Hrishikesh-Acharyya/Synchronous_buck_PMIC/tb/telemetry/host_if/coverage/summary.txt

cov_all: full suite + 5 random runs x 30 events - Tue Nov 10 11:58:13 UTC 2026
result: every test passed (cov_all stops at the first failure)
covers hit per checker:
  reg_file_sva: 28 of 28 covers hit, 0 at zero
  spi_slave_sva: 28 of 28 covers hit, 0 at zero
zero-hit covers:
  no zero-hit covers
functional coverage (covergroups):
  host_if.threshold.reason                   4 of 5   bins hit
  host_if.threshold.state                    4 of 4   bins hit
  host_if.threshold.reason_x_state           9 of 18  bins hit
  host_if.frame.ending                       8 of 9   bins hit
  host_if.clamp.register                     7 of 7   bins hit
  host_if.clamp.region                       5 of 5   bins hit
  host_if.clamp.register_x_region           28 of 35  bins hit
empty bins:
  host_if.threshold.reason: not_off
  host_if.threshold.reason_x_state: ('accepted', 2)
  host_if.threshold.reason_x_state: ('accepted', 3)
  host_if.threshold.reason_x_state: ('writeback', 1)
  host_if.threshold.reason_x_state: ('writeback', 2)
  host_if.threshold.reason_x_state: ('no_key', 3)
  host_if.threshold.reason_x_state: ('partial', 3)
  host_if.threshold.reason_x_state: ('not_off', 1)
  host_if.threshold.reason_x_state: ('not_off', 2)
  host_if.threshold.reason_x_state: ('not_off', 3)
  host_if.frame.ending: read_stall
  host_if.clamp.register_x_region: ('max_on_limit', 'below')
  host_if.clamp.register_x_region: ('max_on_limit', 'inside')
  host_if.clamp.register_x_region: ('hiccup_base', 'below')
  host_if.clamp.register_x_region: ('cycles_per_step', 'at_min')
  host_if.clamp.register_x_region: ('cycles_per_step', 'above')
  host_if.clamp.register_x_region: ('clean_run_target', 'below')
  host_if.clamp.register_x_region: ('clean_run_target', 'above')
