Hrishikesh-Acharyya/Synchronous_buck_PMIC/tb/telemetry/host_if/soak/summary.txt

  reg_file_sva: 26 of 28 covers hit, 2 at zero
  spi_slave_sva: 28 of 28 covers hit, 0 at zero
zero-hit covers:
  host_if_wrapper.u_reg_file.u_sva.c_arm_lapse  (reg_file_sva.sv:613)
  host_if_wrapper.u_reg_file.u_sva.c_bus_err_saturated  (reg_file_sva.sv:810)
functional coverage (covergroups):
  host_if.threshold.reason                   5 of 5   bins hit
  host_if.threshold.state                    4 of 4   bins hit
  host_if.threshold.reason_x_state          18 of 18  bins hit
  host_if.frame.ending                       9 of 9   bins hit
  host_if.clamp.register                     7 of 7   bins hit
  host_if.clamp.region                       5 of 5   bins hit
  host_if.clamp.register_x_region           35 of 35  bins hit
empty bins:
  no empty bins
