Hrishikesh-Acharyya/Synchronous_buck_PMIC/docs/silicluster_area.md

# Silicluster v3 area log

Append-only. One row per synthesis run that follows an RTL change. Never edit
an old row; the trend is the useful part.

## Method

- Input: `Build/pmic_full.v`, the sv2v output of `rtl/`, top `pmic_top`.
- Flops and mapped combinational cells: `make syn_area` (yosys `synth -flatten`,
  `dfflibmap` + `abc` against `sky130_fd_sc_hd__tt_025C_1v80.lib`), counted
  from the mapped `stat -liberty` table. "Comb cells" is every mapped sky130
  cell that is not a flop.
- **Cell area** is the yosys `Chip area` figure: the sum of standard-cell
  footprints. It is NOT die area.
- **Die area** = cell area / 0.57, a utilisation assumption of 57% carried over
  from the earlier estimate on `main`. Real P&R utilisation will differ.
- **Slot ratio** = die area / 20,700 um^2. The standard digital slot is
  180 um x 115 um = 20,700 um^2 (Silicluster v3 call, section 7).
- Tool: Yosys 0.70 (YoWASP build) unless stated. Yosys 0.33 (Ubuntu 24.04
  package, the version CI installs) was cross-checked on the baseline and gives
  the same 730 flops, 2,336 comb cells, 32,492 um^2.

## Runs

| Date (UTC) | Commit / changelog entry | Clock  | TELEMETRY_EN | Flops | Comb cells | Cell area (um^2) | Die @57% (um^2) | Ratio vs slot | Note |
|---|---|---|---|---|---|---|---|---|---|
| 2026-10-31 17:10 | a70e4a9 (main) | 50 MHz | (n/a, =1) | 730 | 2,281 | 32,369 | 56,787 | 2.74x | baseline, `main` as received |
| 2026-10-31 17:17 | chg 3: CLK_HZ 10 MHz | 10 MHz | (n/a, =1) | 700 | 2,137 | 30,821 | 54,072 | 2.61x | -30 flops from narrowed counters, as derived |
| 2026-10-31 17:19 | chg 5: ns_to_clks ceil | 10 MHz | (n/a, =1) | 700 | 2,132 | 30,845 | 54,113 | 2.61x | MIN_ON_COUNTS 2 -> 3; width unchanged |
| 2026-10-31 17:20 | chg 6: cycles/step 64 | 10 MHz | (n/a, =1) | 700 | 2,132 | 30,845 | 54,113 | 2.61x | reset value only; no area change |
| 2026-10-31 17:23 | chg 7: TELEMETRY_EN | 10 MHz | 1 | 700 | 2,127 | 30,808 | 54,050 | 2.61x | submission build |
| 2026-10-31 17:23 | chg 7: TELEMETRY_EN | 10 MHz | 0 | 252 | 705 | 10,523 | 18,461 | 0.89x | cost reference only |
| 2026-10-31 18:17 | chg 8: fix spi_slave oe  | 10 MHz | 1 | 700 | 2,116 | 30,837 | 54,100 | 2.61x | spi_slave 312 -> 328 cells, 3,363 -> 3,326 um^2; reg_file unchanged |
| 2026-10-31 18:19 | chg 9: fix spi_slave addr | 10 MHz | 1 | 700 | 2,130 | 30,827 | 54,083 | 2.61x | spi_slave 328 -> 308 cells, 3,326 -> 3,323 um^2; reg_file unchanged |
| 2026-10-31 18:38 | chg 11: fix reg_file clear | 10 MHz | 1 | 693 | 2,086 | 30,522 | 53,547 | 2.59x | addr_d removed (-7 flops); reg_file 1,093 -> 1,071 cells, spi_slave 308 -> 306 cells (+36 um^2) |
| 2026-10-31 18:42 | chg 12: sdio_oe aligned | 10 MHz | 1 | 693 | 2,113 | 30,644 | 53,762 | 2.60x | spi_slave 306 -> 307 cells, 3,360 -> 3,353 um^2; flattened +122 um^2 is ABC variation |
| 2026-10-31 20:01 | chg 17: SDIO -> MOSI/MISO | 10 MHz | 1 | 694 | 2,119 | 30,737 | 53,925 | 2.61x | +1 flop is sdio_oe, which yosys had dropped with the tri-state; spi_slave unchanged |

Commit hashes for each changelog entry are in the table at the end of
`docs/CHANGELOG_silicluster_v3.md`.

## Findings

- **2026-10-31, baseline differs from the reference in the project rules.** The rules
  quote 730 flops, 3,039 mapped combinational cells, ~43,000 um^2 cell area and
  ~75,500 um^2 die for `main`. Flops agree exactly. The mapped run here gives
  2,281 combinational cells and 32,369 um^2 cell area (Yosys 0.70), and 2,336 /
  32,492 um^2 with Yosys 0.33. 3,039 matches the GENERIC gate count in the
  committed `Build/stat.txt` (3,793 cells - 730 flops - 31 `$scopeinfo` =
  3,032), so the earlier figure most likely came from the unmapped netlist and
  overstates the area by roughly a third. All figures below are measured
  sky130 numbers.
- **2026-10-31, cost of telemetry, measured.** At 10 MHz, TELEMETRY_EN=1 vs 0:
  448 flops, 1,422 combinational cells and 20,285 um^2 of cell area (about
  35,600 um^2 of die at 57%). The rules' prior estimate was ~465 flops and
  2,174 cells; flops agree, the cell figure was again a generic count. Without
  telemetry the design fits the standard 20,700 um^2 slot (0.89x); with it,
  the submission needs about 2.6x the slot - an additional-area request of
  roughly 33,400 um^2 of die, almost all of it the host interface.
- **2026-10-31, what the die figure can and cannot say.** The 57% utilisation
  is an assumption carried over from `main`; the Silicluster call gives only
  the slot (180 um x 115 um) and leaves the check to the designer's own
  synthesis, place and route or estimate. Two statements need no assumption:
  the full build's cell area alone, 30,737 um^2, is 1.48x the slot, so it
  cannot fit one slot at any utilisation; the reduced build's cells fill 51%
  of the slot, so it fits only if the layout reaches at least 51% utilisation
  - or more, if the slot's usable core is smaller than its outline. Everything
  between is for place and route to settle; no P&R run has been made here.
- **2026-10-31, the reduced build is the verified fallback.** Since changelog
  entry 23 the integration testbench runs TELEMETRY_EN = 0 too (pins-only, on
  the default timers), so the 0.89x configuration is a tested submission
  option, not only a cost reference. Area unchanged: 252 flops, 705 comb cells,
  10,523 um^2.
- **2026-10-31, placed and routed.** OpenROAD (sky130_fd_sc_hd, typical
  corner) settles what the 57% assumption could not; flow and results in
  `pnr/`. The reduced build routes in the 180 x 115 um slot with no DRC
  violations at 66% utilisation, still with 10 um reserved all round (84%),
  and in a die as small as 180 x 90 um (0.78x the slot, 84%); 180 x 80 um does
  not route. The full build does not route at 2x the slot (90%), routes at 2.5x
  (180 x 288 um, 72%, only after 41 router passes) and comfortably at 3x
  (180 x 345 um, 61%). Excluding the don't-use lpflow cells the earlier syn_area
  runs had mapped (63 full, 21 reduced) changes cell area by under 0.2%.
