Hrishikesh-Acharyya/Synchronous_buck_PMIC/simulations/pictures/Figure1_Power_Stage_Plant.png

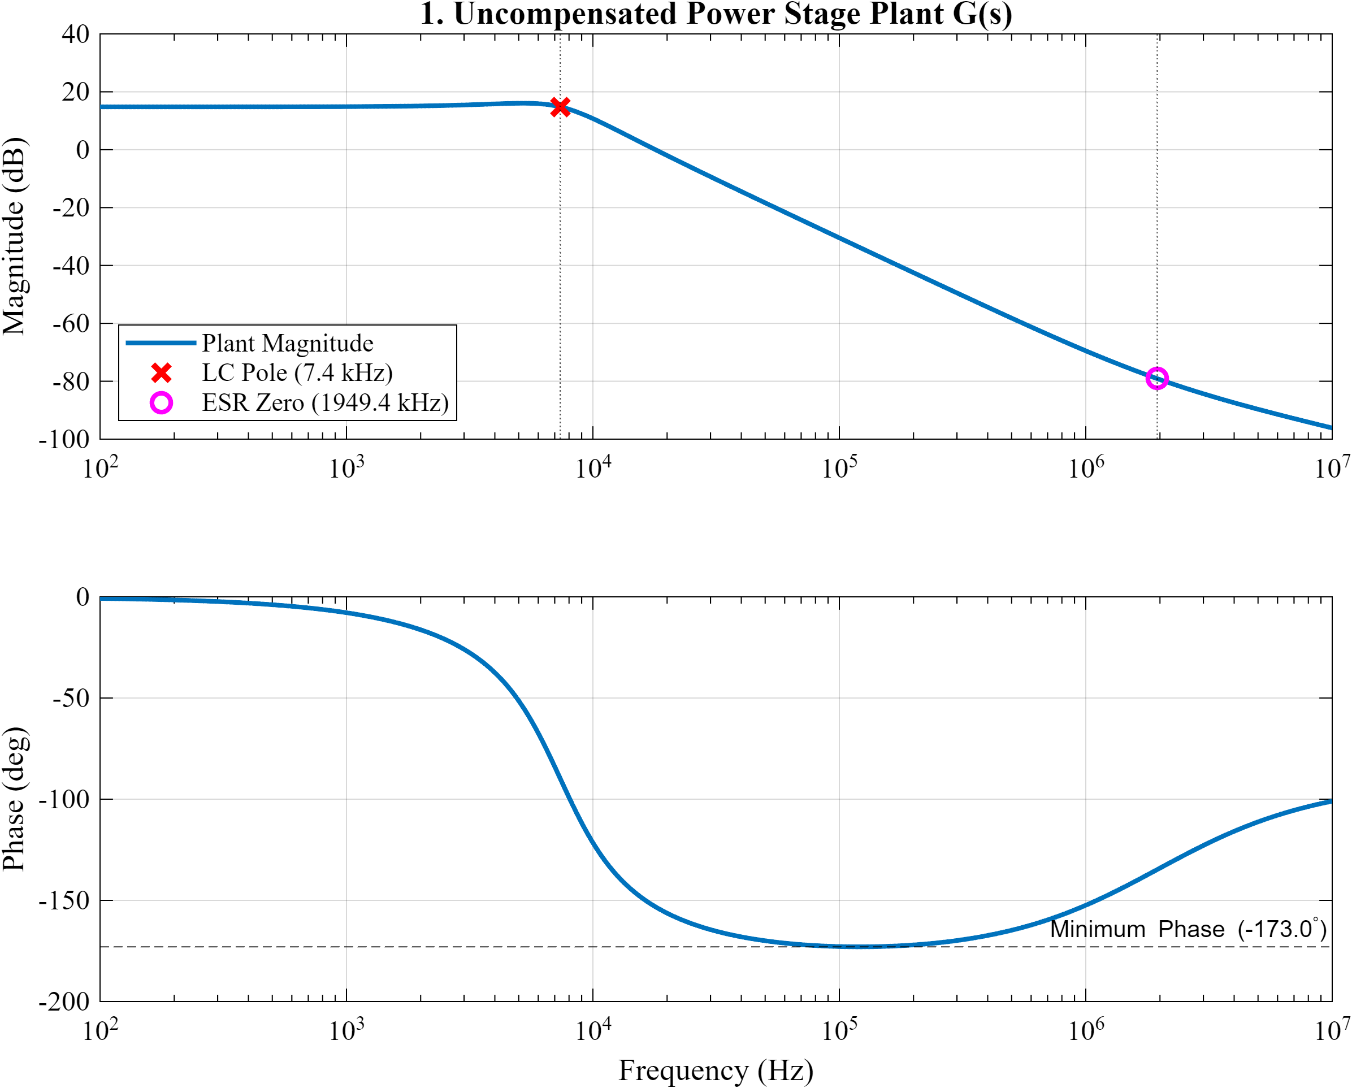
simulations/pictures/Figure1_Power_Stage_Plant.png
