Hrishikesh-Acharyya/Synchronous_buck_PMIC/simulations/pictures/Figure2_Type_III_Compensator.png

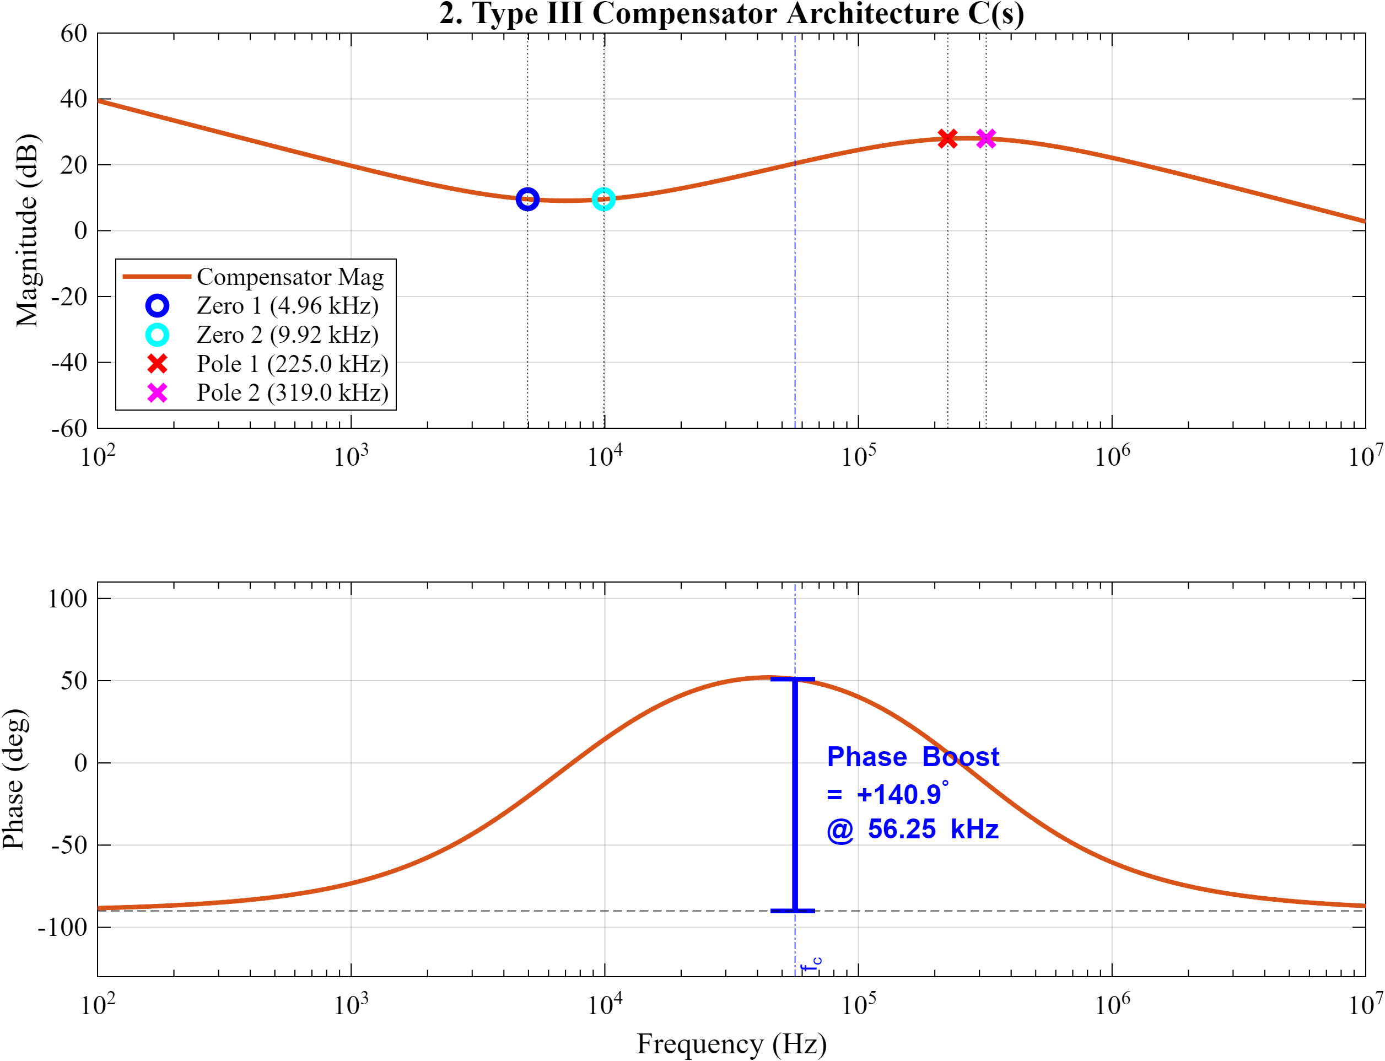
simulations/pictures/Figure2_Type_III_Compensator.png
