Hrishikesh-Acharyya/Synchronous_buck_PMIC/simulations/pictures/Figure3_Loop_Gain_Margins.png

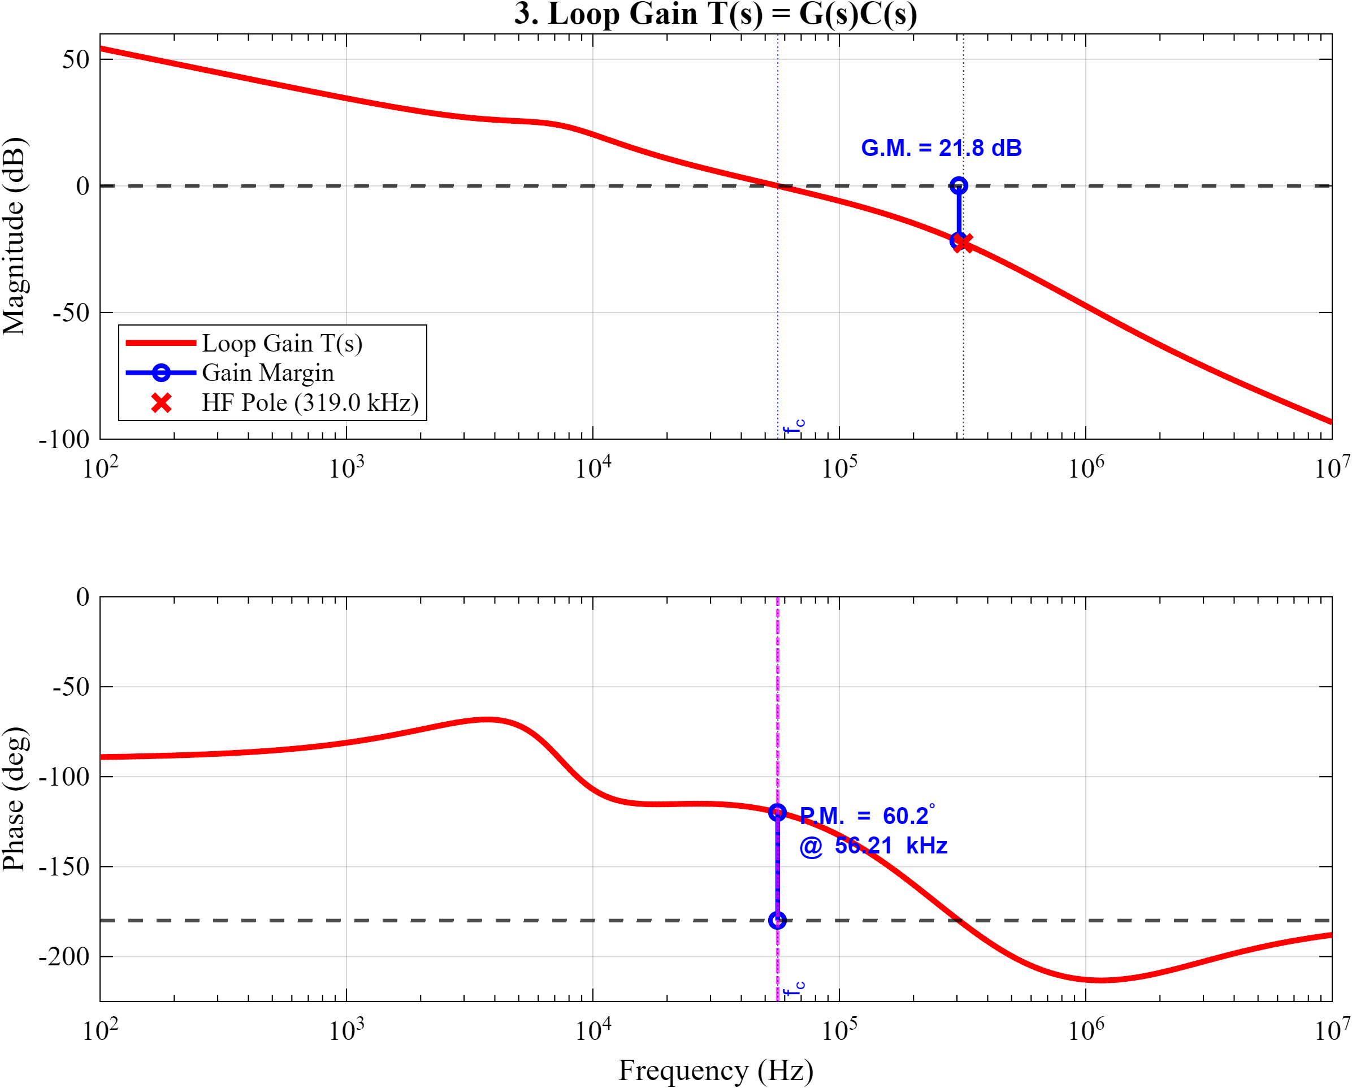
simulations/pictures/Figure3_Loop_Gain_Margins.png
