Hrishikesh-Acharyya/Synchronous_buck_PMIC/simulations/pictures/Figure4_System_Overlay.png

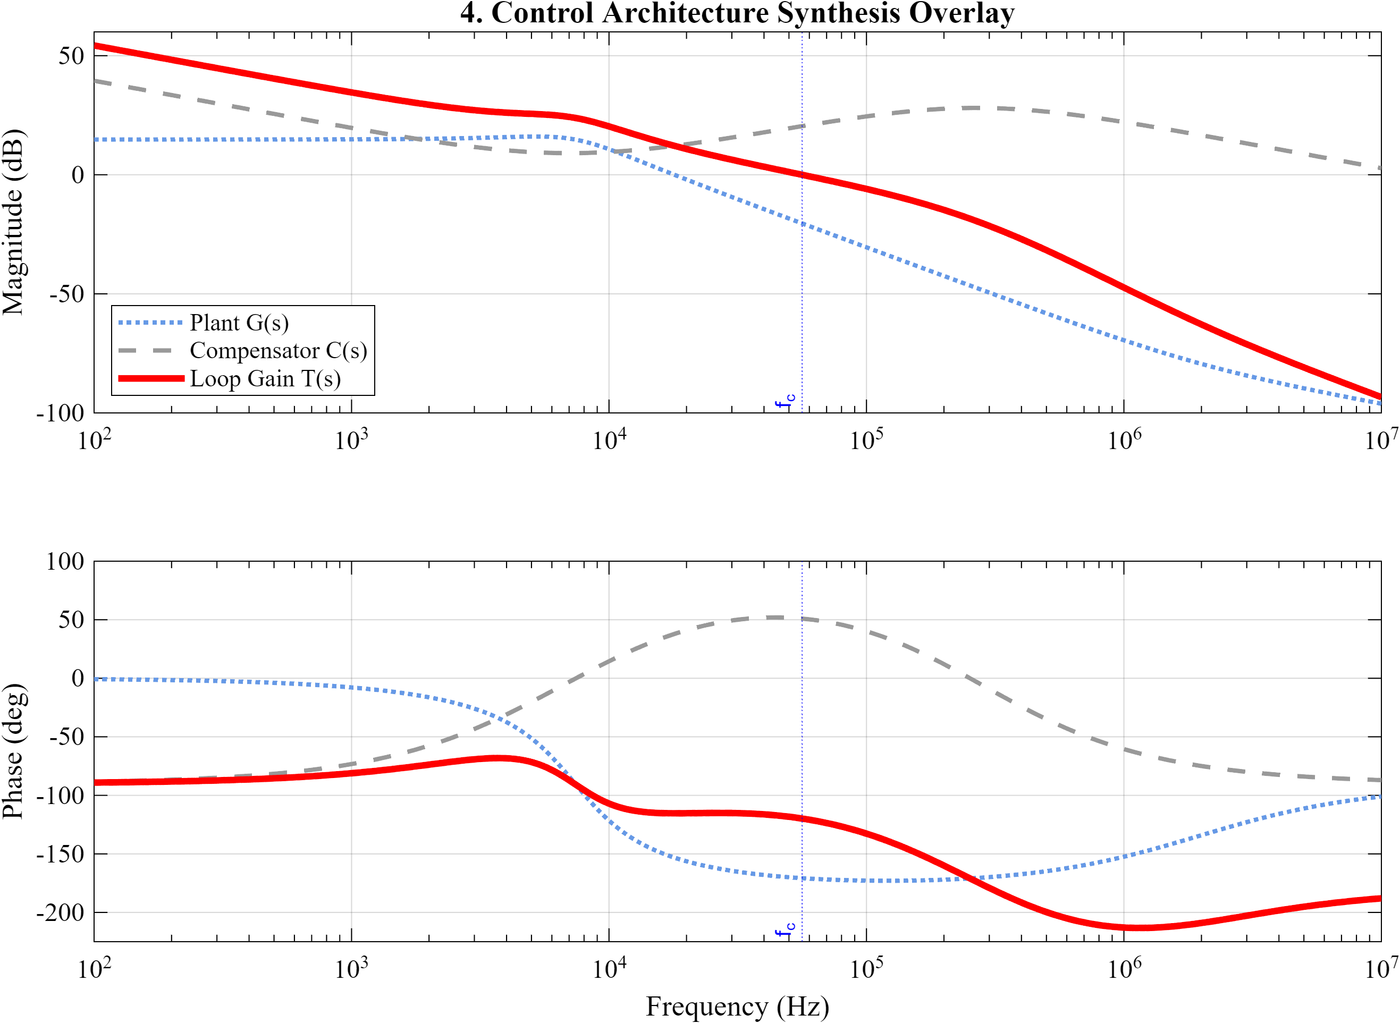
simulations/pictures/Figure4_System_Overlay.png
