Hrishikesh-Acharyya/Synchronous_buck_PMIC/simulations/pictures/Figure5_System_Transients.png

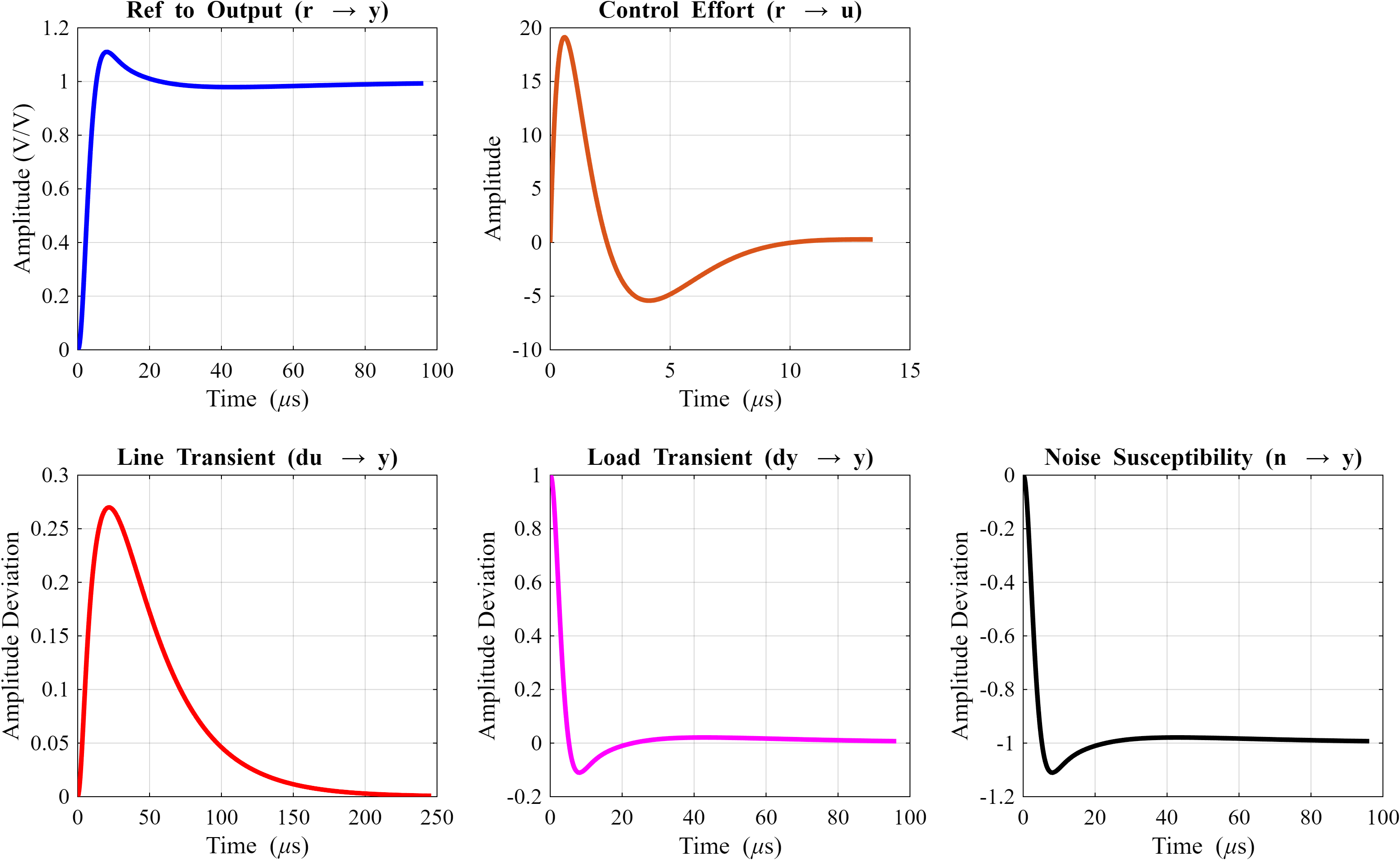
simulations/pictures/Figure5_System_Transients.png
