Hrishikesh-Acharyya/Synchronous_buck_PMIC/Mosfet_extraction_pipeline/excel_sheets/cleaned_mosfets.xlsx

Part_Number | Manufacturer | Package_Case | V_dss_Volts | Id_continuous_Amps | Logic_Level | Max_Vgs_Rating_Volts | Test_Vgs_Volts | Rds_on_max_mOhm | Qg_total_nC | Qgd_gate_drain_nC | Qgs_total_nC | Qgs1_pre_thresh_nC | Qgs2_post_thresh_nC | Qsw_switching_nC | Qg_Qsw_ratio | Vsd_body_diode_Volts | Datasheet_URL | Validation_Status
AM4874N | Analog Power | SO-8 | 30 | 16.8 | No |  | 4.5 | 12 | 15 | 7 | 5.6 |  |  | 9.8 | 1.530612245 | 0.74 | //mm.digikey.com/Volume0/opasdata/d220001/medias/docus/6133/AM4874N.pdf | PASS
AM4434N | Analog Power | SOIC-8 | 30 | 18.6 | Yes | 12 | 4.5 | 6 | 25 | 9 | 6 |  |  | 12 | 2.083333333 | 0.7 | //mm.digikey.com/Volume0/opasdata/d220001/medias/docus/6133/AM4434N.pdf | REJECT: Low Vgs (12.0V < 18V)
AM6612N | Analog Power | SO-8 | 30 | 9.7 | No |  | 4.5 | 30 | 4 | 1.9 | 1.3 |  |  | 2.55 | 1.56862745 | 0.82 | //mm.digikey.com/Volume0/opasdata/d220001/medias/docus/6167/AM6612N.pdf | PASS
AM4362N | Analog Power | SO-8 | 30 | 19 | No |  | 4.5 | 8 | 21 | 8.5 | 4.3 |  |  | 10.65 | 1.971830986 | 0.74 | //mm.digikey.com/Volume0/opasdata/d220001/medias/docus/6167/AM4362N.pdf | PASS
AM4840N | Analog Power | SO-8 | 40 | 9.7 | No |  | 4.5 | 27 | 10 | 3.3 | 3.5 |  |  | 5.05 | 1.98019802 | 0.78 | //mm.digikey.com/Volume0/opasdata/d220001/medias/docus/6167/AM4840N.pdf | PASS
AM4842N | Analog Power | SOIC-8 | 40 | 13.8 | No |  | 4.5 | 14 | 20 | 9.6 | 5.6 |  |  | 12.4 | 1.6129 | 0.74 | //mm.digikey.com/Volume0/opasdata/d220001/medias/docus/6167/AM4842N.pdf | PASS
AOD66406 | Alpha & Omega Semiconductor | TO-252 | 40 | 60 | Yes | 20 | 10 | 6.1 | 20 | 3 | 5.5 |  |  | 5.75 | 3.47826087 | 1 | https://aosmd.com/res/data_sheets/AOD66406.pdf | PASS
AOD454A | Alpha & Omega Semiconductor | TO-252 | 40 | 20 | No |  | 10 | 30 | 8.3 | 1.6 | 2.3 |  |  | 2.75 | 3.018181818 | 1 | https://aosmd.com/res/data_sheets/AOD454A.pdf | PASS
AOD4184A | Alpha & Omega Semiconductor | TO252 DPAK | 40 | 50 | No |  | 10 | 7 | 27 | 6 | 5 |  |  | 8.5 | 3.176 | 1 | https://aosmd.com/res/data_sheets/AOD4184A.pdf | PASS
ZXMN7A11K | Zetex Semiconductors | DPAK | 70 | 6.1 | No |  | 10 | 130 | 7.4 | 1.8 | 1.06 |  |  | 2.33 | 3.175965665 | 0.95 | https://www.diodes.com/assets/Datasheets/ZXMN7A11K.pdf | REJECT: Low Id (6.1A < 7.5A)
STD64N4F6AG | STMicroelectronics | DPAK | 40 | 54 | No |  | 10 | 8.2 | 44 | 12 | 15 |  |  | 19.5 | 2.256410256 | 1.3 | https://www.st.com/content/ccc/resource/technical/document/datasheet/2e/44/68/88/e2/a0/49/83/DM00185474.pdf/files/DM00185474.pdf/jcr:content/translations/en.D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 | PASS
DMTH43M8LK3Q | Diodes Incorporated | TO252 (DPAK) | 40 | 100 | No |  | 10 | 3.6 | 38.5 | 6.9 | 6.9 |  |  | 10.35 | 3.719806763 | 1.2 | https://www.diodes.com/datasheet/download/DMTH43M8LK3Q.pdf | PASS
STD44N4LF6 | STMicroelectronics | DPAK | 40 | 44 | Yes | 20 | 10 | 12.5 | 22 | 4.3 | 5 |  |  | 6.8 | 3.235 | 1.1 | //mm.digikey.com/Volume0/opasdata/d220001/medias/docus/8880/STD44N4LF6.pdf | PASS
SUD50N04-8m8P | Vishay Siliconix | TO-252 | 40 | 50 | No |  | 10 | 8.8 | 37 | 4.5 | 6.5 |  |  | 7.75 | 4.774193548 | 1.2 | https://www.vishay.com/docs/68647/sud50n04.pdf | PASS
STD95N4LF3 | STMicroelectronics | DPAK | 40 | 80 | Yes | 16 | 10 | 6 | 50 | 9.5 | 7 |  |  | 13 | 3.846153846 | 1.5 | https://www.st.com/content/ccc/resource/technical/document/datasheet/ae/64/8a/5d/98/75/42/80/CD00225038.pdf/files/CD00225038.pdf/jcr:content/translations/en.C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 | REJECT: Low Vgs (16.0V < 18V)
STD110N8F6 | STMicroelectronics | DPAK | 80 | 80 | No |  | 10 | 6.5 | 150 | 30 | 40 |  |  | 50 | 3 | 1.2 | https://www.st.com/content/ccc/resource/technical/document/datasheet/1d/ab/cc/48/cb/8b/4c/10/DM00151073.pdf/files/DM00151073.pdf/jcr:content/translations/en.D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 | PASS
STB120N4LF6 | STMicroelectronics | D²PAK | 40 | 80 | Yes | 20 | 10 | 4 | 80 | 15 | 15 |  |  | 22.5 | 3.56 | 1.1 | //mm.digikey.com/Volume0/opasdata/d220001/medias/docus/8880/STD120N4LF6.pdf | PASS
DMN4036LK3 | Diodes Incorporated | TO252-3L | 40 | 12.2 | No |  | 10 | 36 | 9.2 | 2.7 | 1.7 |  |  | 3.55 | 2.591549296 | 1.1 | https://www.diodes.com/assets/Datasheets/DMN4036LK3.pdf | PASS
DMN4026SK3 | Diodes Incorporated | TO252 | 40 | 28 | No |  | 10 | 24 | 21.3 | 3 | 3.7 |  |  | 4.85 | 4.39 | 1 | https://www.diodes.com/assets/Datasheets/DMN4026SK3.pdf | PASS
ZXMN6A08K | Diodes Incorporated | TO-252 | 60 | 7.9 | No |  | 10 | 80 | 5.8 | 1.9 | 1.4 |  |  | 2.6 | 2.230769231 | 0.95 | https://www.diodes.com/assets/Datasheets/ZXMN6A08K.pdf | PASS
DMTH4005SK3Q | Diodes Incorporated | TO252 (DPAK) | 40 | 95 | No |  | 10 | 4.5 | 49.1 | 13 | 10.3 |  |  | 18.15 | 2.71 | 0.9 | https://www.diodes.com/datasheet/download/DMTH4005SK3Q.pdf | PASS
DMT8012LK3 | Diodes Incorporated | TO252 (DPAK) | 80 | 44 | No |  | 10 | 17 | 34 | 4.5 | 6 |  |  | 7.5 | 4.533333333 | 1.2 | https://www.diodes.com/assets/Datasheets/DMT8012LK3.pdf | PASS
DMTH43M8LK3 | Diodes Incorporated | TO252 (DPAK) | 40 | 100 | No |  | 10 | 3.6 | 38.5 | 6.9 | 6.9 |  |  | 10.35 | 3.719806763 | 1.2 | https://www.diodes.com/assets/Datasheets/DMTH43M8LK3.pdf | PASS
ZXMN4A06K | Zetex Semiconductors | DPAK | 40 | 10.9 | No |  | 10 | 50 | 17.1 | 3.4 | 2.41 |  |  | 4.605 | 3.713355049 | 0.95 | https://www.diodes.com/assets/Datasheets/ZXMN4A06K.pdf | PASS
RD3G08CBKHRB | ROHM Semiconductor | TO-252 | 40 | 80 | No |  | 10 | 3.1 | 41 | 7.3 | 6.4 |  |  | 10.5 | 3.904761905 | 1.5 | https://fscdn.rohm.com/en/products/databook/datasheet/discrete/transistor/mosfet/rd3g08cbkhrbtl-e.pdf | PASS
RD3G07BBG | ROHM Semiconductor | TO-252 | 40 | 150 | No |  | 10 | 2.3 | 56 | 10 | 8.8 |  |  | 14.4 | 3.888888889 | 1.2 | https://fscdn.rohm.com/en/products/databook/datasheet/discrete/transistor/mosfet/rd3g07bbgtl1-e.pdf | PASS
DMN4030LK3 | Diodes Incorporated | TO252 (DPAK) | 40 | 9.6 | No |  | 10 | 30 | 12.9 | 3.6 | 2.3 |  |  | 4.75 | 2.715789474 | 1.1 | https://www.diodes.com/assets/Datasheets/DMN4030LK3.pdf | PASS
DMTH4007LK3Q | Diodes Incorporated | TO252 (DPAK) | 40 | 70 | No |  | 10 | 7.3 | 29.1 | 3.5 | 5.9 |  |  | 6.45 | 4.51 | 1.2 | https://www.diodes.com/datasheet/download/DMTH4007LK3Q.pdf | PASS
DMTH4007SK3 | Diodes Incorporated | TO252 (DPAK) | 40 | 76 | No |  | 10 | 6 | 41.9 | 11.5 | 10 |  |  | 16.5 | 2.539393939 | 1.2 | https://www.diodes.com/assets/Datasheets/DMTH4007SK3.pdf | PASS
DMNH4006SK3Q | Diodes Incorporated | TO252 (DPAK) | 40 | 140 | No |  | 10 | 6 | 51 | 20.4 | 9.6 |  |  | 25.2 | 2.0238 | 1.2 | https://www.diodes.com/datasheet/download/DMNH4006SK3Q.pdf | PASS
DI100N04D1 | Diotec Semiconductor | TO-252AA | 40 | 100 | No |  | 10 | 4 | 143 | 28 | 22 |  |  | 39 | 3.666666667 | 1.2 | https://diotec.com/request/datasheet/di100n04d1.pdf | PASS
SQD50N04-5m6 | Vishay Siliconix | TO-252 | 40 | 50 | No |  | 10 | 5.6 | 55 | 16 | 11 |  |  | 21.5 | 2.558139535 | 1.5 | https://www.vishay.com/docs/62666/sqd50n04-5m6.pdf | PASS
MCU90N04YHE3 | Micro Commercial Components | DPAK | 40 | 90 | No |  | 10 | 3.1 | 38 | 12.4 | 10.4 |  |  | 17.6 | 2.15909 | 1.2 | https://www.mccsemi.com/pdf/Products/MCU90N04YHE3(DPAK).pdf | PASS
STB95N4F3 | STMicroelectronics | D²PAK | 40 | 80 | No |  | 10 | 5.8 | 40 | 8 | 11 |  |  | 13.5 | 2.962962963 | 1.5 | https://www.st.com/content/ccc/resource/technical/document/datasheet/group2/d0/4e/c0/2b/36/f5/4e/06/CD00153132/files/CD00153132.pdf/jcr:content/translations/e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 | PASS
STD80N4F6 | STMicroelectronics | DPAK | 40 | 80 | No |  | 10 | 6 | 36 | 9 | 11 |  |  | 14.5 | 2.482758621 | 1.3 | //mm.digikey.com/Volume0/opasdata/d220001/medias/docus/8880/STD80N4F6.pdf | PASS
MCU2D8N04YHQ | Micro Commercial Components | DPAK(TO-252) | 40 | 160 | No |  | 10 | 2.8 | 42 | 9.4 | 15 |  |  | 16.9 | 2.4852 | 1.2 | https://www.mccsemi.com/pdf/Products/MCU2D8N04YHQ(DPAK).pdf | PASS
MCU7D2N04YHQ | Micro Commercial Components | DPAK(TO-252) | 40 | 60 | No |  | 10 | 7.2 | 13 | 2.9 | 4.6 |  |  | 5.2 | 2.5 | 1.2 | https://www.mccsemi.com/pdf/Products/MCU7D2N04YHQ(DPAK).pdf | PASS
MCU6D0N04YHQ | Micro Commercial Components | DPAK(TO-252) | 40 | 72 | No |  | 10 | 6 | 19 | 3.5 | 8.2 |  |  | 7.6 | 2.5 | 1.2 | https://www.mccsemi.com/pdf/Products/MCU6D0N04YHQ(DPAK).pdf | PASS
MCU3D6N04YQ | Micro Commercial Components | DPAK(TO-252) | 40 | 110 | No |  | 10 | 3.6 | 32.7 | 8.4 | 10 |  |  | 13.4 | 2.440298507 | 1.2 | https://www.mccsemi.com/pdf/Products/MCU3D6N04YQ(DPAK).pdf | PASS
DMTH4004LK3 | Diodes Incorporated | TO252 | 40 | 100 | No |  | 10 | 3 | 83 | 11.2 | 10 |  |  | 16.2 | 5.12 | 1.2 | https://www.diodes.com/assets/Datasheets/DMTH4004LK3.pdf | PASS
AG087FGD3HRB | ROHM | DPAK | 40 | 40 | No |  | 10 | 7 | 14.9 | 3 | 2.8 |  |  | 4.4 | 3.386363636 | 1.5 | https://fscdn.rohm.com/en/products/databook/datasheet/discrete/transistor/mosfet/ag087fgd3hrbtl-e.pdf | PASS
RD3G08DBLHRB | ROHM Semiconductor | TO-252 | 40 | 80 | No |  | 10 | 4.2 | 28 | 5.4 | 7.1 |  |  | 8.95 | 3.1285 | 1.5 | https://fscdn.rohm.com/en/products/databook/datasheet/discrete/transistor/mosfet/rd3g08dblhrbtl-e.pdf | PASS
MCU2D5N04YH | Micro Commercial Components | DPAK(TO-252) | 40 | 130 | No |  | 10 | 2.5 | 57 | 5.7 | 27 |  |  | 19.2 | 2.96875 | 1.2 | https://www.mccsemi.com/pdf/Products/MCU2D5N04YH(DPAK).pdf | PASS
AG086FGD3HRB | ROHM | TO-252 | 40 | 80 | No |  | 10 | 4.1 | 28 | 5.4 | 4.6 |  |  | 7.7 | 3.636363636 | 1.5 | https://fscdn.rohm.com/en/products/databook/datasheet/discrete/transistor/mosfet/ag086fgd3hrbtl-e.pdf | PASS
MCU2D5N04YHQ | Micro Commercial Components | DPAK(TO-252) | 40 | 130 | No |  | 10 | 2.5 | 57 | 5.7 | 27 |  |  | 19.2 | 2.96875 | 1.2 | https://www.mccsemi.com/pdf/Products/MCU2D5N04YHQ(DPAK).pdf | PASS
MCU3D8N04YHQ | Micro Commercial Components | DPAK(TO-252) | 40 | 100 | No |  | 10 | 3.8 | 23 | 3 | 7.5 |  |  | 6.75 | 3.407407407 | 1.2 | https://www.mccsemi.com/pdf/Products/MCU3D8N04YHQ(DPAK).pdf | PASS
AG185FGD3HRB | ROHM | TO-252 | 40 | 80 | No |  | 10 | 3.2 | 42 | 8 | 10.7 |  |  | 13.35 | 3.146 | 1.5 | https://fscdn.rohm.com/en/products/databook/datasheet/discrete/transistor/mosfet/ag185fgd3hrbtl-e.pdf | PASS
MCU110N08Y | Micro Commercial Components | DPAK(TO-252) | 80 | 110 | No |  | 10 | 5.6 | 88 | 19 | 21 |  |  | 29.5 | 2.983050847 | 1.2 | https://www.mccsemi.com/pdf/Products/MCU110N08Y(DPAK).pdf | PASS
RD3G08BBLHRB | ROHM Semiconductor | TO-252 | 40 | 80 | No |  | 10 | 2.3 | 82 | 15.7 | 22 |  |  | 26.7 | 3.07 | 1.5 | https://fscdn.rohm.com/en/products/databook/datasheet/discrete/transistor/mosfet/rd3g08bblhrbtl-e.pdf | PASS
GSFD0460 | GOOD-ARK SEMICONDUCTOR | TO-252 (DPAK) | 40 | 60 | No |  | 4.5 | 8.8 | 16.2 | 6.05 | 3.85 |  |  | 7.975 | 2.03 | 1 | https://goodarksemi.com/docs/datasheets/mosfets/GSFD0460.pdf | PASS
G160N04K | GOFORD | TO-252 | 40 | 25 | No |  | 10 | 15 | 20 | 3.1 | 3.8 |  |  | 5 | 4 | 1.2 | https://www.gofordsemi.com/upload/cn/propdf/G160N04K.pdf | PASS
GSFD4003 | GOOD-ARK SEMICONDUCTOR | TO-252 (DPAK) | 40 | 240 | No |  | 10 | 3 | 108 | 30 | 34 |  |  | 47 | 2.29787234 | 1.2 | https://goodarksemi.com/docs/datasheets/mosfets/GSFD4003.pdf | PASS
G60N04K | GOFORD | TO-252 | 40 | 60 | No |  | 10 | 7 | 42 | 9 | 7 |  |  | 12.5 | 3.36 | 1.2 | https://www.gofordsemi.com/upload/cn/propdf/G60N04K.pdf | PASS
UMW IRFR7440TR | UMW | TO-252(DPAK) | 40 | 90 | No |  | 10 | 2.4 | 89 | 26 | 26 |  |  | 39 | 2.28 | 1.3 | https://www.umw-ic.com/static/pdf/088030c3b73bfce81e8e16fc94c9098b.pdf | PASS
GT060N04K | GOFORD | TO-252 | 40 | 62 | No |  | 10 | 8 | 25 | 6 | 9 |  |  | 10.5 | 2.380952381 | 1.2 | https://www.gofordsemi.com/upload/cn/propdf/GT060N04K.pdf | PASS
SQD40052EL | Vishay Siliconix | TO-252 | 40 | 30 | No |  | 10 | 6 | 34.5 | 6.6 | 6.1 |  |  | 9.65 | 3.58 | 1.5 | https://www.vishay.com/docs/77607/sqd40052el.pdf | PASS
VDR04N028LSA | Viitor Semiconductor | TO-252 | 40 | 117 | No |  | 10 | 2.8 | 46 | 6.6 | 9.5 |  |  | 11.35 | 4.05 | 1.3 | https://viitorsemi.com/wp-content/uploads/VDR04N028LSA_datasheet.pdf | PASS
GSFD4010 | Good-Ark Semiconductor | TO-252 (DPAK) | 40 | 60 | No |  | 4.5 | 14 | 16.2 | 6.05 | 3.85 |  |  | 7.975 | 2.0313 | 1 | https://goodarksemi.com/docs/datasheets/mosfets/GSFD4010.pdf | PASS
VDR10N170LSA | Viitor Semiconductor | TO-252 | 100 | 44 | No |  | 10 | 17 | 22 | 6 | 3 |  |  | 7.5 | 2.93 | 1 | https://viitorsemi.com/wp-content/uploads/VDR10N170LSA_datasheet.pdf | PASS
VTR04N070LSA | Viitor Semiconductor | TO-252 | 40 | 72 | No |  | 10 | 7 | 72 | 13 | 11 |  |  | 18.5 | 3.89189 | 1.2 | https://viitorsemi.com/wp-content/uploads/VTR04N070LSA_datasheet.pdf | PASS
DMTH8012LK3Q | Diodes Incorporated | TO252 (DPAK) | 80 | 50 | No |  | 10 | 16 | 46.8 | 12.2 | 6.9 |  |  | 15.65 | 2.990415335 | 1.2 | https://www.diodes.com/datasheet/download/DMTH8012LK3Q.pdf | PASS
DMTH8012LK3 | Diodes Incorporated | TO252 | 80 | 50 | No |  | 10 | 16 | 34 | 4.5 | 6 |  |  | 7.5 | 4.533333333 | 1.2 | https://www.diodes.com/assets/Datasheets/DMTH8012LK3.pdf | PASS
DMTH4007LK3 | Diodes Incorporated | TO252 | 40 | 70 | No |  | 10 | 7.3 | 29.1 | 3.5 | 5.9 |  |  | 6.45 | 4.5116 | 1.2 | https://www.diodes.com/assets/Datasheets/DMTH4007LK3.pdf | PASS
DMTH4004LK3Q | Diodes Incorporated | TO252 (DPAK) | 40 | 100 | No |  | 10 | 3 | 83 | 11.2 | 10 |  |  | 16.2 | 5.12345679 | 1.2 | https://www.diodes.com/datasheet/download/DMTH4004LK3Q.pdf | PASS
STD134N4F7AG | STMicroelectronics | DPAK | 40 | 80 | No |  | 10 | 3.5 | 41 | 11 | 15 |  |  | 18.5 | 2.216216 | 1.2 | https://www.st.com/content/ccc/resource/technical/document/datasheet/group3/50/75/04/92/24/b2/49/b2/DM00347434/files/DM00347434.pdf/jcr:content/translations/e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 | PASS
SQD100N04-3m6 | Vishay Siliconix | TO-252 | 40 | 100 | No |  | 10 | 3.6 | 70 | 13 | 16 |  |  | 21 | 3.333333333 | 1.5 | https://www.vishay.com/docs/63836/sqd100n04-3m6.pdf | PASS
SQR40020ER | Vishay Siliconix | TO-252 Reverse Lead DPAK | 40 | 100 | No |  | 10 | 2.33 | 84 | 19.5 | 29.5 |  |  | 34.25 | 2.45255 | 1.5 | https://www.vishay.com/docs/76927/sqr40020er.pdf | PASS
DMTH47M2SK3 | Diodes Incorporated | TO252 (DPAK) | 40 | 62 | No |  | 10 | 7.5 | 12.1 | 1.9 | 2 |  |  | 2.9 | 4.17 | 1.2 | https://www.diodes.com/assets/Datasheets/DMTH47M2SK3.pdf | PASS
AOD4186 | Alpha & Omega Semiconductor | TO-252 D-PAK | 40 | 35 | No |  | 10 | 15 | 17 | 4.5 | 2.5 |  |  | 5.75 | 2.956521739 | 1 | https://aosmd.com/res/data_sheets/AOD4186.pdf | PASS
MCU40N04HE3 | Micro Commercial Components | DPAK(TO-252) | 40 | 40 | No |  | 10 | 13 | 23 | 6 | 3.5 |  |  | 7.75 | 2.967741935 | 1.2 | https://www.mccsemi.com/pdf/Products/MCU40N04HE3(DPAK).pdf | PASS
MCU90N04Y | Micro Commercial Components | DPAK | 40 | 90 | No |  | 10 | 3.1 | 38 | 12.4 | 10.4 |  |  | 17.6 | 2.159090909 | 1.2 | https://www.mccsemi.com/pdf/Products/MCU90N04Y(DPAK).pdf | PASS
DMN4030LK3Q | Diodes Incorporated | TO252 (DPAK) | 40 | 9.6 | No |  | 10 | 30 | 12.9 | 3.6 | 2.3 |  |  | 4.75 | 2.715789474 | 1.1 | https://www.diodes.com/datasheet/download/DMN4030LK3Q.pdf | PASS
DMTH4005SK3 | Diodes Incorporated | TO252 (DPAK) | 40 | 95 | No |  | 10 | 4.5 | 49.1 | 13 | 10.3 |  |  | 18.15 | 2.70523416 | 0.9 | https://www.diodes.com/assets/Datasheets/DMTH4005SK3.pdf | PASS
AOD2816 | Alpha & Omega Semiconductor | DPAK | 80 | 35 | No |  | 10 | 15 | 14.5 | 3.2 | 4.5 |  |  | 5.45 | 2.660550459 | 1 | https://aosmd.com/res/data_sheets/AOD2816.pdf | PASS
STD55N4F5 | STMicroelectronics | DPAK | 40 | 55 | No |  | 10 | 8.5 | 25 | 6 | 7 |  |  | 9.5 | 2.631578947 | 1.5 | //mm.digikey.com/Volume0/opasdata/d220001/medias/docus/416/STD55N4F5.pdf | PASS
DMNH4011SK3Q | Diodes Incorporated | TO252 | 40 | 50 | No |  | 10 | 10 | 25.5 | 6.9 | 4.6 |  |  | 9.2 | 2.77173913 | 1.2 | https://www.diodes.com/datasheet/download/DMNH4011SK3Q.pdf | PASS
AOD2810 | Alpha & Omega Semiconductor | TO252 DPAK | 80 | 46 | No |  | 10 | 8.5 | 26.5 | 4 | 8.5 |  |  | 8.25 | 3.212121212 | 1 | https://aosmd.com/res/data_sheets/AOD2810.pdf | PASS
DMT8008LK3 | Diodes Incorporated | TO252 (DPAK) | 80 | 95 | No |  | 10 | 7 | 41.2 | 10.6 | 5 |  |  | 13.1 | 3.145038168 | 1.2 | https://www.diodes.com/assets/Datasheets/DMT8008LK3.pdf | PASS
DMT8008SK3 | Diodes Incorporated | TO252 (DPAK) | 80 | 90 | No |  | 10 | 7.8 | 34 | 12 | 6 |  |  | 15 | 2.27 | 1.2 | https://www.diodes.com/assets/Datasheets/DMT8008SK3.pdf | PASS
MCU120N04 | Micro Commercial Components | DPAK(TO-252) | 40 | 120 | No |  | 10 | 3.5 | 92.7 | 21.4 | 11.6 |  |  | 27.2 | 3.408088235 | 1.2 | https://www.mccsemi.com/pdf/Products/MCU120N04(DPAK).pdf | PASS
DI100N04D1 | Diotec Semiconductor | TO-252AA | 40 | 100 | No |  | 10 | 4 | 143 | 28 | 22 |  |  | 39 | 3.666666667 | 1.2 | https://diotec.com/request/datasheet/di100n04d1.pdf | PASS
VN5160S-E | STMicroelectronics | SO-8 | 41 | 5.4 | Yes |  | 13 | 160 | 0 | 0 |  |  |  | 0 | 0 | 0.7 | https://www.st.com/resource/en/datasheet/vn5160s-e.pdf | REJECT: Low Id (5.4A < 7.5A)
SQD50N04-4m5L | Vishay Siliconix | TO-252 | 40 | 50 | No |  | 10 | 3.5 | 85 | 14 | 14 |  |  | 21 | 4.047619048 | 1.5 | https://www.vishay.com/docs/70623/sqd50n04.pdf | PASS
SQD100N04-3m6 | Vishay Siliconix | TO-252 | 40 | 100 | No |  | 10 | 3.6 | 70 | 13 | 16 |  |  | 21 | 3.333333333 | 1.5 | https://www.vishay.com/docs/63836/sqd100n04-3m6.pdf | PASS
DMNH4006SK3 | Diodes Incorporated | TO252 (DPAK) | 40 | 140 | No |  | 10 | 6 | 51 | 20.4 | 9.6 |  |  | 25.2 | 2.023809524 | 1.2 | https://www.diodes.com/assets/Datasheets/DMNH4006SK3.pdf | PASS
AOD2146 | Alpha & Omega Semiconductor | TO-252 | 40 | 54 | No |  | 10 | 3.1 | 50 | 3 | 13.5 |  |  | 9.75 | 5.128 | 1 | https://aosmd.com/res/data_sheets/AOD2146.pdf | PASS
FDD8444L | Fairchild Semiconductor | TO-252AA | 40 | 50 | No |  | 5 | 6 | 46 | 21 | 16.3 | 5.4 | 10.9 | 31.9 | 1.44 | 1.25 | //mm.digikey.com/Volume0/opasdata/d220001/medias/docus/883/FDD8444L.pdf | PASS
AOD2144 | Alpha & Omega Semiconductor | TO-252 | 40 | 120 | No |  | 10 | 2.3 | 68 | 4.5 | 16.5 |  |  | 12.75 | 5.33 | 1 | https://aosmd.com/res/data_sheets/AOD2144.pdf | PASS
DMTH4004SK3 | Diodes Incorporated | TO252 | 40 | 100 | No |  | 10 | 3.2 | 68.6 | 14.2 | 16.8 |  |  | 22.6 | 3.0354 | 1.2 | https://www.diodes.com/assets/Datasheets/DMTH4004SK3.pdf | PASS
STB120N4F6 | STMicroelectronics | D²PAK | 40 | 80 | No |  | 10 | 4 | 65 | 16 | 20 |  |  | 26 | 2.5 | 1.1 | //mm.digikey.com/Volume0/opasdata/d220001/medias/docus/8880/STD120N4F6.pdf | PASS
SQD50N04-5m6 | Vishay Siliconix | TO-252 | 40 | 50 | No |  | 10 | 5.6 | 55 | 16 | 11 |  |  | 21.5 | 2.558139535 | 1.5 | https://www.vishay.com/docs/62666/sqd50n04-5m6.pdf | PASS
STD90N4F3 | STMicroelectronics | DPAK | 40 | 80 | No |  | 10 | 5.8 | 40 | 8 | 11 |  |  | 13.5 | 2.962962963 | 1.5 | https://www.st.com/content/ccc/resource/technical/document/datasheet/bb/f2/7c/b0/dc/57/49/0d/CD00177924.pdf/files/CD00177924.pdf/jcr:content/translations/en.C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 | PASS
DMTH4004SK3Q | Diodes Incorporated | TO252 (DPAK) | 40 | 100 | No |  | 10 | 3.2 | 68.6 | 14.2 | 16.8 |  |  | 22.6 | 3.04 | 1.2 | https://www.diodes.com/datasheet/download/DMTH4004SK3Q.pdf | PASS
STD170N4F7AG | STMicroelectronics | DPAK | 40 | 80 | No |  | 10 | 2.8 | 63 | 18 | 23 |  |  | 29.5 | 2.13559322 | 1.2 | https://www.st.com/content/ccc/resource/technical/document/datasheet/group3/ca/b2/80/fc/c0/77/4f/e2/DM00347907/files/DM00347907.pdf/jcr:content/translations/e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 | PASS
AUIRLS3114Z | Infineon | D2-Pak | 40 | 122 | Yes | 16 | 10 | 4.9 | 35 | 16 | 11 |  |  | 21.5 | 1.627906977 | 1.3 | //mm.digikey.com/Volume0/opasdata/d220001/medias/docus/411/AUIRLS3114Z.pdf | REJECT: Low Vgs (16.0V < 18V)
MCU60N04 | Micro Commercial Components | DPAK | 40 | 60 | No |  | 10 | 13 | 29 | 6.4 | 4.5 |  |  | 8.65 | 3.352601156 | 1.2 | https://www.mccsemi.com/pdf/Products/MCU60N04(DPAK).pdf | PASS
SUD50N04-8m8P | Vishay Siliconix | TO-252 | 40 | 50 | No |  | 10 | 8.8 | 37 | 4.5 | 6.5 |  |  | 7.75 | 4.77 | 1.2 | https://www.vishay.com/docs/68647/sud50n04.pdf | PASS
SQD100N04-3m6L | Vishay Siliconix | TO-252 | 40 | 100 | No |  | 10 | 3.6 | 85 | 14 | 14 |  |  | 21 | 4.047619048 | 1.5 | https://www.vishay.com/docs/63837/sqd100n04-3m6l.pdf | PASS
SQR50N04-3m8 | Vishay Siliconix | TO-252 Reverse Lead DPAK | 40 | 50 | No |  | 10 | 3.8 | 70 | 13 | 16 |  |  | 21 | 3.333333333 | 1.5 | https://www.vishay.com/docs/62783/sqr50n04-3m8.pdf | PASS
SQD40020EL | Vishay Siliconix | TO-252 | 40 | 100 | No |  | 10 | 2.2 | 108 | 20 | 23.3 |  |  | 31.65 | 3.412322275 | 1.5 | https://www.vishay.com/docs/76897/sqd40020el.pdf | PASS
BUK7Y3R5-40E | Nexperia | LFPAK56 | 40 | 100 | No |  | 10 | 3.5 | 49.4 | 16.2 | 13.5 |  |  | 22.95 | 2.1525 | 1.2 | https://assets.nexperia.com/documents/data-sheet/BUK7Y3R5-40E.pdf | PASS
PSMN8R2-80YS | Nexperia | LFPAK | 80 | 82 | No |  | 10 | 8.5 | 55 | 12 | 15 | 10 | 5 | 17 | 3.235294118 | 1.2 | https://assets.nexperia.com/documents/data-sheet/PSMN8R2-80YS.pdf | PASS
PSMN1R4-40YLD | Nexperia | LFPAK56 | 40 | 240 | Yes | 20 | 10 | 1.4 | 96 | 13 | 15 | 9 | 6 | 19 | 5.0526 | 1.2 | https://assets.nexperia.com/documents/data-sheet/PSMN1R4-40YLD.pdf | PASS
PSMN1R8-40YLC | Nexperia | LFPAK; Power-SO8 (SOT669) | 40 | 100 | Yes | 20 | 10 | 1.8 | 96 | 10.9 | 15.5 | 8.4 | 7.1 | 18 | 5.33 | 1.1 | https://assets.nexperia.com/documents/data-sheet/PSMN1R8-40YLC.pdf | PASS
PSMN1R0-40YLD | Nexperia | LFPAK56 | 40 | 280 | Yes | 20 | 10 | 1.1 | 127 | 17 | 19 | 12 | 8 | 25 | 5.08 | 1.2 | https://assets.nexperia.com/documents/data-sheet/PSMN1R0-40YLD.pdf | PASS
BUK9Y29-40E | Nexperia | LFPAK56 | 40 | 25 | Yes | 15 | 5 | 29 | 5 | 1.9 | 1.1 |  |  | 2.45 | 2.04 | 1.2 | https://assets.nexperia.com/documents/data-sheet/BUK9Y29-40E.pdf | REJECT: Low Vgs (15.0V < 18V)
BUK9K25-40E | Nexperia | LFPAK56D | 40 | 18.2 | Yes | 15 | 5 | 29 | 6.3 | 2.4 | 1.4 |  |  | 3.1 | 2.03 | 1.2 | https://assets.nexperia.com/documents/data-sheet/BUK9K25-40E.pdf | REJECT: Low Vgs (15.0V < 18V)
PSMN045-80YS | Nexperia | LFPAK | 80 | 24 | No |  | 10 | 45 | 12.5 | 3.1 | 3.8 | 1.9 | 1.9 | 5 | 2.5 | 1.2 | https://assets.nexperia.com/documents/data-sheet/PSMN045-80YS.pdf | PASS
PSMN014-40YS | Nexperia | LFPAK | 40 | 46 | No |  | 10 | 14 | 12 | 2.4 | 5.4 | 2.2 | 3.2 | 5.6 | 2.142857 | 1.2 | https://assets.nexperia.com/documents/data-sheet/PSMN014-40YS.pdf | PASS
BUK7K18-40E | Nexperia | LFPAK56D | 40 | 24.2 | No |  | 10 | 19 | 11.8 | 4.3 | 3.6 |  |  | 6.1 | 1.93442623 | 1.2 | https://assets.nexperia.com/documents/data-sheet/BUK7K18-40E.pdf | PASS
BUK9Y14-40B | Nexperia | LFPAK | 40 | 56 | Yes | 15 | 5 | 14 | 21 | 9 | 3.7 |  |  | 10.85 | 1.93548387 | 1.2 | https://assets.nexperia.com/documents/data-sheet/BUK9Y14-40B.pdf | REJECT: Low Vgs (15.0V < 18V)
BUK9K8R7-40E | Nexperia | LFPAK56D | 40 | 30 | Yes | 15 | 5 | 9.4 | 15.7 | 5.3 | 3.2 |  |  | 6.9 | 2.275362319 | 1.2 | https://assets.nexperia.com/documents/data-sheet/BUK9K8R7-40E.pdf | REJECT: Low Vgs (15.0V < 18V)
PSMN013-80YS | Nexperia | LFPAK | 80 | 60 | No |  | 10 | 12.9 | 37 | 8 | 11 | 7 | 4 | 12 | 3.0833 | 1.2 | https://assets.nexperia.com/documents/data-sheet/PSMN013-80YS.pdf | PASS
PSMN2R8-40YSD | Nexperia | LFPAK56 | 40 | 160 | No |  | 10 | 2.8 | 44 | 7 | 13 | 8.8 | 4.2 | 11.2 | 3.928571429 | 1 | https://assets.nexperia.com/documents/data-sheet/PSMN2R8-40YSD.pdf | PASS
BUK7K6R2-40E | Nexperia | LFPAK56D | 40 | 40 | No |  | 10 | 5.8 | 32.3 | 10.5 | 7.2 |  |  | 14.1 | 2.29 | 1.2 | https://assets.nexperia.com/documents/data-sheet/BUK7K6R2-40E.pdf | PASS
BUK9Y3R0-40E | Nexperia | LFPAK56 | 40 | 100 | Yes | 15 | 5 | 3 | 35.5 | 10.7 | 11.7 |  |  | 16.55 | 2.145 | 1.2 | https://assets.nexperia.com/documents/data-sheet/BUK9Y3R0-40E.pdf | REJECT: Low Vgs (15.0V < 18V)
BUK7Y1R7-40H | Nexperia | LFPAK56 | 40 | 120 | No |  | 10 | 1.7 | 56 | 10 | 16 |  |  | 18 | 3.111 | 1.2 | https://assets.nexperia.com/documents/data-sheet/BUK7Y1R7-40H.pdf | PASS
BUK7V4R2-40H | Nexperia | LFPAK56D | 40 | 98 | No |  | 10 | 4.2 | 26 | 4.7 | 7.8 |  |  | 8.6 | 3.02 | 1 | https://assets.nexperia.com/documents/data-sheet/BUK7V4R2-40H.pdf | PASS
PSMN4R2-40VSH | Nexperia | LFPAK56D | 40 | 98 | No |  | 10 | 4.2 | 26 | 4.7 | 7.8 | 5.1 | 2.7 | 7.4 | 3.51 | 1 | https://assets.nexperia.com/documents/data-sheet/PSMN4R2-40VSH.pdf | PASS
BUK7Y1R0-40N | Nexperia | LFPAK56 | 40 | 320 | No |  | 10 | 0.97 | 135 | 42 | 26 |  |  | 55 | 2.454545455 | 1 | https://assets.nexperia.com/documents/data-sheet/BUK7Y1R0-40N.pdf | PASS
BUK7Y3R1-80M | Nexperia | LFPAK56 | 80 | 160 | No |  | 10 | 3.1 | 70 | 14 | 20 |  |  | 24 | 2.916666667 | 1 | https://assets.nexperia.com/documents/data-sheet/BUK7Y3R1-80M.pdf | PASS
PSMN3R5-80YSF | Nexperia | LFPAK56E | 80 | 150 | No |  | 10 | 3.5 | 75 | 13.1 | 22.5 | 15 | 7.6 | 20.7 | 3.623188406 | 1 | https://assets.nexperia.com/documents/data-sheet/PSMN3R5-80YSF.pdf | PASS
PSMNR90-40YLH | Nexperia | LFPAK56E | 40 | 300 | Yes | 20 | 10 | 0.94 | 120 | 13 | 20 | 12 | 8 | 21 | 5.714285714 | 1.2 | https://assets.nexperia.com/documents/data-sheet/PSMNR90-40YLH.pdf | PASS
BUK7Y21-40E | Nexperia | LFPAK56 | 40 | 33 | No |  | 10 | 21 | 10 | 3 | 2 |  |  | 4 | 2.5 | 1.2 | https://assets.nexperia.com/documents/data-sheet/BUK7Y21-40E.pdf | PASS
BUK9Y12-40E | Nexperia | LFPAK56 | 40 | 52 | Yes | 10 | 5 | 12 | 9.8 | 3.4 | 3.2 |  |  | 5 | 1.96 | 1.2 | https://assets.nexperia.com/documents/data-sheet/BUK9Y12-40E.pdf | REJECT: Low Vgs (10.0V < 18V)
BUK9Y21-40E | Nexperia | LFPAK56 | 40 | 33 | Yes | 15 | 5 | 21 | 7 | 2.7 | 1.2 |  |  | 3.3 | 2.121212121 | 1.2 | https://assets.nexperia.com/documents/data-sheet/BUK9Y21-40E.pdf | REJECT: Low Vgs (15.0V < 18V)
BUK7K25-40E | Nexperia | LFPAK56D | 40 | 27 | No |  | 10 | 25 | 7.9 | 2.6 | 1.5 |  |  | 3.35 | 2.3582 | 1.2 | https://assets.nexperia.com/documents/data-sheet/BUK7K25-40E.pdf | PASS
BUK9Y27-40B | Nexperia | LFPAK | 40 | 34 | Yes | 15 | 5 | 27 | 11 | 4.2 | 2.5 |  |  | 5.45 | 2.018348624 | 1.2 | https://assets.nexperia.com/documents/data-sheet/BUK9Y27-40B.pdf | REJECT: Low Vgs (15.0V < 18V)
BUK7Y7R6-40E | Nexperia | LFPAK56 | 40 | 79 | No |  | 10 | 7.6 | 26.2 | 8.2 | 5.4 |  |  | 10.9 | 2.403669725 | 1.2 | https://assets.nexperia.com/documents/data-sheet/BUK7Y7R6-40E.pdf | PASS
BUK7Y7R0-40H | Nexperia | LFPAK56 | 40 | 68 | No |  | 10 | 7 | 18 | 3.7 | 5.4 |  |  | 6.4 | 2.8125 | 1 | https://assets.nexperia.com/documents/data-sheet/BUK7Y7R0-40H.pdf | PASS
PSMN026-80YS | Nexperia | LFPAK | 80 | 34 | No |  | 10 | 27.5 | 20 | 5 | 6.4 | 3.7 | 2.7 | 7.7 | 2.597402597 | 1.2 | https://assets.nexperia.com/documents/data-sheet/PSMN026-80YS.pdf | PASS
PSMN8R3-40YS | Nexperia | LFPAK | 40 | 70 | No |  | 10 | 8.6 | 20 | 4.5 | 8 | 4 | 4 | 8.5 | 2.352941176 | 1.2 | https://assets.nexperia.com/documents/data-sheet/PSMN8R3-40YS.pdf | PASS
PSMN3R5-40YSD | Nexperia | LFPAK56 | 40 | 120 | No |  | 10 | 3.5 | 31 | 5 | 10 | 6.4 | 3.6 | 8.6 | 3.604651163 | 1.2 | https://assets.nexperia.com/documents/data-sheet/PSMN3R5-40YSD.pdf | PASS
BUK9K18-40E | Nexperia | LFPAK56D | 40 | 30 | Yes | 10 | 10 | 16 | 14.5 | 3 | 2 |  |  | 4 | 3.625 | 1.2 | https://assets.nexperia.com/documents/data-sheet/BUK9K18-40E.pdf | REJECT: Low Vgs (10.0V < 18V)
PSMN018-80YS | Nexperia | LFPAK | 80 | 45 | No |  | 10 | 18 | 26 | 6 | 8 | 4.7 | 3.3 | 9.3 | 2.795698925 | 1.2 | https://assets.nexperia.com/documents/data-sheet/PSMN018-80YS.pdf | PASS
BUK9V13-40H | Nexperia | LFPAK56D | 40 | 42 | Yes | 20 | 10 | 13.6 | 13.9 | 2.1 | 2.5 |  |  | 3.35 | 4.14925 | 1 | https://assets.nexperia.com/documents/data-sheet/BUK9V13-40H.pdf | PASS
BUK7K8R7-40E | Nexperia | LFPAK56D | 40 | 30 | No |  | 10 | 8.5 | 21.8 | 7.8 | 5.9 |  |  | 10.75 | 2.027906977 | 1.2 | https://assets.nexperia.com/documents/data-sheet/BUK7K8R7-40E.pdf | PASS
PSMN3R2-40YLB | Nexperia | LFPAK56 | 40 | 120 | Yes | 20 | 10 | 3.3 | 42 | 4.2 | 7.7 | 4.5 | 3 | 7.2 | 5.83 | 1 | https://assets.nexperia.com/documents/data-sheet/PSMN3R2-40YLB.pdf | PASS
BUK9Y4R4-40E | Nexperia | LFPAK56 | 40 | 100 | Yes | 15 | 5 | 4.4 | 26.8 | 8.7 | 7.7 |  |  | 12.55 | 2.14 | 1.2 | https://assets.nexperia.com/documents/data-sheet/BUK9Y4R4-40E.pdf | REJECT: Low Vgs (15.0V < 18V)
BUK7Y4R4-40E | Nexperia | LFPAK56 | 40 | 100 | No |  | 10 | 4.4 | 39 | 13 | 10 |  |  | 18 | 2.166666667 | 1.2 | https://assets.nexperia.com/documents/data-sheet/BUK7Y4R4-40E.pdf | PASS
BUK7Y3R5-40H | Nexperia | LFPAK56 | 40 | 120 | No |  | 10 | 3.5 | 31 | 6 | 10 |  |  | 11 | 2.818 | 1.2 | https://assets.nexperia.com/documents/data-sheet/BUK7Y3R5-40H.pdf | PASS
PSMN5R8-40YS | Nexperia | LFPAK | 40 | 90 | No |  | 10 | 5.7 | 28.8 | 7.8 | 9.8 | 5.1 | 4.7 | 12.5 | 2.304 | 1.2 | https://assets.nexperia.com/documents/data-sheet/PSMN5R8-40YS.pdf | PASS
BUK9K25-40RA | Nexperia | LFPAK56D | 40 | 18.2 | Yes | 15 | 5 | 29 | 6.3 | 2.4 | 1.4 |  |  | 3.1 | 2.032258065 | 1.2 | https://assets.nexperia.com/documents/data-sheet/BUK9K25-40RA.pdf | REJECT: Low Vgs (15.0V < 18V)
BUK7K6R8-40E | Nexperia | LFPAK56D | 40 | 40 | No |  | 10 | 6.8 | 28.9 | 9.1 | 7 |  |  | 12.6 | 2.29 | 1.2 | https://assets.nexperia.com/documents/data-sheet/BUK7K6R8-40E.pdf | PASS
PSMN014-40HLD | Nexperia | LFPAK56D | 40 | 42 | Yes | 20 | 10 | 13.6 | 13 | 1.8 | 2.3 |  |  | 2.95 | 4.41 | 1 | https://assets.nexperia.com/documents/data-sheet/PSMN014-40HLD.pdf | PASS
PSMN2R0-40YLB | Nexperia | LFPAK56 | 40 | 180 | Yes | 20 | 10 | 2.1 | 62 | 6 | 11 | 6.7 | 4.6 | 10.6 | 5.849 | 1 | https://assets.nexperia.com/documents/data-sheet/PSMN2R0-40YLB.pdf | PASS
BUK9Y3R5-40E | Nexperia | LFPAK56 | 40 | 100 | Yes | 15 | 5 | 3.8 | 30.2 | 8.6 | 9.7 |  |  | 13.45 | 2.24535 | 1.2 | https://assets.nexperia.com/documents/data-sheet/BUK9Y3R5-40E.pdf | REJECT: Low Vgs (15.0V < 18V)
BUK9K6R2-40E | Nexperia | LFPAK56D | 40 | 40 | Yes | 15 | 10 | 6 | 35.4 | 5.8 | 4.4 |  |  | 8 | 4.425 | 1.2 | https://assets.nexperia.com/documents/data-sheet/BUK9K6R2-40E.pdf | REJECT: Low Vgs (15.0V < 18V)
PSMN1R7-40YLB | Nexperia | LFPAK56 | 40 | 200 | Yes | 20 | 10 | 1.8 | 79 | 7.3 | 14 | 8.4 | 5.4 | 12.7 | 6.22 | 1 | https://assets.nexperia.com/documents/data-sheet/PSMN1R7-40YLB.pdf | PASS
PSMN3R3-80YSF | Nexperia | LFPAK56 | 80 | 160 | No |  | 10 | 3.1 | 70 | 14 | 20 | 13.3 | 6.7 | 20.7 | 3.38 | 1 | https://assets.nexperia.com/documents/data-sheet/PSMN3R3-80YSF.pdf | PASS
PSMNR90-40YSN | Nexperia | LFPAK56E | 40 | 320 | No |  | 10 | 0.97 | 135 | 42 | 26 | 19 | 7.6 | 49.6 | 2.72 | 1 | https://assets.nexperia.com/documents/data-sheet/PSMNR90-40YSN.pdf | PASS
PSMN1R5-40YSD | Nexperia | LFPAK56 | 40 | 240 | No |  | 10 | 1.5 | 71 | 10 | 21 | 15 | 6.7 | 16.7 | 4.25 | 1 | https://assets.nexperia.com/documents/data-sheet/PSMN1R5-40YSD.pdf | PASS
BUK7Y2R0-40H | Nexperia | LFPAK56 | 40 | 120 | No |  | 10 | 2 | 52.6 | 10.8 | 14.8 |  |  | 18.2 | 2.89011 | 1.2 | https://assets.nexperia.com/documents/data-sheet/BUK7Y2R0-40H.pdf | PASS
BUK7J1R4-40H | Nexperia | LFPAK56E | 40 | 190 | No |  | 10 | 1.4 | 73 | 13 | 21 |  |  | 23.5 | 3.11 | 1.2 | https://assets.nexperia.com/documents/data-sheet/BUK7J1R4-40H.pdf | PASS
PSMN1R0-40YSH | Nexperia | LFPAK56E | 40 | 290 | No |  | 10 | 1 | 87 | 13 | 26 | 18 | 8.3 | 21.3 | 4.084507042 | 1.2 | https://assets.nexperia.com/documents/data-sheet/PSMN1R0-40YSH.pdf | PASS
PSMN3R5-40YSB | Nexperia | LFPAK56 | 40 | 120 | No |  | 10 | 3.5 | 30 | 4 | 10 | 6.5 | 3.3 | 7.3 | 4.109589041 | 1 | https://assets.nexperia.com/documents/data-sheet/PSMN3R5-40YSB.pdf | PASS
BUK7Y13-40B | Nexperia | LFPAK | 40 | 58 | No |  | 10 | 13 | 19 | 5 | 6 |  |  | 8 | 2.375 | 1.2 | https://assets.nexperia.com/documents/data-sheet/BUK7Y13-40B.pdf | PASS
PSMN2R5-40YLB | Nexperia | LFPAK56 | 40 | 160 | Yes | 20 | 10 | 2.6 | 56 | 5 | 9.5 | 6 | 3.6 | 8.6 | 6.511627907 | 1 | https://assets.nexperia.com/documents/data-sheet/PSMN2R5-40YLB.pdf | PASS
PSMN2R8-40YSB | Nexperia | LFPAK56 | 40 | 160 | No |  | 10 | 2.8 | 42 | 6 | 13.6 | 8.8 | 5 | 11 | 3.818181818 | 1 | https://assets.nexperia.com/documents/data-sheet/PSMN2R8-40YSB.pdf | PASS
PSMN2R2-40YSB | Nexperia | LFPAK56 | 40 | 180 | No |  | 10 | 2.2 | 49 | 6.7 | 14.5 | 10 | 4.3 | 11 | 4.45 | 1 | https://assets.nexperia.com/documents/data-sheet/PSMN2R2-40YSB.pdf | PASS
PSMN2R5-40YLD | Nexperia | LFPAK56 | 40 | 160 | Yes | 20 | 10 | 2.6 | 56 | 5.9 | 10 | 5.9 | 4.1 | 10 | 5.6 | 1 | https://assets.nexperia.com/documents/data-sheet/PSMN2R5-40YLD.pdf | PASS
PSMN013-40VLD | Nexperia | LFPAK56D | 40 | 42 | Yes | 20 | 10 | 13.6 | 13.9 | 2.1 | 2.5 | 1.4 | 1.1 | 3.2 | 4.34375 | 1 | https://assets.nexperia.com/documents/data-sheet/PSMN013-40VLD.pdf | PASS
BUK7Y2R5-40H | Nexperia | LFPAK56 | 40 | 120 | No |  | 10 | 2.5 | 45.8 | 8.9 | 12.7 |  |  | 15.25 | 3.003278689 | 1.2 | https://assets.nexperia.com/documents/data-sheet/BUK7Y2R5-40H.pdf | PASS
PSMN1R9-40YSB | Nexperia | LFPAK56 | 40 | 200 | No |  | 10 | 1.9 | 56 | 7.6 | 18 | 12 | 6 | 13.6 | 4.117647059 | 1 | https://assets.nexperia.com/documents/data-sheet/PSMN1R9-40YSB.pdf | PASS
PSMN2R2-40YSD | Nexperia | LFPAK56 | 40 | 180 | No |  | 10 | 2.2 | 45 | 6.1 | 14 | 10 | 4.8 | 10.9 | 4.128440367 | 1 | https://assets.nexperia.com/documents/data-sheet/PSMN2R2-40YSD.pdf | PASS
PSMN2R0-40YLD | Nexperia | LFPAK56 | 40 | 180 | Yes | 20 | 10 | 2.1 | 66 | 7.3 | 11 | 6.9 | 4.1 | 11.4 | 5.789 | 1 | https://assets.nexperia.com/documents/data-sheet/PSMN2R0-40YLD.pdf | PASS
PSMN1R9-40YSD | Nexperia | LFPAK56 | 40 | 200 | No |  | 10 | 1.9 | 57 | 8.2 | 18 | 12 | 5.8 | 14 | 4.071428571 | 1 | https://assets.nexperia.com/documents/data-sheet/PSMN1R9-40YSD.pdf | PASS
PSMN1R7-40YLD | Nexperia | LFPAK56 | 40 | 200 | Yes | 20 | 10 | 1.8 | 78 | 7.7 | 13 | 8.1 | 4.9 | 12.6 | 6.19 | 1 | https://assets.nexperia.com/documents/data-sheet/PSMN1R7-40YLD.pdf | PASS
NVMJS1D3N04C | onsemi | LFPAK8 | 40 | 235 | No |  | 10 | 1.3 | 65 | 12 | 20 |  |  | 22 | 2.95 | 1.2 | https://www.onsemi.com/download/data-sheet/pdf/nvmjs1d3n04c-d.pdf | PASS
NTMJS0D9N04C | onsemi | LFPAK8 | 40 | 342 | No |  | 10 | 0.81 | 117 | 28 | 29 |  |  | 42.5 | 2.752941176 | 1.2 | https://www.onsemi.com/download/data-sheet/pdf/ntmjs0d9n04c-d.pdf | PASS
PSMN4R5-80YSF | Nexperia | LFPAK56 | 80 | 100 | No |  | 10 | 4.5 | 60 | 10.7 | 18.7 | 12 | 6.7 | 17.4 | 3.448 | 1 | https://assets.nexperia.com/documents/data-sheet/PSMN4R5-80YSF.pdf | PASS
NTMJS1D7N04C | ON Semiconductor | LFPAK8 | 40 | 185 | No |  | 10 | 1.7 | 47 | 7 | 16 |  |  | 15 | 3.133333333 | 1.2 | https://www.onsemi.com/download/data-sheet/pdf/NTMJS1D7N04C-D.pdf | PASS
NVMJS0D8N04CL | onsemi | LFPAK8 | 40 | 368 | No |  | 10 | 0.72 | 162 | 29 | 25 |  |  | 41.5 | 3.9036 | 1.2 | https://www.onsemi.com/download/data-sheet/pdf/nvmjs0d8n04cl-d.pdf | PASS
BUK7K3R7-40N | Nexperia | LFPAK56D | 40 | 105 | No |  | 10 | 3.7 | 47 | 16 | 10 |  |  | 21 | 2.238095238 | 1 | https://assets.nexperia.com/documents/data-sheet/BUK7K3R7-40N.pdf | PASS
MCACLF320N04Y | Micro Commercial Components | LFPAK56E | 40 | 320 | No |  | 10 | 0.62 | 80 | 18.6 | 27.6 |  |  | 32.4 | 2.4691358 | 1.2 | https://www.mccsemi.com/pdf/Products/MCACLF320N04Y(LFPAK56E).pdf | PASS
NVMJS0D9N04C | onsemi | LFPAK8 | 40 | 342 | No |  | 10 | 0.81 | 117 | 28 | 29 |  |  | 42.5 | 2.75294 | 1.2 | https://www.onsemi.com/download/data-sheet/pdf/nvmjs0d9n04c-d.pdf | PASS
PSMN4R0-40YS | Nexperia | LFPAK | 40 | 100 | No |  | 10 | 4.2 | 38 | 7 | 12 | 7 | 5 | 12 | 3.166666667 | 1.2 | https://assets.nexperia.com/documents/data-sheet/PSMN4R0-40YS.pdf | PASS
PSMN1R4-40YSH | Nexperia | LFPAK56 | 40 | 240 | No |  | 10 | 1.4 | 68 | 9.3 | 22 | 15 | 7.1 | 16.4 | 4.146341463 | 1 | https://assets.nexperia.com/documents/data-sheet/PSMN1R4-40YSH.pdf | PASS
PSMN2R6-40YS | Nexperia | LFPAK | 40 | 100 | No |  | 10 | 2.8 | 63 | 14 | 18 | 12 | 6 | 20 | 3.15 | 1.2 | https://assets.nexperia.com/documents/data-sheet/PSMN2R6-40YS.pdf | PASS
BUK9Y7R6-40E | Nexperia | LFPAK56 | 40 | 79 | Yes | 15 | 5 | 7.6 | 16.4 | 5.5 | 5.1 |  |  | 8.05 | 2.037267 | 1.2 | https://assets.nexperia.com/documents/data-sheet/BUK9Y7R6-40E.pdf | REJECT: Low Vgs (15.0V < 18V)
PSMN8R5-40HS | Nexperia | LFPAK56D | 40 | 30 | No |  | 10 | 8.5 | 21.8 | 7.8 | 5.9 |  |  | 10.75 | 2.027906977 | 1.2 | https://assets.nexperia.com/documents/data-sheet/PSMN8R5-40HS.pdf | PASS
PSMN6R8-40HS | Nexperia | LFPAK56D | 40 | 40 | No |  | 10 | 6.8 | 28.9 | 9.1 | 7 |  |  | 12.6 | 2.293650794 | 1.2 | https://assets.nexperia.com/documents/data-sheet/PSMN6R8-40HS.pdf | PASS
PSMN4R2-80YSE | Nexperia | LFPAK56E | 80 | 170 | No |  | 10 | 4.2 | 73 | 11 | 31 | 16.2 | 14.8 | 25.8 | 2.829457364 | 1 | https://assets.nexperia.com/documents/data-sheet/PSMN4R2-80YSE.pdf | PASS
BUK9Y6R5-40H | Nexperia | LFPAK56 | 40 | 70 | Yes | 20 | 10 | 6.5 | 21 | 2.2 | 4.1 |  |  | 4.25 | 4.941176471 | 1 | https://assets.nexperia.com/documents/data-sheet/BUK9Y6R5-40H.pdf | PASS
BUK7Y12-40E | Nexperia | LFPAK56 | 40 | 52 | No |  | 10 | 12 | 15 | 5.2 | 4.2 |  |  | 7.3 | 2.054794521 | 1.2 | https://assets.nexperia.com/documents/data-sheet/BUK7Y12-40E.pdf | PASS
BUK9K6R8-40E | Nexperia | LFPAK56D | 40 | 40 | Yes | 15 | 5 | 7.2 | 22.2 | 6.8 | 5.2 |  |  | 9.4 | 2.36 | 1.2 | https://assets.nexperia.com/documents/data-sheet/BUK9K6R8-40E.pdf | REJECT: Low Vgs (15.0V < 18V)
PSMN011-80YS | Nexperia | LFPAK | 80 | 67 | No |  | 10 | 11 | 45 | 11 | 13 | 8 | 5 | 16 | 2.8125 | 1.2 | https://assets.nexperia.com/documents/data-sheet/PSMN011-80YS.pdf | PASS
PSMN3R3-40YS | Nexperia | LFPAK | 40 | 100 | No |  | 10 | 3.3 | 49 | 11.2 | 13.8 | 8.3 | 5.5 | 16.7 | 2.934 | 1.2 | https://assets.nexperia.com/documents/data-sheet/PSMN3R3-40YS.pdf | PASS
PSMN2R6-80YSF | Nexperia | LFPAK56E | 80 | 231 | No |  | 10 | 2.4 | 85 | 16.5 | 22 | 16 | 6 | 22.5 | 3.77777778 | 1 | https://assets.nexperia.com/documents/data-sheet/PSMN2R6-80YSF.pdf | PASS
PSMN3R2-40YLD | Nexperia | LFPAK56 | 40 | 120 | Yes | 20 | 10 | 3.3 | 41 | 4.3 | 7.4 | 4.3 | 3.1 | 7.4 | 5.54 | 1 | https://assets.nexperia.com/documents/data-sheet/PSMN3R2-40YLD.pdf | PASS
BUK9K13-40H | Nexperia | LFPAK56D | 40 | 42 | Yes | 20 | 10 | 13.6 | 13 | 1.8 | 2.3 |  |  | 2.95 | 4.40678 | 1 | https://assets.nexperia.com/documents/data-sheet/BUK9K13-40H.pdf | PASS
BUK7Y3R0-40H | Nexperia | LFPAK56 | 40 | 120 | No |  | 10 | 3 | 34 | 6.3 | 9.8 |  |  | 11.2 | 3.0357 | 1.2 | https://assets.nexperia.com/documents/data-sheet/BUK7Y3R0-40H.pdf | PASS
NVTYS029N08HL | onsemi | LFPAK8 | 80 | 21.5 | No |  | 10 | 29.8 | 8 | 1.6 | 1.2 |  |  | 2.2 | 3.636363636 | 1.2 | https://www.onsemi.com/download/data-sheet/pdf/nvtys029n08hl-d.pdf | PASS
PSMN8R0-40HL | Nexperia | LFPAK56D | 40 | 30 | Yes | 15 | 5 | 9.4 | 15.7 | 5.3 | 3.2 |  |  | 6.9 | 2.27536 | 1.2 | https://assets.nexperia.com/documents/data-sheet/PSMN8R0-40HL.pdf | REJECT: Low Vgs (15.0V < 18V)
PSMN6R1-40HL | Nexperia | LFPAK56D | 40 | 40 | Yes | 15 | 5 | 7.2 | 22.2 | 6.8 | 5.2 |  |  | 9.4 | 2.3617 | 1.2 | https://assets.nexperia.com/documents/data-sheet/PSMN6R1-40HL.pdf | REJECT: Low Vgs (15.0V < 18V)
BUK7Y29-40E | Nexperia | LFPAK56 | 40 | 26 | No |  | 10 | 29 | 7.9 | 3 | 2 |  |  | 4 | 1.975 | 1.2 | https://assets.nexperia.com/documents/data-sheet/BUK7Y29-40E.pdf | PASS
PSMNR70-40YSN | Nexperia | LFPAK56E | 40 | 360 | No |  | 10 | 0.81 | 168 | 46 | 37 | 25 | 12 | 58 | 2.89655 | 1 | https://assets.nexperia.com/documents/data-sheet/PSMNR70-40YSN.pdf | PASS
PSMN1R0-40YLD | Nexperia | LFPAK56 | 40 | 280 | Yes | 20 | 10 | 1.1 | 127 | 17 | 19 | 12 | 8 | 25 | 5.08 | 1.2 | https://assets.nexperia.com/documents/data-sheet/PSMN1R0-40YLD.pdf | PASS
PSMN1R0-40ULD | Nexperia | LFPAK56 | 40 | 280 | Yes | 20 | 10 | 1.1 | 127 | 17 | 19 | 12 | 8 | 25 | 5.08 | 1.2 | https://assets.nexperia.com/documents/data-sheet/PSMN1R0-40ULD.pdf | PASS
NVMJD020N08HL | onsemi | LFPAK8 | 80 | 30 | No |  | 10 | 19.5 | 11.4 | 2.4 | 1.7 |  |  | 3.25 | 3.507692308 | 1.2 | https://www.onsemi.com/download/data-sheet/pdf/nvmjd020n08hl-d.pdf | PASS
BUK7Y25-40B | Nexperia | LFPAK | 40 | 35.3 | No |  | 10 | 25 | 12.1 | 5.12 | 3.44 |  |  | 6.84 | 1.769 | 1.2 | https://assets.nexperia.com/documents/data-sheet/BUK7Y25-40B.pdf | PASS
STK184N4F7AG | STMicroelectronics | LFPAK 5x6 | 40 | 100 | No |  | 10 | 2 | 35 | 8.9 | 16 |  |  | 16.9 | 2.071005917 | 1.1 | https://www.st.com/content/ccc/resource/technical/document/datasheet/group3/f2/69/2e/52/01/88/40/ae/DM00514605/files/DM00514605.pdf/jcr:content/translations/e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 | PASS
BUK9Y09-40B | Nexperia | LFPAK | 40 | 75 | Yes | 15 | 5 | 9 | 30 | 11 | 6.5 |  |  | 14.25 | 2.105263158 | 1.2 | https://assets.nexperia.com/documents/data-sheet/BUK9Y09-40B.pdf | REJECT: Low Vgs (15.0V < 18V)
NVTYS020N08HL | onsemi | LFPAK8 | 80 | 30 | No |  | 10 | 20 | 12 | 2 | 2 |  |  | 3 | 4 | 1.2 | https://www.onsemi.com/download/data-sheet/pdf/nvtys020n08hl-d.pdf | PASS
NVTYS014N08HL | onsemi | LFPAK33 | 80 | 40 | No |  | 10 | 13.9 | 15.5 | 3 | 2.4 |  |  | 4.2 | 3.69 | 1.2 | https://www.onsemi.com/download/data-sheet/pdf/nvtys014n08hl-d.pdf | PASS
PSMN1R6-40YLC | Nexperia | LFPAK; Power-SO8 | 40 | 100 | Yes | 20 | 10 | 1.55 | 126 | 15.3 | 17.7 | 12.5 | 5.2 | 20.5 | 6.15 | 1.1 | https://assets.nexperia.com/documents/data-sheet/PSMN1R6-40YLC.pdf | PASS
BUK7Y25-40B | Nexperia | LFPAK | 40 | 35.3 | No |  | 10 | 25 | 12.1 | 5.12 | 3.44 |  |  | 6.84 | 1.769 | 1.2 | https://assets.nexperia.com/documents/data-sheet/BUK7Y25-40B.pdf | PASS
PH4840S | NXP Semiconductors | LFPAK | 40 | 94.5 | No |  | 10 | 4.1 | 67 | 16 | 8.6 |  |  | 20.3 | 3.300492611 | 1.2 | https://assets.nexperia.com/documents/data-sheet/PH4840S.pdf | PASS
PSMN1R4-40YLD | Nexperia | LFPAK56 | 40 | 240 | Yes | 20 | 10 | 1.4 | 96 | 13 | 15 | 9 | 6 | 19 | 5.0526 | 1.2 | https://assets.nexperia.com/documents/data-sheet/PSMN1R4-40YLD.pdf | PASS
PSMN2R5-40YLD | Nexperia | LFPAK56 | 40 | 160 | Yes | 20 | 10 | 2.6 | 56 | 5.9 | 10 | 5.9 | 4.1 | 10 | 5.6 | 1 | https://assets.nexperia.com/documents/data-sheet/PSMN2R5-40YLD.pdf | PASS
PSMN2R6-40YS | Nexperia | LFPAK | 40 | 100 | No |  | 10 | 2.8 | 63 | 14 | 18 | 12 | 6 | 20 | 3.15 | 1.2 | https://assets.nexperia.com/documents/data-sheet/PSMN2R6-40YS.pdf | PASS
PSMN3R3-40YS | Nexperia | LFPAK | 40 | 100 | No |  | 10 | 3.3 | 49 | 11.2 | 13.8 | 8.3 | 5.5 | 16.7 | 2.934 | 1.2 | https://assets.nexperia.com/documents/data-sheet/PSMN3R3-40YS.pdf | PASS
PSMN2R8-40YSD | Nexperia | LFPAK56 | 40 | 160 | No |  | 10 | 2.8 | 44 | 7 | 13 | 8.8 | 4.2 | 11.2 | 3.928571429 | 1 | https://assets.nexperia.com/documents/data-sheet/PSMN2R8-40YSD.pdf | PASS
PSMN1R5-40YSD | Nexperia | LFPAK56 | 40 | 240 | No |  | 10 | 1.5 | 71 | 10 | 21 | 15 | 6.7 | 16.7 | 4.25 | 1 | https://assets.nexperia.com/documents/data-sheet/PSMN1R5-40YSD.pdf | PASS
PSMN3R5-40YSD | Nexperia | LFPAK56 | 40 | 120 | No |  | 10 | 3.5 | 31 | 5 | 10 | 6.4 | 3.6 | 8.6 | 3.604651163 | 1.2 | https://assets.nexperia.com/documents/data-sheet/PSMN3R5-40YSD.pdf | PASS
BUK7Y08-40B | Nexperia | LFPAK | 40 | 75 | No |  | 10 | 8 | 36.3 | 14.7 | 10.4 |  |  | 19.9 | 1.824120603 | 1.2 | https://assets.nexperia.com/documents/data-sheet/BUK7Y08-40B.pdf | PASS
BUK7Y08-40B | Nexperia | LFPAK | 40 | 75 | No |  | 10 | 8 | 36.3 | 14.7 | 10.4 |  |  | 19.9 | 1.824120603 | 1.2 | https://assets.nexperia.com/documents/data-sheet/BUK7Y08-40B.pdf | PASS
PSMN1R6-40YLC | Nexperia | LFPAK; Power-SO8 | 40 | 100 | Yes | 20 | 10 | 1.55 | 126 | 15.3 | 17.7 | 12.5 | 5.2 | 20.5 | 6.146341463 | 1.1 | https://assets.nexperia.com/documents/data-sheet/PSMN1R6-40YLC.pdf | PASS
AOD442G | Alpha & Omega Semiconductor | TO-252 | 60 | 40 | Yes | 20 | 10 | 18 | 47.5 | 14.5 | 6 |  |  | 17.5 | 2.714285714 | 1 | https://aosmd.com/res/data_sheets/AOD442G.pdf | PASS
AOD4130 | Alpha & Omega Semiconductor | TO-252 | 60 | 30 | No |  | 10 | 24 | 28.3 | 7.2 | 4.5 |  |  | 9.45 | 2.99 | 1 | https://aosmd.com/res/data_sheets/AOD4130.pdf | PASS
STD20NF06L | STMicroelectronics | DPAK | 60 | 24 | Yes | 18 | 10 | 40 | 13 | 8 | 3.5 |  |  | 9.75 | 1.333333333 | 1.5 | https://www.st.com/content/ccc/resource/technical/document/datasheet/a6/4e/36/6e/fb/e1/44/e8/CD00003407.pdf/files/CD00003407.pdf/jcr:content/translations/en.C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 | PASS
NTD18N06L | onsemi | DPAK | 60 | 18 | Yes | 15 | 5 | 65 | 11 | 6.5 | 3.2 |  |  | 8.1 | 1.358 | 1.15 | https://www.onsemi.com/pdf/datasheet/ntd18n06l-d.pdf | REJECT: Low Vgs (15.0V < 18V)
FDD86540 | Fairchild Semiconductor | D-PAK(TO-252) | 60 | 136 | No |  | 10 | 4.1 | 65 | 12 | 23 |  |  | 23.5 | 2.765957447 | 1.3 | https://www.onsemi.com/pub/Collateral/FDD86540-D.pdf | PASS
STD35NF06L | STMicroelectronics | DPAK | 60 | 35 | Yes | 16 | 4.5 | 20 | 25 | 10 | 5 |  |  | 12.5 | 2 | 1.5 | https://www.st.com/content/ccc/resource/technical/document/datasheet/48/eb/5d/41/e2/c9/48/f2/CD00002363.pdf/files/CD00002363.pdf/jcr:content/translations/en.C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 | REJECT: Low Vgs (16.0V < 18V)
STD140N6F7 | STMicroelectronics | DPAK | 60 | 80 | No |  | 10 | 3.8 | 55 | 18 | 19 |  |  | 27.5 | 2 | 1.2 | https://www.st.com/content/ccc/resource/technical/document/datasheet/group1/de/02/69/d9/32/b8/44/66/DM00257307/files/DM00257307.pdf/jcr:content/translations/e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 | PASS
SQD40N06-14L | Vishay Siliconix | TO-252 | 60 | 40 | No |  | 10 | 14 | 34 | 8.5 | 6 |  |  | 11.5 | 2.956521739 | 1.2 | https://www.vishay.com/docs/67002/sqd40n06-14l.pdf | PASS
SQD50N06-09L | Vishay Siliconix | TO-252 | 60 | 50 | No |  | 10 | 9 | 48 | 13.5 | 7.1 |  |  | 17.05 | 2.8152 | 1.5 | https://www.vishay.com/docs/68901/sqd50n06-09l.pdf | PASS
DI020N06D1 | Diotec Semiconductor | TO-252AA | 60 | 20 | No |  | 10 | 35 | 25.3 | 6.1 | 4.7 |  |  | 8.45 | 2.99408284 | 1.2 | https://diotec.com/request/datasheet/di020n06d1.pdf | PASS
DMN6040SK3 | Diodes Incorporated | TO252 (DPAK) | 60 | 20 | No |  | 10 | 40 | 22.4 | 3 | 4.9 |  |  | 5.45 | 4.11 | 1.2 | https://www.diodes.com/assets/Datasheets/DMN6040SK3.pdf | PASS
STD12NF06LT4 | STMicroelectronics | DPAK | 60 | 12 | Yes | 16 | 10 | 90 | 7.5 | 3 | 2.5 |  |  | 4.25 | 1.7647 | 1.5 | //mm.digikey.com/Volume0/opasdata/d220001/medias/docus/8924/STD12NF06LT4.pdf | REJECT: Low Vgs (16.0V < 18V)
AOD442/AOI442 | Alpha & Omega Semiconductor | DPAK, IPAK | 60 | 37 | No |  | 10 | 20 | 47.6 | 14.4 | 4.8 |  |  | 16.8 | 2.833333333 | 1 | https://aosmd.com/res/data_sheets/AOD442.pdf | PASS
DMNH6021SK3Q | Diodes Incorporated | TO252 | 60 | 50 | No |  | 10 | 23 | 20.1 | 5.5 | 4.3 |  |  | 7.65 | 2.62745098 | 1.2 | https://www.diodes.com/datasheet/download/DMNH6021SK3Q.pdf | PASS
SUD23N06-31 | Vishay Siliconix | TO-252 | 60 | 21.4 | No |  | 10 | 31 | 11 | 3 | 3 |  |  | 4.5 | 2.44 | 1.5 | https://www.vishay.com/docs/68857/sud23n06.pdf | PASS
STD16NF06 | STMicroelectronics | DPAK | 60 | 16 | No |  | 10 | 70 | 14.1 | 5.4 | 2.8 |  |  | 6.8 | 2.073529412 | 1.5 | https://www.st.com/content/ccc/resource/technical/document/datasheet/group2/6e/70/3f/f6/ef/60/4c/39/CD00083971/files/CD00083971.pdf/jcr:content/translations/e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 | PASS
DMTH6009LK3 | Diodes Incorporated | TO252 (DPAK) | 60 | 59 | Yes | 16 | 10 | 10 | 33.5 | 5.3 | 4.7 |  |  | 7.65 | 4.379084967 | 1.2 | https://www.diodes.com/assets/Datasheets/DMTH6009LK3.pdf | REJECT: Low Vgs (16.0V < 18V)
STD130N6F7 | STMicroelectronics | DPAK | 60 | 80 | No |  | 10 | 5 | 42 | 13 | 13.6 |  |  | 19.8 | 2.121212121 | 1.2 | https://www.st.com/content/ccc/resource/technical/document/datasheet/group1/ba/8d/e1/5c/06/52/4c/f2/DM00256820/files/DM00256820.pdf/jcr:content/translations/e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 | PASS
IRFR014 | Vishay Siliconix | DPAK | 60 | 7.7 | No |  | 10 | 200 | 11 | 5.8 | 3.1 |  |  | 7.35 | 1.496598639 | 1.6 | https://www.vishay.com/docs/91263/sihfr014.pdf | PASS
SQD50034EL | Vishay Siliconix | TO-252 | 60 | 100 | No |  | 10 | 4 | 60 | 4.8 | 16.3 |  |  | 12.95 | 4.633204633 | 1.5 | https://www.vishay.com/docs/75400/sqd50034el.pdf | PASS
STD60NF06T4 | STMicroelectronics | DPAK | 60 | 60 | No |  | 10 | 16 | 49 | 14 | 18 |  |  | 23 | 2.130434783 | 1.3 | https://www.st.com/resource/en/datasheet/std60nf06t4.pdf | PASS
DMNH6042SK3 | Diodes Incorporated | TO252 (DPAK) | 60 | 25 | No |  | 10 | 50 | 8.8 | 1.8 | 1.8 |  |  | 2.7 | 3.259259259 | 1.2 | https://www.diodes.com/assets/Datasheets/DMNH6042SK3.pdf | PASS
DI050N06D1 | Diotec Semiconductor | TO-252AA | 65 | 50 | Yes | 20 | 10 | 11 | 14 | 2.8 | 2.6 |  |  | 4.1 | 3.414634146 | 1.2 | https://diotec.com/request/datasheet/di050n06d1.pdf | PASS
STD30N6LF6AG | STMicroelectronics | DPAK | 60 | 24 | No |  | 10 | 25 | 26 | 3.3 | 6 |  |  | 6.3 | 4.126984127 | 1.3 | https://www.st.com/content/ccc/resource/technical/document/datasheet/9a/b6/39/95/41/c8/4a/21/DM00210369.pdf/files/DM00210369.pdf/jcr:content/translations/en.D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 | PASS
MCU20N06A | Micro Commercial Components | DPAK(TO-252) | 60 | 20 | No |  | 10 | 30 | 24.5 | 6.3 | 2.8 |  |  | 7.7 | 3.1818 | 1.2 | https://www.mccsemi.com/pdf/Products/MCU20N06A(DPAK).pdf | PASS
SUD23N06-31L | Vishay Siliconix | TO-252 | 60 | 23 | Yes | 20 | 10 | 31 | 11 | 3 | 3 |  |  | 4.5 | 2.44 | 1.5 | https://www.vishay.com/docs/72145/sud23n06-31l.pdf | PASS
MCU90N06A | Micro Commercial Components | DPAK (TO-252) | 60 | 90 | No |  | 10 | 7.2 | 102 | 20 | 13.2 |  |  | 26.6 | 3.834586 | 1.2 | https://www.mccsemi.com/pdf/products/MCU90N06A(DPAK).pdf | PASS
DMT6009LK3 | Diodes Incorporated | TO252 | 60 | 57 | Yes | 16 | 10 | 10 | 33.5 | 5.3 | 4.7 |  |  | 7.65 | 4.379084967 | 1.2 | https://www.diodes.com/assets/Datasheets/DMT6009LK3.pdf | REJECT: Low Vgs (16.0V < 18V)
SQD15N06-42L | Vishay Siliconix | TO-252 | 60 | 15 | No |  | 10 | 42 | 9.5 | 2.5 | 1.7 |  |  | 3.35 | 2.8358 | 1.2 | https://www.vishay.com/docs/68880/sqd15n06-42l.pdf | PASS
DMTH6005LK3 | Diodes Incorporated | TO252 (DPAK) | 60 | 90 | No |  | 10 | 5.6 | 47.1 | 12.5 | 10.2 |  |  | 17.6 | 2.676136364 | 1.2 | https://www.diodes.com/assets/Datasheets/DMTH6005LK3.pdf | PASS
DMTH6010SK3Q | Diodes Incorporated | TO252 (DPAK) | 60 | 70 | No |  | 10 | 8 | 38.1 | 9.3 | 8.3 |  |  | 13.45 | 2.8327 | 1.2 | https://www.diodes.com/datasheet/download/DMTH6010SK3Q.pdf | PASS
STD12NF06T4 | STMicroelectronics | DPAK | 60 | 12 | No |  | 10 | 100 | 10 | 3.5 | 3 |  |  | 5 | 2 | 1.3 | https://www.st.com/content/ccc/resource/technical/document/datasheet/5c/31/89/d4/5c/b2/4c/da/CD00002756.pdf/files/CD00002756.pdf/jcr:content/translations/en.C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 | PASS
STD35NF06 | STMicroelectronics | DPAK | 60 | 35 | No |  | 10 | 20 | 44.5 | 17.5 | 10.5 |  |  | 22.75 | 1.956 | 1.5 | https://www.st.com/content/ccc/resource/technical/document/datasheet/0d/26/b9/23/e3/c0/49/5f/CD00002312.pdf/files/CD00002312.pdf/jcr:content/translations/en.C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 | PASS
DMTH6009LK3Q | Diodes Incorporated | TO252 (DPAK) | 60 | 59 | Yes | 16 | 10 | 10 | 33.5 | 5.3 | 4.7 |  |  | 7.65 | 4.379085 | 1.2 | https://www.diodes.com/datasheet/download/DMTH6009LK3Q.pdf | REJECT: Low Vgs (16.0V < 18V)
FDD5680 | onsemi | TO-252 | 60 | 38 | No |  | 10 | 21 | 33 | 7.5 | 6.5 |  |  | 10.75 | 3.069767442 | 1.2 | https://www.onsemi.com/pub/Collateral/FDD5680-D.PDF | PASS
DMTH6004SK3Q | Diodes Incorporated | TO252 (DPAK) | 60 | 100 | No |  | 10 | 3.8 | 95.4 | 20.4 | 21.6 |  |  | 31.2 | 3.057692308 | 1.2 | https://www.diodes.com/datasheet/download/DMTH6004SK3Q.pdf | PASS
DMTH6004SK3 | Diodes Incorporated | TO252 (DPAK) | 60 | 100 | No |  | 10 | 3.8 | 95.4 | 20.4 | 21.6 |  |  | 31.2 | 3.057692308 | 1.2 | https://www.diodes.com/assets/Datasheets/DMTH6004SK3.pdf | PASS
IRFR014 | Vishay Siliconix | DPAK (TO-252) | 60 | 7.7 | No |  | 10 | 200 | 11 | 5.8 | 3.1 |  |  | 7.35 | 1.496598639 | 1.6 | https://www.vishay.com/docs/91263/sihfr014.pdf | PASS
MCU80N06 | Micro Commercial Components | DPAK | 60 | 80 | No |  | 10 | 13 | 36 | 6.6 | 9.6 |  |  | 11.4 | 3.157894737 | 1.4 | https://www.mccsemi.com/pdf/Products/MCU80N06(DPAK).pdf | PASS
MCU75N06YHE3 | Micro Commercial Components | DPAK(TO-252) | 60 | 75 | No |  | 10 | 4.8 | 34.5 | 9.2 | 4.6 |  |  | 11.5 | 3 | 1.3 | https://www.mccsemi.com/pdf/Products/MCU75N06YHE3(DPAK).pdf | PASS
SQD25N06-22L | Vishay Siliconix | TO-252 | 60 | 25 | No |  | 10 | 22 | 33 | 6.8 | 5.3 |  |  | 9.45 | 3.492063492 | 1.5 | https://www.vishay.com/docs/65360/sqd25n06-22l.pdf | PASS
SQD23N06-31L | Vishay Siliconix | TO-252 | 60 | 23 | No |  | 10 | 31 | 16 | 3 | 4 |  |  | 5 | 3.2 | 1.5 | https://www.vishay.com/docs/68869/sqd23n06-31l.pdf | PASS
SQD97N06-6m3L | Vishay Siliconix | TO-252 | 60 | 97 | No |  | 10 | 6.3 | 82 | 13.5 | 14.5 |  |  | 20.75 | 3.9518 | 1.5 | https://www.vishay.com/docs/62897/sqd97n06-6m3l.pdf | PASS
IRFR024 | Vishay Siliconix | DPAK (TO-252) | 60 | 14 | No |  | 10 | 100 | 25 | 11 | 5.8 |  |  | 13.9 | 1.79856 | 1.5 | https://www.vishay.com/docs/91264/sihfr024.pdf | PASS
IRFR020 | Vishay Siliconix | DPAK (TO-252) | 60 | 14 | No |  | 10 | 100 | 25 | 11 | 5.8 |  |  | 13.9 | 1.798561151 | 1.5 | https://www.vishay.com/docs/90335/sihfr020.pdf | PASS
IRFR024 | Vishay Siliconix | DPAK (TO-252) | 60 | 14 | No |  | 10 | 100 | 25 | 11 | 5.8 |  |  | 13.9 | 1.798561151 | 1.5 | https://www.vishay.com/docs/91264/sihfr024.pdf | PASS
IRFR024 | Vishay Siliconix | DPAK (TO-252) | 60 | 14 | No |  | 10 | 100 | 25 | 11 | 5.8 |  |  | 13.9 | 1.798561151 | 1.5 | https://www.vishay.com/docs/91264/sihfr024.pdf | PASS
DMNH6042SK3Q | Diodes Incorporated | TO252 | 60 | 25 | No |  | 10 | 50 | 8.8 | 1.8 | 1.8 |  |  | 2.7 | 3.259259259 | 1.2 | https://www.diodes.com/datasheet/download/DMNH6042SK3Q.pdf | PASS
NTD3055-094 | onsemi | DPAK | 60 | 12 | No |  | 10 | 94 | 10.9 | 4.2 | 3.1 |  |  | 5.75 | 1.895652174 | 1.15 | https://www.onsemi.com/download/data-sheet/pdf/ntd3055-094-d.pdf | PASS
MCU60N06 | Micro Commercial Components | DPAK(TO-252) | 60 | 60 | No |  | 10 | 11 | 54 | 21 | 12 |  |  | 27 | 2 | 1.2 | https://www.mccsemi.com/pdf/Products/MCU60N06(DPAK).pdf | PASS
STD20NF06LAG | STMicroelectronics | DPAK | 60 | 24 | Yes | 18 | 5 | 50 | 13 | 8 | 3.5 |  |  | 9.75 | 1.333333333 | 1.5 | https://www.st.com/resource/en/datasheet/std20nf06lag.pdf | PASS
DMNH6012LK3Q | Diodes Incorporated | TO252 (DPAK) | 60 | 80 | No |  | 10 | 12 | 35.2 | 6.9 | 7.6 |  |  | 10.7 | 3.2897 | 1.2 | https://www.diodes.com/datasheet/download/DMNH6012LK3Q.pdf | PASS
SUD23N06-31 | Vishay Siliconix | TO-252 | 60 | 21.4 | No |  | 10 | 31 | 11 | 3 | 3 |  |  | 4.5 | 2.444444444 | 1.5 | https://www.vishay.com/docs/68857/sud23n06.pdf | PASS
DMTH6010SK3 | Diodes Incorporated | TO252 | 60 | 70 | No |  | 10 | 8 | 38.1 | 9.3 | 8.3 |  |  | 13.45 | 2.832713755 | 1.2 | https://www.diodes.com/assets/Datasheets/DMTH6010SK3.pdf | PASS
IRFR014 | Vishay Siliconix | DPAK (TO-252) | 60 | 7.7 | No |  | 10 | 200 | 11 | 5.8 | 3.1 |  |  | 7.35 | 1.496598639 | 1.6 | https://www.vishay.com/docs/91263/sihfr014.pdf | PASS
IRFR014 | Vishay Siliconix | DPAK | 60 | 7.7 | No |  | 10 | 200 | 11 | 5.8 | 3.1 |  |  | 7.35 | 1.496598639 | 1.6 | https://www.vishay.com/docs/91263/sihfr014.pdf | PASS
IRFR014 | Vishay Siliconix | DPAK | 60 | 7.7 | No |  | 10 | 200 | 11 | 5.8 | 3.1 |  |  | 7.35 | 1.496598639 | 1.6 | https://www.vishay.com/docs/91263/sihfr014.pdf | PASS
SQD97N06-6m3L | Vishay Siliconix | TO-252 | 60 | 97 | No |  | 10 | 6.3 | 82 | 13.5 | 14.5 |  |  | 20.75 | 3.95 | 1.5 | https://www.vishay.com/docs/62897/sqd97n06-6m3l.pdf | PASS
IRFR024 | Vishay Siliconix | DPAK (TO-252) | 60 | 14 | No |  | 10 | 100 | 25 | 11 | 5.8 |  |  | 13.9 | 1.79856 | 1.5 | https://www.vishay.com/docs/91264/sihfr024.pdf | PASS
MCU110N06YB | Micro Commercial Components | DPAK(TO-252) | 60 | 110 | No |  | 10 | 5 | 58 | 11.5 | 16.8 |  |  | 19.9 | 2.91457 | 1.2 | https://www.mccsemi.com/pdf/Products/MCU110N06YB(DPAK).pdf | PASS
MCU018N06L | Micro Commercial Components | DPAK (TO-252) | 60 | 32 | No |  | 10 | 18 | 39 | 9.6 | 5.3 |  |  | 12.25 | 3.183673469 | 1.2 | https://www.mccsemi.com/pdf/Products/MCU018N06L(DPAK).pdf | PASS
MCU031N06Q | Micro Commercial Components | DPAK(TO-252) | 60 | 23 | No |  | 10 | 31 | 18 | 2.4 | 2.8 |  |  | 3.8 | 4.736842105 | 1.2 | https://www.mccsemi.com/pdf/products/MCU031N06Q(DPAK).pdf | PASS
DMN6040SK3Q | Diodes Incorporated | TO252 (DPAK) | 60 | 20 | No |  | 10 | 40 | 22.4 | 3 | 4.9 |  |  | 5.45 | 4.11 | 1.2 | https://www.diodes.com/datasheet/download/DMN6040SK3Q.pdf | PASS
NVMYS9D3N06CL | onsemi | LFPAK4 | 60 | 50 | No |  | 10 | 9.2 | 9.5 | 0.8 | 2 |  |  | 1.8 | 5.28 | 1.2 | https://www.onsemi.com/download/data-sheet/pdf/nvmys9d3n06cl-d.pdf | PASS
DMT64M3SK3 | Diodes Incorporated | TO252 (DPAK) | 60 | 131 | No |  | 10 | 4.2 | 83 | 5.5 | 40 |  |  | 25.5 | 3.2549 | 1.2 | https://www.diodes.com/datasheet/download/DMT64M3SK3.pdf | PASS
AG092FLD3HRB | ROHM Semiconductor | TO-252 | 60 | 40 | No |  | 10 | 13.5 | 13 | 2.4 | 2.1 |  |  | 3.45 | 3.768115942 | 1.5 | https://fscdn.rohm.com/en/products/databook/datasheet/discrete/transistor/mosfet/ag092fld3hrbtl-e.pdf | PASS
RD3L04BBLHRB | ROHM Semiconductor | TO-252 | 60 | 40 | No |  | 10 | 13.6 | 12.1 | 2.4 | 3.1 |  |  | 3.95 | 3.063291139 | 1.5 | https://fscdn.rohm.com/en/products/databook/datasheet/discrete/transistor/mosfet/rd3l04bblhrbtl-e.pdf | PASS
MCU6D5N06YLQ | Micro Commercial Components | DPAK(TO-252) | 60 | 80 | No |  | 10 | 6.5 | 27 | 3.9 | 5.6 |  |  | 6.7 | 4.029850746 | 1.2 | https://www.mccsemi.com/pdf/Products/MCU6D5N06YLQ(DPAK).pdf | PASS
RD3L08DBLHRB | ROHM Semiconductor | DPAK | 60 | 80 | No |  | 10 | 7.6 | 22 | 3.7 | 4.7 |  |  | 6.05 | 3.636363636 | 1.5 | https://fscdn.rohm.com/en/products/databook/datasheet/discrete/transistor/mosfet/rd3l08dblhrbtl-e.pdf | PASS
MCU95N06KY | Micro Commercial Components | DPAK(TO-252) | 60 | 95 | No |  | 10 | 5.5 | 71 | 14 | 12 |  |  | 20 | 3.55 | 1.3 | https://www.mccsemi.com/pdf/Products/MCU95N06KY(DPAK).pdf | PASS
MCU110N06YA | Micro Commercial Components | DPAK(TO-252) | 60 | 110 | No |  | 10 | 4.4 | 80 | 12 | 15 |  |  | 19.5 | 4.102564103 | 1.2 | https://www.mccsemi.com/pdf/Products/MCU110N06YA(DPAK).pdf | PASS
RD3L08CBLHRB | ROHM Semiconductor | TO-252 | 60 | 80 | No |  | 10 | 5.3 | 32 | 5.3 | 6.7 |  |  | 8.65 | 3.69942 | 1.5 | https://fscdn.rohm.com/en/products/databook/datasheet/discrete/transistor/mosfet/rd3l08cblhrbtl-e.pdf | PASS
GSFD0625 | GOOD-ARK SEMICONDUCTOR | TO-252 (DPAK) | 60 | 27 | No |  | 10 | 28 | 16.4 | 3.7 | 3.1 |  |  | 5.25 | 3.123809524 | 1 | https://goodarksemi.com/docs/datasheets/mosfets/GSFD0625.pdf | PASS
GSFD0646 | Good-Ark Semiconductor | TO-252 (DPAK) | 60 | 45 | No |  | 10 | 12 | 39.2 | 8.8 | 5.9 |  |  | 11.75 | 3.336170213 | 1 | https://goodarksemi.com/docs/datasheets/mosfets/GSFD0646.pdf | PASS
GSFD6046 | GOOD-ARK Semiconductor | TO-252 (DPAK) | 60 | 20 | No |  | 10 | 46 | 2.2 | 3.9 | 16.6 |  |  | 12.2 | 0.1803278689 | 1.2 | https://goodarksemi.com/docs/datasheets/mosfets/GSFD6046.pdf | PASS
UMW 25N06 | UMW | TO-252 | 60 | 25 | No |  | 10 | 29 | 21.2 | 5.5 | 3.6 |  |  | 7.3 | 2.904109589 | 1.2 | https://www.umw-ic.com/static/pdf/9bf8ccb949e0e45bbb65c3a799afcd71.pdf | PASS
UMW STD35NF06L | UMW | TO-252(DPAK) | 60 | 35 | No |  | 10 | 20 | 44.5 | 17.5 | 10.5 |  |  | 22.75 | 1.956 | 1.5 | https://www.umw-ic.com/static/pdf/aad32344492410b24b286d330a5bd9fd.pdf | PASS
G15N06K | GOFORD | TO-252 | 60 | 15 | No |  | 10 | 45 | 16 | 4 | 2 |  |  | 5 | 3.2 | 1.2 | https://www.gofordsemi.com/upload/cn/propdf/G15N06K.pdf | PASS
UMW 30N06 | UMW | TO-252 | 60 | 35 | No |  | 10 | 29 | 21.2 | 5.5 | 3.6 |  |  | 7.3 | 2.904109589 | 1.2 | https://www.umw-ic.com/static/pdf/10c29d1b7b8c7d113b550cd35191961f.pdf | PASS
UMW STD20NF06L | UMW | TO-252 | 60 | 30 | No |  | 10 | 35 | 25 | 6.5 | 4.5 |  |  | 8.75 | 2.857 | 1.2 | https://www.umw-ic.com/static/pdf/3b9c950fbe09f279c5756f944ed64f54.pdf | PASS
UMW STD30NF06L | UMW | TO-252 | 60 | 30 | No |  | 10 | 29 | 25 | 6.5 | 4.5 |  |  | 8.75 | 2.857142857 | 1.2 | https://www.umw-ic.com/static/pdf/0133bfb8c352b79ec3add0e1dbebdd5f.pdf | PASS
FDD5810 | UMW | TO-252 | 60 | 37 | No |  | 10 | 22 | 24 | 5 | 4 | 1.3 | 2.7 | 7.7 | 3.116883117 | 1.25 | https://www.umw-ic.com/static/pdf/e1a344fed86a640d6ea8d0423eb25f6b.pdf | PASS
GSFD9R706 | Good-Ark Semiconductor | TO-252 (DPAK) | 60 | 60 | No |  | 10 | 9.7 | 18 | 2.7 | 5.6 |  |  | 5.5 | 3.272727273 | 1.2 | https://goodarksemi.com/docs/datasheets/mosfets/GSFD9R706.pdf | PASS
UMW SUD23N06-31 | UMW | TO-252 | 60 | 35 | No |  | 10 | 31 | 11 | 3 | 3 |  |  | 4.5 | 2.44 | 1.5 | https://www.umw-ic.com/static/pdf/805d406edfa42da735cd3493152ebd70.pdf | PASS
G23N06K | GOFORD | TO-252 | 60 | 23 | No |  | 10 | 35 | 25 | 6 | 5 |  |  | 8.5 | 2.94 | 1.2 | https://www.gofordsemi.com/upload/cn/propdf/G23N06K.pdf | PASS
G25N06K | GOFORD | TO-252 | 60 | 25 | No |  | 10 | 27 | 25 | 6.5 | 4.5 |  |  | 8.75 | 2.857142857 | 1.2 | https://www.gofordsemi.com/upload/cn/propdf/G25N06K.pdf | PASS
60N06 | GOFORD | TO-252 | 60 | 55 | No |  | 10 | 17 | 54 | 10 | 6 |  |  | 13 | 4.153846154 | 1.2 | https://www.gofordsemi.com/upload/cn/propdf/60N06.pdf | PASS
UMW 40N06 | UMW | TO-252 | 60 | 40 | No |  | 10 | 18 | 50 | 15 | 6 |  |  | 18 | 2.78 | 1.2 | https://www.umw-ic.com/static/pdf/421fa9ccd19f7517567e82d51a4d62cd.pdf | PASS
UMW 30N06 | UMW | TO-252 | 60 | 30 | No |  | 10 | 29 | 25 | 6.5 | 4.5 |  |  | 8.75 | 2.857142857 | 1.2 | https://www.umw-ic.com/static/pdf/f03367495a5f5748816e5dcea2b3f79a.pdf | PASS
AM90N06-04D | Analog Power | TO-252 | 60 | 83 | No |  | 4.5 | 5.8 | 64 | 22 | 20 |  |  | 32 | 2 | 0.86 | //mm.digikey.com/Volume0/opasdata/d220001/medias/docus/6167/AM90N06-04D.pdf | PASS
UMW 50N06 | UMW | TO-252 | 60 | 50 | No |  | 10 | 17 | 50 | 15 | 6 |  |  | 18 | 2.78 | 1.2 | https://www.umw-ic.com/static/pdf/1d470444ea152bf302bea3580c0ff6d0.pdf | PASS
UMW FQD20N06 | UMW | TO-252(DPAK) | 60 | 45 | No |  | 10 | 31 | 11 | 3 | 3 |  |  | 4.5 | 2.44 | 1.5 | https://www.umw-ic.com/static/pdf/a83d39f716e95798473a378f909e1bc9.pdf | PASS
GT055N06K | GOFORD | TO-252 | 60 | 90 | No |  | 10 | 5 | 30 | 5 | 4.5 |  |  | 7.25 | 4.137931034 | 1.2 | https://www.gofordsemi.com/upload/cn/propdf/GT055N06K.pdf | PASS
G58N06K | GOFORD | TO-252 | 60 | 58 | No |  | 10 | 13 | 36 | 6.5 | 10 |  |  | 11.5 | 3.13 | 1.2 | https://www.gofordsemi.com/upload/cn/propdf/G58N06K.pdf | PASS
GT090N06K | GOFORD | TO-252 | 60 | 45 | No |  | 10 | 9 | 22 | 4 | 5 |  |  | 6.5 | 3.384615385 | 1.2 | https://www.gofordsemi.com/upload/cn/propdf/GT090N06K.pdf | PASS
IRFR024 | Vishay Siliconix | DPAK (TO-252) | 60 | 14 | No |  | 10 | 100 | 25 | 11 | 5.8 |  |  | 13.9 | 1.79856 | 1.5 | https://www.vishay.com/docs/91264/sihfr024.pdf | PASS
G080N06K | GOFORD | TO-252 | 60 | 80 | No |  | 10 | 8 | 62 | 20 | 16 |  |  | 28 | 2.214285714 | 1.2 | https://www.gofordsemi.com/upload/cn/propdf/G080N06K.pdf | PASS
UMW IRFR1018ETR | UMW | TO-252 | 60 | 56 | No |  | 10 | 8.4 | 46 | 12 | 10 |  |  | 17 | 2.705882353 | 1.3 | https://www.umw-ic.com/static/pdf/67438361e7c0c11105bbc21d09ed1155.pdf | PASS
UMW IRFR3806TR | UMW | TO-252 | 60 | 43 | No |  | 10 | 15.8 | 22 | 6.3 | 5 |  |  | 8.8 | 2.5 | 1.3 | https://www.umw-ic.com/static/pdf/a8d35f27af7a3f88e5029f37d624accf.pdf | PASS
GT100N12K | GOFORD | TO-252 | 120 | 70 | No |  | 10 | 10 | 45 | 11 | 16 |  |  | 19 | 2.368421053 | 1.2 | https://www.gofordsemi.com/upload/cn/propdf/GT100N12K.pdf | PASS
SQD15N06-42L | Vishay Siliconix | TO-252 | 60 | 15 | No |  | 10 | 42 | 9.5 | 2.5 | 1.7 |  |  | 3.35 | 2.8358 | 1.2 | https://www.vishay.com/docs/68880/sqd15n06-42l.pdf | PASS
G86N06K | GOFORD | TO-252 | 60 | 80 | No |  | 10 | 8.4 | 61 | 20 | 16 |  |  | 28 | 2.178571429 | 1.2 | https://www.gofordsemi.com/upload/cn/propdf/G86N06K.pdf | PASS
UMW IRFR7546TR | UMW | TO-252 | 60 | 71 | No |  | 10 | 7.9 | 58 | 18 | 14 |  |  | 25 | 2.32 | 1.2 | https://www.umw-ic.com/static/pdf/7fddc74855c1422269214fc8e61d300d.pdf | PASS
G110N06K | GOFORD | TO-252 | 60 | 110 | No |  | 10 | 6.4 | 144 | 34 | 19 |  |  | 43.5 | 3.310344828 | 1.2 | https://www.gofordsemi.com/upload/cn/propdf/G110N06K.pdf | PASS
GT100N12K | GOFORD | TO-252 | 120 | 70 | No |  | 10 | 10 | 45 | 11 | 16 |  |  | 19 | 2.368421053 | 1.2 | https://www.gofordsemi.com/upload/cn/propdf/GT100N12K.pdf | PASS
SQD50034E | Vishay Siliconix | TO-252 | 60 | 100 | No |  | 10 | 3.9 | 58 | 5 | 24 |  |  | 17 | 3.41 | 1.5 | https://www.vishay.com/docs/79706/sqd50034e.pdf | PASS
FDD10AN06A0 | onsemi | DPAK3 (TO-252 3 LD) | 60 | 50 | No |  | 10 | 10.5 | 28 | 7.8 | 9.8 | 3.5 | 6.4 | 14.2 | 1.97 | 1.25 | https://www.onsemi.com/download/data-sheet/pdf/fdd10an06a0-d.pdf | PASS
DMN6017SK3 | Diodes Incorporated | TO252 (DPAK) | 60 | 43 | No |  | 10 | 18 | 55 | 8.5 | 6.2 |  |  | 11.6 | 4.74137931 | 1 | https://www.diodes.com/assets/Datasheets/DMN6017SK3.pdf | PASS
DI020N06D1 | Diotec Semiconductor | TO-252AA | 60 | 20 | No |  | 10 | 35 | 25.3 | 6.1 | 4.7 |  |  | 8.45 | 2.99408284 | 1.2 | https://diotec.com/request/datasheet/di020n06d1.pdf | PASS
GSFD6016 | GOOD-ARK SEMICONDUCTOR | TO-252 (DPAK) | 60 | 60 | No |  | 10 | 13 | 52 | 12 | 11 |  |  | 17.5 | 2.971428571 | 1.3 | https://goodarksemi.com/docs/datasheets/mosfets/GSFD6016.pdf | PASS
GT025N06AK | GOFORD | TO-252 | 60 | 170 | No |  | 10 | 2.5 | 102 | 23 | 14 |  |  | 30 | 3.4 | 1.2 | https://www.gofordsemi.com/upload/cn/propdf/GT025N06AK.pdf | PASS
VTR06N750LSA | Viitor Semiconductor | TO-252 | 60 | 12 | No |  | 10 | 75 | 8.6 | 1.2 | 1.8 |  |  | 2.1 | 4.095238095 | 1.2 | https://viitorsemi.com/wp-content/uploads/VTR06N750LSA_datasheet.pdf | PASS
VTR06N340LSA | Viitor Semiconductor | TO-252 | 60 | 20 | No |  | 10 | 34 | 19 | 2.6 | 4.3 |  |  | 4.75 | 4 | 1.3 | https://viitorsemi.com/wp-content/uploads/VTR06N340LSA_datasheet.pdf | PASS
VTR06N180LSA | Viitor Semiconductor | TO-252 | 60 | 38 | No |  | 10 | 18 | 37 | 5 | 8 |  |  | 9 | 4.111111111 | 1.2 | https://viitorsemi.com/wp-content/uploads/VTR06N180LSA_datasheet.pdf | PASS
DMN6068LK3 | Diodes Incorporated | TO252 | 60 | 8.5 | No |  | 10 | 68 | 10.3 | 3.5 | 1.6 |  |  | 4.3 | 2.395348837 | 1.15 | https://www.diodes.com/assets/Datasheets/DMN6068LK3.pdf | PASS
DMTH6016LK3 | Diodes Incorporated | TO252 (DPAK) | 60 | 46.9 | No |  | 10 | 17 | 17 | 4.3 | 3.1 |  |  | 5.85 | 2.905982906 | 1.2 | https://www.diodes.com/assets/Datasheets/DMTH6016LK3.pdf | PASS
DMTH6005LK3Q | Diodes Incorporated | TO252 (DPAK) | 60 | 90 | No |  | 10 | 5.6 | 47.1 | 12.5 | 10.2 |  |  | 17.6 | 2.676 | 1.2 | https://www.diodes.com/datasheet/download/DMTH6005LK3Q.pdf | PASS
IRLR014 | Vishay Siliconix | DPAK (TO-252) | 60 | 7.7 | Yes | 10 | 5 | 200 | 8.4 | 6 | 3.5 |  |  | 7.75 | 1.083870968 | 1.6 | https://www.vishay.com/docs/91321/sihlr014.pdf | REJECT: Low Vgs (10.0V < 18V)
IRLR014 | Vishay Siliconix | DPAK (TO-252) | 60 | 7.7 | Yes | 10 | 5 | 200 | 8.4 | 6 | 3.5 |  |  | 7.75 | 1.08 | 1.6 | https://www.vishay.com/docs/91321/sihlr014.pdf | REJECT: Low Vgs (10.0V < 18V)
MCU80N06A | Micro Commercial Components | DPAK | 60 | 80 | No |  | 10 | 7.5 | 32.4 | 5.6 | 5.2 |  |  | 8.2 | 3.951219512 | 1.2 | https://www.mccsemi.com/pdf/Products/MCU80N06A(DPAK).pdf | PASS
DMTH6010LK3 | Diodes Incorporated | TO252 | 60 | 70 | No |  | 10 | 8 | 41.3 | 8.8 | 6 |  |  | 11.8 | 3.5 | 1.2 | https://www.diodes.com/assets/Datasheets/DMTH6010LK3.pdf | PASS
RD3L04BBKHRB | ROHM Semiconductor | TO-252 | 60 | 40 | No |  | 10 | 13.5 | 13 | 2.4 | 2.1 |  |  | 3.45 | 3.768115942 | 1.5 | https://fscdn.rohm.com/en/products/databook/datasheet/discrete/transistor/mosfet/rd3l04bbkhrbtl-e.pdf | PASS
STD30NF06 | STMicroelectronics | IPAK/DPAK | 60 | 28 | No |  | 10 | 28 | 43 | 15 | 9.5 |  |  | 19.75 | 2.17721519 | 1.5 | https://www.st.com/content/ccc/resource/technical/document/datasheet/e1/75/62/2a/23/6b/4a/2b/CD00002891.pdf/files/CD00002891.pdf/jcr:content/translations/en.C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 | PASS
DMN3011LSSQ | Diodes Incorporated | SO-8 | 30 | 11 | No |  | 10 | 10 | 19.7 | 1.4 | 3.8 |  |  | 3.3 | 5.96969697 | 1 | https://www.mouser.com/datasheet/3/175/1/DMN3011LSSQ.pdf | PASS
DMC3028LSDXQ | Diodes Incorporated | SO-8 | 30 | 7.2 | No |  | 10 | 27 | 13.2 | 2.2 | 1.7 |  |  | 3.05 | 4.327868852 | 1.2 | https://www.mouser.com/datasheet/3/175/1/DMC3028LSDXQ.pdf | REJECT: Low Id (7.2A < 7.5A)
DMG4466SSSL | Diodes Incorporated | SO-8 | 30 | 10 | No |  | 10 | 23 | 10.5 | 1.6 | 1.8 |  |  | 2.5 | 4.2 | 1 | https://www.mouser.com/datasheet/3/175/1/ds32244.pdf | PASS
BSO220N03MD G | Infineon | PG-DSO-8 | 30 | 7.7 | No |  | 10 | 22 | 7.8 | 0.9 | 1.8 | 1 |  | 1.7 | 4.588235294 | 1.1 | https://www.mouser.com/datasheet/3/70/1/BSO220N03MD_rev1.1.pdf | PASS
ZXMC3A16DN8 | Zetex | SO8 | 30 | 6.4 | No |  | 10 | 35 | 17.5 | 3.1 | 2.3 |  |  | 4.25 | 4.117647059 | 0.95 | https://www.mouser.com/datasheet/3/175/1/ZXMC3A16DN8.pdf | REJECT: Low Id (6.4A < 7.5A)
DMHC3025LSD | Diodes Incorporated | SO-8 | 30 | 6 | No |  | 10 | 25 | 11.7 | 2.1 | 1.8 |  |  | 3 | 3.9 | 1.2 | https://www.mouser.com/datasheet/3/175/1/DMHC3025LSD.pdf | REJECT: Low Id (6.0A < 7.5A)
ZXMC3A16DN8 | Zetex | SO8 | 30 | 6.4 | No |  | 10 | 35 | 17.5 | 3.1 | 2.3 |  |  | 4.25 | 4.117647059 | 0.95 | https://www.mouser.com/datasheet/3/175/1/ZXMC3A16DN8.pdf | REJECT: Low Id (6.4A < 7.5A)
IRF7319PbF | International Rectifier | SO-8 | 30 | 6.5 | No |  | 10 | 29 | 22 | 6.4 | 2.6 |  |  | 7.7 | 2.857 | 1 | https://www.mouser.com/datasheet/3/70/1/Infineon_IRF7319_DataSheet_v01_01_EN.pdf | REJECT: Low Id (6.5A < 7.5A)
IRF7389PbF | International Rectifier | SO-8 | 30 | 7.3 | No |  | 10 | 29 | 22 | 6.4 | 2.6 |  |  | 7.7 | 2.857142857 | 1 | https://www.mouser.com/datasheet/3/70/1/Infineon_IRF7389_DataSheet_v01_01_EN.pdf | REJECT: Low Id (7.3A < 7.5A)
DMT3020LSD | Diodes Incorporated | SO-8 | 30 | 16 | No |  | 10 | 20 | 7 | 1.5 | 0.9 |  |  | 1.95 | 3.58974359 | 1.2 | https://www.mouser.com/catalog/specsheets/diodes inc_diod-s-a0005424669-1.pdf | PASS
DMGD7N45SSD | Diodes Incorporated | SO-8 | 450 | 0.5 | No |  | 10 | 4000 | 6.9 | 3.4 | 1.4 |  |  | 4.1 | 1.68 | 1.2 | https://www.mouser.com/datasheet/3/175/1/DMGD7N45SSD.pdf | REJECT: Low Id (0.5A < 7.5A)
ZXMHC3A01N8 | Diodes Incorporated | SO-8 | 30 | 2.72 | No |  | 10 | 125 | 3.9 | 0.9 | 0.6 |  |  | 1.2 | 3.25 | 0.95 | https://www.mouser.com/datasheet/3/175/1/ZXMHC3A01N8.pdf | REJECT: Low Id (2.72A < 7.5A)
IRF7309PbF | International Rectifier | SO-8 | 30 | 4 | No |  | 4.5 | 80 | 25 | 7.9 | 2.9 |  |  | 9.35 | 2.673796791 | 1 | https://www.mouser.com/datasheet/3/70/1/Infineon_IRF7309_DataSheet_v01_01_EN.pdf | REJECT: Low Id (4.0A < 7.5A)
ZXMHC3F381N8 | Diodes Incorporated | SO-8 | 30 | 4.98 | No |  | 10 | 33 | 9 | 2 | 1.7 |  |  | 2.85 | 3.16 | 1.2 | https://www.mouser.com/datasheet/3/175/1/ZXMHC3F381N8.pdf | REJECT: Low Id (4.98A < 7.5A)
DMC3021LSD | Diodes Incorporated | SO-8 | 30 | 8.5 | No |  | 10 | 21 | 16.1 | 2.5 | 1.8 |  |  | 3.4 | 4.735 | 1 | https://www.mouser.com/datasheet/3/175/1/ds32152.pdf | PASS
IRF8788PbF | International Rectifier | SO-8 | 30 | 24 | No |  | 4.5 | 3.8 | 44 | 14 |  | 12 | 4.7 | 18.7 | 2.35 | 1 | https://www.mouser.com/datasheet/3/70/1/Infineon_IRF8788_DataSheet_v01_01_EN.pdf | PASS
IRF7862PbF | International Rectifier | SO-8 | 30 | 21 | No |  | 10 | 3.3 | 30 | 9.8 |  | 7.5 | 3.1 | 12.9 | 2.325581395 | 1 | https://www.mouser.com/datasheet/3/70/1/Infineon_IRF7862_DataSheet_v01_01_EN.pdf | PASS
IRF7907PbF | International Rectifier | SO-8 | 30 | 9.1 | No |  | 10 | 16.4 | 6.7 | 2.5 |  | 1.3 | 0.7 | 3.2 | 2.09 | 1 | https://www.mouser.com/datasheet/3/70/1/Infineon_IRF7907_DataSheet_v01_01_EN.pdf | PASS
IRF8734PbF | International Rectifier | SO-8 | 30 | 21 | No |  | 10 | 3.5 | 20 | 6.9 |  | 5.2 | 2.3 | 9.2 | 2.1739 | 1 | https://www.mouser.com/datasheet/3/70/1/Infineon_IRF8734_DataSheet_v01_01_EN.pdf | PASS
IRF8736PbF | International Rectifier | SO-8 | 30 | 18 | No |  | 10 | 4.8 | 17 | 5.8 |  | 4.4 | 1.9 | 7.7 | 2.207792208 | 1 | https://www.mouser.com/datasheet/3/70/1/Infineon-IRF8736-DataSheet-v01_01-EN.pdf | PASS
IRF7451PbF | International Rectifier | SO-8 | 150 | 3.6 | No |  | 10 | 90 | 28 | 13 | 6.8 |  |  | 16.4 | 1.7073 | 1.3 | https://www.mouser.com/datasheet/3/70/1/Infineon-IRF7451-DataSheet-v01_01-EN.pdf | REJECT: Low Id (3.6A < 7.5A)
DMN3024LSS | Diodes Incorporated | SO-8 | 30 | 8.5 | No |  | 10 | 24 | 12.9 | 2.5 | 2.5 |  |  | 3.75 | 3.44 | 1.2 | https://www.mouser.com/datasheet/3/175/1/DMN3024LSS.pdf | PASS
ZXMN3B04N8 | Diodes Incorporated | SO-8 | 30 | 8.9 | Yes | 12 | 4.5 | 25 | 23.1 | 6.2 | 4.9 |  |  | 8.65 | 2.67052 | 0.95 | https://www.mouser.com/datasheet/3/175/1/ZXMN3B04N8.pdf | REJECT: Low Vgs (12.0V < 18V)
DMHC3025LSD | Diodes Incorporated | SO-8 | 30 | 6 | No |  | 10 | 25 | 11.7 | 2.1 | 1.8 |  |  | 3 | 3.9 | 1.2 | https://www.mouser.com/datasheet/3/175/1/DMHC3025LSD.pdf | REJECT: Low Id (6.0A < 7.5A)
IRF9952PbF | International Rectifier | SO-8 | 30 | 3.5 | No |  | 10 | 100 | 6.9 | 1.8 | 1 |  |  | 2.3 | 3 | 1.2 | https://www.mouser.com/datasheet/3/70/1/Infineon_IRF9952_DataSheet_v01_01_EN.pdf | REJECT: Low Id (3.5A < 7.5A)
IRF7832PbF | International Rectifier | SO-8 | 30 | 20 | No |  | 10 | 4 | 34 | 12 |  | 8.6 | 2.9 | 14.9 | 2.28 | 1 | https://www.mouser.com/datasheet/3/70/1/Infineon_IRF7832_DataSheet_v01_01_EN.pdf | PASS
DMN3018SSS | Diodes Incorporated | SO-8 | 30 | 7.3 | No |  | 10 | 21 | 13.2 | 1.8 | 2.2 |  |  | 2.9 | 4.55 | 1.2 | https://www.mouser.com/datasheet/3/175/1/DMN3018SSS.pdf | REJECT: Low Id (7.3A < 7.5A)
DMC3028LSD | Diodes Incorporated | SO-8 | 30 | 7.1 | No |  | 10 | 28 | 10.5 | 2.3 | 1.86 |  |  | 3.23 | 3.25 | 1.2 | https://www.mouser.com/datasheet/3/175/1/DMC3028LSD.pdf | REJECT: Low Id (7.1A < 7.5A)
DMN3024LSD | Diodes Incorporated | SO-8 | 30 | 7.2 | No |  | 10 | 24 | 12.9 | 2.5 | 2.5 |  |  | 3.75 | 3.44 | 1.2 | https://www.mouser.com/datasheet/3/175/1/DMN3024LSD.pdf | REJECT: Low Id (7.2A < 7.5A)
ZXMN3F31DN8 | Zetex Semiconductors | SO8 | 30 | 7.3 | No |  | 10 | 24 | 12.9 | 2.52 | 2.5 |  |  | 3.77 | 3.42 | 1.2 | https://www.mouser.com/datasheet/3/175/1/ZXMN3F31DN8.pdf | REJECT: Low Id (7.3A < 7.5A)
DMN3033LSD | Diodes Incorporated | SO-8 | 30 | 6.9 | No |  | 10 | 20 | 13 | 3.2 | 1.9 |  |  | 4.15 | 3.13 | 1.2 | https://www.mouser.com/datasheet/3/175/1/ds31262.pdf | REJECT: Low Id (6.9A < 7.5A)
DMG4466SSS | Diodes Incorporated | SO-8 | 30 | 10 | No |  | 10 | 23 | 10.5 | 1.6 | 1.8 |  |  | 2.5 | 4.2 | 1 | https://www.mouser.com/datasheet/3/175/1/ds32137.pdf | PASS
DMN4800LSSL | Diodes Incorporated | SO-8 | 30 | 8 | No |  | 10 | 14 | 8.7 | 2.4 | 1.7 |  |  | 3.25 | 2.676923077 | 0.94 | https://www.mouser.com/datasheet/3/175/1/DMN4800LSSL.pdf | PASS
DMG4822SSD | Diodes Incorporated | SO-8 | 30 | 10 | No |  | 10 | 20 | 10.5 | 1.6 | 1.8 |  |  | 2.5 | 4.2 | 1 | https://www.mouser.com/datasheet/3/175/1/DMG4822SSD.pdf | PASS
DMN3010LSS | Diodes Incorporated | SOP-8L | 30 | 16 | No |  | 10 | 9 | 43.7 | 12.6 | 5.5 |  |  | 15.35 | 2.846905537 | 1.2 | https://www.mouser.com/datasheet/3/175/1/ds31259.pdf | PASS
DMN3025LSS | Diodes Incorporated | SO-8 | 30 | 7.2 | No |  | 10 | 20 | 13.2 | 2.2 | 1.7 |  |  | 3.05 | 4.327868852 | 1 | https://www.mouser.com/datasheet/3/175/1/DMN3025LSS.pdf | REJECT: Low Id (7.2A < 7.5A)
DMC3028LSDX | Diodes Incorporated | SO-8 | 30 | 7.2 | No |  | 10 | 27 | 13.2 | 2.2 | 1.7 |  |  | 3.05 | 4.327868852 | 1.2 | https://www.mouser.com/datasheet/3/175/1/DMC3028LSDX.pdf | REJECT: Low Id (7.2A < 7.5A)
DMC3032LSD | Diodes Incorporated | SO-8 | 30 | 8.1 | No |  | 10 | 32 | 9.2 | 1.8 | 1.2 |  |  | 2.4 | 3.833333333 | 1 | https://www.mouser.com/datasheet/3/175/1/ds32153.pdf | PASS
DMC3021LSD | Diodes Incorporated | SO-8 | 30 | 8.5 | No |  | 10 | 21 | 16.1 | 2.5 | 1.8 |  |  | 3.4 | 4.74 | 1 | https://www.mouser.com/datasheet/3/175/1/ds32152.pdf | PASS
ZXMN3G32DN8 | Zetex Semiconductors | SO8 | 30 | 7.1 | No |  | 10 | 28 | 10.5 | 2.3 | 1.86 |  |  | 3.23 | 3.25 | 1.2 | https://www.mouser.com/datasheet/3/175/1/ZXMN3G32DN8.pdf | REJECT: Low Id (7.1A < 7.5A)
ZXMN3A04DN8 | Zetex | SO8 | 30 | 8.5 | No |  | 10 | 20 | 36.8 | 7.1 | 5.8 |  |  | 10 | 3.68 | 0.95 | https://www.mouser.com/datasheet/3/175/1/ZXMN3A04DN8.pdf | PASS
ZXMN3A06DN8 | Zetex | SO8 | 30 | 6.2 | No |  | 10 | 35 | 17.5 | 3.1 | 2.3 |  |  | 4.25 | 4.117647059 | 0.95 | https://www.mouser.com/datasheet/3/175/1/ZXMN3A06DN8.pdf | REJECT: Low Id (6.2A < 7.5A)
DMC3025LSD | Diodes Incorporated | SO-8 | 30 | 8.5 | No |  | 10 | 20 | 9.8 | 2 | 1.6 |  |  | 2.8 | 3.5 | 1.2 | https://www.mouser.com/datasheet/3/175/1/DMC3025LSD.pdf | PASS
ZXMC3F31DN8 | Diodes Incorporated | SO-8 | 30 | 7.3 | No |  | 10 | 24 | 12.9 | 2.52 | 2.5 |  |  | 3.77 | 3.42175 | 1.2 | https://www.mouser.com/datasheet/3/175/1/ZXMC3F31DN8.pdf | REJECT: Low Id (7.3A < 7.5A)
DMC3026LSD | Diodes Incorporated | SO-8 | 30 | 6.5 | No |  | 10 | 25 | 13.2 | 2.2 | 1.7 |  |  | 3.05 | 4.327868852 | 1.2 | https://www.mouser.com/datasheet/3/175/1/DMC3026LSD.pdf | REJECT: Low Id (6.5A < 7.5A)
ZXMC3A17DN8 | Zetex | SO8 | 30 | 5.4 | No |  | 10 | 50 | 12.2 | 2.4 | 1.7 |  |  | 3.25 | 3.75 | 0.95 | https://www.mouser.com/datasheet/3/175/1/ZXMC3A17DN8.pdf | REJECT: Low Id (5.4A < 7.5A)
DMN4468LSS | Diodes Incorporated | SO-8 | 30 | 10 | No |  | 10 | 14 | 18.85 | 6.15 | 2.59 |  |  | 7.445 | 2.531900604 | 0.95 | https://www.mouser.com/datasheet/3/175/1/ds31773.pdf | PASS
DMN4800LSS | Diodes Incorporated | SO-8 | 30 | 8.6 | No |  | 10 | 14 | 8.7 | 2.4 | 1.7 |  |  | 3.25 | 2.676923077 | 0.94 | https://www.mouser.com/datasheet/3/175/1/ds31736.pdf | PASS
DMN4800LSSQ | Diodes Incorporated | SO-8 | 30 | 8.6 | No |  | 10 | 14 | 8.7 | 2.4 | 1.7 |  |  | 3.25 | 2.676923077 | 0.94 | https://www.mouser.com/datasheet/3/175/1/DMN4800LSSQ.pdf | PASS
BSO150N03MD G | Infineon | PG-DSO-8 | 30 | 9.3 | No |  | 10 | 15 | 12.6 | 1.4 | 2.8 | 1.5 |  | 2.6 | 4.846153846 | 1.1 | https://www.mouser.com/datasheet/3/70/1/BSO150N03MD_rev1.1.pdf | PASS
BSO150N03MD G | Infineon | PG-DSO-8 | 30 | 9.3 | No |  | 10 | 15 | 12.6 | 1.4 | 2.8 | 1.5 |  | 2.6 | 4.846153846 | 1.1 | https://www.mouser.com/datasheet/3/70/1/BSO150N03MD_rev1.1.pdf | PASS
DMHC4035LSD | Diodes Incorporated | SO-8 | 40 | 4.5 | No |  | 10 | 45 | 12.5 | 2.2 | 1.7 |  |  | 3.05 | 4.098360656 | 1 | https://www.mouser.com/datasheet/3/175/1/DMHC4035LSD.pdf | REJECT: Low Id (4.5A < 7.5A)
DMT3020LSDQ | Diodes Incorporated | SO-8 | 30 | 16 | No |  | 10 | 20 | 7 | 1.5 | 0.9 |  |  | 1.95 | 3.58974359 | 1.2 | https://www.mouser.com/datasheet/3/175/1/DMT3020LSDQ.pdf | PASS
DMN3018SSD | Diodes Incorporated | SO-8 | 30 | 6.7 | No |  | 10 | 22 | 13.2 | 1.8 | 2.2 |  |  | 2.9 | 4.5517 | 1.2 | https://www.mouser.com/datasheet/3/175/1/DMN3018SSD.pdf | REJECT: Low Id (6.7A < 7.5A)
DMN3016LSS | Diodes Incorporated | SO-8 | 30 | 10.3 | No |  | 10 | 12 | 25.1 | 3.6 | 3.5 |  |  | 5.35 | 4.691588785 | 1 | https://www.mouser.com/datasheet/3/175/1/DMN3016LSS.pdf | PASS
DMN3015LSD | Diodes Incorporated | SO-8 | 30 | 8.4 | No |  | 10 | 15 | 25.1 | 3.6 | 3.5 |  |  | 5.35 | 4.691588785 | 1 | https://www.mouser.com/datasheet/3/175/1/DMN3015LSD.pdf | PASS
DMN3033LSDQ | Diodes Incorporated | SO-8 | 30 | 6.9 | No |  | 10 | 20 | 13 | 3.2 | 1.9 |  |  | 4.15 | 3.13253012 | 1.2 | https://www.mouser.com/datasheet/3/175/1/DMN3033LSDQ.pdf | REJECT: Low Id (6.9A < 7.5A)
DMC3016LSD | Diodes Incorporated | SO-8 | 30 | 8.2 | No |  | 10 | 16 | 25.1 | 3.6 | 3.5 |  |  | 5.35 | 4.69 | 1 | https://www.mouser.com/datasheet/3/175/1/DMC3016LSD.pdf | PASS
DMN3011LSS | Diodes Incorporated | SO-8 | 30 | 11 | No |  | 10 | 10 | 19.7 | 1.4 | 3.8 |  |  | 3.3 | 5.96969697 | 1 | https://www.mouser.com/datasheet/3/175/1/DMN3011LSS.pdf | PASS
CWDM3011N | Central Semiconductor | SOIC-8 | 30 | 11 | No |  | 10 | 20 | 6.3 | 2.3 | 2 |  |  | 3.3 | 1.909090909 | 1.2 | https://www.mouser.com/datasheet/3/312/1/CWDM3011N.pdf | PASS
CWDM305ND | Central Semiconductor | SOIC-8 | 30 | 5.8 | No |  | 10 | 30 | 4.2 | 1.4 | 0.9 |  |  | 1.85 | 2.27 | 1.2 | https://www.mouser.com/datasheet/3/312/1/CWDM305ND.pdf | REJECT: Low Id (5.8A < 7.5A)
DMN39M1LSS | Diodes Incorporated | SO-8 | 30 | 15 | No |  | 10 | 5.5 | 42 | 7 | 7 |  |  | 10.5 | 4 | 1.2 | https://www.mouser.com/datasheet/3/175/1/DMN39M1LSS.pdf | PASS
CWDM305N | Central Semiconductor | SOIC-8 | 30 | 5.8 | No |  | 10 | 30 | 4.2 | 1.4 | 0.9 |  |  | 1.85 | 2.27 | 1.2 | https://www.mouser.com/datasheet/3/312/1/CWDM305N.pdf | REJECT: Low Id (5.8A < 7.5A)
DMN39M1LSSQ | Diodes Incorporated | SO-8 | 30 | 15 | No |  | 10 | 5.5 | 42 | 7 | 7 |  |  | 10.5 | 4 | 1.2 | https://www.mouser.com/datasheet/3/175/1/DMN39M1LSSQ.pdf | PASS
BSO110N03MS G | Infineon | PG-DSO-8 | 30 | 12.1 | No |  | 10 | 11 | 15 | 1.6 | 3.4 | 1.8 |  | 3.1 | 4.838709677 | 1.1 | https://www.mouser.com/datasheet/3/70/1/Infineon-BSO110N03MS-DS-v01_01-en.pdf | PASS
BSO110N03MS G | Infineon | PG-DSO-8 | 30 | 12.1 | No |  | 10 | 11 | 15 | 1.6 | 3.4 | 1.8 |  | 3.1 | 4.838709677 | 1.1 | https://www.mouser.com/datasheet/3/70/1/Infineon-BSO110N03MS-DS-v01_01-en.pdf | PASS
BSO033N03MS G | Infineon | PG-DSO-8 | 30 | 22 | No |  | 10 | 3.3 | 93 | 9.6 | 19 |  |  | 17 | 5.47 | 1 | https://www.mouser.com/datasheet/3/70/1/BSO033N03MS_rev1.1.pdf | PASS
BSO220N03MD G | Infineon | PG-DSO-8 | 30 | 7.7 | No |  | 10 | 22 | 7.8 | 0.9 | 1.8 | 1 |  | 1.7 | 4.59 | 1.1 | https://www.mouser.com/datasheet/3/70/1/BSO220N03MD_rev1.1.pdf | PASS
BSO040N03MS G | Infineon | PG-DSO-8 | 30 | 20 | No |  | 10 | 4 | 55 | 5.8 | 11.4 |  |  | 10.4 | 5.288461538 | 1.1 | https://www.mouser.com/datasheet/3/70/1/BSO040N03MS_rev1.1.pdf | PASS
BSO033N03MS G | Infineon | PG-DSO-8 | 30 | 22 | No |  | 10 | 3.3 | 93 | 9.6 | 19 |  |  | 17 | 5.47 | 1 | https://www.mouser.com/datasheet/3/70/1/BSO033N03MS_rev1.1.pdf | PASS
IRF7465PbF | International Rectifier | SO-8 | 150 | 1.9 | No |  | 10 | 280 | 10 | 5 | 2.7 |  |  | 6.35 | 1.57480315 | 1.3 | https://www.mouser.com/datasheet/3/70/1/Infineon_IRF7465_DataSheet_v01_01_EN.pdf | REJECT: Low Id (1.9A < 7.5A)
DMN4034SSS | Diodes Incorporated | SO-8 | 40 | 7.2 | No |  | 10 | 34 | 10 | 2.4 | 1.8 |  |  | 3.3 | 3.03030303 | 1.1 | https://www.mouser.com/datasheet/3/175/1/DMN4034SSS.pdf | REJECT: Low Id (7.2A < 7.5A)
DMN4034SSD | Diodes Incorporated | SO-8 | 40 | 6.3 | No |  | 10 | 34 | 10 | 2.4 | 1.8 |  |  | 3.3 | 3.03 | 1.1 | https://www.mouser.com/datasheet/3/175/1/DMN4034SSD.pdf | REJECT: Low Id (6.3A < 7.5A)
DMC4050SSDQ | Diodes Incorporated | SO-8 | 40 | 5.8 | No |  | 10 | 45 | 37.56 | 6.6 | 7.8 |  |  | 10.5 | 3.577142857 | 1 | https://www.mouser.com/datasheet/3/175/1/DMC4050SSDQ.pdf | REJECT: Low Id (5.8A < 7.5A)
NVMFS5C450NL | onsemi | DFN5 (SO-8FL) | 40 | 110 | No |  | 10 | 2.8 | 35 | 5 | 7 |  |  | 8.5 | 4.117647059 | 1.2 | https://www.mouser.com/datasheet/3/101/1/NVMFS5C450NL-D.PDF | PASS
DMC4015SSD | Diodes Incorporated | SO-8 | 40 | 12.2 | No |  | 10 | 15 | 40 | 6.3 | 5.5 |  |  | 9.05 | 4.419889503 | 1 | https://www.mouser.com/datasheet/3/175/1/DMC4015SSD.pdf | PASS
DMN4026SSD | Diodes Incorporated | SO-8 | 40 | 9 | No |  | 10 | 24 | 19.1 | 2.5 | 3 |  |  | 4 | 4.775 | 1 | https://www.mouser.com/datasheet/3/175/1/DMN4026SSD.pdf | PASS
DMNH4026SSD | Diodes Incorporated | SO-8 | 40 | 7.5 | No |  | 10 | 24 | 19.1 | 2.5 | 3 |  |  | 4 | 4.775 | 1 | https://www.mouser.com/datasheet/3/175/1/DMNH4026SSD.pdf | PASS
DMC4040SSD | Diodes Incorporated | SO-8 | 40 | 7.5 | No |  | 10 | 25 | 37.6 | 6.6 | 7.8 |  |  | 10.5 | 3.580952381 | 1 | https://www.mouser.com/datasheet/3/175/1/DMC4040SSD.pdf | PASS
DMN4026SSD | Diodes Incorporated | SO-8 | 40 | 9 | No |  | 10 | 24 | 19.1 | 2.5 | 3 |  |  | 4 | 4.775 | 1 | https://www.mouser.com/datasheet/3/175/1/DMN4026SSD.pdf | PASS
DMN4031SSD | Diodes Incorporated | SO-8 | 40 | 7 | No |  | 10 | 31 | 18.6 | 2.2 | 3.3 |  |  | 3.85 | 4.83 | 1 | https://www.mouser.com/datasheet/3/175/1/DMN4031SSD.pdf | REJECT: Low Id (7.0A < 7.5A)
DMC4029SSD | Diodes Incorporated | SO-8 | 40 | 9 | No |  | 10 | 24 | 19.1 | 2.5 | 3 |  |  | 4 | 4.775 | 1 | https://www.mouser.com/datasheet/3/175/1/DMC4029SSD.pdf | PASS
IRF7842PbF | International Rectifier | SO-8 | 40 | 18 | No |  | 4.5 | 5.9 | 33 | 10 |  | 9.6 | 2.8 | 12.8 | 2.578125 | 1 | https://www.mouser.com/datasheet/3/70/1/Infineon-IRF7842-DataSheet-v01_01-EN.pdf | PASS
DMC4029SSD | Diodes Incorporated | SO-8 | 40 | 9 | No |  | 10 | 24 | 19.1 | 2.5 | 3 |  |  | 4 | 4.775 | 1 | https://www.mouser.com/datasheet/3/175/1/DMC4029SSD.pdf | PASS
DMC4047LSD | Diodes Incorporated | SO-8 | 40 | 7 | No |  | 10 | 24 | 19.1 | 2.5 | 3 |  |  | 4 | 4.775 | 1 | https://www.mouser.com/datasheet/3/175/1/DMC4047LSD.pdf | REJECT: Low Id (7.0A < 7.5A)
DMNH4026SSDQ | Diodes Incorporated | SO-8 | 40 | 7.5 | No |  | 10 | 24 | 19.1 | 2.5 | 3 |  |  | 4 | 4.775 | 1 | https://www.mouser.com/datasheet/3/175/1/DMNH4026SSDQ.pdf | PASS
TK1R4S04PB | Toshiba | DPAK+ | 40 | 120 | No |  | 10 | 1.35 | 103 | 24 |  | 30 |  | 39 | 2.64 | 1.2 | https://www.mouser.com/datasheet/3/105/1/4ED7E8508E8DF7939F699D77C94349E33B40F5FCCC0694563DF63EE828BA7124.pdf | PASS
TK65S04N1L | Toshiba | DPAK+ | 40 | 65 | No |  | 10 | 4.3 | 39 | 7 |  | 9 |  | 11.5 | 3.39 | 1.2 | https://www.mouser.com/datasheet/3/105/1/F9DF81C56B072210464F76629D735EB43B140D6467D2133DA89D1DAAE6E2C954.pdf | PASS
IPD029N04NF2S | Infineon | PG-TO252-3 | 40 | 131 | No |  | 10 | 2.9 | 45 | 8.6 | 14 |  |  | 14 | 3.214285714 | 1.1 | https://www.mouser.com/datasheet/3/70/1/Infineon_IPD029N04NF2S_DataSheet_v02_00_EN.pdf | PASS
IPD50N04S3-08 | Infineon | PG-TO252-3-11 | 40 | 50 | No |  | 10 | 7.5 | 27 | 7 | 10 |  |  | 12 | 2.25 | 1.3 | https://www.mouser.com/datasheet/3/70/1/Infineon_IPD50N04S3_08_DS_v01_00_en.pdf | PASS
IPD50N04S4-08 | Infineon | PG-TO252-3-313 | 40 | 50 | No |  | 10 | 7.9 | 17.2 | 2.4 | 8 |  |  | 6.4 | 2.6875 | 1.3 | https://www.mouser.com/datasheet/3/70/1/Infineon_IPD50N04S4_08_DS_v01_00_en.pdf | PASS
IPD90N04S4L-04 | Infineon | PG-TO252-3-313 | 40 | 90 | No |  | 10 | 3.8 | 46 | 5 | 12 |  |  | 11 | 4.18 | 1.3 | https://www.mouser.com/datasheet/3/70/1/Infineon_IPD90N04S4L_04_DS_v01_00_en.pdf | PASS
TK65S04N1L | Toshiba | DPAK+ | 40 | 65 | No |  | 10 | 4.3 | 39 | 7 |  | 9 |  | 11.5 | 3.39 | 1.2 | https://www.mouser.com/datasheet/3/105/1/F9DF81C56B072210464F76629D735EB43B140D6467D2133DA89D1DAAE6E2C954.pdf | PASS
IPD90N03S4L-02 | Infineon | PG-TO252-3-11 | 30 | 90 | Yes | 16 | 10 | 2.2 | 110 | 14 | 22 |  |  | 25 | 4.4 | 1.3 | https://www.mouser.com/datasheet/3/70/1/Infineon_IPD90N03S4L_02_DS_v03_00_en.pdf | REJECT: Low Vgs (16.0V < 18V)
IPD50N04S4-08 | Infineon | PG-TO252-3-313 | 40 | 50 | No |  | 10 | 7.9 | 17.2 | 2.4 | 8 |  |  | 6.4 | 2.6875 | 1.3 | https://www.mouser.com/datasheet/3/70/1/Infineon_IPD50N04S4_08_DS_v01_00_en.pdf | PASS
IPD90N04S4-03 | Infineon | PG-TO252-3-313 | 40 | 90 | No |  | 10 | 3.2 | 51 | 7 | 24 |  |  | 19 | 2.68 | 1.3 | https://www.mouser.com/datasheet/3/70/1/Infineon-IPD90N04S4_03-DS-v01_00-en.pdf | PASS
IPD90N04S4-04 | Infineon | PG-TO252-3-313 | 40 | 90 | No |  | 10 | 4.1 | 33 | 5 | 16 |  |  | 13 | 2.54 | 1.3 | https://www.mouser.com/datasheet/3/70/1/Infineon_IPD90N04S4_04_DS_v01_00_en.pdf | PASS
TK100S04N1L | Toshiba | DPAK+ | 40 | 100 | No |  | 10 | 2.3 | 76 | 11 |  | 18 |  | 20 | 3.8 | 1.2 | https://www.mouser.com/datasheet/3/105/1/AEF06CA61D88E63BBEF217D36C29B50149EF6D7ED6A6E85EB5365CBBC20D88D6.pdf | PASS
IPD100N04S4-02 | Infineon | PG-TO252-3-313 | 40 | 100 | No |  | 10 | 2 | 91 | 12 | 39 |  |  | 31.5 | 2.888888889 | 1.3 | https://www.mouser.com/datasheet/3/70/1/Infineon-IPD100N04S4_02-DS-v01_00-en.pdf | PASS
IPD30N03S4L-14 | Infineon | PG-TO252-3-11 | 30 | 30 | Yes | 16 | 10 | 13.6 | 11 | 1.4 | 2.2 |  |  | 2.5 | 4.4 | 1.3 | https://www.mouser.com/datasheet/3/70/1/Infineon_IPD30N03S4L_14_DS_v02_01_en.pdf | REJECT: Low Vgs (16.0V < 18V)
IPD50N03S4L-06 | Infineon | PG-TO252-3-11 | 30 | 50 | Yes | 16 | 10 | 5.5 | 24 | 3 | 6 |  |  | 6 | 4 | 1.3 | https://www.mouser.com/datasheet/3/70/1/Infineon_IPD50N03S4L_06_DS_v01_01_en.pdf | REJECT: Low Vgs (16.0V < 18V)
IPD90N04S4-02 | Infineon | PG-TO252-3-313 | 40 | 90 | No |  | 10 | 2.4 | 91 | 12 | 39 |  |  | 31.5 | 2.888888889 | 1.3 | https://www.mouser.com/datasheet/3/70/1/Infineon_IPD90N04S4_02_DS_v01_00_en.pdf | PASS
IPD90N04S4-05 | Infineon | PG-TO252-3-313 | 40 | 86 | No |  | 10 | 5.2 | 29 | 4 | 14 |  |  | 11 | 2.636363636 | 1.3 | https://www.mouser.com/datasheet/3/70/1/Infineon-IPD90N04S4_05-DS-v01_00-en.pdf | PASS
IPD90N03S4L-02 | Infineon | PG-TO252-3-11 | 30 | 90 | Yes | 16 | 10 | 2.2 | 110 | 14 | 22 |  |  | 25 | 4.4 | 1.3 | https://www.mouser.com/datasheet/3/70/1/Infineon_IPD90N03S4L_02_DS_v03_00_en.pdf | REJECT: Low Vgs (16.0V < 18V)
TK15S04N1L | Toshiba | DPAK+ | 40 | 15 | No |  | 10 | 17.8 | 10 | 2 |  | 2 |  | 3 | 3.33 | 1.2 | https://www.mouser.com/datasheet/3/105/1/0285F1B20A2A6E5C043DFF1DD56BE878A5BD6AB206BA4715BDB658ED14904609.pdf | PASS
TK15S04N1L | Toshiba | DPAK+ | 40 | 15 | No |  | 10 | 17.8 | 10 | 2 |  | 2 |  | 3 | 3.33 | 1.2 | https://www.mouser.com/datasheet/3/105/1/0285F1B20A2A6E5C043DFF1DD56BE878A5BD6AB206BA4715BDB658ED14904609.pdf | PASS
IRFR7446PbF | International Rectifier | D-PAK | 40 | 120 | No |  | 10 | 3.9 | 65 | 22 | 18 |  |  | 31 | 2.09677 | 1.3 | https://www.mouser.com/datasheet/3/70/1/Infineon-IRFR7446-DataSheet-v01_01-EN.pdf | PASS
IPD023N04NF2S | Infineon | PG-TO252-3 | 40 | 143 | No |  | 10 | 2.3 | 68 | 13 | 21 |  |  | 20 | 3.4 | 1.1 | https://www.mouser.com/datasheet/3/70/1/Infineon_IPD023N04NF2S_DataSheet_v02_01_EN.pdf | PASS
NP90N04VLK | Renesas | TO-252 (MP-3ZP) | 40 | 90 | Yes | 20 | 10 | 2.8 | 68 | 11 | 17 |  |  | 19.5 | 3.487179487 | 1.5 | https://www.mouser.com/datasheet/3/1166/1/REN_r07ds1236ej0200_pomosfet_DST_20180524_1_1.pdf | PASS
IPD90N04S3-04 | Infineon | PG-TO252-3-11 | 40 | 90 | No |  | 10 | 3.6 | 60 | 15 | 23 |  |  | 26.5 | 2.264150943 | 1.3 | https://www.mouser.com/datasheet/3/70/1/Infineon_IPD90N04S3_04_DS_v01_00_en.pdf | PASS
IRFS7440PbF | International Rectifier | D2-Pak | 40 | 208 | No |  | 10 | 2.5 | 90 | 32 | 23 |  |  | 43.5 | 2.07 | 1.3 | https://www.mouser.com/datasheet/3/70/1/Infineon_IRFS7440_DataSheet_v01_01_EN.pdf | PASS
IPD100N04S4L-02 | Infineon | PG-TO252-3-313 | 40 | 100 | Yes | 20 | 10 | 1.9 | 126 | 13 | 28 |  |  | 27 | 4.666666667 | 1.3 | https://www.mouser.com/datasheet/3/70/1/Infineon-IPD100N04S4L-02-DS-v01_00-EN.pdf | PASS
NP90N04VDK | Renesas | TO-252 (MP-3ZP) | 40 | 90 | Yes | 20 | 10 | 2.8 | 68 | 11 | 17 |  |  | 19.5 | 3.487179487 | 1.5 | https://www.mouser.com/datasheet/3/1166/1/REN_r07ds1017ej0200-pomosfet_DST_20180524.pdf | PASS
IPD90N04S4-03 | Infineon | PG-TO252-3-313 | 40 | 90 | No |  | 10 | 3.2 | 51 | 7 | 24 |  |  | 19 | 2.68 | 1.3 | https://www.mouser.com/datasheet/3/70/1/Infineon-IPD90N04S4_03-DS-v01_00-en.pdf | PASS
TK100S04N1L | Toshiba | DPAK+ | 40 | 100 | No |  | 10 | 2.3 | 76 | 11 |  | 18 |  | 20 | 3.8 | 1.2 | https://www.mouser.com/datasheet/3/105/1/AEF06CA61D88E63BBEF217D36C29B50149EF6D7ED6A6E85EB5365CBBC20D88D6.pdf | PASS
TK3R1P04PL | Toshiba | DPAK | 40 | 58 | No |  | 10 | 3.1 | 60 | 11 |  | 14 |  | 19 | 3.16 | 1.5 | https://www.mouser.com/datasheet/3/105/1/2A5989E50A27FE6F1B9140002B8F7CE92F9B18872DCADAD4CE6D8001C5C9E913.pdf | PASS
IPD70N03S4L-04 | Infineon | PG-TO252-3-11 | 30 | 70 | Yes | 16 | 10 | 4.3 | 37 | 5 | 8 |  |  | 9 | 4.11 | 1.3 | https://www.mouser.com/datasheet/3/70/1/Infineon_IPD70N03S4L_04_DS_v02_01_EN.pdf | REJECT: Low Vgs (16.0V < 18V)
RJF0408JPD | Renesas | DPAK(S) | 40 | 30 | Yes | 16 | 10 | 30 | 0 | 0 |  |  |  | 0 | 0 | 0.9 | https://www.mouser.com/datasheet/3/1166/1/REN_r07ds1133ej0200_rjf0408jpd_DST_20150728_1.pdf | REJECT: Low Vgs (16.0V < 18V)
IRLS3034PbF | International Rectifier | D2Pak | 40 | 343 | Yes | 20 | 4.5 | 2 | 108 | 54 | 29 |  |  | 68.5 | 1.5766 | 1.3 | https://www.mouser.com/datasheet/3/70/1/Infineon-IRLS3034-DataSheet-v01_01-EN.pdf | PASS
IRLR3114ZPbF | International Rectifier | D-Pak | 40 | 130 | Yes | 16 | 4.5 | 6.5 | 40 | 18 | 12 |  |  | 24 | 1.67 | 1.3 | https://www.mouser.com/datasheet/3/70/1/Infineon_IRLR3114Z_DataSheet_v01_01_EN.pdf | REJECT: Low Vgs (16.0V < 18V)
IPD50N04S4-10 | Infineon | PG-TO252-3-313 | 40 | 50 | No |  | 10 | 9.3 | 14 | 2 | 6.8 |  |  | 5.4 | 2.5926 | 1.3 | https://www.mouser.com/datasheet/3/70/1/Infineon-IPD50N04S4_10-DS-v01_00-en.pdf | PASS
IPD30N03S4L-09 | Infineon | PG-TO252-3-11 | 30 | 30 | Yes | 16 | 10 | 9 | 15 | 2 | 4 |  |  | 4 | 3.75 | 1.3 | https://www.mouser.com/datasheet/3/70/1/Infineon_IPD30N03S4L_09_DS_v01_01_en.pdf | REJECT: Low Vgs (16.0V < 18V)
IPD90N04S4-05 | Infineon | PG-TO252-3-313 | 40 | 86 | No |  | 10 | 5.2 | 29 | 4 | 14 |  |  | 11 | 2.636363636 | 1.3 | https://www.mouser.com/datasheet/3/70/1/Infineon-IPD90N04S4_05-DS-v01_00-en.pdf | PASS
IPD50N04S4L-08 | Infineon | PG-TO252-3-313 | 40 | 50 | No |  | 10 | 7.3 | 23 | 2.6 | 5.8 |  |  | 5.5 | 4.181818182 | 1.3 | https://www.mouser.com/datasheet/3/70/1/Infineon_IPD50N04S4L_08_DataSheet_v01_10_EN.pdf | PASS
IPD50N04S4L-08 | Infineon | PG-TO252-3-313 | 40 | 50 | No |  | 10 | 7.3 | 23 | 2.6 | 5.8 |  |  | 5.5 | 4.181818182 | 1.3 | https://www.mouser.com/datasheet/3/70/1/Infineon_IPD50N04S4L_08_DataSheet_v01_10_EN.pdf | PASS
IPD75N04S4-06 | Infineon | PG-TO252-3-313 | 40 | 75 | No |  | 10 | 5.9 | 24.5 | 3.5 | 11.7 |  |  | 9.35 | 2.620320856 | 1.3 | https://www.mouser.com/datasheet/3/70/1/Infineon_IPD75N04S4_06_DS_v01_01_en.pdf | PASS
IPD036N04L G | Infineon | PG-TO252-3 | 40 | 90 | Yes | 20 | 10 | 3.6 | 59 | 6.1 | 14 | 7.4 |  | 13 | 4.54 | 1.2 | https://www.mouser.com/datasheet/3/70/1/Infineon_IPD036N04L_DS_v01_00_en.pdf | PASS
N0601N | Renesas | TO-263 | 60 | 100 | No |  | 10 | 4.2 | 133 | 38 | 38 |  |  | 57 | 2.333333333 | 1.5 | https://www.mouser.com/datasheet/3/1166/1/REN_r07ds0557ej0200_n0601n_DST_20200610_1.pdf | PASS
IPD70N03S4L-04 | Infineon | PG-TO252-3-11 | 30 | 70 | Yes | 16 | 10 | 4.3 | 37 | 5 | 8 |  |  | 9 | 4.11 | 1.3 | https://www.mouser.com/datasheet/3/70/1/Infineon_IPD70N03S4L_04_DS_v02_01_EN.pdf | REJECT: Low Vgs (16.0V < 18V)
IPD90N04S4L-04 | Infineon | PG-TO252-3-313 | 40 | 90 | No |  | 10 | 3.8 | 46 | 5 | 12 |  |  | 11 | 4.18 | 1.3 | https://www.mouser.com/datasheet/3/70/1/Infineon_IPD90N04S4L_04_DS_v01_00_en.pdf | PASS
IPD90N03S4L-03 | Infineon | PG-TO252-3-11 | 30 | 90 | Yes | 16 | 10 | 3.3 | 60 | 8 | 12 |  |  | 14 | 4.2857 | 1.3 | https://www.mouser.com/datasheet/3/70/1/Infineon-IPD90N03S4L_03-DS-v02_01-en.pdf | REJECT: Low Vgs (16.0V < 18V)
IRFR4104PbF | International Rectifier | D-Pak | 40 | 42 | No |  | 10 | 5.5 | 59 | 24 | 19 |  |  | 33.5 | 1.76 | 1.3 | https://www.mouser.com/datasheet/3/70/1/Infineon_IRFR4104_DataSheet_v01_01_EN.pdf | PASS
IRF40R207 | International Rectifier | D-Pak | 40 | 90 | No |  | 10 | 5.1 | 45 | 15 | 12 |  |  | 21 | 2.142857143 | 1.3 | https://www.mouser.com/datasheet/3/70/1/Infineon_IRF40R207_DataSheet_v01_01_EN.pdf | PASS
IPD80N04S3-06 | Infineon | PG-TO252-3-11 | 40 | 90 | No |  | 10 | 5.2 | 36 | 9 | 15 |  |  | 16.5 | 2.181818182 | 1.3 | https://www.mouser.com/datasheet/3/70/1/Infineon_IPD80N04S3_06_DS_v01_00_en.pdf | PASS
TK35S04K3L | Toshiba | DPAK+ | 40 | 35 | No |  | 10 | 10.3 | 28 | 10 | 18 |  |  | 19 | 1.473684211 | 1.2 | https://www.mouser.com/datasheet/3/105/1/39745A9E4DBB0ECA28888EF50B3BD7BA197CFE4921D8A68F0CE587FA184EEFA6.pdf | PASS
NP60N04VLK | Renesas | TO-252 (MP-3ZP) | 40 | 60 | Yes | 20 | 10 | 3.9 | 42 | 6 | 11 |  |  | 11.5 | 3.65 | 1.5 | https://www.mouser.com/datasheet/3/1166/1/REN_r07ds1246ej0200_pomosfet_DST_20180524_1.pdf | PASS
NP75N04VDK | Renesas | TO-252 (MP-3ZP) | 40 | 75 | Yes | 20 | 10 | 5.7 | 27 | 4 | 8 |  |  | 8 | 3.375 | 1.5 | https://www.mouser.com/datasheet/3/1166/1/REN_r07ds1015ej0200_pomosfet_DST_20180524_1.pdf | PASS
RJF0411JPD | Renesas | DPAK(S) | 40 | 34 | Yes | 16 | 10 | 37 | 15 | 4 | 3 |  |  | 5.5 | 2.73 | 0.96 | https://www.mouser.com/datasheet/3/1166/1/REN_r07ds1258ej0100_rjf0411jpd_DST_20150623.pdf | REJECT: Low Vgs (16.0V < 18V)
N0436N | Renesas | TO-252 | 40 | 56 | No |  | 10 | 4.7 | 62 | 20 | 16 |  |  | 28 | 2.21 | 1.5 | https://www.mouser.com/datasheet/3/1166/1/REN_r07ds1414ej0100_n0436n_DST_20190930_1.pdf | PASS
NP90N04VUK | Renesas | TO-252 (MP-3ZP) | 40 | 90 | No |  | 10 | 2.8 | 68 | 18 | 18 |  |  | 27 | 2.5185 | 1.5 | https://www.mouser.com/datasheet/3/1166/1/REN_r07ds0577ej0200_pomosfet_DST_20180524_1.pdf | PASS
NP60N04VUK | Renesas | TO-252 (MP-3ZP) | 40 | 60 | No |  | 10 | 3.85 | 42 | 11 | 11 |  |  | 16.5 | 2.54545 | 1.5 | https://www.mouser.com/datasheet/3/1166/1/REN_r07ds0576ej0200-pomosfet_DST_20180524.pdf | PASS
NP60N04VDK | Renesas | TO-252 | 40 | 60 | Yes | 20 | 10 | 3.85 | 42 | 6 | 11 |  |  | 11.5 | 3.652 | 1.5 | https://www.mouser.com/datasheet/3/1166/1/REN_r07ds1014ej0200_pomosfet_DST_20180524_1.pdf | PASS
IPD90N04S3-H4 | Infineon | PG-TO252-3-11 | 40 | 90 | No |  | 10 | 4.3 | 46 | 12 | 18 |  |  | 21 | 2.19 | 1.3 | https://www.mouser.com/datasheet/3/70/1/Infineon_IPD90N04S3_H4_DS_v01_00_en.pdf | PASS
IPD50N04S3-09 | Infineon | PG-TO252-3-11 | 40 | 50 | No |  | 10 | 9 | 20 | 5 | 8 |  |  | 9 | 2.22 | 1.3 | https://www.mouser.com/datasheet/3/70/1/Infineon_IPD50N04S3_09_DS_v01_01_en.pdf | PASS
IPD80N04S3-06 | Infineon | PG-TO252-3-11 | 40 | 90 | No |  | 10 | 5.2 | 36 | 9 | 15 |  |  | 16.5 | 2.181818182 | 1.3 | https://www.mouser.com/datasheet/3/70/1/Infineon_IPD80N04S3_06_DS_v01_00_en.pdf | PASS
P180FP4SNK | Shindengen | SC-83 similar FP | 40 | 180 | No |  | 10 | 1.15 | 160 | 35 | 50 |  |  | 60 | 2.67 | 1.2 | https://www.mouser.com/datasheet/3/335/1/shindengen_F072_14a.pdf.pdf | PASS
AUIRF4104 | Infineon | TO-220 | 40 | 120 | No |  | 10 | 5.5 | 68 | 27 | 21 |  |  | 37.5 | 1.813333333 | 1.3 | https://www.mouser.com/datasheet/3/70/1/auirf4104.pdf | REJECT: Bad Package (Through-Hole)
AUIRFR4104 | Infineon | D-Pak | 40 | 119 | No |  | 10 | 5.5 | 59 | 24 | 19 |  |  | 33.5 | 1.76 | 1.3 | https://www.mouser.com/catalog/specsheets/infn-s-a0008053431-1.pdf | PASS
AUIRF1404S | Infineon | D2-Pak | 40 | 162 | No |  | 10 | 4 | 160 | 42 | 35 |  |  | 59.5 | 2.69 | 1.3 | https://www.mouser.com/datasheet/3/70/1/auirf1404s.pdf | PASS
IRFR4104PbF | International Rectifier | D-Pak | 40 | 42 | No |  | 10 | 5.5 | 59 | 24 | 19 |  |  | 33.5 | 1.76 | 1.3 | https://www.mouser.com/datasheet/3/70/1/Infineon_IRFR4104_DataSheet_v01_01_EN.pdf | PASS
IPD50N03S2-07 | Infineon | PG-TO252-3-11 | 30 | 50 | No |  | 10 | 7.3 | 52 | 27 | 11 |  |  | 32.5 | 1.6 | 1.3 | https://www.mouser.com/datasheet/3/70/1/Infineon_IPD50N03S2_07_DS_v01_00_en.pdf | PASS
AUIRFR8401 | Infineon | D-Pak | 40 | 100 | No |  | 10 | 4.25 | 42 | 14 | 12 |  |  | 20 | 2.1 | 1.3 | https://www.mouser.com/datasheet/3/70/1/Infineon_AUIRFR8401_DS_v01_01_EN.pdf | PASS
IPD50N03S2L-06 | Infineon | PG-TO252-3-11 | 30 | 50 | Yes | 20 | 10 | 6.4 | 50 | 16 | 6 |  |  | 19 | 2.63 | 1.3 | https://www.mouser.com/datasheet/3/70/1/Infineon_IPD50N03S2L_06_DS_v01_00_en.pdf | PASS
AUIRFR8403 | Infineon | D-Pak | 40 | 127 | No |  | 10 | 3.1 | 66 | 22 | 18 |  |  | 31 | 2.13 | 1.3 | https://www.mouser.com/datasheet/3/70/1/Infineon-AUIRFR8403-DS-v01_01-EN.pdf | PASS
IRF4104SPbF | International Rectifier | D2Pak | 40 | 75 | No |  | 10 | 5.5 | 68 | 27 | 21 |  |  | 37.5 | 1.813333333 | 1.3 | https://www.mouser.com/datasheet/3/70/1/Infineon-IRF4104-DataSheet-v01_01-EN.pdf | PASS
AUIRFS8403 | International Rectifier | D2Pak | 40 | 123 | No |  | 10 | 3.3 | 62 | 20 | 16 |  |  | 28 | 2.21 | 1.3 | https://www.mouser.com/datasheet/3/70/1/auirfs8403.pdf | PASS
IRFR3504ZPbF | International Rectifier | D-Pak | 40 | 42 | No |  | 10 | 9 | 30 | 12 | 9.6 |  |  | 16.8 | 1.7857 | 1.3 | https://www.mouser.com/datasheet/3/70/1/Infineon_IRFR3504Z_DataSheet_v01_01_EN.pdf | PASS
IRL1404SPbF | International Rectifier | D2Pak | 40 | 160 | Yes | 20 | 10 | 4 | 140 | 60 | 48 |  |  | 84 | 1.666666667 | 1.3 | https://www.mouser.com/datasheet/3/70/1/Infineon-IRL1404S-DataSheet-v01_01-EN.pdf | PASS
IRLR7821PbF | International Rectifier | D-Pak | 30 | 65 | Yes | 20 | 4.5 | 12.5 | 10 | 2.5 |  | 2 | 1.2 | 3.7 | 2.7 | 1 | https://www.mouser.com/datasheet/3/70/1/Infineon_IRLR7821_DataSheet_v01_01_EN.pdf | PASS
PJQ5540V-AU | PANJIT | DFN5060X-8L | 40 | 174 | No |  | 10 | 2.1 | 63 | 11 | 19 |  |  | 20.5 | 3.073170732 | 1.3 | https://www.mouser.com/datasheet/3/3736/1/34C9EC0CE6CAB485AF871EC5193847F90A7F02E1F5D76B195AABD188C34C89CE.pdf | PASS
ISCH57N04NM7VSC | Infineon | PG-WSON-8 | 40 | 443 | No |  | 10 | 0.57 | 112 | 20 | 36 |  |  | 35 | 3.2 | 1 | https://www.mouser.com/datasheet/3/70/1/infineon_isch57n04nm7vsc_datasheet_en.pdf | PASS
IAUCN04S7N037G | Infineon | PG-THSOG-4-1 | 40 | 91 | No |  | 10 | 3.65 | 16 | 3.5 | 4.9 |  |  | 5.95 | 2.68907563 | 1 | https://www.mouser.com/datasheet/3/70/1/infineon_iaucn04s7n037g_datasheet_en.pdf | PASS
IAUCN04S7N019G | Infineon | PG-THSOG-4-1 | 40 | 147 | No |  | 10 | 1.95 | 30 | 6.2 | 8.9 |  |  | 10.65 | 2.816901408 | 1 | https://www.mouser.com/datasheet/3/70/1/infineon_iaucn04s7n019g_datasheet_en.pdf | PASS
IAUCN04S7N047G | Infineon | PG-THSOG-4-1 | 40 | 79 | No |  | 10 | 4.7 | 13 | 2.8 | 3.8 |  |  | 4.7 | 2.765957447 | 1 | https://www.mouser.com/datasheet/3/70/1/infineon_iaucn04s7n047g_datasheet_en.pdf | PASS
IAUCN04S7N027G | Infineon | PG-THSOG-4-1 | 40 | 117 | No |  | 10 | 2.67 | 23 | 4.8 | 6.8 |  |  | 8.2 | 2.804878049 | 1 | https://www.mouser.com/datasheet/3/70/1/infineon_iaucn04s7n027g_datasheet_en.pdf | PASS
IAUCN04S7L042G | Infineon | PG-THSOG-4-1 | 40 | 77 | Yes | 16 | 10 | 4.4 | 15 | 2.7 | 2.8 |  |  | 4.1 | 3.658536585 | 1 | https://www.mouser.com/catalog/specsheets/Infineon_3-23-2026_IAUCN04S7L042G.pdf | REJECT: Low Vgs (16.0V < 18V)
IAUCN04S7N015G | Infineon | PG-THSOG-4-1 | 40 | 184 | No |  | 10 | 1.53 | 41 | 8.1 | 11.6 |  |  | 13.9 | 2.949640288 | 1 | https://www.mouser.com/datasheet/3/70/1/infineon_iaucn04s7n015g_datasheet_en.pdf | PASS
NP50N04YUK | Renesas | 8-pin HSON | 40 | 50 | No |  | 10 | 4.8 | 38 | 10 | 10 |  |  | 15 | 2.533333333 | 1.5 | https://www.mouser.com/datasheet/3/1166/1/REN_r07ds1003ej0200-pomosfet_DST_20180524.pdf | PASS
MRF177 | MACOM | CASE 744A-01 | 65 | 16 | No |  | 10 | 466.67 | 1 | 0.1 | 0.9 |  |  | 0.55 | 1.82 | 1 | https://www.mouser.com/datasheet/3/829/1/MRF177.pdf | PASS
PJQ4546VP-AU | PANJIT | DFN3333-8L | 40 | 61 | No |  | 10 | 6.3 | 23 | 6 | 5 |  |  | 8.5 | 2.705882353 | 1.3 | https://www.mouser.com/datasheet/3/3736/1/PJQ4546VP_AU.pdf | PASS
ISCH92N04NM7VSC | Infineon | PG-WSON-8 | 40 | 289 | No |  | 10 | 0.92 | 65 | 12 | 22 | 13 |  | 22 | 2.954545455 | 1 | https://www.mouser.com/datasheet/3/70/1/infineon_isch92n04nm7vsc_datasheet_en.pdf | PASS
MRF150 | MACOM | CASE 211-11, STYLE 2 | 125 | 16 | No |  | 10 | 500 | 6 | 2 | 3.6 |  |  | 3.8 | 1.58 | 1 | https://www.mouser.com/datasheet/3/829/1/MRF150.pdf | PASS
PJQ4548VP-AU | PANJIT | DFN3333-8L | 40 | 40 | No |  | 10 | 10.4 | 9.5 | 2.6 | 4.2 |  |  | 4.7 | 2.021276596 | 1.3 | https://www.mouser.com/datasheet/3/3736/1/PJQ4548VP_AU.pdf | PASS
MRF148A | MACOM | CASE 211-07, STYLE 2 | 120 | 6 | No |  | 10 | 2000 | 0.62 | 0.15 | 0.59 |  |  | 0.445 | 1.39 | 1 | https://www.mouser.com/datasheet/3/829/1/MRF148A.pdf | REJECT: Low Id (6.0A < 7.5A)
PJQ5948V-AU | PANJIT Semiconductor | DFN5060B-8L | 40 | 35 | No |  | 10 | 13.4 | 9.5 | 2.6 | 4.2 |  |  | 4.7 | 2.021276596 | 1.3 | https://www.mouser.com/datasheet/3/3736/1/PJQ5948V_AU.pdf | PASS
IAUCN04S7N006T | Infineon | PG-LHDSO-10-3 | 40 | 425 | No |  | 10 | 0.64 | 112 | 24 | 31 |  |  | 39.5 | 2.835443038 | 0.95 | https://www.mouser.com/catalog/specsheets/Infineon_04-30-2025_IAUCN04S7N006T-Data-Sheet-10-Infineon.pdf | PASS
PJQ5544V-AU | PANJIT | DFN5060-8L | 40 | 120 | No |  | 10 | 3.6 | 34 | 4 | 11 |  |  | 9.5 | 3.578947368 | 1.3 | https://www.mouser.com/datasheet/3/3736/1/PJQ5544V_AU.pdf | PASS
MRF157 | MACOM | CASE 368-03, STYLE 2 | 125 | 60 | No |  | 10 | 125 | 0 | 0 |  |  |  | 0 | 0 | 0 | https://www.mouser.com/datasheet/3/829/1/MRF157.pdf | PASS
ISCH75N04NM7VSC | Infineon | PG-WSON-8 | 40 | 339 | No |  | 10 | 0.75 | 81 | 15 | 27 | 16 |  | 26 | 3.11538 | 1 | https://www.mouser.com/datasheet/3/70/1/infineon_isch75n04nm7vsc_datasheet_en.pdf | PASS
IAUCN04S7L023H | Infineon | PG-TDSON-8-56 | 40 | 132 | Yes | 16 | 10 | 2.34 | 29 | 5.1 | 5.5 |  |  | 7.85 | 3.694267516 | 1 | https://www.mouser.com/datasheet/3/70/1/infineon_iaucn04s7l023h_datasheet_en.pdf | REJECT: Low Vgs (16.0V < 18V)
DMTH41M2SPSQ | Diodes Incorporated | PowerDI5060-8 | 40 | 225 | No |  | 10 | 1.2 | 138 | 10 | 53 |  |  | 36.5 | 3.780821918 | 1.3 | https://www.mouser.com/datasheet/3/175/1/DMTH41M2SPSQ.pdf | PASS
NP110N04PUK | Renesas | TO-263 | 40 | 110 | No |  | 10 | 1.4 | 198 | 48 | 50 |  |  | 73 | 2.71 | 1.5 | https://www.mouser.com/datasheet/3/1166/1/REN_r07ds0570ej0200_pomosfet_DST_20180524_1.pdf | PASS
ISC036N04NM5 | Infineon | TDSON-8 FL | 40 | 98 | No |  | 10 | 3.6 | 21 | 4 | 7 |  |  | 7 | 3 | 1 | https://www.mouser.com/datasheet/3/70/1/Infineon_ISC036N04NM5_DataSheet_v02_01_EN.pdf | PASS
ISC017N04NM5 | Infineon | TDSON-8 FL | 40 | 193 | No |  | 10 | 1.7 | 51 | 9 | 16 |  |  | 15 | 3.4 | 1 | https://www.mouser.com/datasheet/3/70/1/Infineon_ISC017N04NM5_DataSheet_v02_01_EN.pdf | PASS
TPH2R104PL | Toshiba | SOP Advance | 40 | 100 | No |  | 10 | 2.1 | 78 | 10 |  | 19 |  | 21 | 3.71 | 1.2 | https://www.mouser.com/datasheet/3/105/1/75B9736481C45D9424A15E17C3D88D861334FED2ABC122D8621FF4D1B775DEAD.pdf | PASS
IPC100N04S5-1R2 | Infineon | PG-TDSON-8-34 | 40 | 100 | No |  | 10 | 1.2 | 99 | 21 | 25 |  |  | 33.5 | 2.955223881 | 1.1 | https://www.mouser.com/datasheet/3/70/1/Infineon_IPC100N04S5_1R2_DS_v01_03_EN.pdf | PASS
IAUC100N04S6N028 | Infineon | PG-TDSON-8 | 40 | 100 | No |  | 10 | 2.86 | 22 | 4.8 | 6.3 |  |  | 7.95 | 2.7672956 | 1.1 | https://www.mouser.com/datasheet/3/70/1/Infineon_IAUC100N04S6N028_DataSheet_v01_00_EN.pdf | PASS
XPN12006NC | Toshiba | TSON Advance(WF) | 60 | 20 | No |  | 10 | 12 | 23 | 4 |  | 6 |  | 7 | 3.29 | 1.2 | https://www.mouser.com/datasheet/3/105/1/2CAB20117017785EFF0453A206900A9824CD0972D65A782B153CA1558A69085C.pdf | PASS
TPH3R704PL | Toshiba | SOP Advance | 40 | 92 | No |  | 10 | 3.7 | 27 | 4.2 |  | 7.7 |  | 8.1 | 3.33 | 1.2 | https://www.mouser.com/datasheet/3/105/1/6377AED62D528F3CEEBE4C9BE909FE4390067EF71E2A91347880F3CDDB2741B8.pdf | PASS
IPB180N04S4-H0 | Infineon | PG-TO263-7-3 | 40 | 180 | No |  | 10 | 1.1 | 173 | 23 | 71 |  |  | 58.5 | 2.957264957 | 1.3 | https://www.mouser.com/datasheet/3/70/1/Infineon_IPB180N04S4_H0_DS_v01_00_en.pdf | PASS
ISC015N04NM5 | Infineon | TDSON-8 FL | 40 | 206 | No |  | 10 | 1.5 | 51 | 9 | 16 |  |  | 15 | 3.4 | 1 | https://www.mouser.com/datasheet/3/70/1/Infineon_ISC015N04NM5_DataSheet_v02_01_EN.pdf | PASS
ISC046N04NM5 | Infineon | TDSON-8 FL | 40 | 77 | No |  | 10 | 4.6 | 16 | 3 | 5 |  |  | 5 | 3.2 | 1 | https://www.mouser.com/datasheet/3/70/1/Infineon_ISC046N04NM5_DataSheet_v02_01_EN.pdf | PASS
BSC072N04LD | Infineon | SSO8 dual (TDSON-8-4) | 40 | 20 | Yes | 16 | 10 | 7.2 | 39 | 4.1 | 9 |  |  | 8.6 | 4.534883721 | 1.1 | https://www.mouser.com/datasheet/3/70/1/Infineon_BSC072N04LD_DS_v02_00_EN.pdf | REJECT: Low Vgs (16.0V < 18V)
IAUC120N04S6L012 | Infineon | PG-TDSON-8 | 40 | 120 | Yes | 16 | 10 | 1.21 | 60 | 12 | 11 |  |  | 17.5 | 3.428571429 | 1.1 | https://www.mouser.com/datasheet/3/70/1/Infineon_IAUC120N04S6L012_DataSheet_v01_00_EN.pdf | REJECT: Low Vgs (16.0V < 18V)
PJD50N04-AU | PANJIT | TO-252AA | 40 | 50 | No |  | 10 | 9.5 | 22 | 4 | 4.2 |  |  | 6.1 | 3.606557377 | 1 | https://www.mouser.com/datasheet/3/3736/1/4635464336344145303043413638344336314637303831393736363233423141.pdf | PASS
IAUA120N04S5N014 | Infineon | PG-HSOF-5-2 | 40 | 120 | No |  | 10 | 1.4 | 62 | 13 | 16 |  |  | 21 | 2.952380952 | 1.1 | https://www.mouser.com/datasheet/3/70/1/Infineon-IAUA120N04S5N014-DataSheet-v01_20-EN.pdf | PASS
IRFS7434-7PPbF | International Rectifier | D2Pak-7Pin | 40 | 362 | No |  | 10 | 1 | 210 | 66 | 55 |  |  | 93.5 | 2.245989305 | 1.3 | https://www.mouser.com/datasheet/3/70/1/Infineon-IRFS7434-7P-DataSheet-v01_01-EN.pdf | PASS
ISC015N06NM5 | Infineon | PG-TDSON-8 | 60 | 259 | No |  | 10 | 1.5 | 70 | 12.7 | 22 |  |  | 21 | 3.333333333 | 1 | https://www.mouser.com/datasheet/3/70/1/infineon_isc015n06nm5_datasheet_en.pdf | PASS
IAUA200N04S5N010 | Infineon | PG-HSOF-5-1 | 40 | 200 | No |  | 10 | 0.94 | 99 | 21 | 28 |  |  | 35 | 2.828571429 | 1.1 | https://www.mouser.com/datasheet/3/70/1/Infineon_IAUA200N04S5N010_DataSheet_v01_40_EN.pdf | PASS
IAUC100N04S6N015 | Infineon | PG-TDSON-8 | 40 | 100 | No |  | 10 | 1.55 | 42 | 8.5 | 11 |  |  | 14 | 3 | 1.1 | https://www.mouser.com/datasheet/3/70/1/Infineon-IAUC100N04S6N015-DataSheet-v01_00-EN.pdf | PASS
RBE029N10R1SZN6 | Renesas | SO8-FL(5x6) | 100 | 160 | No |  | 10 | 2.9 | 91 | 20 | 37 |  |  | 38.5 | 2.363636364 | 1.5 | https://www.mouser.com/datasheet/3/1166/1/r07ds1630ej0101_rbe029n10r1szn6.pdf | PASS
TPH6R004PL | Toshiba | SOP Advance | 40 | 49 | No |  | 10 | 6 | 30 | 5 |  | 7 |  | 9 | 3.33 | 1.2 | https://www.mouser.com/datasheet/3/105/1/6E59F04D5217CC58E15A33E488DF4280E7393E615BF36F96674F0E3E33269BC5.pdf | PASS
DMTH4005SPSQ | Diodes Incorporated | PowerDI5060-8 | 40 | 100 | No |  | 10 | 3.7 | 49.1 | 13 | 10.3 |  |  | 18.15 | 2.705 | 0.88 | https://www.mouser.com/datasheet/3/175/1/DMTH4005SPSQ.pdf | PASS
IPC50N04S5L-5R5 | Infineon | PG-TDSON-8-33 | 40 | 50 | Yes | 16 | 10 | 5.5 | 17 | 3.6 | 2.7 |  |  | 4.95 | 3.434343434 | 1.1 | https://www.mouser.com/datasheet/3/70/1/Infineon_IPC50N04S5L_5R5_DS_v01_02_EN.pdf | REJECT: Low Vgs (16.0V < 18V)
DMTH46M7SFVWQ | Diodes Incorporated | PowerDI3333-8 | 40 | 67.2 | No |  | 10 | 7.4 | 14.8 | 5.2 | 1.9 |  |  | 6.15 | 2.406504065 | 1.2 | https://www.mouser.com/datasheet/3/175/1/DMTH46M7SFVWQ.pdf | PASS
IPZ40N04S5L-2R8 | Infineon | PG-TSDSON-8-33 | 40 | 40 | Yes | 16 | 10 | 2.8 | 39 | 7.8 | 5.4 |  |  | 10.5 | 3.714285714 | 1.1 | https://www.mouser.com/datasheet/3/70/1/Infineon-IPZ40N04S5L-2R8-DS-v01_01-EN.pdf | REJECT: Low Vgs (16.0V < 18V)
IPB100N04S4-H2 | Infineon | PG-TO263-3-2 | 40 | 100 | No |  | 10 | 2.4 | 70 | 10 | 32 |  |  | 26 | 2.692307692 | 1.3 | https://www.mouser.com/datasheet/3/70/1/Infineon_IPP_B_I100N04S4_H2_DS_v01_00_en.pdf | PASS
IPB180N04S4-01 | Infineon | PG-TO263-7-3 | 40 | 180 | No |  | 10 | 1.3 | 135 | 19 | 59 |  |  | 48.5 | 2.7835 | 1.3 | https://www.mouser.com/datasheet/3/70/1/Infineon-IPB180N04S4_01-DS-v01_00-en.pdf | PASS
IPG20N04S4-18A | Infineon | PG-TDSON-8 | 40 | 20 | No |  | 10 | 18.4 | 8.7 | 1.3 | 3.6 |  |  | 3.1 | 2.806451613 | 1.3 | https://www.mouser.com/datasheet/3/70/1/Infineon_IPG20N04S4_18A_DataSheet_v01_00_EN.pdf | PASS
TPW1R104PB | Toshiba | DSOP Advance(WF)M | 40 | 120 | No |  | 10 | 1.14 | 55 | 13 |  | 20 |  | 23 | 2.39 | 1.2 | https://www.mouser.com/datasheet/3/105/1/FADFC6A70C3003AEF1225D2BFF40B4139A914E0E4EE94B6CCD37BC8223A475D3.pdf | PASS
IPB011N04L G | Infineon | PG-TO263-7 | 40 | 180 | Yes | 20 | 10 | 1.1 | 260 | 27 | 61 | 33 |  | 55 | 4.727272727 | 1.1 | https://www.mouser.com/datasheet/3/70/1/Infineon_IPB011N04L_DS_v01_03_en.pdf | PASS
IAUC120N04S6N010 | Infineon | PG-TDSON-8 | 40 | 120 | No |  | 10 | 1.03 | 81 | 16 | 22 |  |  | 27 | 3 | 1.1 | https://www.mouser.com/datasheet/3/70/1/Infineon_IAUC120N04S6N010_DataSheet_v01_00_EN.pdf | PASS
IAUA180N04S5N012 | Infineon | PG-HSOF-5-2 | 40 | 180 | No |  | 10 | 1.16 | 75 | 16 | 21 |  |  | 26.5 | 2.830188679 | 1.1 | https://www.mouser.com/datasheet/3/70/1/Infineon-IAUA180N04S5N012-DataSheet-v01_30-EN.pdf | PASS
IPB011N04L G | Infineon | PG-TO263-7 | 40 | 180 | Yes | 20 | 10 | 1.1 | 260 | 27 | 61 | 33 |  | 55 | 4.727272727 | 1.1 | https://www.mouser.com/datasheet/3/70/1/Infineon_IPB011N04L_DS_v01_03_en.pdf | PASS
BSZ028N04LS | Infineon | PG-TSDSON-8 FL | 40 | 114 | No |  | 10 | 2.8 | 32 | 5.1 | 5.5 |  |  | 6.9 | 4.637681159 | 1 | https://www.mouser.com/datasheet/3/70/1/Infineon-BSZ028N04LS-DataSheet-v02_03-EN.pdf | PASS
BSZ021N04LS6 | Infineon | PG-TSDSON-8 FL | 40 | 147 | No |  | 10 | 2.1 | 31 | 3.8 | 5.6 |  |  | 6 | 5.166666667 | 1 | https://www.mouser.com/datasheet/3/70/1/Infineon_BSZ021N04LS6_DataSheet_v02_03_EN.pdf | PASS
TKR74F04PB | Toshiba | TO-220SM(W) | 40 | 250 | No |  | 10 | 0.74 | 227 | 54 |  | 58 |  | 54 | 4.2 | 1.2 | https://www.mouser.com/datasheet/3/105/1/CE0C0A6D9C2C9EA9C73794B8525AE10319DDFFAAF49B859B4A2D9C554F0CBB40.pdf | REJECT: Bad Package (Through-Hole)
XPN7R104NC | Toshiba | TSON Advance(WF) | 40 | 20 | No |  | 10 | 7.1 | 21 | 4 |  | 4 |  | 4 | 5.25 | 1.2 | https://www.mouser.com/datasheet/3/105/1/2F671D51BA569BA85D68967087C7D1B6422CB7C18C7A03B4F77ECF145FDFC371.pdf | PASS
IAUA250N04S6N008 | Infineon | PG-HSOF-5-1 | 40 | 250 | No |  | 10 | 0.8 | 81 | 16 | 23 |  |  | 27.5 | 2.945454545 | 1.1 | https://www.mouser.com/datasheet/3/70/1/Infineon_IAUA250N04S6N008_DataSheet_v01_00_EN.pdf | PASS
BSC014N04LSI | Infineon | TDSON-8 FL | 40 | 195 | Yes | 20 | 10 | 1.45 | 55 | 8.9 | 9.9 | 6.3 |  | 12 | 4.58 | 0.7 | https://www.mouser.com/datasheet/3/70/1/Infineon_BSC014N04LSI_DataSheet_v02_04_EN.pdf | PASS
TPH1R104PB | Toshiba | SOP Advance(WF) | 40 | 120 | No |  | 10 | 1.14 | 55 | 13 |  | 20 |  | 23 | 2.39 | 1.2 | https://www.mouser.com/datasheet/3/105/1/09EC14C5DFE37B49162FEAFEFED5E147287A8ABA670749D121CB09084B285CD3.pdf | PASS
IAUC45N04S6L063H | Infineon | PG-TDSON-8-57 | 40 | 45 | Yes | 16 | 10 | 6.3 | 10 | 2.1 | 2 |  |  | 3.1 | 3.225806452 | 1.1 | https://www.mouser.com/datasheet/3/70/1/Infineon_IAUC45N04S6L063H_DataSheet_v01_00_EN.pdf | REJECT: Low Vgs (16.0V < 18V)
BSC054N04NS G | Infineon | PG-TDSON-8 | 40 | 81 | No |  | 10 | 5.4 | 26 | 3.3 | 11 |  |  | 8.2 | 3.170731707 | 1.2 | https://www.mouser.com/datasheet/3/70/1/Infineon_BSC054N04NSG_DS_v02_01_en.pdf | PASS
IPLU250N04S4-1R7 | Infineon | H-PSOF-8-1 | 40 | 250 | No |  | 10 | 1.7 | 76 | 11 | 34 |  |  | 28 | 2.714285714 | 1.3 | https://www.mouser.com/datasheet/3/70/1/Infineon_IPLU250N04S4_1R7_DS_v01_00_EN.pdf | PASS
BSZ105N04NS G | Infineon | PG-TSDSON-8 | 40 | 40 | No |  | 10 | 10.5 | 13 | 1.7 | 5.7 | 3.1 |  | 4.3 | 3.02 | 1.2 | https://www.mouser.com/datasheet/3/70/1/Infineon_BSZ105N04NSG_DS_v02_00_en.pdf | PASS
IPB180N04S4-00 | Infineon | PG-TO263-7-3 | 40 | 180 | No |  | 10 | 0.98 | 220 | 29 | 87 |  |  | 72.5 | 3.034482759 | 1.3 | https://www.mouser.com/datasheet/3/70/1/Infineon_IPB180N04S4_00_DS_v01_01_EN.pdf | PASS
XPN3R804NC | Toshiba | TSON Advance(WF) | 40 | 40 | No |  | 10 | 3.8 | 35 | 7.2 |  | 8 |  | 11.2 | 3.125 | 1.2 | https://www.mouser.com/datasheet/3/105/1/4238383443363536443032414442374534303244453745334142433144434439.pdf | PASS
IPG20N04S4-12A | Infineon | PG-TDSON-8 | 40 | 20 | No |  | 10 | 12.2 | 14 | 2 | 6 |  |  | 5 | 2.8 | 1.3 | https://www.mouser.com/datasheet/3/70/1/Infineon_IPG20N04S4_12A_DataSheet_v01_01_EN.pdf | PASS
IPB180N04S4L-H0 | Infineon | PG-TO263-7-3 | 40 | 180 | Yes | 20 | 10 | 1 | 239 | 26 | 52 |  |  | 52 | 4.596153846 | 1.3 | https://www.mouser.com/datasheet/3/70/1/Infineon_IPB180N04S4LH010_DS_v01_00_en.pdf | PASS
ISC058N04NM5 | Infineon | TDSON-8 FL | 40 | 63 | No |  | 10 | 5.8 | 12 | 2 | 4 | 2 |  | 4 | 3 | 1 | https://www.mouser.com/datasheet/3/70/1/Infineon_ISC058N04NM5_DataSheet_v02_01_EN.pdf | PASS
IAUCN04S7N010G | Infineon | PG-THSOG-4-1 | 40 | 175 | No |  | 10 | 1.04 | 59 | 11 | 16 |  |  | 19 | 3.105263158 | 1 | https://www.mouser.com/catalog/specsheets/Infineon_12-17-2025_IAUCN04S7N010GATMA1.pdf | PASS
DMNH4005SPSQ | Diodes Incorporated | PowerDI5060-8 | 40 | 80 | No |  | 10 | 4 | 48 | 11.5 | 9.5 |  |  | 16.25 | 2.953846154 | 1.2 | https://www.mouser.com/datasheet/3/175/1/DMNH4005SPSQ.pdf | PASS
IPC100N04S5L-2R6 | Infineon | PG-TDSON-8-33 | 40 | 100 | Yes | 16 | 10 | 2.6 | 41 | 8.7 | 6.5 |  |  | 11.95 | 3.430962343 | 1.1 | https://www.mouser.com/datasheet/3/70/1/Infineon-IPC100N04S5L-2R6-DS-v01_00-EN.pdf | REJECT: Low Vgs (16.0V < 18V)
BSC010N04LS | Infineon | PG-TDSON-8 | 40 | 292 | Yes | 20 | 10 | 1 | 95 | 15 | 16 | 11 |  | 21 | 4.523809524 | 1 | https://www.mouser.com/datasheet/3/70/1/Infineon_BSC010N04LS_DataSheet_v02_04_EN.pdf | PASS
IPB120N04S4-02 | Infineon | PG-TO263-3-2 | 40 | 120 | No |  | 10 | 1.8 | 103 | 14 | 44 |  |  | 36 | 2.861111111 | 1.3 | https://www.mouser.com/datasheet/3/70/1/Infineon_IPP_B_I120N04S4_02_DS_v01_00_en.pdf | PASS
IPLU300N04S4-R8 | Infineon | H-PSOF-8-1 | 40 | 300 | No |  | 10 | 0.77 | 221 | 27 | 90 |  |  | 72 | 3.0694 | 1.3 | https://www.mouser.com/datasheet/3/70/1/Infineon_IPLU300N04S4_R8_DS_v01_01_EN.pdf | PASS
BSC014N04LST | Infineon | TDSON-8 FL | 40 | 205 | Yes | 20 | 10 | 1.4 | 61 | 9.8 | 11 |  |  | 14 | 4.357142857 | 1 | https://www.mouser.com/datasheet/3/70/1/Infineon_BSC014N04LST_DataSheet_v02_03_EN.pdf | PASS
IPB70N04S4-06 | Infineon | PG-TO263-3-2 | 40 | 70 | No |  | 10 | 6.2 | 24.5 | 3.5 | 11.7 |  |  | 9.35 | 2.620320856 | 1.3 | https://www.mouser.com/datasheet/3/70/1/Infineon-IPP_B_I70N04S4_06-DS-v01_00-en.pdf | PASS
IPG20N04S4-08 | Infineon | PG-TDSON-8 | 40 | 20 | No |  | 10 | 7.6 | 28 | 4 | 12 |  |  | 10 | 2.8 | 1.3 | https://www.mouser.com/datasheet/3/70/1/Infineon-IPG20N04S4-08-DataSheet-v01_10-EN.pdf | PASS
IPG20N04S4-12 | Infineon | PG-TDSON-8 | 40 | 20 | No |  | 10 | 12.2 | 14 | 2 | 6 |  |  | 5 | 2.8 | 1.3 | https://www.mouser.com/datasheet/3/70/1/Infineon_IPG20N04S4_12_DS_v01_00_en.pdf | PASS
NVMFS5C404N | onsemi | DFN5 | 40 | 378 | No |  | 10 | 0.7 | 128 | 26 | 35 |  |  | 43.5 | 2.94 | 1.2 | https://www.mouser.com/datasheet/3/101/1/NVMFS5C404N-D.PDF | PASS
IAUC60N04S6L030H | Infineon | PG-TDSON-8-56 | 40 | 60 | Yes | 16 | 10 | 3 | 27 | 5.2 | 5 |  |  | 7.7 | 3.506493506 | 1.1 | https://www.mouser.com/datasheet/3/70/1/Infineon_IAUC60N04S6L030H_DataSheet_v01_00_EN.pdf | REJECT: Low Vgs (16.0V < 18V)
IPB80N04S4-04 | Infineon | PG-TO263-3-2 | 40 | 80 | No |  | 10 | 4.2 | 33 | 5 | 16 |  |  | 13 | 2.538461538 | 1.3 | https://www.mouser.com/datasheet/3/70/1/Infineon_IPP_B_I80N04S4_04_DS_v01_00_en.pdf | PASS
TPWR7904PB | Toshiba | DSOP Advance(WF)L | 40 | 150 | No |  | 10 | 0.79 | 85 | 14 |  | 28 |  | 28 | 3.04 | 1.2 | https://www.mouser.com/datasheet/3/105/1/878D500C80FD608E1BA2CA5D695C8134ACE989BA3BF1799073F47997038957BD.pdf | PASS
IRF7739L1TRPbF | International Rectifier | DirectFET Large Can | 40 | 270 | No |  | 10 | 1 | 220 | 81 |  | 46 | 19 | 100 | 2.2 | 1.3 | https://www.mouser.com/datasheet/3/70/1/Infineon_IRF7739L1_DataSheet_v01_01_EN.pdf | PASS
DMNH4011SPSQ | Diodes Incorporated | PowerDI5060-8 | 40 | 80 | No |  | 10 | 10 | 25.5 | 6.9 | 4.6 |  |  | 9.2 | 2.77173913 | 1.2 | https://www.mouser.com/datasheet/3/175/1/DMNH4011SPSQ.pdf | PASS
SSM6K514NU | Toshiba | UDFN6B | 40 | 12 | No |  | 4.5 | 17.3 | 7.5 | 2.8 |  | 2.9 |  | 4.6 | 1.63 | 1.2 | https://www.mouser.com/datasheet/3/105/1/5BFD53F56D50CD2A369FC1F176F131F421DD05866D43E74A480648427C94EB40.pdf | PASS
IRFS7437-7PPbF | International Rectifier | D2Pak-7PIN | 40 | 295 | No |  | 10 | 1.4 | 150 | 51 | 41 |  |  | 71.5 | 2.097902098 | 1.3 | https://www.mouser.com/datasheet/3/70/1/Infineon_IRFS7437_7P_DataSheet_v01_01_EN.pdf | PASS
IPC70N04S5L-4R2 | Infineon | PG-TDSON-8-33 | 40 | 70 | Yes | 16 | 10 | 4.2 | 22 | 4.7 | 3.5 |  |  | 6.45 | 3.41 | 1.1 | https://www.mouser.com/datasheet/3/70/1/Infineon_IPC70N04S5L_4R2_DS_v01_00_EN.pdf | REJECT: Low Vgs (16.0V < 18V)
NVTFS5C453NL | onsemi | WDFN8 | 40 | 107 | No |  | 10 | 3.1 | 35 | 5 | 7 |  |  | 8.5 | 4.117647059 | 1.2 | https://www.mouser.com/datasheet/3/101/1/NVTFS5C453NL-D.PDF | PASS
IPB90N04S4-02 | Infineon | PG-TO263-3-2 | 40 | 90 | No |  | 10 | 2.1 | 91 | 12 | 39 |  |  | 31.5 | 2.888888889 | 1.3 | https://www.mouser.com/datasheet/3/70/1/Infineon_IPP_B_I90N04S4_02_DS_v01_01_en.pdf | PASS
IPB120N04S4-01 | Infineon | PG-TO263-3-2 | 40 | 120 | No |  | 10 | 1.5 | 135 | 18 | 57 |  |  | 46.5 | 2.903225806 | 1.3 | https://www.mouser.com/datasheet/3/70/1/Infineon_IPP_B_I120N04S4_01_DS_v01_00_en.pdf | PASS
IQE020N04LM6CG | Infineon | PG-TTFN-9 | 40 | 166 | Yes | 20 | 10 | 2.05 | 25 | 3.1 | 4.6 |  |  | 4.9 | 5.102040816 | 1 | https://www.mouser.com/datasheet/3/70/1/infineon_iqe020n04lm6cg_datasheet_en.pdf | PASS
IQE020N04LM6CGSC | Infineon | PG-WHTFN-9 | 40 | 166 | Yes | 20 | 10 | 2.05 | 25 | 3.1 | 4.6 |  |  | 4.9 | 5.102040816 | 1 | https://www.mouser.com/datasheet/3/70/1/infineon_iqe020n04lm6cgsc_datasheet_en.pdf | PASS
IAUCN04S7L050H | Infineon | PG-TDSON-8-57 | 40 | 65 | Yes | 16 | 10 | 5.04 | 11 | 1.9 | 2.1 |  |  | 2.95 | 3.728813559 | 1.02 | https://www.mouser.com/datasheet/3/70/1/infineon_iaucn04s7l050h_datasheet_en.pdf | REJECT: Low Vgs (16.0V < 18V)
BSC019N04LS | Infineon | PG-TDSON-8 | 40 | 161 | Yes | 20 | 10 | 1.9 | 41 | 6.7 | 7.6 |  |  | 8.1 | 5.0617 | 1 | https://www.mouser.com/datasheet/3/70/1/Infineon_BSC019N04LS_DataSheet_v02_03_EN.pdf | PASS
TPCP8011 | Toshiba | PS-8 | 40 | 5 | No |  | 10 | 31.8 | 11.8 | 3.9 |  | 2.1 |  | 4.7 | 2.51 | 1.2 | https://www.mouser.com/datasheet/3/105/1/050DEFB01FF660340A8E3550E1704D4016C281B501AEBFFF75834FDC1B84A5DE.pdf | REJECT: Low Id (5.0A < 7.5A)
IAUCN04S7N054H | Infineon | PG-TDSON-8-57 | 40 | 62 | No |  | 10 | 5.41 | 9 | 2 | 3 |  |  | 3.5 | 2.571428571 | 1.02 | https://www.mouser.com/datasheet/3/70/1/infineon_iaucn04s7n054h_datasheet_en.pdf | PASS
ISC011N04NM7V | Infineon | PG-TDSON-8 | 40 | 256 | No |  | 10 | 1.1 | 58 | 13 | 19 |  |  | 21 | 2.761904762 | 1 | https://www.mouser.com/catalog/specsheets/Infenion_6-24-2025_DS_ISC011N04NM7V_1_0.pdf | PASS
ISCH99N04NM7V | Infineon | PG-TDSON-8 | 40 | 284 | No |  | 10 | 0.99 | 68 | 14.5 | 21 |  |  | 24 | 2.833333333 | 1 | https://www.mouser.com/catalog/specsheets/Infineon_6-24-2025_DS_ISCH99N04NM7V_1_0.pdf | PASS
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
