Hrishikesh-Acharyya/Synchronous_buck_PMIC/Mosfet_extraction_pipeline/excel_sheets/mosfet_urls.xlsx

Part_Number | Manufacturer | Package_Case | V_dss_Volts | Id_continuous_Amps | Logic_Level | Max_Vgs_Rating_Volts | Test_Vgs_Volts | Rds_on_max_mOhm | Qg_total_nC | Qgd_gate_drain_nC | Qgs_total_nC | Qgs1_pre_thresh_nC | Qgs2_post_thresh_nC | Qsw_switching_nC | Qg_Qsw_ratio | Vsd_body_diode_Volts | Datasheet_URL
AM4874N-CT |  |  |  |  |  |  |  |  |  |  |  |  |  |  |  |  | //mm.digikey.com/Volume0/opasdata/d220001/medias/docus/6133/AM4874N.pdf
AM4874N | Analog Power | SO-8 | 30 | 16.8 | No |  | 4.5 | 12 | 15 | 7 | 5.6 |  |  | 9.8 | 1.530612245 | 0.74 | //mm.digikey.com/Volume0/opasdata/d220001/medias/docus/6133/AM4874N.pdf
AM4434N | Analog Power | SOIC-8 | 30 | 18.6 | Yes | 12 | 4.5 | 6 | 25 | 9 | 6 |  |  | 12 | 2.083333333 | 0.7 | //mm.digikey.com/Volume0/opasdata/d220001/medias/docus/6133/AM4434N.pdf
AM6612N | Analog Power | SO-8 | 30 | 9.7 | No |  | 4.5 | 30 | 4 | 1.9 | 1.3 |  |  | 2.55 | 1.56862745 | 0.82 | //mm.digikey.com/Volume0/opasdata/d220001/medias/docus/6167/AM6612N.pdf
AM4362N | Analog Power | SO-8 | 30 | 19 | No |  | 4.5 | 8 | 21 | 8.5 | 4.3 |  |  | 10.65 | 1.971830986 | 0.74 | //mm.digikey.com/Volume0/opasdata/d220001/medias/docus/6167/AM4362N.pdf
AM4434N-CT |  |  |  |  |  |  |  |  |  |  |  |  |  |  |  |  | //mm.digikey.com/Volume0/opasdata/d220001/medias/docus/6133/AM4434N.pdf
AM4840N | Analog Power | SO-8 | 40 | 9.7 | No |  | 4.5 | 27 | 10 | 3.3 | 3.5 |  |  | 5.05 | 1.98019802 | 0.78 | //mm.digikey.com/Volume0/opasdata/d220001/medias/docus/6167/AM4840N.pdf
AM4842N | Analog Power | SOIC-8 | 40 | 13.8 | No |  | 4.5 | 14 | 20 | 9.6 | 5.6 |  |  | 12.4 | 1.6129 | 0.74 | //mm.digikey.com/Volume0/opasdata/d220001/medias/docus/6167/AM4842N.pdf
AOD66406 | Alpha & Omega Semiconductor | TO-252 | 40 | 60 | Yes | 20 | 10 | 6.1 | 20 | 3 | 5.5 |  |  | 5.75 | 3.47826087 | 1 | https://aosmd.com/res/data_sheets/AOD66406.pdf
AOD454A | Alpha & Omega Semiconductor | TO-252 | 40 | 20 | No |  | 10 | 30 | 8.3 | 1.6 | 2.3 |  |  | 2.75 | 3.018181818 | 1 | https://aosmd.com/res/data_sheets/AOD454A.pdf
AOD4184A | Alpha & Omega Semiconductor | TO252 DPAK | 40 | 50 | No |  | 10 | 7 | 27 | 6 | 5 |  |  | 8.5 | 3.176 | 1 | https://aosmd.com/res/data_sheets/AOD4184A.pdf
FDD8444 |  |  |  |  |  |  |  |  |  |  |  |  |  |  |  |  | https://www.onsemi.com/pub/Collateral/FDD8444-D.pdf
FDD86367-F085 |  |  |  |  |  |  |  |  |  |  |  |  |  |  |  |  | https://www.onsemi.com/pub/Collateral/FDD86367_F085-D.PDF
ZXMN7A11K | Zetex Semiconductors | DPAK | 70 | 6.1 | No |  | 10 | 130 | 7.4 | 1.8 | 1.06 |  |  | 2.33 | 3.175965665 | 0.95 | https://www.diodes.com/assets/Datasheets/ZXMN7A11K.pdf
STD64N4F6AG | STMicroelectronics | DPAK | 40 | 54 | No |  | 10 | 8.2 | 44 | 12 | 15 |  |  | 19.5 | 2.256410256 | 1.3 | https://www.st.com/content/ccc/resource/technical/document/datasheet/2e/44/68/88/e2/a0/49/83/DM00185474.pdf/files/DM00185474.pdf/jcr:content/translations/en.D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
DMTH43M8LK3Q | Diodes Incorporated | TO252 (DPAK) | 40 | 100 | No |  | 10 | 3.6 | 38.5 | 6.9 | 6.9 |  |  | 10.35 | 3.719806763 | 1.2 | https://www.diodes.com/datasheet/download/DMTH43M8LK3Q.pdf
FDD86381-F085 |  |  |  |  |  |  |  |  |  |  |  |  |  |  |  |  | https://www.onsemi.com/pub/Collateral/FDD86381_F085-D.PDF
STD44N4LF6 | STMicroelectronics | DPAK | 40 | 44 | Yes | 20 | 10 | 12.5 | 22 | 4.3 | 5 |  |  | 6.8 | 3.235 | 1.1 | //mm.digikey.com/Volume0/opasdata/d220001/medias/docus/8880/STD44N4LF6.pdf
NVD5C486NLT4G |  |  |  |  |  |  |  |  |  |  |  |  |  |  |  |  | https://www.onsemi.com/pdf/datasheet/nvd5c486nl-d.pdf
SUD50N04-8m8P | Vishay Siliconix | TO-252 | 40 | 50 | No |  | 10 | 8.8 | 37 | 4.5 | 6.5 |  |  | 7.75 | 4.774193548 | 1.2 | https://www.vishay.com/docs/68647/sud50n04.pdf
STD95N4LF3 | STMicroelectronics | DPAK | 40 | 80 | Yes | 16 | 10 | 6 | 50 | 9.5 | 7 |  |  | 13 | 3.846153846 | 1.5 | https://www.st.com/content/ccc/resource/technical/document/datasheet/ae/64/8a/5d/98/75/42/80/CD00225038.pdf/files/CD00225038.pdf/jcr:content/translations/en.C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
FDD86369 |  |  |  |  |  |  |  |  |  |  |  |  |  |  |  |  | https://www.onsemi.com/pub/Collateral/FDD86369-D.pdf
STD110N8F6 | STMicroelectronics | DPAK | 80 | 80 | No |  | 10 | 6.5 | 150 | 30 | 40 |  |  | 50 | 3 | 1.2 | https://www.st.com/content/ccc/resource/technical/document/datasheet/1d/ab/cc/48/cb/8b/4c/10/DM00151073.pdf/files/DM00151073.pdf/jcr:content/translations/en.D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
NVD5C460NLT4G |  |  |  |  |  |  |  |  |  |  |  |  |  |  |  |  | https://www.onsemi.com/pdf/datasheet/nvd5c460nl-d.pdf
STB120N4LF6 | STMicroelectronics | D²PAK | 40 | 80 | Yes | 20 | 10 | 4 | 80 | 15 | 15 |  |  | 22.5 | 3.56 | 1.1 | //mm.digikey.com/Volume0/opasdata/d220001/medias/docus/8880/STD120N4LF6.pdf
FDD86367 |  |  |  |  |  |  |  |  |  |  |  |  |  |  |  |  | https://www.onsemi.com/pub/Collateral/FDD86367-D.PDF
DMN4040SK3-13 |  |  |  |  |  |  |  |  |  |  |  |  |  |  |  |  | //mm.digikey.com/Volume0/opasdata/d220001/medias/docus/6130/DMN4040SK3.pdf
PJD40N04_L2_00001 |  |  |  |  |  |  |  |  |  |  |  |  |  |  |  |  | https://www.panjit.com.tw/upload/datasheet/PJD40N04.pdf
DMN4036LK3 | Diodes Incorporated | TO252-3L | 40 | 12.2 | No |  | 10 | 36 | 9.2 | 2.7 | 1.7 |  |  | 3.55 | 2.591549296 | 1.1 | https://www.diodes.com/assets/Datasheets/DMN4036LK3.pdf
DMN4026SK3 | Diodes Incorporated | TO252 | 40 | 28 | No |  | 10 | 24 | 21.3 | 3 | 3.7 |  |  | 4.85 | 4.39 | 1 | https://www.diodes.com/assets/Datasheets/DMN4026SK3.pdf
ZXMN6A08K | Diodes Incorporated | TO-252 | 60 | 7.9 | No |  | 10 | 80 | 5.8 | 1.9 | 1.4 |  |  | 2.6 | 2.230769231 | 0.95 | https://www.diodes.com/assets/Datasheets/ZXMN6A08K.pdf
DMTH4005SK3Q | Diodes Incorporated | TO252 (DPAK) | 40 | 95 | No |  | 10 | 4.5 | 49.1 | 13 | 10.3 |  |  | 18.15 | 2.71 | 0.9 | https://www.diodes.com/datasheet/download/DMTH4005SK3Q.pdf
DMT8012LK3 | Diodes Incorporated | TO252 (DPAK) | 80 | 44 | No |  | 10 | 17 | 34 | 4.5 | 6 |  |  | 7.5 | 4.533333333 | 1.2 | https://www.diodes.com/assets/Datasheets/DMT8012LK3.pdf
DMTH43M8LK3 | Diodes Incorporated | TO252 (DPAK) | 40 | 100 | No |  | 10 | 3.6 | 38.5 | 6.9 | 6.9 |  |  | 10.35 | 3.719806763 | 1.2 | https://www.diodes.com/assets/Datasheets/DMTH43M8LK3.pdf
ZXMN4A06K | Zetex Semiconductors | DPAK | 40 | 10.9 | No |  | 10 | 50 | 17.1 | 3.4 | 2.41 |  |  | 4.605 | 3.713355049 | 0.95 | https://www.diodes.com/assets/Datasheets/ZXMN4A06K.pdf
FDD86369-F085 |  |  |  |  |  |  |  |  |  |  |  |  |  |  |  |  | https://www.onsemi.com/pub/Collateral/FDD86369_F085-D.PDF
NVD5C478NLT4G |  |  |  |  |  |  |  |  |  |  |  |  |  |  |  |  | https://www.onsemi.com/pdf/datasheet/nvd5c478nl-d.pdf
RD3G08CBKHRB | ROHM Semiconductor | TO-252 | 40 | 80 | No |  | 10 | 3.1 | 41 | 7.3 | 6.4 |  |  | 10.5 | 3.904761905 | 1.5 | https://fscdn.rohm.com/en/products/databook/datasheet/discrete/transistor/mosfet/rd3g08cbkhrbtl-e.pdf
RD3G07BBG | ROHM Semiconductor | TO-252 | 40 | 150 | No |  | 10 | 2.3 | 56 | 10 | 8.8 |  |  | 14.4 | 3.888888889 | 1.2 | https://fscdn.rohm.com/en/products/databook/datasheet/discrete/transistor/mosfet/rd3g07bbgtl1-e.pdf
NVD5C434NT4G |  |  |  |  |  |  |  |  |  |  |  |  |  |  |  |  | https://www.onsemi.com/pdf/datasheet/nvd5c434n-d.pdf
DMN4030LK3 | Diodes Incorporated | TO252 (DPAK) | 40 | 9.6 | No |  | 10 | 30 | 12.9 | 3.6 | 2.3 |  |  | 4.75 | 2.715789474 | 1.1 | https://www.diodes.com/assets/Datasheets/DMN4030LK3.pdf
PJD40N04-AU_L2_000A1 |  |  |  |  |  |  |  |  |  |  |  |  |  |  |  |  | https://www.panjit.com.tw/upload/datasheet/PJD40N04-AU.pdf
DMTH4007LK3Q | Diodes Incorporated | TO252 (DPAK) | 40 | 70 | No |  | 10 | 7.3 | 29.1 | 3.5 | 5.9 |  |  | 6.45 | 4.51 | 1.2 | https://www.diodes.com/datasheet/download/DMTH4007LK3Q.pdf
DMTH4007SK3 | Diodes Incorporated | TO252 (DPAK) | 40 | 76 | No |  | 10 | 6 | 41.9 | 11.5 | 10 |  |  | 16.5 | 2.539393939 | 1.2 | https://www.diodes.com/assets/Datasheets/DMTH4007SK3.pdf
DMNH4006SK3Q | Diodes Incorporated | TO252 (DPAK) | 40 | 140 | No |  | 10 | 6 | 51 | 20.4 | 9.6 |  |  | 25.2 | 2.0238 | 1.2 | https://www.diodes.com/datasheet/download/DMNH4006SK3Q.pdf
DI100N04D1 | Diotec Semiconductor | TO-252AA | 40 | 100 | No |  | 10 | 4 | 143 | 28 | 22 |  |  | 39 | 3.666666667 | 1.2 | https://diotec.com/request/datasheet/di100n04d1.pdf
NVD5C486NT4G |  |  |  |  |  |  |  |  |  |  |  |  |  |  |  |  | https://www.onsemi.com/pdf/datasheet/nvd5c486n-d.pdf
SQD50N04-5m6 | Vishay Siliconix | TO-252 | 40 | 50 | No |  | 10 | 5.6 | 55 | 16 | 11 |  |  | 21.5 | 2.558139535 | 1.5 | https://www.vishay.com/docs/62666/sqd50n04-5m6.pdf
MCU90N04YHE3 | Micro Commercial Components | DPAK | 40 | 90 | No |  | 10 | 3.1 | 38 | 12.4 | 10.4 |  |  | 17.6 | 2.15909 | 1.2 | https://www.mccsemi.com/pdf/Products/MCU90N04YHE3(DPAK).pdf
STB95N4F3 | STMicroelectronics | D²PAK | 40 | 80 | No |  | 10 | 5.8 | 40 | 8 | 11 |  |  | 13.5 | 2.962962963 | 1.5 | https://www.st.com/content/ccc/resource/technical/document/datasheet/group2/d0/4e/c0/2b/36/f5/4e/06/CD00153132/files/CD00153132.pdf/jcr:content/translations/e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
STD80N4F6 | STMicroelectronics | DPAK | 40 | 80 | No |  | 10 | 6 | 36 | 9 | 11 |  |  | 14.5 | 2.482758621 | 1.3 | //mm.digikey.com/Volume0/opasdata/d220001/medias/docus/8880/STD80N4F6.pdf
NVD5C460NT4G |  |  |  |  |  |  |  |  |  |  |  |  |  |  |  |  | https://www.onsemi.com/pdf/datasheet/nvd5c460n-d.pdf
NVD5C454NT4G |  |  |  |  |  |  |  |  |  |  |  |  |  |  |  |  | https://www.onsemi.com/pdf/datasheet/nvd5c454n-d.pdf
MCU2D8N04YHQ | Micro Commercial Components | DPAK(TO-252) | 40 | 160 | No |  | 10 | 2.8 | 42 | 9.4 | 15 |  |  | 16.9 | 2.4852 | 1.2 | https://www.mccsemi.com/pdf/Products/MCU2D8N04YHQ(DPAK).pdf
XP4N4R2H |  |  |  |  |  |  |  |  |  |  |  |  |  |  |  |  | http://download.xsemi-corporation.com/datasheet/XP4N4R2H.pdf
PJD55N04S-AU_L2_002A1 |  |  |  |  |  |  |  |  |  |  |  |  |  |  |  |  | https://www.panjit.com.tw/upload/datasheet/PJD55N04S-AU.pdf
PJD50N04V-AU_L2_002A1 |  |  |  |  |  |  |  |  |  |  |  |  |  |  |  |  | https://www.panjit.com.tw/upload/datasheet/PJD50N04V-AU.pdf
PJD80N04_L2_00001 |  |  |  |  |  |  |  |  |  |  |  |  |  |  |  |  | https://www.panjit.com.tw/upload/datasheet/PJD80N04.pdf
MCU7D2N04YHQ | Micro Commercial Components | DPAK(TO-252) | 40 | 60 | No |  | 10 | 7.2 | 13 | 2.9 | 4.6 |  |  | 5.2 | 2.5 | 1.2 | https://www.mccsemi.com/pdf/Products/MCU7D2N04YHQ(DPAK).pdf
MCU6D0N04YHQ | Micro Commercial Components | DPAK(TO-252) | 40 | 72 | No |  | 10 | 6 | 19 | 3.5 | 8.2 |  |  | 7.6 | 2.5 | 1.2 | https://www.mccsemi.com/pdf/Products/MCU6D0N04YHQ(DPAK).pdf
PJD55N04V-AU_L2_002A1 |  |  |  |  |  |  |  |  |  |  |  |  |  |  |  |  | https://www.panjit.com.tw/upload/datasheet/PJD55N04V-AU.pdf
PJD60N04S-AU_L2_002A1 |  |  |  |  |  |  |  |  |  |  |  |  |  |  |  |  | https://www.panjit.com.tw/upload/datasheet/PJD60N04S-AU.pdf
MCU3D6N04YQ | Micro Commercial Components | DPAK(TO-252) | 40 | 110 | No |  | 10 | 3.6 | 32.7 | 8.4 | 10 |  |  | 13.4 | 2.440298507 | 1.2 | https://www.mccsemi.com/pdf/Products/MCU3D6N04YQ(DPAK).pdf
PJD60N04V-AU_L2_002A1 |  |  |  |  |  |  |  |  |  |  |  |  |  |  |  |  | https://www.panjit.com.tw/upload/datasheet/PJD60N04V-AU.pdf
PJD65N04S-AU_L2_002A1 |  |  |  |  |  |  |  |  |  |  |  |  |  |  |  |  | https://www.panjit.com.tw/upload/datasheet/PJD65N04S-AU.pdf
DMTH4004LK3 | Diodes Incorporated | TO252 | 40 | 100 | No |  | 10 | 3 | 83 | 11.2 | 10 |  |  | 16.2 | 5.12 | 1.2 | https://www.diodes.com/assets/Datasheets/DMTH4004LK3.pdf
AG087FGD3HRB | ROHM | DPAK | 40 | 40 | No |  | 10 | 7 | 14.9 | 3 | 2.8 |  |  | 4.4 | 3.386363636 | 1.5 | https://fscdn.rohm.com/en/products/databook/datasheet/discrete/transistor/mosfet/ag087fgd3hrbtl-e.pdf
PJD75N04V-AU_L2_002A1 |  |  |  |  |  |  |  |  |  |  |  |  |  |  |  |  | https://www.panjit.com.tw/upload/datasheet/PJD75N04V-AU.pdf
PJD80N04S-AU_L2_002A1 |  |  |  |  |  |  |  |  |  |  |  |  |  |  |  |  | https://www.panjit.com.tw/upload/datasheet/PJD80N04S-AU.pdf
RD3G08DBLHRB | ROHM Semiconductor | TO-252 | 40 | 80 | No |  | 10 | 4.2 | 28 | 5.4 | 7.1 |  |  | 8.95 | 3.1285 | 1.5 | https://fscdn.rohm.com/en/products/databook/datasheet/discrete/transistor/mosfet/rd3g08dblhrbtl-e.pdf
MCU2D5N04YH | Micro Commercial Components | DPAK(TO-252) | 40 | 130 | No |  | 10 | 2.5 | 57 | 5.7 | 27 |  |  | 19.2 | 2.96875 | 1.2 | https://www.mccsemi.com/pdf/Products/MCU2D5N04YH(DPAK).pdf
AG086FGD3HRB | ROHM | TO-252 | 40 | 80 | No |  | 10 | 4.1 | 28 | 5.4 | 4.6 |  |  | 7.7 | 3.636363636 | 1.5 | https://fscdn.rohm.com/en/products/databook/datasheet/discrete/transistor/mosfet/ag086fgd3hrbtl-e.pdf
MCU2D5N04YHQ | Micro Commercial Components | DPAK(TO-252) | 40 | 130 | No |  | 10 | 2.5 | 57 | 5.7 | 27 |  |  | 19.2 | 2.96875 | 1.2 | https://www.mccsemi.com/pdf/Products/MCU2D5N04YHQ(DPAK).pdf
NVD5C464NT4G |  |  |  |  |  |  |  |  |  |  |  |  |  |  |  |  | https://www.onsemi.com/pdf/datasheet/nvd5c464n-d.pdf
MCU3D8N04YHQ | Micro Commercial Components | DPAK(TO-252) | 40 | 100 | No |  | 10 | 3.8 | 23 | 3 | 7.5 |  |  | 6.75 | 3.407407407 | 1.2 | https://www.mccsemi.com/pdf/Products/MCU3D8N04YHQ(DPAK).pdf
NVD5C454NLT4G |  |  |  |  |  |  |  |  |  |  |  |  |  |  |  |  | https://www.onsemi.com/pdf/datasheet/nvd5c454nl-d.pdf
AG185FGD3HRB | ROHM | TO-252 | 40 | 80 | No |  | 10 | 3.2 | 42 | 8 | 10.7 |  |  | 13.35 | 3.146 | 1.5 | https://fscdn.rohm.com/en/products/databook/datasheet/discrete/transistor/mosfet/ag185fgd3hrbtl-e.pdf
NVD5C446NT4G |  |  |  |  |  |  |  |  |  |  |  |  |  |  |  |  | https://www.onsemi.com/pdf/datasheet/nvd5c446n-d.pdf
MCU110N08Y | Micro Commercial Components | DPAK(TO-252) | 80 | 110 | No |  | 10 | 5.6 | 88 | 19 | 21 |  |  | 29.5 | 2.983050847 | 1.2 | https://www.mccsemi.com/pdf/Products/MCU110N08Y(DPAK).pdf
RD3G08BBLHRB | ROHM Semiconductor | TO-252 | 40 | 80 | No |  | 10 | 2.3 | 82 | 15.7 | 22 |  |  | 26.7 | 3.07 | 1.5 | https://fscdn.rohm.com/en/products/databook/datasheet/discrete/transistor/mosfet/rd3g08bblhrbtl-e.pdf
STD5407NT4G |  |  |  |  |  |  |  |  |  |  |  |  |  |  |  |  | //mm.digikey.com/Volume0/opasdata/d220001/medias/docus/1080/NTD%2CNVD%2CSTD5407N.pdf
NVD5805NT4G |  |  |  |  |  |  |  |  |  |  |  |  |  |  |  |  | //mm.digikey.com/Volume0/opasdata/d220001/medias/docus/588/NTD5805N%2CNVD5805N.pdf
FDD9411-F085 |  |  |  |  |  |  |  |  |  |  |  |  |  |  |  |  | https://www.onsemi.com/pdf/datasheet/fdd9411_f085-d.pdf
SFT1450-TL-H |  |  |  |  |  |  |  |  |  |  |  |  |  |  |  |  | //mm.digikey.com/Volume0/opasdata/d220001/medias/docus/501/SFT1450.pdf
NTDV5805NT4G |  |  |  |  |  |  |  |  |  |  |  |  |  |  |  |  | //mm.digikey.com/Volume0/opasdata/d220001/medias/docus/588/NTD5805N%2CNVD5805N.pdf
NVD5890NT4G |  |  |  |  |  |  |  |  |  |  |  |  |  |  |  |  | //mm.digikey.com/Volume0/opasdata/d220001/medias/docus/590/NVD5890N.pdf
NTD5804NT4G |  |  |  |  |  |  |  |  |  |  |  |  |  |  |  |  | https://www.onsemi.com/pdf/datasheet/ntd5804n-d.pdf
GSFD0460 | GOOD-ARK SEMICONDUCTOR | TO-252 (DPAK) | 40 | 60 | No |  | 4.5 | 8.8 | 16.2 | 6.05 | 3.85 |  |  | 7.975 | 2.03 | 1 | https://goodarksemi.com/docs/datasheets/mosfets/GSFD0460.pdf
NVD5802NT4G |  |  |  |  |  |  |  |  |  |  |  |  |  |  |  |  | //mm.digikey.com/Volume0/opasdata/d220001/medias/docus/1028/NTD%2CNVD5802N.pdf
G160N04K | GOFORD | TO-252 | 40 | 25 | No |  | 10 | 15 | 20 | 3.1 | 3.8 |  |  | 5 | 4 | 1.2 | https://www.gofordsemi.com/upload/cn/propdf/G160N04K.pdf
NTD5C446NT4G |  |  |  |  |  |  |  |  |  |  |  |  |  |  |  |  | //mm.digikey.com/Volume0/opasdata/d220001/medias/docus/2117/NTD5C446N_Web.pdf
PJD50N04_L2_00001 |  |  |  |  |  |  |  |  |  |  |  |  |  |  |  |  | https://www.panjit.com.tw/upload/datasheet/PJD50N04.pdf
GSFD4003 | GOOD-ARK SEMICONDUCTOR | TO-252 (DPAK) | 40 | 240 | No |  | 10 | 3 | 108 | 30 | 34 |  |  | 47 | 2.29787234 | 1.2 | https://goodarksemi.com/docs/datasheets/mosfets/GSFD4003.pdf
FDD8445-F085 |  |  |  |  |  |  |  |  |  |  |  |  |  |  |  |  | https://www.onsemi.com/pub/Collateral/FDD8445_F085-D.PDF
STD5406NT4G |  |  |  |  |  |  |  |  |  |  |  |  |  |  |  |  | https://www.onsemi.com/pdf/datasheet/ntd5406n-d.pdf
FDD9411L-F085 |  |  |  |  |  |  |  |  |  |  |  |  |  |  |  |  | https://www.onsemi.com/pub/Collateral/FDD9411L_F085-D.PDF
FDD9410-F085 |  |  |  |  |  |  |  |  |  |  |  |  |  |  |  |  | https://www.onsemi.com/pub/Collateral/FDD9410_F085-D.PDF
G60N04K | GOFORD | TO-252 | 40 | 60 | No |  | 10 | 7 | 42 | 9 | 7 |  |  | 12.5 | 3.36 | 1.2 | https://www.gofordsemi.com/upload/cn/propdf/G60N04K.pdf
UMW IRFR7440TR | UMW | TO-252(DPAK) | 40 | 90 | No |  | 10 | 2.4 | 89 | 26 | 26 |  |  | 39 | 2.28 | 1.3 | https://www.umw-ic.com/static/pdf/088030c3b73bfce81e8e16fc94c9098b.pdf
NVDD5894NLT4G |  |  |  |  |  |  |  |  |  |  |  |  |  |  |  |  | //mm.digikey.com/Volume0/opasdata/d220001/medias/docus/27/NVDD5894NL.pdf
GT060N04K | GOFORD | TO-252 | 40 | 62 | No |  | 10 | 8 | 25 | 6 | 9 |  |  | 10.5 | 2.380952381 | 1.2 | https://www.gofordsemi.com/upload/cn/propdf/GT060N04K.pdf
FDD8445 |  |  |  |  |  |  |  |  |  |  |  |  |  |  |  |  | https://www.onsemi.com/pub/Collateral/FDD8445-D.pdf
NTD5C434NT4G |  |  |  |  |  |  |  |  |  |  |  |  |  |  |  |  | https://www.onsemi.com/pdf/datasheet/ntd5c434n-d.pdf
SQD40052EL | Vishay Siliconix | TO-252 | 40 | 30 | No |  | 10 | 6 | 34.5 | 6.6 | 6.1 |  |  | 9.65 | 3.58 | 1.5 | https://www.vishay.com/docs/77607/sqd40052el.pdf
FDD8647L |  |  |  |  |  |  |  |  |  |  |  |  |  |  |  |  | https://www.onsemi.com/pub/Collateral/FDD8647L-D.PDF
NTAT6H406NT4G |  |  |  |  |  |  |  |  |  |  |  |  |  |  |  |  | https://www.onsemi.com/pdf/datasheet/ntat6h406n-d.pdf
FDD8453LZ-F085 |  |  |  |  |  |  |  |  |  |  |  |  |  |  |  |  | https://www.onsemi.com/pub/Collateral/FDD8453LZ_F085-D.PDF
AUIRL1404S |  |  |  |  |  |  |  |  |  |  |  |  |  |  |  |  | //mm.digikey.com/Volume0/opasdata/d220001/medias/docus/411/AUIRL1404S%2CL.pdf
NTD5802NT4G |  |  |  |  |  |  |  |  |  |  |  |  |  |  |  |  | https://www.onsemi.cn/pdf/datasheet/ntd5802n-d.pdf
TSM038N04LCP ROG |  |  |  |  |  |  |  |  |  |  |  |  |  |  |  |  | https://services.taiwansemi.com/storage/resources/datasheet/TSM038N04LCP_A1701.pdf
NVD5C478NT4G |  |  |  |  |  |  |  |  |  |  |  |  |  |  |  |  | https://www.onsemi.com/pdf/datasheet/nvd5c478n-d.pdf
FDD9409-F085 |  |  |  |  |  |  |  |  |  |  |  |  |  |  |  |  | https://www.onsemi.com/pub/Collateral/FDD9409_F085-D.PDF
MDD60N04D |  |  |  |  |  |  |  |  |  |  |  |  |  |  |  |  | //mm.digikey.com/Volume0/opasdata/d220001/medias/docus/7752/MDD60N04D000SD.pdf
BUK6212-40C,118 |  |  |  |  |  |  |  |  |  |  |  |  |  |  |  |  | https://assets.nexperia.com/documents/data-sheet/BUK6212-40C.pdf
VDR04N028LSA | Viitor Semiconductor | TO-252 | 40 | 117 | No |  | 10 | 2.8 | 46 | 6.6 | 9.5 |  |  | 11.35 | 4.05 | 1.3 | https://viitorsemi.com/wp-content/uploads/VDR04N028LSA_datasheet.pdf
GSFD4010 | Good-Ark Semiconductor | TO-252 (DPAK) | 40 | 60 | No |  | 4.5 | 14 | 16.2 | 6.05 | 3.85 |  |  | 7.975 | 2.0313 | 1 | https://goodarksemi.com/docs/datasheets/mosfets/GSFD4010.pdf
GT100N04K |  |  |  |  |  |  |  |  |  |  |  |  |  |  |  |  | http://www.gofordsemi.com/u_file/product/741/GOFORD-GT100N04K.pdf
VDR10N170LSA | Viitor Semiconductor | TO-252 | 100 | 44 | No |  | 10 | 17 | 22 | 6 | 3 |  |  | 7.5 | 2.93 | 1 | https://viitorsemi.com/wp-content/uploads/VDR10N170LSA_datasheet.pdf
VTR04N070LSA | Viitor Semiconductor | TO-252 | 40 | 72 | No |  | 10 | 7 | 72 | 13 | 11 |  |  | 18.5 | 3.89189 | 1.2 | https://viitorsemi.com/wp-content/uploads/VTR04N070LSA_datasheet.pdf
FDD8447L |  |  |  |  |  |  |  |  |  |  |  |  |  |  |  |  | https://www.onsemi.com/pub/Collateral/FDD8447L-D.pdf
DMTH8012LK3Q | Diodes Incorporated | TO252 (DPAK) | 80 | 50 | No |  | 10 | 16 | 46.8 | 12.2 | 6.9 |  |  | 15.65 | 2.990415335 | 1.2 | https://www.diodes.com/datasheet/download/DMTH8012LK3Q.pdf
DMTH8012LK3 | Diodes Incorporated | TO252 | 80 | 50 | No |  | 10 | 16 | 34 | 4.5 | 6 |  |  | 7.5 | 4.533333333 | 1.2 | https://www.diodes.com/assets/Datasheets/DMTH8012LK3.pdf
FDD86380-F085 |  |  |  |  |  |  |  |  |  |  |  |  |  |  |  |  | https://www.onsemi.com/pub/Collateral/FDD86380_F085-D.PDF
DMTH4007LK3 | Diodes Incorporated | TO252 | 40 | 70 | No |  | 10 | 7.3 | 29.1 | 3.5 | 5.9 |  |  | 6.45 | 4.5116 | 1.2 | https://www.diodes.com/assets/Datasheets/DMTH4007LK3.pdf
DMTH4004LK3Q | Diodes Incorporated | TO252 (DPAK) | 40 | 100 | No |  | 10 | 3 | 83 | 11.2 | 10 |  |  | 16.2 | 5.12345679 | 1.2 | https://www.diodes.com/datasheet/download/DMTH4004LK3Q.pdf
STD134N4F7AG | STMicroelectronics | DPAK | 40 | 80 | No |  | 10 | 3.5 | 41 | 11 | 15 |  |  | 18.5 | 2.216216 | 1.2 | https://www.st.com/content/ccc/resource/technical/document/datasheet/group3/50/75/04/92/24/b2/49/b2/DM00347434/files/DM00347434.pdf/jcr:content/translations/e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
SQD100N04-3m6 | Vishay Siliconix | TO-252 | 40 | 100 | No |  | 10 | 3.6 | 70 | 13 | 16 |  |  | 21 | 3.333333333 | 1.5 | https://www.vishay.com/docs/63836/sqd100n04-3m6.pdf
SQR40020ER | Vishay Siliconix | TO-252 Reverse Lead DPAK | 40 | 100 | No |  | 10 | 2.33 | 84 | 19.5 | 29.5 |  |  | 34.25 | 2.45255 | 1.5 | https://www.vishay.com/docs/76927/sqr40020er.pdf
PJD25N04_L2_00001 |  |  |  |  |  |  |  |  |  |  |  |  |  |  |  |  | https://www.panjit.com.tw/upload/datasheet/PJD25N04.pdf
PJD25N04-AU_L2_000A1 |  |  |  |  |  |  |  |  |  |  |  |  |  |  |  |  | https://www.panjit.com.tw/upload/datasheet/PJD25N04-AU.pdf
DMTH47M2SK3 | Diodes Incorporated | TO252 (DPAK) | 40 | 62 | No |  | 10 | 7.5 | 12.1 | 1.9 | 2 |  |  | 2.9 | 4.17 | 1.2 | https://www.diodes.com/assets/Datasheets/DMTH47M2SK3.pdf
AOD4186 | Alpha & Omega Semiconductor | TO-252 D-PAK | 40 | 35 | No |  | 10 | 15 | 17 | 4.5 | 2.5 |  |  | 5.75 | 2.956521739 | 1 | https://aosmd.com/res/data_sheets/AOD4186.pdf
MCU40N04HE3 | Micro Commercial Components | DPAK(TO-252) | 40 | 40 | No |  | 10 | 13 | 23 | 6 | 3.5 |  |  | 7.75 | 2.967741935 | 1.2 | https://www.mccsemi.com/pdf/Products/MCU40N04HE3(DPAK).pdf
DMN4036LK3Q-13 |  |  |  |  |  |  |  |  |  |  |  |  |  |  |  |  | //mm.digikey.com/Volume0/opasdata/d220001/medias/docus/8418/dmn4036lk3.pdf
PJD60N04-AU_L2_000A1 |  |  |  |  |  |  |  |  |  |  |  |  |  |  |  |  | https://www.panjit.com.tw/upload/datasheet/PJD60N04-AU.pdf
MCU90N04Y | Micro Commercial Components | DPAK | 40 | 90 | No |  | 10 | 3.1 | 38 | 12.4 | 10.4 |  |  | 17.6 | 2.159090909 | 1.2 | https://www.mccsemi.com/pdf/Products/MCU90N04Y(DPAK).pdf
DMN4030LK3Q | Diodes Incorporated | TO252 (DPAK) | 40 | 9.6 | No |  | 10 | 30 | 12.9 | 3.6 | 2.3 |  |  | 4.75 | 2.715789474 | 1.1 | https://www.diodes.com/datasheet/download/DMN4030LK3Q.pdf
DMTH4005SK3 | Diodes Incorporated | TO252 (DPAK) | 40 | 95 | No |  | 10 | 4.5 | 49.1 | 13 | 10.3 |  |  | 18.15 | 2.70523416 | 0.9 | https://www.diodes.com/assets/Datasheets/DMTH4005SK3.pdf
AOD2816 | Alpha & Omega Semiconductor | DPAK | 80 | 35 | No |  | 10 | 15 | 14.5 | 3.2 | 4.5 |  |  | 5.45 | 2.660550459 | 1 | https://aosmd.com/res/data_sheets/AOD2816.pdf
FDD3580 |  |  |  |  |  |  |  |  |  |  |  |  |  |  |  |  | //mm.digikey.com/Volume0/opasdata/d220001/medias/docus/2375/FDD3580%2C%20FDU3580.pdf
STD55N4F5 | STMicroelectronics | DPAK | 40 | 55 | No |  | 10 | 8.5 | 25 | 6 | 7 |  |  | 9.5 | 2.631578947 | 1.5 | //mm.digikey.com/Volume0/opasdata/d220001/medias/docus/416/STD55N4F5.pdf
STD5406NT4G-VF01 |  |  |  |  |  |  |  |  |  |  |  |  |  |  |  |  | https://www.onsemi.com/pdf/datasheet/ntd5406n-d.pdf
SUD06N10-225L-E3 |  |  |  |  |  |  |  |  |  |  |  |  |  |  |  |  | //mm.digikey.com/Volume0/opasdata/d220001/medias/docus/580/SUD06N10-225L.pdf
DMNH4011SK3Q | Diodes Incorporated | TO252 | 40 | 50 | No |  | 10 | 10 | 25.5 | 6.9 | 4.6 |  |  | 9.2 | 2.77173913 | 1.2 | https://www.diodes.com/datasheet/download/DMNH4011SK3Q.pdf
IRFR3504TRLPBF |  |  |  |  |  |  |  |  |  |  |  |  |  |  |  |  | //mm.digikey.com/Volume0/opasdata/d220001/medias/docus/890/IRF%28R%2CU%293504PbF.pdf
IRFR3504TRRPBF |  |  |  |  |  |  |  |  |  |  |  |  |  |  |  |  | //mm.digikey.com/Volume0/opasdata/d220001/medias/docus/890/IRF%28R%2CU%293504PbF.pdf
AOD2810 | Alpha & Omega Semiconductor | TO252 DPAK | 80 | 46 | No |  | 10 | 8.5 | 26.5 | 4 | 8.5 |  |  | 8.25 | 3.212121212 | 1 | https://aosmd.com/res/data_sheets/AOD2810.pdf
DMT8008LK3 | Diodes Incorporated | TO252 (DPAK) | 80 | 95 | No |  | 10 | 7 | 41.2 | 10.6 | 5 |  |  | 13.1 | 3.145038168 | 1.2 | https://www.diodes.com/assets/Datasheets/DMT8008LK3.pdf
DMT8008SK3 | Diodes Incorporated | TO252 (DPAK) | 80 | 90 | No |  | 10 | 7.8 | 34 | 12 | 6 |  |  | 15 | 2.27 | 1.2 | https://www.diodes.com/assets/Datasheets/DMT8008SK3.pdf
MCU120N04 | Micro Commercial Components | DPAK(TO-252) | 40 | 120 | No |  | 10 | 3.5 | 92.7 | 21.4 | 11.6 |  |  | 27.2 | 3.408088235 | 1.2 | https://www.mccsemi.com/pdf/Products/MCU120N04(DPAK).pdf
TSM038N04LCP |  |  |  |  |  |  |  |  |  |  |  |  |  |  |  |  | https://services.taiwansemi.com/storage/resources/datasheet/TSM038N04LCP_A1701.pdf
PJD100N04_L2_00001 |  |  |  |  |  |  |  |  |  |  |  |  |  |  |  |  | https://www.panjit.com.tw/upload/datasheet/PJD100N04.pdf
DI100N04D1 | Diotec Semiconductor | TO-252AA | 40 | 100 | No |  | 10 | 4 | 143 | 28 | 22 |  |  | 39 | 3.666666667 | 1.2 | https://diotec.com/request/datasheet/di100n04d1.pdf
IPD12CNE8N G |  |  |  |  |  |  |  |  |  |  |  |  |  |  |  |  | //mm.digikey.com/Volume0/opasdata/d220001/medias/docus/603/IPx12CNE8N_Rev1.06.pdf
BUK7213-40A,118 |  |  |  |  |  |  |  |  |  |  |  |  |  |  |  |  | //mm.digikey.com/Volume0/opasdata/d220001/medias/docus/370/BUK7213-40A.pdf
VN5160S-E | STMicroelectronics | SO-8 | 41 | 5.4 | Yes |  | 13 | 160 | 0 | 0 |  |  |  | 0 | 0 | 0.7 | https://www.st.com/resource/en/datasheet/vn5160s-e.pdf
SQD50N04-4m5L | Vishay Siliconix | TO-252 | 40 | 50 | No |  | 10 | 3.5 | 85 | 14 | 14 |  |  | 21 | 4.047619048 | 1.5 | https://www.vishay.com/docs/70623/sqd50n04.pdf
SQD100N04-3m6 | Vishay Siliconix | TO-252 | 40 | 100 | No |  | 10 | 3.6 | 70 | 13 | 16 |  |  | 21 | 3.333333333 | 1.5 | https://www.vishay.com/docs/63836/sqd100n04-3m6.pdf
DMNH4006SK3 | Diodes Incorporated | TO252 (DPAK) | 40 | 140 | No |  | 10 | 6 | 51 | 20.4 | 9.6 |  |  | 25.2 | 2.023809524 | 1.2 | https://www.diodes.com/assets/Datasheets/DMNH4006SK3.pdf
PJD100N04-AU_L2_000A1 |  |  |  |  |  |  |  |  |  |  |  |  |  |  |  |  | https://www.panjit.com.tw/upload/datasheet/PJD100N04-AU.pdf
AOD2146 | Alpha & Omega Semiconductor | TO-252 | 40 | 54 | No |  | 10 | 3.1 | 50 | 3 | 13.5 |  |  | 9.75 | 5.128 | 1 | https://aosmd.com/res/data_sheets/AOD2146.pdf
FDD8444L | Fairchild Semiconductor | TO-252AA | 40 | 50 | No |  | 5 | 6 | 46 | 21 | 16.3 | 5.4 | 10.9 | 31.9 | 1.44 | 1.25 | //mm.digikey.com/Volume0/opasdata/d220001/medias/docus/883/FDD8444L.pdf
AOD2144 | Alpha & Omega Semiconductor | TO-252 | 40 | 120 | No |  | 10 | 2.3 | 68 | 4.5 | 16.5 |  |  | 12.75 | 5.33 | 1 | https://aosmd.com/res/data_sheets/AOD2144.pdf
DMTH4004SK3 | Diodes Incorporated | TO252 | 40 | 100 | No |  | 10 | 3.2 | 68.6 | 14.2 | 16.8 |  |  | 22.6 | 3.0354 | 1.2 | https://www.diodes.com/assets/Datasheets/DMTH4004SK3.pdf
STB120N4F6 | STMicroelectronics | D²PAK | 40 | 80 | No |  | 10 | 4 | 65 | 16 | 20 |  |  | 26 | 2.5 | 1.1 | //mm.digikey.com/Volume0/opasdata/d220001/medias/docus/8880/STD120N4F6.pdf
SQD50N04-5m6 | Vishay Siliconix | TO-252 | 40 | 50 | No |  | 10 | 5.6 | 55 | 16 | 11 |  |  | 21.5 | 2.558139535 | 1.5 | https://www.vishay.com/docs/62666/sqd50n04-5m6.pdf
STD90N4F3 | STMicroelectronics | DPAK | 40 | 80 | No |  | 10 | 5.8 | 40 | 8 | 11 |  |  | 13.5 | 2.962962963 | 1.5 | https://www.st.com/content/ccc/resource/technical/document/datasheet/bb/f2/7c/b0/dc/57/49/0d/CD00177924.pdf/files/CD00177924.pdf/jcr:content/translations/en.C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
AUIRFR3504TRL |  |  |  |  |  |  |  |  |  |  |  |  |  |  |  |  | //mm.digikey.com/Volume0/opasdata/d220001/medias/docus/422/AUIRFR3504.pdf
DMTH4004SK3Q | Diodes Incorporated | TO252 (DPAK) | 40 | 100 | No |  | 10 | 3.2 | 68.6 | 14.2 | 16.8 |  |  | 22.6 | 3.04 | 1.2 | https://www.diodes.com/datasheet/download/DMTH4004SK3Q.pdf
STD170N4F7AG | STMicroelectronics | DPAK | 40 | 80 | No |  | 10 | 2.8 | 63 | 18 | 23 |  |  | 29.5 | 2.13559322 | 1.2 | https://www.st.com/content/ccc/resource/technical/document/datasheet/group3/ca/b2/80/fc/c0/77/4f/e2/DM00347907/files/DM00347907.pdf/jcr:content/translations/e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
FDD8451 |  |  |  |  |  |  |  |  |  |  |  |  |  |  |  |  | https://www.onsemi.com/pub/Collateral/FDD8451-D.PDF
AUIRLS3114Z | Infineon | D2-Pak | 40 | 122 | Yes | 16 | 10 | 4.9 | 35 | 16 | 11 |  |  | 21.5 | 1.627906977 | 1.3 | //mm.digikey.com/Volume0/opasdata/d220001/medias/docus/411/AUIRLS3114Z.pdf
STD95N04 |  |  |  |  |  |  |  |  |  |  |  |  |  |  |  |  | //mm.digikey.com/Volume0/opasdata/d220001/medias/docus/2598/STD95N04%2C%20STP95N04.pdf
IRFR3504ZTR |  |  |  |  |  |  |  |  |  |  |  |  |  |  |  |  | //mm.digikey.com/Volume0/opasdata/d220001/medias/docus/2580/IRFR3504Z%2C%20IRFU3504Z.pdf
IRFR3504ZTRL |  |  |  |  |  |  |  |  |  |  |  |  |  |  |  |  | //mm.digikey.com/Volume0/opasdata/d220001/medias/docus/2580/IRFR3504Z%2C%20IRFU3504Z.pdf
MCU60N04 | Micro Commercial Components | DPAK | 40 | 60 | No |  | 10 | 13 | 29 | 6.4 | 4.5 |  |  | 8.65 | 3.352601156 | 1.2 | https://www.mccsemi.com/pdf/Products/MCU60N04(DPAK).pdf
IRFR4104TRR |  |  |  |  |  |  |  |  |  |  |  |  |  |  |  |  | //mm.digikey.com/Volume0/opasdata/d220001/medias/docus/574/IR_PartNumberingSystem.pdf
PJD60N04_L2_00001 |  |  |  |  |  |  |  |  |  |  |  |  |  |  |  |  | //mm.digikey.com/Volume0/opasdata/d220001/medias/docus/7466/PJD60N04171013REV.00.pdf
IRFR4104TR |  |  |  |  |  |  |  |  |  |  |  |  |  |  |  |  | //mm.digikey.com/Volume0/opasdata/d220001/medias/docus/574/IR_PartNumberingSystem.pdf
IRFR4104TRL |  |  |  |  |  |  |  |  |  |  |  |  |  |  |  |  | //mm.digikey.com/Volume0/opasdata/d220001/medias/docus/574/IR_PartNumberingSystem.pdf
FDD8453LZ |  |  |  |  |  |  |  |  |  |  |  |  |  |  |  |  | https://www.onsemi.com/pub/Collateral/FDD8453LZ-D.pdf
SUD50N04-8m8P | Vishay Siliconix | TO-252 | 40 | 50 | No |  | 10 | 8.8 | 37 | 4.5 | 6.5 |  |  | 7.75 | 4.77 | 1.2 | https://www.vishay.com/docs/68647/sud50n04.pdf
SQD100N04-3m6L | Vishay Siliconix | TO-252 | 40 | 100 | No |  | 10 | 3.6 | 85 | 14 | 14 |  |  | 21 | 4.047619048 | 1.5 | https://www.vishay.com/docs/63837/sqd100n04-3m6l.pdf
SQR50N04-3m8 | Vishay Siliconix | TO-252 Reverse Lead DPAK | 40 | 50 | No |  | 10 | 3.8 | 70 | 13 | 16 |  |  | 21 | 3.333333333 | 1.5 | https://www.vishay.com/docs/62783/sqr50n04-3m8.pdf
FDD9407-F085 |  |  |  |  |  |  |  |  |  |  |  |  |  |  |  |  | https://www.onsemi.com/pub/Collateral/FDD9407_F085-D.PDF
SQD40020EL | Vishay Siliconix | TO-252 | 40 | 100 | No |  | 10 | 2.2 | 108 | 20 | 23.3 |  |  | 31.65 | 3.412322275 | 1.5 | https://www.vishay.com/docs/76897/sqd40020el.pdf
BUK7Y3R5-40E | Nexperia | LFPAK56 | 40 | 100 | No |  | 10 | 3.5 | 49.4 | 16.2 | 13.5 |  |  | 22.95 | 2.1525 | 1.2 | https://assets.nexperia.com/documents/data-sheet/BUK7Y3R5-40E.pdf
PSMN8R2-80YS | Nexperia | LFPAK | 80 | 82 | No |  | 10 | 8.5 | 55 | 12 | 15 | 10 | 5 | 17 | 3.235294118 | 1.2 | https://assets.nexperia.com/documents/data-sheet/PSMN8R2-80YS.pdf
PSMN1R4-40YLD | Nexperia | LFPAK56 | 40 | 240 | Yes | 20 | 10 | 1.4 | 96 | 13 | 15 | 9 | 6 | 19 | 5.0526 | 1.2 | https://assets.nexperia.com/documents/data-sheet/PSMN1R4-40YLD.pdf
PSMN1R8-40YLC | Nexperia | LFPAK; Power-SO8 (SOT669) | 40 | 100 | Yes | 20 | 10 | 1.8 | 96 | 10.9 | 15.5 | 8.4 | 7.1 | 18 | 5.33 | 1.1 | https://assets.nexperia.com/documents/data-sheet/PSMN1R8-40YLC.pdf
PSMN1R0-40YLD | Nexperia | LFPAK56 | 40 | 280 | Yes | 20 | 10 | 1.1 | 127 | 17 | 19 | 12 | 8 | 25 | 5.08 | 1.2 | https://assets.nexperia.com/documents/data-sheet/PSMN1R0-40YLD.pdf
BUK9Y29-40E | Nexperia | LFPAK56 | 40 | 25 | Yes | 15 | 5 | 29 | 5 | 1.9 | 1.1 |  |  | 2.45 | 2.04 | 1.2 | https://assets.nexperia.com/documents/data-sheet/BUK9Y29-40E.pdf
BUK9K25-40E | Nexperia | LFPAK56D | 40 | 18.2 | Yes | 15 | 5 | 29 | 6.3 | 2.4 | 1.4 |  |  | 3.1 | 2.03 | 1.2 | https://assets.nexperia.com/documents/data-sheet/BUK9K25-40E.pdf
PSMN045-80YS | Nexperia | LFPAK | 80 | 24 | No |  | 10 | 45 | 12.5 | 3.1 | 3.8 | 1.9 | 1.9 | 5 | 2.5 | 1.2 | https://assets.nexperia.com/documents/data-sheet/PSMN045-80YS.pdf
PSMN014-40YS | Nexperia | LFPAK | 40 | 46 | No |  | 10 | 14 | 12 | 2.4 | 5.4 | 2.2 | 3.2 | 5.6 | 2.142857 | 1.2 | https://assets.nexperia.com/documents/data-sheet/PSMN014-40YS.pdf
BUK7K18-40E | Nexperia | LFPAK56D | 40 | 24.2 | No |  | 10 | 19 | 11.8 | 4.3 | 3.6 |  |  | 6.1 | 1.93442623 | 1.2 | https://assets.nexperia.com/documents/data-sheet/BUK7K18-40E.pdf
BUK9Y14-40B | Nexperia | LFPAK | 40 | 56 | Yes | 15 | 5 | 14 | 21 | 9 | 3.7 |  |  | 10.85 | 1.93548387 | 1.2 | https://assets.nexperia.com/documents/data-sheet/BUK9Y14-40B.pdf
BUK9K8R7-40E | Nexperia | LFPAK56D | 40 | 30 | Yes | 15 | 5 | 9.4 | 15.7 | 5.3 | 3.2 |  |  | 6.9 | 2.275362319 | 1.2 | https://assets.nexperia.com/documents/data-sheet/BUK9K8R7-40E.pdf
PSMN013-80YS | Nexperia | LFPAK | 80 | 60 | No |  | 10 | 12.9 | 37 | 8 | 11 | 7 | 4 | 12 | 3.0833 | 1.2 | https://assets.nexperia.com/documents/data-sheet/PSMN013-80YS.pdf
BUK9Y09-40B,115 |  |  |  |  |  |  |  |  |  |  |  |  |  |  |  |  | https://assets.nexperia.com/documents/data-sheet/BUK9Y09-40B.pdf
PSMN2R8-40YSD | Nexperia | LFPAK56 | 40 | 160 | No |  | 10 | 2.8 | 44 | 7 | 13 | 8.8 | 4.2 | 11.2 | 3.928571429 | 1 | https://assets.nexperia.com/documents/data-sheet/PSMN2R8-40YSD.pdf
BUK7K6R2-40E | Nexperia | LFPAK56D | 40 | 40 | No |  | 10 | 5.8 | 32.3 | 10.5 | 7.2 |  |  | 14.1 | 2.29 | 1.2 | https://assets.nexperia.com/documents/data-sheet/BUK7K6R2-40E.pdf
BUK9Y3R0-40E | Nexperia | LFPAK56 | 40 | 100 | Yes | 15 | 5 | 3 | 35.5 | 10.7 | 11.7 |  |  | 16.55 | 2.145 | 1.2 | https://assets.nexperia.com/documents/data-sheet/BUK9Y3R0-40E.pdf
BUK7Y1R7-40H | Nexperia | LFPAK56 | 40 | 120 | No |  | 10 | 1.7 | 56 | 10 | 16 |  |  | 18 | 3.111 | 1.2 | https://assets.nexperia.com/documents/data-sheet/BUK7Y1R7-40H.pdf
BUK7V4R2-40H | Nexperia | LFPAK56D | 40 | 98 | No |  | 10 | 4.2 | 26 | 4.7 | 7.8 |  |  | 8.6 | 3.02 | 1 | https://assets.nexperia.com/documents/data-sheet/BUK7V4R2-40H.pdf
PSMN4R2-40VSH | Nexperia | LFPAK56D | 40 | 98 | No |  | 10 | 4.2 | 26 | 4.7 | 7.8 | 5.1 | 2.7 | 7.4 | 3.51 | 1 | https://assets.nexperia.com/documents/data-sheet/PSMN4R2-40VSH.pdf
BUK7Y1R0-40N | Nexperia | LFPAK56 | 40 | 320 | No |  | 10 | 0.97 | 135 | 42 | 26 |  |  | 55 | 2.454545455 | 1 | https://assets.nexperia.com/documents/data-sheet/BUK7Y1R0-40N.pdf
BUK7Y3R1-80M | Nexperia | LFPAK56 | 80 | 160 | No |  | 10 | 3.1 | 70 | 14 | 20 |  |  | 24 | 2.916666667 | 1 | https://assets.nexperia.com/documents/data-sheet/BUK7Y3R1-80M.pdf
PSMN3R5-80YSF | Nexperia | LFPAK56E | 80 | 150 | No |  | 10 | 3.5 | 75 | 13.1 | 22.5 | 15 | 7.6 | 20.7 | 3.623188406 | 1 | https://assets.nexperia.com/documents/data-sheet/PSMN3R5-80YSF.pdf
PSMNR90-40YLH | Nexperia | LFPAK56E | 40 | 300 | Yes | 20 | 10 | 0.94 | 120 | 13 | 20 | 12 | 8 | 21 | 5.714285714 | 1.2 | https://assets.nexperia.com/documents/data-sheet/PSMNR90-40YLH.pdf
BUK7Y21-40E | Nexperia | LFPAK56 | 40 | 33 | No |  | 10 | 21 | 10 | 3 | 2 |  |  | 4 | 2.5 | 1.2 | https://assets.nexperia.com/documents/data-sheet/BUK7Y21-40E.pdf
BUK9Y12-40E | Nexperia | LFPAK56 | 40 | 52 | Yes | 10 | 5 | 12 | 9.8 | 3.4 | 3.2 |  |  | 5 | 1.96 | 1.2 | https://assets.nexperia.com/documents/data-sheet/BUK9Y12-40E.pdf
BUK9Y21-40E | Nexperia | LFPAK56 | 40 | 33 | Yes | 15 | 5 | 21 | 7 | 2.7 | 1.2 |  |  | 3.3 | 2.121212121 | 1.2 | https://assets.nexperia.com/documents/data-sheet/BUK9Y21-40E.pdf
BUK7K25-40E | Nexperia | LFPAK56D | 40 | 27 | No |  | 10 | 25 | 7.9 | 2.6 | 1.5 |  |  | 3.35 | 2.3582 | 1.2 | https://assets.nexperia.com/documents/data-sheet/BUK7K25-40E.pdf
BUK9Y27-40B | Nexperia | LFPAK | 40 | 34 | Yes | 15 | 5 | 27 | 11 | 4.2 | 2.5 |  |  | 5.45 | 2.018348624 | 1.2 | https://assets.nexperia.com/documents/data-sheet/BUK9Y27-40B.pdf
BUK7Y7R6-40E | Nexperia | LFPAK56 | 40 | 79 | No |  | 10 | 7.6 | 26.2 | 8.2 | 5.4 |  |  | 10.9 | 2.403669725 | 1.2 | https://assets.nexperia.com/documents/data-sheet/BUK7Y7R6-40E.pdf
BUK7Y7R0-40H | Nexperia | LFPAK56 | 40 | 68 | No |  | 10 | 7 | 18 | 3.7 | 5.4 |  |  | 6.4 | 2.8125 | 1 | https://assets.nexperia.com/documents/data-sheet/BUK7Y7R0-40H.pdf
PSMN026-80YS | Nexperia | LFPAK | 80 | 34 | No |  | 10 | 27.5 | 20 | 5 | 6.4 | 3.7 | 2.7 | 7.7 | 2.597402597 | 1.2 | https://assets.nexperia.com/documents/data-sheet/PSMN026-80YS.pdf
PSMN8R3-40YS | Nexperia | LFPAK | 40 | 70 | No |  | 10 | 8.6 | 20 | 4.5 | 8 | 4 | 4 | 8.5 | 2.352941176 | 1.2 | https://assets.nexperia.com/documents/data-sheet/PSMN8R3-40YS.pdf
PSMN3R5-40YSD | Nexperia | LFPAK56 | 40 | 120 | No |  | 10 | 3.5 | 31 | 5 | 10 | 6.4 | 3.6 | 8.6 | 3.604651163 | 1.2 | https://assets.nexperia.com/documents/data-sheet/PSMN3R5-40YSD.pdf
BUK9K18-40E | Nexperia | LFPAK56D | 40 | 30 | Yes | 10 | 10 | 16 | 14.5 | 3 | 2 |  |  | 4 | 3.625 | 1.2 | https://assets.nexperia.com/documents/data-sheet/BUK9K18-40E.pdf
PSMN018-80YS | Nexperia | LFPAK | 80 | 45 | No |  | 10 | 18 | 26 | 6 | 8 | 4.7 | 3.3 | 9.3 | 2.795698925 | 1.2 | https://assets.nexperia.com/documents/data-sheet/PSMN018-80YS.pdf
BUK9V13-40H | Nexperia | LFPAK56D | 40 | 42 | Yes | 20 | 10 | 13.6 | 13.9 | 2.1 | 2.5 |  |  | 3.35 | 4.14925 | 1 | https://assets.nexperia.com/documents/data-sheet/BUK9V13-40H.pdf
BUK7K8R7-40E | Nexperia | LFPAK56D | 40 | 30 | No |  | 10 | 8.5 | 21.8 | 7.8 | 5.9 |  |  | 10.75 | 2.027906977 | 1.2 | https://assets.nexperia.com/documents/data-sheet/BUK7K8R7-40E.pdf
PSMN3R2-40YLB | Nexperia | LFPAK56 | 40 | 120 | Yes | 20 | 10 | 3.3 | 42 | 4.2 | 7.7 | 4.5 | 3 | 7.2 | 5.83 | 1 | https://assets.nexperia.com/documents/data-sheet/PSMN3R2-40YLB.pdf
NVTYS004N04CLTWG |  |  |  |  |  |  |  |  |  |  |  |  |  |  |  |  | https://www.onsemi.com/pdf/datasheet/nvtys004n04cl-d.pdf
BUK9Y4R4-40E | Nexperia | LFPAK56 | 40 | 100 | Yes | 15 | 5 | 4.4 | 26.8 | 8.7 | 7.7 |  |  | 12.55 | 2.14 | 1.2 | https://assets.nexperia.com/documents/data-sheet/BUK9Y4R4-40E.pdf
BUK7Y4R4-40E | Nexperia | LFPAK56 | 40 | 100 | No |  | 10 | 4.4 | 39 | 13 | 10 |  |  | 18 | 2.166666667 | 1.2 | https://assets.nexperia.com/documents/data-sheet/BUK7Y4R4-40E.pdf
BUK7Y3R5-40H | Nexperia | LFPAK56 | 40 | 120 | No |  | 10 | 3.5 | 31 | 6 | 10 |  |  | 11 | 2.818 | 1.2 | https://assets.nexperia.com/documents/data-sheet/BUK7Y3R5-40H.pdf
PSMN5R8-40YS | Nexperia | LFPAK | 40 | 90 | No |  | 10 | 5.7 | 28.8 | 7.8 | 9.8 | 5.1 | 4.7 | 12.5 | 2.304 | 1.2 | https://assets.nexperia.com/documents/data-sheet/PSMN5R8-40YS.pdf
BUK9K25-40RA | Nexperia | LFPAK56D | 40 | 18.2 | Yes | 15 | 5 | 29 | 6.3 | 2.4 | 1.4 |  |  | 3.1 | 2.032258065 | 1.2 | https://assets.nexperia.com/documents/data-sheet/BUK9K25-40RA.pdf
BUK7K6R8-40E | Nexperia | LFPAK56D | 40 | 40 | No |  | 10 | 6.8 | 28.9 | 9.1 | 7 |  |  | 12.6 | 2.29 | 1.2 | https://assets.nexperia.com/documents/data-sheet/BUK7K6R8-40E.pdf
PSMN014-40HLD | Nexperia | LFPAK56D | 40 | 42 | Yes | 20 | 10 | 13.6 | 13 | 1.8 | 2.3 |  |  | 2.95 | 4.41 | 1 | https://assets.nexperia.com/documents/data-sheet/PSMN014-40HLD.pdf
PSMN2R0-40YLB | Nexperia | LFPAK56 | 40 | 180 | Yes | 20 | 10 | 2.1 | 62 | 6 | 11 | 6.7 | 4.6 | 10.6 | 5.849 | 1 | https://assets.nexperia.com/documents/data-sheet/PSMN2R0-40YLB.pdf
BUK9Y3R5-40E | Nexperia | LFPAK56 | 40 | 100 | Yes | 15 | 5 | 3.8 | 30.2 | 8.6 | 9.7 |  |  | 13.45 | 2.24535 | 1.2 | https://assets.nexperia.com/documents/data-sheet/BUK9Y3R5-40E.pdf
BUK9K6R2-40E | Nexperia | LFPAK56D | 40 | 40 | Yes | 15 | 10 | 6 | 35.4 | 5.8 | 4.4 |  |  | 8 | 4.425 | 1.2 | https://assets.nexperia.com/documents/data-sheet/BUK9K6R2-40E.pdf
PSMN1R7-40YLB | Nexperia | LFPAK56 | 40 | 200 | Yes | 20 | 10 | 1.8 | 79 | 7.3 | 14 | 8.4 | 5.4 | 12.7 | 6.22 | 1 | https://assets.nexperia.com/documents/data-sheet/PSMN1R7-40YLB.pdf
PSMN3R3-80YSF | Nexperia | LFPAK56 | 80 | 160 | No |  | 10 | 3.1 | 70 | 14 | 20 | 13.3 | 6.7 | 20.7 | 3.38 | 1 | https://assets.nexperia.com/documents/data-sheet/PSMN3R3-80YSF.pdf
PSMNR90-40YSN | Nexperia | LFPAK56E | 40 | 320 | No |  | 10 | 0.97 | 135 | 42 | 26 | 19 | 7.6 | 49.6 | 2.72 | 1 | https://assets.nexperia.com/documents/data-sheet/PSMNR90-40YSN.pdf
PSMN1R5-40YSD | Nexperia | LFPAK56 | 40 | 240 | No |  | 10 | 1.5 | 71 | 10 | 21 | 15 | 6.7 | 16.7 | 4.25 | 1 | https://assets.nexperia.com/documents/data-sheet/PSMN1R5-40YSD.pdf
BUK7Y2R0-40H | Nexperia | LFPAK56 | 40 | 120 | No |  | 10 | 2 | 52.6 | 10.8 | 14.8 |  |  | 18.2 | 2.89011 | 1.2 | https://assets.nexperia.com/documents/data-sheet/BUK7Y2R0-40H.pdf
BUK7J1R4-40H | Nexperia | LFPAK56E | 40 | 190 | No |  | 10 | 1.4 | 73 | 13 | 21 |  |  | 23.5 | 3.11 | 1.2 | https://assets.nexperia.com/documents/data-sheet/BUK7J1R4-40H.pdf
PSMN1R0-40YSH | Nexperia | LFPAK56E | 40 | 290 | No |  | 10 | 1 | 87 | 13 | 26 | 18 | 8.3 | 21.3 | 4.084507042 | 1.2 | https://assets.nexperia.com/documents/data-sheet/PSMN1R0-40YSH.pdf
PSMN3R5-40YSB | Nexperia | LFPAK56 | 40 | 120 | No |  | 10 | 3.5 | 30 | 4 | 10 | 6.5 | 3.3 | 7.3 | 4.109589041 | 1 | https://assets.nexperia.com/documents/data-sheet/PSMN3R5-40YSB.pdf
NVTYS010N04CTWG |  |  |  |  |  |  |  |  |  |  |  |  |  |  |  |  | https://www.onsemi.com/pdf/datasheet/nvtys010n04c-d.pdf
NVTYS010N04CLTWG |  |  |  |  |  |  |  |  |  |  |  |  |  |  |  |  | https://www.onsemi.com/pdf/datasheet/nvtys010n04cl-d.pdf
NVTYS029N08HTWG |  |  |  |  |  |  |  |  |  |  |  |  |  |  |  |  | https://www.onsemi.com/pdf/datasheet/nvtys029n08h-d.pdf
NVTYS007N04CLTWG |  |  |  |  |  |  |  |  |  |  |  |  |  |  |  |  | https://www.onsemi.com/pdf/datasheet/nvtys007n04cl-d.pdf
NVTYS007N04CTWG |  |  |  |  |  |  |  |  |  |  |  |  |  |  |  |  | https://www.onsemi.com/pdf/datasheet/nvtys007n04c-d.pdf
BUK7Y13-40B | Nexperia | LFPAK | 40 | 58 | No |  | 10 | 13 | 19 | 5 | 6 |  |  | 8 | 2.375 | 1.2 | https://assets.nexperia.com/documents/data-sheet/BUK7Y13-40B.pdf
PSMN2R5-40YLB | Nexperia | LFPAK56 | 40 | 160 | Yes | 20 | 10 | 2.6 | 56 | 5 | 9.5 | 6 | 3.6 | 8.6 | 6.511627907 | 1 | https://assets.nexperia.com/documents/data-sheet/PSMN2R5-40YLB.pdf
PSMN2R8-40YSB | Nexperia | LFPAK56 | 40 | 160 | No |  | 10 | 2.8 | 42 | 6 | 13.6 | 8.8 | 5 | 11 | 3.818181818 | 1 | https://assets.nexperia.com/documents/data-sheet/PSMN2R8-40YSB.pdf
NVTYS005N04CLTWG |  |  |  |  |  |  |  |  |  |  |  |  |  |  |  |  | https://www.onsemi.com/pdf/datasheet/nvtys005n04cl-d.pdf
PSMN2R2-40YSB | Nexperia | LFPAK56 | 40 | 180 | No |  | 10 | 2.2 | 49 | 6.7 | 14.5 | 10 | 4.3 | 11 | 4.45 | 1 | https://assets.nexperia.com/documents/data-sheet/PSMN2R2-40YSB.pdf
NVTYS003N04CTWG |  |  |  |  |  |  |  |  |  |  |  |  |  |  |  |  | https://www.onsemi.com/pdf/datasheet/nvtys003n04c-d.pdf
NVTYS003N04CLTWG |  |  |  |  |  |  |  |  |  |  |  |  |  |  |  |  | https://www.onsemi.com/pdf/datasheet/nvtys003n04cl-d.pdf
PSMN2R5-40YLD | Nexperia | LFPAK56 | 40 | 160 | Yes | 20 | 10 | 2.6 | 56 | 5.9 | 10 | 5.9 | 4.1 | 10 | 5.6 | 1 | https://assets.nexperia.com/documents/data-sheet/PSMN2R5-40YLD.pdf
PSMN013-40VLD | Nexperia | LFPAK56D | 40 | 42 | Yes | 20 | 10 | 13.6 | 13.9 | 2.1 | 2.5 | 1.4 | 1.1 | 3.2 | 4.34375 | 1 | https://assets.nexperia.com/documents/data-sheet/PSMN013-40VLD.pdf
BUK7Y2R5-40H | Nexperia | LFPAK56 | 40 | 120 | No |  | 10 | 2.5 | 45.8 | 8.9 | 12.7 |  |  | 15.25 | 3.003278689 | 1.2 | https://assets.nexperia.com/documents/data-sheet/BUK7Y2R5-40H.pdf
NTTYS009N08HLTWG |  |  |  |  |  |  |  |  |  |  |  |  |  |  |  |  | https://www.onsemi.com/pdf/datasheet/nttys009n08hl-d.pdf
PSMN1R9-40YSB | Nexperia | LFPAK56 | 40 | 200 | No |  | 10 | 1.9 | 56 | 7.6 | 18 | 12 | 6 | 13.6 | 4.117647059 | 1 | https://assets.nexperia.com/documents/data-sheet/PSMN1R9-40YSB.pdf
PSMN2R2-40YSD | Nexperia | LFPAK56 | 40 | 180 | No |  | 10 | 2.2 | 45 | 6.1 | 14 | 10 | 4.8 | 10.9 | 4.128440367 | 1 | https://assets.nexperia.com/documents/data-sheet/PSMN2R2-40YSD.pdf
NVMJS1D5N04CLTWG |  |  |  |  |  |  |  |  |  |  |  |  |  |  |  |  | https://www.onsemi.com/pdf/datasheet/nvmjs1d5n04cl-d.pdf
NVMJS1D7N04CTWG |  |  |  |  |  |  |  |  |  |  |  |  |  |  |  |  | https://www.onsemi.com/pdf/datasheet/nvmjs1d7n04c-d.pdf
NTMJS1D5N04CLTWG |  |  |  |  |  |  |  |  |  |  |  |  |  |  |  |  | https://www.onsemi.com/pdf/datasheet/ntmjs1d5n04cl-d.pdf
PSMN2R0-40YLD | Nexperia | LFPAK56 | 40 | 180 | Yes | 20 | 10 | 2.1 | 66 | 7.3 | 11 | 6.9 | 4.1 | 11.4 | 5.789 | 1 | https://assets.nexperia.com/documents/data-sheet/PSMN2R0-40YLD.pdf
PSMN1R9-40YSD | Nexperia | LFPAK56 | 40 | 200 | No |  | 10 | 1.9 | 57 | 8.2 | 18 | 12 | 5.8 | 14 | 4.071428571 | 1 | https://assets.nexperia.com/documents/data-sheet/PSMN1R9-40YSD.pdf
PSMN1R7-40YLD | Nexperia | LFPAK56 | 40 | 200 | Yes | 20 | 10 | 1.8 | 78 | 7.7 | 13 | 8.1 | 4.9 | 12.6 | 6.19 | 1 | https://assets.nexperia.com/documents/data-sheet/PSMN1R7-40YLD.pdf
NTMJS1D2N04CLTWG |  |  |  |  |  |  |  |  |  |  |  |  |  |  |  |  | https://www.onsemi.com/pdf/datasheet/ntmjs1d2n04cl-d.pdf
NVMJS1D3N04C | onsemi | LFPAK8 | 40 | 235 | No |  | 10 | 1.3 | 65 | 12 | 20 |  |  | 22 | 2.95 | 1.2 | https://www.onsemi.com/download/data-sheet/pdf/nvmjs1d3n04c-d.pdf
NVMJS1D2N04CLTWG |  |  |  |  |  |  |  |  |  |  |  |  |  |  |  |  | https://www.onsemi.com/pdf/datasheet/nvmjs1d2n04cl-d.pdf
NTMJS0D9N04CLTWG |  |  |  |  |  |  |  |  |  |  |  |  |  |  |  |  | https://www.onsemi.com/pdf/datasheet/ntmjs0d9n04cl-d.pdf
NTMJS0D9N04C | onsemi | LFPAK8 | 40 | 342 | No |  | 10 | 0.81 | 117 | 28 | 29 |  |  | 42.5 | 2.752941176 | 1.2 | https://www.onsemi.com/download/data-sheet/pdf/ntmjs0d9n04c-d.pdf
PSMN4R5-80YSF | Nexperia | LFPAK56 | 80 | 100 | No |  | 10 | 4.5 | 60 | 10.7 | 18.7 | 12 | 6.7 | 17.4 | 3.448 | 1 | https://assets.nexperia.com/documents/data-sheet/PSMN4R5-80YSF.pdf
NTMJS1D7N04C | ON Semiconductor | LFPAK8 | 40 | 185 | No |  | 10 | 1.7 | 47 | 7 | 16 |  |  | 15 | 3.133333333 | 1.2 | https://www.onsemi.com/download/data-sheet/pdf/NTMJS1D7N04C-D.pdf
NVMJS1D0N04CTWG |  |  |  |  |  |  |  |  |  |  |  |  |  |  |  |  | https://www.onsemi.com/pdf/datasheet/nvmjs1d0n04c-d.pdf
NTMJS1D3N04CTWG |  |  |  |  |  |  |  |  |  |  |  |  |  |  |  |  | https://www.onsemi.com/pdf/datasheet/ntmjs1d3n04c-d.pdf
NVMJS0D8N04CL | onsemi | LFPAK8 | 40 | 368 | No |  | 10 | 0.72 | 162 | 29 | 25 |  |  | 41.5 | 3.9036 | 1.2 | https://www.onsemi.com/download/data-sheet/pdf/nvmjs0d8n04cl-d.pdf
BUK7K3R7-40N | Nexperia | LFPAK56D | 40 | 105 | No |  | 10 | 3.7 | 47 | 16 | 10 |  |  | 21 | 2.238095238 | 1 | https://assets.nexperia.com/documents/data-sheet/BUK7K3R7-40N.pdf
MCACLF320N04Y | Micro Commercial Components | LFPAK56E | 40 | 320 | No |  | 10 | 0.62 | 80 | 18.6 | 27.6 |  |  | 32.4 | 2.4691358 | 1.2 | https://www.mccsemi.com/pdf/Products/MCACLF320N04Y(LFPAK56E).pdf
NVMJS0D9N04C | onsemi | LFPAK8 | 40 | 342 | No |  | 10 | 0.81 | 117 | 28 | 29 |  |  | 42.5 | 2.75294 | 1.2 | https://www.onsemi.com/download/data-sheet/pdf/nvmjs0d9n04c-d.pdf
PSMN4R0-40YS | Nexperia | LFPAK | 40 | 100 | No |  | 10 | 4.2 | 38 | 7 | 12 | 7 | 5 | 12 | 3.166666667 | 1.2 | https://assets.nexperia.com/documents/data-sheet/PSMN4R0-40YS.pdf
PSMN1R4-40YSH | Nexperia | LFPAK56 | 40 | 240 | No |  | 10 | 1.4 | 68 | 9.3 | 22 | 15 | 7.1 | 16.4 | 4.146341463 | 1 | https://assets.nexperia.com/documents/data-sheet/PSMN1R4-40YSH.pdf
PSMN2R6-40YS | Nexperia | LFPAK | 40 | 100 | No |  | 10 | 2.8 | 63 | 14 | 18 | 12 | 6 | 20 | 3.15 | 1.2 | https://assets.nexperia.com/documents/data-sheet/PSMN2R6-40YS.pdf
NTMJS0D8N04CLTWG |  |  |  |  |  |  |  |  |  |  |  |  |  |  |  |  | https://www.onsemi.com/pdf/datasheet/ntmjs0d8n04cl-d.pdf
BUK9Y7R6-40E | Nexperia | LFPAK56 | 40 | 79 | Yes | 15 | 5 | 7.6 | 16.4 | 5.5 | 5.1 |  |  | 8.05 | 2.037267 | 1.2 | https://assets.nexperia.com/documents/data-sheet/BUK9Y7R6-40E.pdf
PSMN8R5-40HS | Nexperia | LFPAK56D | 40 | 30 | No |  | 10 | 8.5 | 21.8 | 7.8 | 5.9 |  |  | 10.75 | 2.027906977 | 1.2 | https://assets.nexperia.com/documents/data-sheet/PSMN8R5-40HS.pdf
PSMN6R8-40HS | Nexperia | LFPAK56D | 40 | 40 | No |  | 10 | 6.8 | 28.9 | 9.1 | 7 |  |  | 12.6 | 2.293650794 | 1.2 | https://assets.nexperia.com/documents/data-sheet/PSMN6R8-40HS.pdf
PSMN4R2-80YSE | Nexperia | LFPAK56E | 80 | 170 | No |  | 10 | 4.2 | 73 | 11 | 31 | 16.2 | 14.8 | 25.8 | 2.829457364 | 1 | https://assets.nexperia.com/documents/data-sheet/PSMN4R2-80YSE.pdf
BUK9Y6R5-40H | Nexperia | LFPAK56 | 40 | 70 | Yes | 20 | 10 | 6.5 | 21 | 2.2 | 4.1 |  |  | 4.25 | 4.941176471 | 1 | https://assets.nexperia.com/documents/data-sheet/BUK9Y6R5-40H.pdf
BUK7Y12-40E | Nexperia | LFPAK56 | 40 | 52 | No |  | 10 | 12 | 15 | 5.2 | 4.2 |  |  | 7.3 | 2.054794521 | 1.2 | https://assets.nexperia.com/documents/data-sheet/BUK7Y12-40E.pdf
BUK9K6R8-40E | Nexperia | LFPAK56D | 40 | 40 | Yes | 15 | 5 | 7.2 | 22.2 | 6.8 | 5.2 |  |  | 9.4 | 2.36 | 1.2 | https://assets.nexperia.com/documents/data-sheet/BUK9K6R8-40E.pdf
PSMN011-80YS | Nexperia | LFPAK | 80 | 67 | No |  | 10 | 11 | 45 | 11 | 13 | 8 | 5 | 16 | 2.8125 | 1.2 | https://assets.nexperia.com/documents/data-sheet/PSMN011-80YS.pdf
PSMN3R3-40YS | Nexperia | LFPAK | 40 | 100 | No |  | 10 | 3.3 | 49 | 11.2 | 13.8 | 8.3 | 5.5 | 16.7 | 2.934 | 1.2 | https://assets.nexperia.com/documents/data-sheet/PSMN3R3-40YS.pdf
PSMN2R6-80YSF | Nexperia | LFPAK56E | 80 | 231 | No |  | 10 | 2.4 | 85 | 16.5 | 22 | 16 | 6 | 22.5 | 3.77777778 | 1 | https://assets.nexperia.com/documents/data-sheet/PSMN2R6-80YSF.pdf
PSMN3R2-40YLD | Nexperia | LFPAK56 | 40 | 120 | Yes | 20 | 10 | 3.3 | 41 | 4.3 | 7.4 | 4.3 | 3.1 | 7.4 | 5.54 | 1 | https://assets.nexperia.com/documents/data-sheet/PSMN3R2-40YLD.pdf
BUK9K13-40H | Nexperia | LFPAK56D | 40 | 42 | Yes | 20 | 10 | 13.6 | 13 | 1.8 | 2.3 |  |  | 2.95 | 4.40678 | 1 | https://assets.nexperia.com/documents/data-sheet/BUK9K13-40H.pdf
BUK7Y3R0-40H | Nexperia | LFPAK56 | 40 | 120 | No |  | 10 | 3 | 34 | 6.3 | 9.8 |  |  | 11.2 | 3.0357 | 1.2 | https://assets.nexperia.com/documents/data-sheet/BUK7Y3R0-40H.pdf
NVTYS029N08HL | onsemi | LFPAK8 | 80 | 21.5 | No |  | 10 | 29.8 | 8 | 1.6 | 1.2 |  |  | 2.2 | 3.636363636 | 1.2 | https://www.onsemi.com/download/data-sheet/pdf/nvtys029n08hl-d.pdf
NVTYS005N04CTWG |  |  |  |  |  |  |  |  |  |  |  |  |  |  |  |  | https://www.onsemi.com/pdf/datasheet/nvtys005n04c-d.pdf
NVTYS004N04CTWG |  |  |  |  |  |  |  |  |  |  |  |  |  |  |  |  | https://www.onsemi.com/pdf/datasheet/nvtys004n04c-d.pdf
PSMN8R0-40HL | Nexperia | LFPAK56D | 40 | 30 | Yes | 15 | 5 | 9.4 | 15.7 | 5.3 | 3.2 |  |  | 6.9 | 2.27536 | 1.2 | https://assets.nexperia.com/documents/data-sheet/PSMN8R0-40HL.pdf
PSMN6R1-40HL | Nexperia | LFPAK56D | 40 | 40 | Yes | 15 | 5 | 7.2 | 22.2 | 6.8 | 5.2 |  |  | 9.4 | 2.3617 | 1.2 | https://assets.nexperia.com/documents/data-sheet/PSMN6R1-40HL.pdf
NVMJS0D9N04CLTWG |  |  |  |  |  |  |  |  |  |  |  |  |  |  |  |  | https://www.onsemi.com/pdf/datasheet/nvmjs0d9n04cl-d.pdf
NTMJS1D0N04CTWG |  |  |  |  |  |  |  |  |  |  |  |  |  |  |  |  | https://www.onsemi.com/pdf/datasheet/ntmjs1d0n04c-d.pdf
BUK7Y29-40E | Nexperia | LFPAK56 | 40 | 26 | No |  | 10 | 29 | 7.9 | 3 | 2 |  |  | 4 | 1.975 | 1.2 | https://assets.nexperia.com/documents/data-sheet/BUK7Y29-40E.pdf
PSMNR70-40YSN | Nexperia | LFPAK56E | 40 | 360 | No |  | 10 | 0.81 | 168 | 46 | 37 | 25 | 12 | 58 | 2.89655 | 1 | https://assets.nexperia.com/documents/data-sheet/PSMNR70-40YSN.pdf
PSMN1R0-40YLD | Nexperia | LFPAK56 | 40 | 280 | Yes | 20 | 10 | 1.1 | 127 | 17 | 19 | 12 | 8 | 25 | 5.08 | 1.2 | https://assets.nexperia.com/documents/data-sheet/PSMN1R0-40YLD.pdf
PSMN1R0-40ULD | Nexperia | LFPAK56 | 40 | 280 | Yes | 20 | 10 | 1.1 | 127 | 17 | 19 | 12 | 8 | 25 | 5.08 | 1.2 | https://assets.nexperia.com/documents/data-sheet/PSMN1R0-40ULD.pdf
NVMJD020N08HL | onsemi | LFPAK8 | 80 | 30 | No |  | 10 | 19.5 | 11.4 | 2.4 | 1.7 |  |  | 3.25 | 3.507692308 | 1.2 | https://www.onsemi.com/download/data-sheet/pdf/nvmjd020n08hl-d.pdf
BUK7Y25-40B | Nexperia | LFPAK | 40 | 35.3 | No |  | 10 | 25 | 12.1 | 5.12 | 3.44 |  |  | 6.84 | 1.769 | 1.2 | https://assets.nexperia.com/documents/data-sheet/BUK7Y25-40B.pdf
STK184N4F7AG | STMicroelectronics | LFPAK 5x6 | 40 | 100 | No |  | 10 | 2 | 35 | 8.9 | 16 |  |  | 16.9 | 2.071005917 | 1.1 | https://www.st.com/content/ccc/resource/technical/document/datasheet/group3/f2/69/2e/52/01/88/40/ae/DM00514605/files/DM00514605.pdf/jcr:content/translations/e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
BUK9Y09-40B | Nexperia | LFPAK | 40 | 75 | Yes | 15 | 5 | 9 | 30 | 11 | 6.5 |  |  | 14.25 | 2.105263158 | 1.2 | https://assets.nexperia.com/documents/data-sheet/BUK9Y09-40B.pdf
NVTYS020N08HL | onsemi | LFPAK8 | 80 | 30 | No |  | 10 | 20 | 12 | 2 | 2 |  |  | 3 | 4 | 1.2 | https://www.onsemi.com/download/data-sheet/pdf/nvtys020n08hl-d.pdf
NVTYS014N08HL | onsemi | LFPAK33 | 80 | 40 | No |  | 10 | 13.9 | 15.5 | 3 | 2.4 |  |  | 4.2 | 3.69 | 1.2 | https://www.onsemi.com/download/data-sheet/pdf/nvtys014n08hl-d.pdf
PSMN1R6-40YLC | Nexperia | LFPAK; Power-SO8 | 40 | 100 | Yes | 20 | 10 | 1.55 | 126 | 15.3 | 17.7 | 12.5 | 5.2 | 20.5 | 6.15 | 1.1 | https://assets.nexperia.com/documents/data-sheet/PSMN1R6-40YLC.pdf
BUK7Y25-40B | Nexperia | LFPAK | 40 | 35.3 | No |  | 10 | 25 | 12.1 | 5.12 | 3.44 |  |  | 6.84 | 1.769 | 1.2 | https://assets.nexperia.com/documents/data-sheet/BUK7Y25-40B.pdf
PH4840S | NXP Semiconductors | LFPAK | 40 | 94.5 | No |  | 10 | 4.1 | 67 | 16 | 8.6 |  |  | 20.3 | 3.300492611 | 1.2 | https://assets.nexperia.com/documents/data-sheet/PH4840S.pdf
PSMN1R4-40YLD | Nexperia | LFPAK56 | 40 | 240 | Yes | 20 | 10 | 1.4 | 96 | 13 | 15 | 9 | 6 | 19 | 5.0526 | 1.2 | https://assets.nexperia.com/documents/data-sheet/PSMN1R4-40YLD.pdf
PSMN2R5-40YLD | Nexperia | LFPAK56 | 40 | 160 | Yes | 20 | 10 | 2.6 | 56 | 5.9 | 10 | 5.9 | 4.1 | 10 | 5.6 | 1 | https://assets.nexperia.com/documents/data-sheet/PSMN2R5-40YLD.pdf
PSMN2R6-40YS | Nexperia | LFPAK | 40 | 100 | No |  | 10 | 2.8 | 63 | 14 | 18 | 12 | 6 | 20 | 3.15 | 1.2 | https://assets.nexperia.com/documents/data-sheet/PSMN2R6-40YS.pdf
PSMN3R3-40YS | Nexperia | LFPAK | 40 | 100 | No |  | 10 | 3.3 | 49 | 11.2 | 13.8 | 8.3 | 5.5 | 16.7 | 2.934 | 1.2 | https://assets.nexperia.com/documents/data-sheet/PSMN3R3-40YS.pdf
PSMN2R8-40YSD | Nexperia | LFPAK56 | 40 | 160 | No |  | 10 | 2.8 | 44 | 7 | 13 | 8.8 | 4.2 | 11.2 | 3.928571429 | 1 | https://assets.nexperia.com/documents/data-sheet/PSMN2R8-40YSD.pdf
PSMN1R5-40YSD | Nexperia | LFPAK56 | 40 | 240 | No |  | 10 | 1.5 | 71 | 10 | 21 | 15 | 6.7 | 16.7 | 4.25 | 1 | https://assets.nexperia.com/documents/data-sheet/PSMN1R5-40YSD.pdf
PSMN3R5-40YSD | Nexperia | LFPAK56 | 40 | 120 | No |  | 10 | 3.5 | 31 | 5 | 10 | 6.4 | 3.6 | 8.6 | 3.604651163 | 1.2 | https://assets.nexperia.com/documents/data-sheet/PSMN3R5-40YSD.pdf
BUK7Y08-40B | Nexperia | LFPAK | 40 | 75 | No |  | 10 | 8 | 36.3 | 14.7 | 10.4 |  |  | 19.9 | 1.824120603 | 1.2 | https://assets.nexperia.com/documents/data-sheet/BUK7Y08-40B.pdf
NVTYS009N08HLTWG |  |  |  |  |  |  |  |  |  |  |  |  |  |  |  |  | https://www.onsemi.com/pub/Collateral/NVTYS009N08HL-D.PDF
BUK7Y08-40B | Nexperia | LFPAK | 40 | 75 | No |  | 10 | 8 | 36.3 | 14.7 | 10.4 |  |  | 19.9 | 1.824120603 | 1.2 | https://assets.nexperia.com/documents/data-sheet/BUK7Y08-40B.pdf
PSMN1R6-40YLC | Nexperia | LFPAK; Power-SO8 | 40 | 100 | Yes | 20 | 10 | 1.55 | 126 | 15.3 | 17.7 | 12.5 | 5.2 | 20.5 | 6.146341463 | 1.1 | https://assets.nexperia.com/documents/data-sheet/PSMN1R6-40YLC.pdf
RFD3055LESM9A |  |  |  |  |  |  |  |  |  |  |  |  |  |  |  |  | https://www.onsemi.com/pdf/datasheet/rfd3055lesm-d.pdf
AOD442G | Alpha & Omega Semiconductor | TO-252 | 60 | 40 | Yes | 20 | 10 | 18 | 47.5 | 14.5 | 6 |  |  | 17.5 | 2.714285714 | 1 | https://aosmd.com/res/data_sheets/AOD442G.pdf
NTD3055-094T4G |  |  |  |  |  |  |  |  |  |  |  |  |  |  |  |  | https://www.onsemi.com/pdf/datasheet/ntd3055-094-d.pdf
AOD4130 | Alpha & Omega Semiconductor | TO-252 | 60 | 30 | No |  | 10 | 24 | 28.3 | 7.2 | 4.5 |  |  | 9.45 | 2.99 | 1 | https://aosmd.com/res/data_sheets/AOD4130.pdf
TSM120N06LCP ROG |  |  |  |  |  |  |  |  |  |  |  |  |  |  |  |  | https://services.taiwansemi.com/storage/resources/datasheet/TSM120N06LCP_A1602.pdf
NTD3055L104T4G |  |  |  |  |  |  |  |  |  |  |  |  |  |  |  |  | https://www.onsemi.com/pdf/datasheet/ntd3055l104-d.pdf
STD20NF06L | STMicroelectronics | DPAK | 60 | 24 | Yes | 18 | 10 | 40 | 13 | 8 | 3.5 |  |  | 9.75 | 1.333333333 | 1.5 | https://www.st.com/content/ccc/resource/technical/document/datasheet/a6/4e/36/6e/fb/e1/44/e8/CD00003407.pdf/files/CD00003407.pdf/jcr:content/translations/en.C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
NTD18N06L | onsemi | DPAK | 60 | 18 | Yes | 15 | 5 | 65 | 11 | 6.5 | 3.2 |  |  | 8.1 | 1.358 | 1.15 | https://www.onsemi.com/pdf/datasheet/ntd18n06l-d.pdf
FDD86540 | Fairchild Semiconductor | D-PAK(TO-252) | 60 | 136 | No |  | 10 | 4.1 | 65 | 12 | 23 |  |  | 23.5 | 2.765957447 | 1.3 | https://www.onsemi.com/pub/Collateral/FDD86540-D.pdf
STD30NF06LT4 |  |  |  |  |  |  |  |  |  |  |  |  |  |  |  |  | //mm.digikey.com/Volume0/opasdata/d220001/medias/docus/1/STD30NF06L.pdf
STD35NF06L | STMicroelectronics | DPAK | 60 | 35 | Yes | 16 | 4.5 | 20 | 25 | 10 | 5 |  |  | 12.5 | 2 | 1.5 | https://www.st.com/content/ccc/resource/technical/document/datasheet/48/eb/5d/41/e2/c9/48/f2/CD00002363.pdf/files/CD00002363.pdf/jcr:content/translations/en.C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
STD140N6F7 | STMicroelectronics | DPAK | 60 | 80 | No |  | 10 | 3.8 | 55 | 18 | 19 |  |  | 27.5 | 2 | 1.2 | https://www.st.com/content/ccc/resource/technical/document/datasheet/group1/de/02/69/d9/32/b8/44/66/DM00257307/files/DM00257307.pdf/jcr:content/translations/e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
NTD24N06LT4G |  |  |  |  |  |  |  |  |  |  |  |  |  |  |  |  | https://www.onsemi.com/pdf/datasheet/ntd24n06l-d.pdf
SQD40N06-14L | Vishay Siliconix | TO-252 | 60 | 40 | No |  | 10 | 14 | 34 | 8.5 | 6 |  |  | 11.5 | 2.956521739 | 1.2 | https://www.vishay.com/docs/67002/sqd40n06-14l.pdf
RFD16N06LESM9A |  |  |  |  |  |  |  |  |  |  |  |  |  |  |  |  | https://www.onsemi.com/pdf/datasheet/rfd16n06lesm-d.pdf
FDD10AN06A0 |  |  |  |  |  |  |  |  |  |  |  |  |  |  |  |  | https://www.onsemi.com/pub/Collateral/FDD10AN06A0-D.PDF
SQD50N06-09L | Vishay Siliconix | TO-252 | 60 | 50 | No |  | 10 | 9 | 48 | 13.5 | 7.1 |  |  | 17.05 | 2.8152 | 1.5 | https://www.vishay.com/docs/68901/sqd50n06-09l.pdf
DI020N06D1 | Diotec Semiconductor | TO-252AA | 60 | 20 | No |  | 10 | 35 | 25.3 | 6.1 | 4.7 |  |  | 8.45 | 2.99408284 | 1.2 | https://diotec.com/request/datasheet/di020n06d1.pdf
DMN6040SK3 | Diodes Incorporated | TO252 (DPAK) | 60 | 20 | No |  | 10 | 40 | 22.4 | 3 | 4.9 |  |  | 5.45 | 4.11 | 1.2 | https://www.diodes.com/assets/Datasheets/DMN6040SK3.pdf
FQD13N06LTM |  |  |  |  |  |  |  |  |  |  |  |  |  |  |  |  | https://www.onsemi.com/pub/Collateral/FQU13N06L-D.PDF
TSM340N06CP ROG |  |  |  |  |  |  |  |  |  |  |  |  |  |  |  |  | https://services.taiwansemi.com/storage/resources/datasheet/TSM340N06_D14.pdf
STD12NF06LT4 | STMicroelectronics | DPAK | 60 | 12 | Yes | 16 | 10 | 90 | 7.5 | 3 | 2.5 |  |  | 4.25 | 1.7647 | 1.5 | //mm.digikey.com/Volume0/opasdata/d220001/medias/docus/8924/STD12NF06LT4.pdf
AOD442/AOI442 | Alpha & Omega Semiconductor | DPAK, IPAK | 60 | 37 | No |  | 10 | 20 | 47.6 | 14.4 | 4.8 |  |  | 16.8 | 2.833333333 | 1 | https://aosmd.com/res/data_sheets/AOD442.pdf
TSM170N06CP ROG |  |  |  |  |  |  |  |  |  |  |  |  |  |  |  |  | https://services.taiwansemi.com/storage/resources/datasheet/TSM170N06_B15.pdf
NTD3055-150T4G |  |  |  |  |  |  |  |  |  |  |  |  |  |  |  |  | https://www.onsemi.com/pdf/datasheet/ntd3055-150-d.pdf
DMNH6021SK3Q | Diodes Incorporated | TO252 | 60 | 50 | No |  | 10 | 23 | 20.1 | 5.5 | 4.3 |  |  | 7.65 | 2.62745098 | 1.2 | https://www.diodes.com/datasheet/download/DMNH6021SK3Q.pdf
STD20NF06T4 |  |  |  |  |  |  |  |  |  |  |  |  |  |  |  |  | //mm.digikey.com/Volume0/opasdata/d220001/medias/docus/937/STD20NF06.pdf
SUD23N06-31 | Vishay Siliconix | TO-252 | 60 | 21.4 | No |  | 10 | 31 | 11 | 3 | 3 |  |  | 4.5 | 2.44 | 1.5 | https://www.vishay.com/docs/68857/sud23n06.pdf
STD16NF06 | STMicroelectronics | DPAK | 60 | 16 | No |  | 10 | 70 | 14.1 | 5.4 | 2.8 |  |  | 6.8 | 2.073529412 | 1.5 | https://www.st.com/content/ccc/resource/technical/document/datasheet/group2/6e/70/3f/f6/ef/60/4c/39/CD00083971/files/CD00083971.pdf/jcr:content/translations/e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
STD16NF06LT4 |  |  |  |  |  |  |  |  |  |  |  |  |  |  |  |  | //mm.digikey.com/Volume0/opasdata/d220001/medias/docus/1/STD16NF06L_-1_Rev_5.pdf
FQD30N06TM |  |  |  |  |  |  |  |  |  |  |  |  |  |  |  |  | https://www.onsemi.com/pdf/datasheet/fqd30n06-d.pdf
DMTH6009LK3 | Diodes Incorporated | TO252 (DPAK) | 60 | 59 | Yes | 16 | 10 | 10 | 33.5 | 5.3 | 4.7 |  |  | 7.65 | 4.379084967 | 1.2 | https://www.diodes.com/assets/Datasheets/DMTH6009LK3.pdf
STD130N6F7 | STMicroelectronics | DPAK | 60 | 80 | No |  | 10 | 5 | 42 | 13 | 13.6 |  |  | 19.8 | 2.121212121 | 1.2 | https://www.st.com/content/ccc/resource/technical/document/datasheet/group1/ba/8d/e1/5c/06/52/4c/f2/DM00256820/files/DM00256820.pdf/jcr:content/translations/e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
IRFR014 | Vishay Siliconix | DPAK | 60 | 7.7 | No |  | 10 | 200 | 11 | 5.8 | 3.1 |  |  | 7.35 | 1.496598639 | 1.6 | https://www.vishay.com/docs/91263/sihfr014.pdf
FDD5353 |  |  |  |  |  |  |  |  |  |  |  |  |  |  |  |  | https://www.onsemi.com/pub/Collateral/FDD5353-D.PDF
NVD5C688NLT4G |  |  |  |  |  |  |  |  |  |  |  |  |  |  |  |  | https://www.onsemi.com/pdf/datasheet/nvd5c688nl-d.pdf
SQD50034EL | Vishay Siliconix | TO-252 | 60 | 100 | No |  | 10 | 4 | 60 | 4.8 | 16.3 |  |  | 12.95 | 4.633204633 | 1.5 | https://www.vishay.com/docs/75400/sqd50034el.pdf
NVD5C684NLT4G |  |  |  |  |  |  |  |  |  |  |  |  |  |  |  |  | https://www.onsemi.com/pdf/datasheet/nvd5c684nl-d.pdf
NVD5C668NLT4G |  |  |  |  |  |  |  |  |  |  |  |  |  |  |  |  | https://www.onsemi.com/pdf/datasheet/nvd5c668nl-d.pdf
STD60NF06T4 | STMicroelectronics | DPAK | 60 | 60 | No |  | 10 | 16 | 49 | 14 | 18 |  |  | 23 | 2.130434783 | 1.3 | https://www.st.com/resource/en/datasheet/std60nf06t4.pdf
FDD86567-F085 |  |  |  |  |  |  |  |  |  |  |  |  |  |  |  |  | https://www.onsemi.com/pub/Collateral/FDD86567_F085-D.PDF
NVD5C648NLT4G |  |  |  |  |  |  |  |  |  |  |  |  |  |  |  |  | https://www.onsemi.com/pdf/datasheet/nvd5c648nl-d.pdf
PJD35N06A_L2_00001 |  |  |  |  |  |  |  |  |  |  |  |  |  |  |  |  | https://www.panjit.com.tw/upload/datasheet/PJx35N06A.pdf
TSM900N06CP ROG |  |  |  |  |  |  |  |  |  |  |  |  |  |  |  |  | https://services.taiwansemi.com/storage/resources/datasheet/TSM900N06CP_A2205.pdf
PJD45N06A_L2_00001 |  |  |  |  |  |  |  |  |  |  |  |  |  |  |  |  | https://www.panjit.com.tw/upload/datasheet/PJx45N06A.pdf
DMNH6042SK3 | Diodes Incorporated | TO252 (DPAK) | 60 | 25 | No |  | 10 | 50 | 8.8 | 1.8 | 1.8 |  |  | 2.7 | 3.259259259 | 1.2 | https://www.diodes.com/assets/Datasheets/DMNH6042SK3.pdf
TSM230N06CP ROG |  |  |  |  |  |  |  |  |  |  |  |  |  |  |  |  | https://services.taiwansemi.com/storage/resources/datasheet/TSM230N06_D1802.pdf
DI050N06D1 | Diotec Semiconductor | TO-252AA | 65 | 50 | Yes | 20 | 10 | 11 | 14 | 2.8 | 2.6 |  |  | 4.1 | 3.414634146 | 1.2 | https://diotec.com/request/datasheet/di050n06d1.pdf
STD30N6LF6AG | STMicroelectronics | DPAK | 60 | 24 | No |  | 10 | 25 | 26 | 3.3 | 6 |  |  | 6.3 | 4.126984127 | 1.3 | https://www.st.com/content/ccc/resource/technical/document/datasheet/9a/b6/39/95/41/c8/4a/21/DM00210369.pdf/files/DM00210369.pdf/jcr:content/translations/en.D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
MCU20N06A | Micro Commercial Components | DPAK(TO-252) | 60 | 20 | No |  | 10 | 30 | 24.5 | 6.3 | 2.8 |  |  | 7.7 | 3.1818 | 1.2 | https://www.mccsemi.com/pdf/Products/MCU20N06A(DPAK).pdf
SUD23N06-31L | Vishay Siliconix | TO-252 | 60 | 23 | Yes | 20 | 10 | 31 | 11 | 3 | 3 |  |  | 4.5 | 2.44 | 1.5 | https://www.vishay.com/docs/72145/sud23n06-31l.pdf
MCU90N06A | Micro Commercial Components | DPAK (TO-252) | 60 | 90 | No |  | 10 | 7.2 | 102 | 20 | 13.2 |  |  | 26.6 | 3.834586 | 1.2 | https://www.mccsemi.com/pdf/products/MCU90N06A(DPAK).pdf
DMT6009LK3 | Diodes Incorporated | TO252 | 60 | 57 | Yes | 16 | 10 | 10 | 33.5 | 5.3 | 4.7 |  |  | 7.65 | 4.379084967 | 1.2 | https://www.diodes.com/assets/Datasheets/DMT6009LK3.pdf
SQD15N06-42L | Vishay Siliconix | TO-252 | 60 | 15 | No |  | 10 | 42 | 9.5 | 2.5 | 1.7 |  |  | 3.35 | 2.8358 | 1.2 | https://www.vishay.com/docs/68880/sqd15n06-42l.pdf
RFD12N06RLESM9A |  |  |  |  |  |  |  |  |  |  |  |  |  |  |  |  | https://www.onsemi.com/pdf/datasheet/rfd12n06rlesm-d.pdf
HUF76407D3ST |  |  |  |  |  |  |  |  |  |  |  |  |  |  |  |  | https://www.onsemi.com/pdf/datasheet/huf76407d3s-d.pdf
DMTH6005LK3 | Diodes Incorporated | TO252 (DPAK) | 60 | 90 | No |  | 10 | 5.6 | 47.1 | 12.5 | 10.2 |  |  | 17.6 | 2.676136364 | 1.2 | https://www.diodes.com/assets/Datasheets/DMTH6005LK3.pdf
DMTH6010SK3Q | Diodes Incorporated | TO252 (DPAK) | 60 | 70 | No |  | 10 | 8 | 38.1 | 9.3 | 8.3 |  |  | 13.45 | 2.8327 | 1.2 | https://www.diodes.com/datasheet/download/DMTH6010SK3Q.pdf
STD12NF06T4 | STMicroelectronics | DPAK | 60 | 12 | No |  | 10 | 100 | 10 | 3.5 | 3 |  |  | 5 | 2 | 1.3 | https://www.st.com/content/ccc/resource/technical/document/datasheet/5c/31/89/d4/5c/b2/4c/da/CD00002756.pdf/files/CD00002756.pdf/jcr:content/translations/en.C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
STD35NF06 | STMicroelectronics | DPAK | 60 | 35 | No |  | 10 | 20 | 44.5 | 17.5 | 10.5 |  |  | 22.75 | 1.956 | 1.5 | https://www.st.com/content/ccc/resource/technical/document/datasheet/0d/26/b9/23/e3/c0/49/5f/CD00002312.pdf/files/CD00002312.pdf/jcr:content/translations/en.C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
DMTH6009LK3Q | Diodes Incorporated | TO252 (DPAK) | 60 | 59 | Yes | 16 | 10 | 10 | 33.5 | 5.3 | 4.7 |  |  | 7.65 | 4.379085 | 1.2 | https://www.diodes.com/datasheet/download/DMTH6009LK3Q.pdf
FDD5680 | onsemi | TO-252 | 60 | 38 | No |  | 10 | 21 | 33 | 7.5 | 6.5 |  |  | 10.75 | 3.069767442 | 1.2 | https://www.onsemi.com/pub/Collateral/FDD5680-D.PDF
DMTH6004SK3Q | Diodes Incorporated | TO252 (DPAK) | 60 | 100 | No |  | 10 | 3.8 | 95.4 | 20.4 | 21.6 |  |  | 31.2 | 3.057692308 | 1.2 | https://www.diodes.com/datasheet/download/DMTH6004SK3Q.pdf
DMTH6004SK3 | Diodes Incorporated | TO252 (DPAK) | 60 | 100 | No |  | 10 | 3.8 | 95.4 | 20.4 | 21.6 |  |  | 31.2 | 3.057692308 | 1.2 | https://www.diodes.com/assets/Datasheets/DMTH6004SK3.pdf
IRFR014 | Vishay Siliconix | DPAK (TO-252) | 60 | 7.7 | No |  | 10 | 200 | 11 | 5.8 | 3.1 |  |  | 7.35 | 1.496598639 | 1.6 | https://www.vishay.com/docs/91263/sihfr014.pdf
FDD13AN06A0-F085 |  |  |  |  |  |  |  |  |  |  |  |  |  |  |  |  | https://www.onsemi.com/pub/Collateral/FDD13AN06_F085-D.PDF
MCU80N06 | Micro Commercial Components | DPAK | 60 | 80 | No |  | 10 | 13 | 36 | 6.6 | 9.6 |  |  | 11.4 | 3.157894737 | 1.4 | https://www.mccsemi.com/pdf/Products/MCU80N06(DPAK).pdf
MCU75N06YHE3 | Micro Commercial Components | DPAK(TO-252) | 60 | 75 | No |  | 10 | 4.8 | 34.5 | 9.2 | 4.6 |  |  | 11.5 | 3 | 1.3 | https://www.mccsemi.com/pdf/Products/MCU75N06YHE3(DPAK).pdf
SQD25N06-22L | Vishay Siliconix | TO-252 | 60 | 25 | No |  | 10 | 22 | 33 | 6.8 | 5.3 |  |  | 9.45 | 3.492063492 | 1.5 | https://www.vishay.com/docs/65360/sqd25n06-22l.pdf
SQD23N06-31L | Vishay Siliconix | TO-252 | 60 | 23 | No |  | 10 | 31 | 16 | 3 | 4 |  |  | 5 | 3.2 | 1.5 | https://www.vishay.com/docs/68869/sqd23n06-31l.pdf
SQD97N06-6m3L | Vishay Siliconix | TO-252 | 60 | 97 | No |  | 10 | 6.3 | 82 | 13.5 | 14.5 |  |  | 20.75 | 3.9518 | 1.5 | https://www.vishay.com/docs/62897/sqd97n06-6m3l.pdf
IRFR024 | Vishay Siliconix | DPAK (TO-252) | 60 | 14 | No |  | 10 | 100 | 25 | 11 | 5.8 |  |  | 13.9 | 1.79856 | 1.5 | https://www.vishay.com/docs/91264/sihfr024.pdf
IRFR020 | Vishay Siliconix | DPAK (TO-252) | 60 | 14 | No |  | 10 | 100 | 25 | 11 | 5.8 |  |  | 13.9 | 1.798561151 | 1.5 | https://www.vishay.com/docs/90335/sihfr020.pdf
IRFR024 | Vishay Siliconix | DPAK (TO-252) | 60 | 14 | No |  | 10 | 100 | 25 | 11 | 5.8 |  |  | 13.9 | 1.798561151 | 1.5 | https://www.vishay.com/docs/91264/sihfr024.pdf
IRFR024 | Vishay Siliconix | DPAK (TO-252) | 60 | 14 | No |  | 10 | 100 | 25 | 11 | 5.8 |  |  | 13.9 | 1.798561151 | 1.5 | https://www.vishay.com/docs/91264/sihfr024.pdf
NVD5C632NLT4G |  |  |  |  |  |  |  |  |  |  |  |  |  |  |  |  | https://www.onsemi.com/pdf/datasheet/nvd5c632nl-d.pdf
DMNH6042SK3Q | Diodes Incorporated | TO252 | 60 | 25 | No |  | 10 | 50 | 8.8 | 1.8 | 1.8 |  |  | 2.7 | 3.259259259 | 1.2 | https://www.diodes.com/datasheet/download/DMNH6042SK3Q.pdf
NTD3055-094 | onsemi | DPAK | 60 | 12 | No |  | 10 | 94 | 10.9 | 4.2 | 3.1 |  |  | 5.75 | 1.895652174 | 1.15 | https://www.onsemi.com/download/data-sheet/pdf/ntd3055-094-d.pdf
MCU60N06 | Micro Commercial Components | DPAK(TO-252) | 60 | 60 | No |  | 10 | 11 | 54 | 21 | 12 |  |  | 27 | 2 | 1.2 | https://www.mccsemi.com/pdf/Products/MCU60N06(DPAK).pdf
STD20NF06LAG | STMicroelectronics | DPAK | 60 | 24 | Yes | 18 | 5 | 50 | 13 | 8 | 3.5 |  |  | 9.75 | 1.333333333 | 1.5 | https://www.st.com/resource/en/datasheet/std20nf06lag.pdf
PJD45N06SA-AU_L2_006A1 |  |  |  |  |  |  |  |  |  |  |  |  |  |  |  |  | https://www.panjit.com.tw/upload/datasheet/PJD45N06SA-AU.pdf
ZXMN6A25KTC |  |  |  |  |  |  |  |  |  |  |  |  |  |  |  |  | //mm.digikey.com/Volume0/opasdata/d220001/medias/docus/10/ZXMN6A25K.pdf
NVD3055-150T4G-VF01 |  |  |  |  |  |  |  |  |  |  |  |  |  |  |  |  | https://www.onsemi.com/pdf/datasheet/ntd3055-150-d.pdf
DMNH6012LK3Q | Diodes Incorporated | TO252 (DPAK) | 60 | 80 | No |  | 10 | 12 | 35.2 | 6.9 | 7.6 |  |  | 10.7 | 3.2897 | 1.2 | https://www.diodes.com/datasheet/download/DMNH6012LK3Q.pdf
PJD60N06SA-AU_L2_006A1 |  |  |  |  |  |  |  |  |  |  |  |  |  |  |  |  | https://www.panjit.com.tw/upload/datasheet/PJD60N06SA-AU.pdf
SUD23N06-31 | Vishay Siliconix | TO-252 | 60 | 21.4 | No |  | 10 | 31 | 11 | 3 | 3 |  |  | 4.5 | 2.444444444 | 1.5 | https://www.vishay.com/docs/68857/sud23n06.pdf
DMTH6010SK3 | Diodes Incorporated | TO252 | 60 | 70 | No |  | 10 | 8 | 38.1 | 9.3 | 8.3 |  |  | 13.45 | 2.832713755 | 1.2 | https://www.diodes.com/assets/Datasheets/DMTH6010SK3.pdf
IRFR014 | Vishay Siliconix | DPAK (TO-252) | 60 | 7.7 | No |  | 10 | 200 | 11 | 5.8 | 3.1 |  |  | 7.35 | 1.496598639 | 1.6 | https://www.vishay.com/docs/91263/sihfr014.pdf
IRFR014 | Vishay Siliconix | DPAK | 60 | 7.7 | No |  | 10 | 200 | 11 | 5.8 | 3.1 |  |  | 7.35 | 1.496598639 | 1.6 | https://www.vishay.com/docs/91263/sihfr014.pdf
IRFR014 | Vishay Siliconix | DPAK | 60 | 7.7 | No |  | 10 | 200 | 11 | 5.8 | 3.1 |  |  | 7.35 | 1.496598639 | 1.6 | https://www.vishay.com/docs/91263/sihfr014.pdf
PJD80N06SA-AU_L2_006A1 |  |  |  |  |  |  |  |  |  |  |  |  |  |  |  |  | https://www.panjit.com.tw/upload/datasheet/PJD80N06SA-AU.pdf
SQD97N06-6m3L | Vishay Siliconix | TO-252 | 60 | 97 | No |  | 10 | 6.3 | 82 | 13.5 | 14.5 |  |  | 20.75 | 3.95 | 1.5 | https://www.vishay.com/docs/62897/sqd97n06-6m3l.pdf
IRFR024 | Vishay Siliconix | DPAK (TO-252) | 60 | 14 | No |  | 10 | 100 | 25 | 11 | 5.8 |  |  | 13.9 | 1.79856 | 1.5 | https://www.vishay.com/docs/91264/sihfr024.pdf
MCU110N06YB | Micro Commercial Components | DPAK(TO-252) | 60 | 110 | No |  | 10 | 5 | 58 | 11.5 | 16.8 |  |  | 19.9 | 2.91457 | 1.2 | https://www.mccsemi.com/pdf/Products/MCU110N06YB(DPAK).pdf
PJD100N06SA-AU_L2_006A1 |  |  |  |  |  |  |  |  |  |  |  |  |  |  |  |  | https://www.panjit.com.tw/upload/datasheet/PJD100N06SA-AU.pdf
MCU018N06L | Micro Commercial Components | DPAK (TO-252) | 60 | 32 | No |  | 10 | 18 | 39 | 9.6 | 5.3 |  |  | 12.25 | 3.183673469 | 1.2 | https://www.mccsemi.com/pdf/Products/MCU018N06L(DPAK).pdf
PJD25N06A-AU_L2_000A1 |  |  |  |  |  |  |  |  |  |  |  |  |  |  |  |  | https://www.panjit.com.tw/upload/datasheet/PJD25N06A-AU.pdf
MCU031N06Q | Micro Commercial Components | DPAK(TO-252) | 60 | 23 | No |  | 10 | 31 | 18 | 2.4 | 2.8 |  |  | 3.8 | 4.736842105 | 1.2 | https://www.mccsemi.com/pdf/products/MCU031N06Q(DPAK).pdf
XP6NA6R5H |  |  |  |  |  |  |  |  |  |  |  |  |  |  |  |  | http://download.xsemi-corporation.com/datasheet/XP6NA6R5H.pdf
SVD5867NLT4G |  |  |  |  |  |  |  |  |  |  |  |  |  |  |  |  | //mm.digikey.com/Volume0/opasdata/d220001/medias/docus/667/NVD5867NL.pdf
DMN6040SK3Q | Diodes Incorporated | TO252 (DPAK) | 60 | 20 | No |  | 10 | 40 | 22.4 | 3 | 4.9 |  |  | 5.45 | 4.11 | 1.2 | https://www.diodes.com/datasheet/download/DMN6040SK3Q.pdf
NVMYS9D3N06CL | onsemi | LFPAK4 | 60 | 50 | No |  | 10 | 9.2 | 9.5 | 0.8 | 2 |  |  | 1.8 | 5.28 | 1.2 | https://www.onsemi.com/download/data-sheet/pdf/nvmys9d3n06cl-d.pdf
XP6NA3R0H |  |  |  |  |  |  |  |  |  |  |  |  |  |  |  |  | http://download.xsemi-corporation.com/datasheet/XP6NA3R0H.pdf
DMT64M3SK3 | Diodes Incorporated | TO252 (DPAK) | 60 | 131 | No |  | 10 | 4.2 | 83 | 5.5 | 40 |  |  | 25.5 | 3.2549 | 1.2 | https://www.diodes.com/datasheet/download/DMT64M3SK3.pdf
AG092FLD3HRB | ROHM Semiconductor | TO-252 | 60 | 40 | No |  | 10 | 13.5 | 13 | 2.4 | 2.1 |  |  | 3.45 | 3.768115942 | 1.5 | https://fscdn.rohm.com/en/products/databook/datasheet/discrete/transistor/mosfet/ag092fld3hrbtl-e.pdf
RD3L04BBLHRB | ROHM Semiconductor | TO-252 | 60 | 40 | No |  | 10 | 13.6 | 12.1 | 2.4 | 3.1 |  |  | 3.95 | 3.063291139 | 1.5 | https://fscdn.rohm.com/en/products/databook/datasheet/discrete/transistor/mosfet/rd3l04bblhrbtl-e.pdf
MCU6D5N06YLQ | Micro Commercial Components | DPAK(TO-252) | 60 | 80 | No |  | 10 | 6.5 | 27 | 3.9 | 5.6 |  |  | 6.7 | 4.029850746 | 1.2 | https://www.mccsemi.com/pdf/Products/MCU6D5N06YLQ(DPAK).pdf
RD3L08DBLHRB | ROHM Semiconductor | DPAK | 60 | 80 | No |  | 10 | 7.6 | 22 | 3.7 | 4.7 |  |  | 6.05 | 3.636363636 | 1.5 | https://fscdn.rohm.com/en/products/databook/datasheet/discrete/transistor/mosfet/rd3l08dblhrbtl-e.pdf
MCU95N06KY | Micro Commercial Components | DPAK(TO-252) | 60 | 95 | No |  | 10 | 5.5 | 71 | 14 | 12 |  |  | 20 | 3.55 | 1.3 | https://www.mccsemi.com/pdf/Products/MCU95N06KY(DPAK).pdf
MCU110N06YA | Micro Commercial Components | DPAK(TO-252) | 60 | 110 | No |  | 10 | 4.4 | 80 | 12 | 15 |  |  | 19.5 | 4.102564103 | 1.2 | https://www.mccsemi.com/pdf/Products/MCU110N06YA(DPAK).pdf
RD3L08CBLHRB | ROHM Semiconductor | TO-252 | 60 | 80 | No |  | 10 | 5.3 | 32 | 5.3 | 6.7 |  |  | 8.65 | 3.69942 | 1.5 | https://fscdn.rohm.com/en/products/databook/datasheet/discrete/transistor/mosfet/rd3l08cblhrbtl-e.pdf
SFT1446-TL-H |  |  |  |  |  |  |  |  |  |  |  |  |  |  |  |  | //mm.digikey.com/Volume0/opasdata/d220001/medias/docus/2101/SFT1446.pdf
NVD5490NLT4G |  |  |  |  |  |  |  |  |  |  |  |  |  |  |  |  | //mm.digikey.com/Volume0/opasdata/d220001/medias/docus/211/NVD5490NL.pdf
NVD5414NT4G-VF01 |  |  |  |  |  |  |  |  |  |  |  |  |  |  |  |  | //mm.digikey.com/Volume0/opasdata/d220001/medias/docus/423/NTD%2CNVD5414N.pdf
NVD5490NLT4G-VF01 |  |  |  |  |  |  |  |  |  |  |  |  |  |  |  |  | https://www.onsemi.com/pdf/datasheet/nvd5490nl-d.pdf
NTDV20N06LT4G |  |  |  |  |  |  |  |  |  |  |  |  |  |  |  |  | https://www.onsemi.com/pub/Collateral/NTD20N06L-D.PDF
FDD5690 |  |  |  |  |  |  |  |  |  |  |  |  |  |  |  |  | https://www.onsemi.com/pub/Collateral/FDD5690-D.PDF
GSFD0625 | GOOD-ARK SEMICONDUCTOR | TO-252 (DPAK) | 60 | 27 | No |  | 10 | 28 | 16.4 | 3.7 | 3.1 |  |  | 5.25 | 3.123809524 | 1 | https://goodarksemi.com/docs/datasheets/mosfets/GSFD0625.pdf
SL50N06D |  |  |  |  |  |  |  |  |  |  |  |  |  |  |  |  | //mm.digikey.com/Volume0/opasdata/d220001/medias/docus/7181/SL50N06D%20TO-252%20.PDF
NTDV20N06LT4G-VF01 |  |  |  |  |  |  |  |  |  |  |  |  |  |  |  |  | https://www.onsemi.com/pub/Collateral/NTD20N06L-D.PDF
NVD5862NT4G |  |  |  |  |  |  |  |  |  |  |  |  |  |  |  |  | //mm.digikey.com/Volume0/opasdata/d220001/medias/docus/667/NVD5862N.pdf
GSFD0646 | Good-Ark Semiconductor | TO-252 (DPAK) | 60 | 45 | No |  | 10 | 12 | 39.2 | 8.8 | 5.9 |  |  | 11.75 | 3.336170213 | 1 | https://goodarksemi.com/docs/datasheets/mosfets/GSFD0646.pdf
GSFD6046 | GOOD-ARK Semiconductor | TO-252 (DPAK) | 60 | 20 | No |  | 10 | 46 | 2.2 | 3.9 | 16.6 |  |  | 12.2 | 0.1803278689 | 1.2 | https://goodarksemi.com/docs/datasheets/mosfets/GSFD6046.pdf
UMW 25N06 | UMW | TO-252 | 60 | 25 | No |  | 10 | 29 | 21.2 | 5.5 | 3.6 |  |  | 7.3 | 2.904109589 | 1.2 | https://www.umw-ic.com/static/pdf/9bf8ccb949e0e45bbb65c3a799afcd71.pdf
PJD11N06A-AU_L2_000A1 |  |  |  |  |  |  |  |  |  |  |  |  |  |  |  |  | https://www.panjit.com.tw/upload/datasheet/PJD11N06A-AU.pdf
UMW STD35NF06L | UMW | TO-252(DPAK) | 60 | 35 | No |  | 10 | 20 | 44.5 | 17.5 | 10.5 |  |  | 22.75 | 1.956 | 1.5 | https://www.umw-ic.com/static/pdf/aad32344492410b24b286d330a5bd9fd.pdf
G15N06K | GOFORD | TO-252 | 60 | 15 | No |  | 10 | 45 | 16 | 4 | 2 |  |  | 5 | 3.2 | 1.2 | https://www.gofordsemi.com/upload/cn/propdf/G15N06K.pdf
NVD5484NLT4G |  |  |  |  |  |  |  |  |  |  |  |  |  |  |  |  | //mm.digikey.com/Volume0/opasdata/d220001/medias/docus/211/NVD5484NL.pdf
UMW 30N06 | UMW | TO-252 | 60 | 35 | No |  | 10 | 29 | 21.2 | 5.5 | 3.6 |  |  | 7.3 | 2.904109589 | 1.2 | https://www.umw-ic.com/static/pdf/10c29d1b7b8c7d113b550cd35191961f.pdf
UMW STD20NF06L | UMW | TO-252 | 60 | 30 | No |  | 10 | 35 | 25 | 6.5 | 4.5 |  |  | 8.75 | 2.857 | 1.2 | https://www.umw-ic.com/static/pdf/3b9c950fbe09f279c5756f944ed64f54.pdf
UMW STD30NF06L | UMW | TO-252 | 60 | 30 | No |  | 10 | 29 | 25 | 6.5 | 4.5 |  |  | 8.75 | 2.857142857 | 1.2 | https://www.umw-ic.com/static/pdf/0133bfb8c352b79ec3add0e1dbebdd5f.pdf
FDD5810 | UMW | TO-252 | 60 | 37 | No |  | 10 | 22 | 24 | 5 | 4 | 1.3 | 2.7 | 7.7 | 3.116883117 | 1.25 | https://www.umw-ic.com/static/pdf/e1a344fed86a640d6ea8d0423eb25f6b.pdf
GSFD9R706 | Good-Ark Semiconductor | TO-252 (DPAK) | 60 | 60 | No |  | 10 | 9.7 | 18 | 2.7 | 5.6 |  |  | 5.5 | 3.272727273 | 1.2 | https://goodarksemi.com/docs/datasheets/mosfets/GSFD9R706.pdf
UMW SUD23N06-31 | UMW | TO-252 | 60 | 35 | No |  | 10 | 31 | 11 | 3 | 3 |  |  | 4.5 | 2.44 | 1.5 | https://www.umw-ic.com/static/pdf/805d406edfa42da735cd3493152ebd70.pdf
G23N06K | GOFORD | TO-252 | 60 | 23 | No |  | 10 | 35 | 25 | 6 | 5 |  |  | 8.5 | 2.94 | 1.2 | https://www.gofordsemi.com/upload/cn/propdf/G23N06K.pdf
G25N06K | GOFORD | TO-252 | 60 | 25 | No |  | 10 | 27 | 25 | 6.5 | 4.5 |  |  | 8.75 | 2.857142857 | 1.2 | https://www.gofordsemi.com/upload/cn/propdf/G25N06K.pdf
IRFR024 |  |  |  |  |  |  |  |  |  |  |  |  |  |  |  |  | //mm.digikey.com/Volume0/opasdata/d220001/medias/docus/7158/5272_IRFR024.pdf
60N06 | GOFORD | TO-252 | 60 | 55 | No |  | 10 | 17 | 54 | 10 | 6 |  |  | 13 | 4.153846154 | 1.2 | https://www.gofordsemi.com/upload/cn/propdf/60N06.pdf
NTD24N06T4G |  |  |  |  |  |  |  |  |  |  |  |  |  |  |  |  | https://www.onsemi.com/pdf/datasheet/ntd24n06-d.pdf
UMW 40N06 | UMW | TO-252 | 60 | 40 | No |  | 10 | 18 | 50 | 15 | 6 |  |  | 18 | 2.78 | 1.2 | https://www.umw-ic.com/static/pdf/421fa9ccd19f7517567e82d51a4d62cd.pdf
UMW 30N06 | UMW | TO-252 | 60 | 30 | No |  | 10 | 29 | 25 | 6.5 | 4.5 |  |  | 8.75 | 2.857142857 | 1.2 | https://www.umw-ic.com/static/pdf/f03367495a5f5748816e5dcea2b3f79a.pdf
AM90N06-04D | Analog Power | TO-252 | 60 | 83 | No |  | 4.5 | 5.8 | 64 | 22 | 20 |  |  | 32 | 2 | 0.86 | //mm.digikey.com/Volume0/opasdata/d220001/medias/docus/6167/AM90N06-04D.pdf
UMW 50N06 | UMW | TO-252 | 60 | 50 | No |  | 10 | 17 | 50 | 15 | 6 |  |  | 18 | 2.78 | 1.2 | https://www.umw-ic.com/static/pdf/1d470444ea152bf302bea3580c0ff6d0.pdf
UMW FQD20N06 | UMW | TO-252(DPAK) | 60 | 45 | No |  | 10 | 31 | 11 | 3 | 3 |  |  | 4.5 | 2.44 | 1.5 | https://www.umw-ic.com/static/pdf/a83d39f716e95798473a378f909e1bc9.pdf
GT055N06K | GOFORD | TO-252 | 60 | 90 | No |  | 10 | 5 | 30 | 5 | 4.5 |  |  | 7.25 | 4.137931034 | 1.2 | https://www.gofordsemi.com/upload/cn/propdf/GT055N06K.pdf
G58N06K | GOFORD | TO-252 | 60 | 58 | No |  | 10 | 13 | 36 | 6.5 | 10 |  |  | 11.5 | 3.13 | 1.2 | https://www.gofordsemi.com/upload/cn/propdf/G58N06K.pdf
GT090N06K | GOFORD | TO-252 | 60 | 45 | No |  | 10 | 9 | 22 | 4 | 5 |  |  | 6.5 | 3.384615385 | 1.2 | https://www.gofordsemi.com/upload/cn/propdf/GT090N06K.pdf
IRFR024 | Vishay Siliconix | DPAK (TO-252) | 60 | 14 | No |  | 10 | 100 | 25 | 11 | 5.8 |  |  | 13.9 | 1.79856 | 1.5 | https://www.vishay.com/docs/91264/sihfr024.pdf
G080N06K | GOFORD | TO-252 | 60 | 80 | No |  | 10 | 8 | 62 | 20 | 16 |  |  | 28 | 2.214285714 | 1.2 | https://www.gofordsemi.com/upload/cn/propdf/G080N06K.pdf
UMW IRFR1018ETR | UMW | TO-252 | 60 | 56 | No |  | 10 | 8.4 | 46 | 12 | 10 |  |  | 17 | 2.705882353 | 1.3 | https://www.umw-ic.com/static/pdf/67438361e7c0c11105bbc21d09ed1155.pdf
UMW IRFR3806TR | UMW | TO-252 | 60 | 43 | No |  | 10 | 15.8 | 22 | 6.3 | 5 |  |  | 8.8 | 2.5 | 1.3 | https://www.umw-ic.com/static/pdf/a8d35f27af7a3f88e5029f37d624accf.pdf
GT100N12K | GOFORD | TO-252 | 120 | 70 | No |  | 10 | 10 | 45 | 11 | 16 |  |  | 19 | 2.368421053 | 1.2 | https://www.gofordsemi.com/upload/cn/propdf/GT100N12K.pdf
SQD15N06-42L | Vishay Siliconix | TO-252 | 60 | 15 | No |  | 10 | 42 | 9.5 | 2.5 | 1.7 |  |  | 3.35 | 2.8358 | 1.2 | https://www.vishay.com/docs/68880/sqd15n06-42l.pdf
G86N06K | GOFORD | TO-252 | 60 | 80 | No |  | 10 | 8.4 | 61 | 20 | 16 |  |  | 28 | 2.178571429 | 1.2 | https://www.gofordsemi.com/upload/cn/propdf/G86N06K.pdf
2SK3402-AZ |  |  |  |  |  |  |  |  |  |  |  |  |  |  |  |  | //mm.digikey.com/Volume0/opasdata/d220001/medias/docus/7138/2156_D14473EJ4V0DS00.pdf
UMW IRFR7546TR | UMW | TO-252 | 60 | 71 | No |  | 10 | 7.9 | 58 | 18 | 14 |  |  | 25 | 2.32 | 1.2 | https://www.umw-ic.com/static/pdf/7fddc74855c1422269214fc8e61d300d.pdf
G110N06K | GOFORD | TO-252 | 60 | 110 | No |  | 10 | 6.4 | 144 | 34 | 19 |  |  | 43.5 | 3.310344828 | 1.2 | https://www.gofordsemi.com/upload/cn/propdf/G110N06K.pdf
FDD86581-F085 |  |  |  |  |  |  |  |  |  |  |  |  |  |  |  |  | https://www.onsemi.com/pub/Collateral/FDD86581_F085-D.PDF
FDD86569-F085 |  |  |  |  |  |  |  |  |  |  |  |  |  |  |  |  | https://www.onsemi.com/pub/Collateral/FDD86569_F085-D.PDF
GT100N12K | GOFORD | TO-252 | 120 | 70 | No |  | 10 | 10 | 45 | 11 | 16 |  |  | 19 | 2.368421053 | 1.2 | https://www.gofordsemi.com/upload/cn/propdf/GT100N12K.pdf
NTD20N06T4G |  |  |  |  |  |  |  |  |  |  |  |  |  |  |  |  | https://www.onsemi.com/pdf/datasheet/ntd20n06-d.pdf
SQD50034E | Vishay Siliconix | TO-252 | 60 | 100 | No |  | 10 | 3.9 | 58 | 5 | 24 |  |  | 17 | 3.41 | 1.5 | https://www.vishay.com/docs/79706/sqd50034e.pdf
NTD5862NT4G |  |  |  |  |  |  |  |  |  |  |  |  |  |  |  |  | https://www.onsemi.com/pdf/datasheet/ntd5862n-d.pdf
FDD10AN06A0 | onsemi | DPAK3 (TO-252 3 LD) | 60 | 50 | No |  | 10 | 10.5 | 28 | 7.8 | 9.8 | 3.5 | 6.4 | 14.2 | 1.97 | 1.25 | https://www.onsemi.com/download/data-sheet/pdf/fdd10an06a0-d.pdf
NTD5C668NLT4G |  |  |  |  |  |  |  |  |  |  |  |  |  |  |  |  | https://www.onsemi.com/pdf/datasheet/ntd5c668nl-d.pdf
NTD5C648NLT4G |  |  |  |  |  |  |  |  |  |  |  |  |  |  |  |  | https://www.onsemi.com/pdf/datasheet/ntd5c648nl-d.pdf
MDD20N06D |  |  |  |  |  |  |  |  |  |  |  |  |  |  |  |  | //mm.digikey.com/Volume0/opasdata/d220001/medias/docus/7752/MDD20N06D000SD.pdf
MDD50N06D |  |  |  |  |  |  |  |  |  |  |  |  |  |  |  |  | //mm.digikey.com/Volume0/opasdata/d220001/medias/docus/7753/MDD50N06D000SD.pdf
2SK3402-ZK-E1-AY |  |  |  |  |  |  |  |  |  |  |  |  |  |  |  |  | //mm.digikey.com/Volume0/opasdata/d220001/medias/docus/7138/2156_D14473EJ4V0DS00.pdf
PJD25N06A_L2_00001 |  |  |  |  |  |  |  |  |  |  |  |  |  |  |  |  | https://www.panjit.com.tw/upload/datasheet/PJD25N06A.pdf
DMN6017SK3 | Diodes Incorporated | TO252 (DPAK) | 60 | 43 | No |  | 10 | 18 | 55 | 8.5 | 6.2 |  |  | 11.6 | 4.74137931 | 1 | https://www.diodes.com/assets/Datasheets/DMN6017SK3.pdf
DI020N06D1 | Diotec Semiconductor | TO-252AA | 60 | 20 | No |  | 10 | 35 | 25.3 | 6.1 | 4.7 |  |  | 8.45 | 2.99408284 | 1.2 | https://diotec.com/request/datasheet/di020n06d1.pdf
CMS16N06D-HF |  |  |  |  |  |  |  |  |  |  |  |  |  |  |  |  | https://www.comchiptech.com/admin/files/product/SP-JTR40%20CMS16N06D-HF%20RevB.pdf
NTD3055L170T4G |  |  |  |  |  |  |  |  |  |  |  |  |  |  |  |  | https://www.onsemi.com/pdf/datasheet/ntd3055l170-d.pdf
GSFD6016 | GOOD-ARK SEMICONDUCTOR | TO-252 (DPAK) | 60 | 60 | No |  | 10 | 13 | 52 | 12 | 11 |  |  | 17.5 | 2.971428571 | 1.3 | https://goodarksemi.com/docs/datasheets/mosfets/GSFD6016.pdf
AM50N06-15D-CT |  |  |  |  |  |  |  |  |  |  |  |  |  |  |  |  | //mm.digikey.com/Volume0/opasdata/d220001/medias/docus/6133/AM50N06-15D.pdf
GT025N06AK | GOFORD | TO-252 | 60 | 170 | No |  | 10 | 2.5 | 102 | 23 | 14 |  |  | 30 | 3.4 | 1.2 | https://www.gofordsemi.com/upload/cn/propdf/GT025N06AK.pdf
VTR06N750LSA | Viitor Semiconductor | TO-252 | 60 | 12 | No |  | 10 | 75 | 8.6 | 1.2 | 1.8 |  |  | 2.1 | 4.095238095 | 1.2 | https://viitorsemi.com/wp-content/uploads/VTR06N750LSA_datasheet.pdf
VTR06N340LSA | Viitor Semiconductor | TO-252 | 60 | 20 | No |  | 10 | 34 | 19 | 2.6 | 4.3 |  |  | 4.75 | 4 | 1.3 | https://viitorsemi.com/wp-content/uploads/VTR06N340LSA_datasheet.pdf
VTR06N180LSA | Viitor Semiconductor | TO-252 | 60 | 38 | No |  | 10 | 18 | 37 | 5 | 8 |  |  | 9 | 4.111111111 | 1.2 | https://viitorsemi.com/wp-content/uploads/VTR06N180LSA_datasheet.pdf
DMN6068LK3 | Diodes Incorporated | TO252 | 60 | 8.5 | No |  | 10 | 68 | 10.3 | 3.5 | 1.6 |  |  | 4.3 | 2.395348837 | 1.15 | https://www.diodes.com/assets/Datasheets/DMN6068LK3.pdf
FDD13AN06A0 |  |  |  |  |  |  |  |  |  |  |  |  |  |  |  |  | https://www.onsemi.com/pub/Collateral/FDD13AN06A0-D.PDF
DMTH6016LK3 | Diodes Incorporated | TO252 (DPAK) | 60 | 46.9 | No |  | 10 | 17 | 17 | 4.3 | 3.1 |  |  | 5.85 | 2.905982906 | 1.2 | https://www.diodes.com/assets/Datasheets/DMTH6016LK3.pdf
DMTH6005LK3Q | Diodes Incorporated | TO252 (DPAK) | 60 | 90 | No |  | 10 | 5.6 | 47.1 | 12.5 | 10.2 |  |  | 17.6 | 2.676 | 1.2 | https://www.diodes.com/datasheet/download/DMTH6005LK3Q.pdf
IRLR014 | Vishay Siliconix | DPAK (TO-252) | 60 | 7.7 | Yes | 10 | 5 | 200 | 8.4 | 6 | 3.5 |  |  | 7.75 | 1.083870968 | 1.6 | https://www.vishay.com/docs/91321/sihlr014.pdf
IRLR014 | Vishay Siliconix | DPAK (TO-252) | 60 | 7.7 | Yes | 10 | 5 | 200 | 8.4 | 6 | 3.5 |  |  | 7.75 | 1.08 | 1.6 | https://www.vishay.com/docs/91321/sihlr014.pdf
MCU80N06A | Micro Commercial Components | DPAK | 60 | 80 | No |  | 10 | 7.5 | 32.4 | 5.6 | 5.2 |  |  | 8.2 | 3.951219512 | 1.2 | https://www.mccsemi.com/pdf/Products/MCU80N06A(DPAK).pdf
DMTH6010LK3 | Diodes Incorporated | TO252 | 60 | 70 | No |  | 10 | 8 | 41.3 | 8.8 | 6 |  |  | 11.8 | 3.5 | 1.2 | https://www.diodes.com/assets/Datasheets/DMTH6010LK3.pdf
RD3L04BBKHRB | ROHM Semiconductor | TO-252 | 60 | 40 | No |  | 10 | 13.5 | 13 | 2.4 | 2.1 |  |  | 3.45 | 3.768115942 | 1.5 | https://fscdn.rohm.com/en/products/databook/datasheet/discrete/transistor/mosfet/rd3l04bbkhrbtl-e.pdf
NTD5C632NLT4G |  |  |  |  |  |  |  |  |  |  |  |  |  |  |  |  | https://www.onsemi.com/pdf/datasheet/ntd5c632nl-d.pdf
STD30NF06 | STMicroelectronics | IPAK/DPAK | 60 | 28 | No |  | 10 | 28 | 43 | 15 | 9.5 |  |  | 19.75 | 2.17721519 | 1.5 | https://www.st.com/content/ccc/resource/technical/document/datasheet/e1/75/62/2a/23/6b/4a/2b/CD00002891.pdf/files/CD00002891.pdf/jcr:content/translations/en.C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
DMN3011LSSQ | Diodes Incorporated | SO-8 | 30 | 11 | No |  | 10 | 10 | 19.7 | 1.4 | 3.8 |  |  | 3.3 | 5.96969697 | 1 | https://www.mouser.com/datasheet/3/175/1/DMN3011LSSQ.pdf
DMC3028LSDXQ | Diodes Incorporated | SO-8 | 30 | 7.2 | No |  | 10 | 27 | 13.2 | 2.2 | 1.7 |  |  | 3.05 | 4.327868852 | 1.2 | https://www.mouser.com/datasheet/3/175/1/DMC3028LSDXQ.pdf
DMG4466SSSL | Diodes Incorporated | SO-8 | 30 | 10 | No |  | 10 | 23 | 10.5 | 1.6 | 1.8 |  |  | 2.5 | 4.2 | 1 | https://www.mouser.com/datasheet/3/175/1/ds32244.pdf
BSO220N03MD G | Infineon | PG-DSO-8 | 30 | 7.7 | No |  | 10 | 22 | 7.8 | 0.9 | 1.8 | 1 |  | 1.7 | 4.588235294 | 1.1 | https://www.mouser.com/datasheet/3/70/1/BSO220N03MD_rev1.1.pdf
ZXMC3A16DN8 | Zetex | SO8 | 30 | 6.4 | No |  | 10 | 35 | 17.5 | 3.1 | 2.3 |  |  | 4.25 | 4.117647059 | 0.95 | https://www.mouser.com/datasheet/3/175/1/ZXMC3A16DN8.pdf
DMHC3025LSD | Diodes Incorporated | SO-8 | 30 | 6 | No |  | 10 | 25 | 11.7 | 2.1 | 1.8 |  |  | 3 | 3.9 | 1.2 | https://www.mouser.com/datasheet/3/175/1/DMHC3025LSD.pdf
ZXMC3A16DN8 | Zetex | SO8 | 30 | 6.4 | No |  | 10 | 35 | 17.5 | 3.1 | 2.3 |  |  | 4.25 | 4.117647059 | 0.95 | https://www.mouser.com/datasheet/3/175/1/ZXMC3A16DN8.pdf
IRF7319PbF | International Rectifier | SO-8 | 30 | 6.5 | No |  | 10 | 29 | 22 | 6.4 | 2.6 |  |  | 7.7 | 2.857 | 1 | https://www.mouser.com/datasheet/3/70/1/Infineon_IRF7319_DataSheet_v01_01_EN.pdf
IRF7389PbF | International Rectifier | SO-8 | 30 | 7.3 | No |  | 10 | 29 | 22 | 6.4 | 2.6 |  |  | 7.7 | 2.857142857 | 1 | https://www.mouser.com/datasheet/3/70/1/Infineon_IRF7389_DataSheet_v01_01_EN.pdf
DMT3020LSD | Diodes Incorporated | SO-8 | 30 | 16 | No |  | 10 | 20 | 7 | 1.5 | 0.9 |  |  | 1.95 | 3.58974359 | 1.2 | https://www.mouser.com/catalog/specsheets/diodes inc_diod-s-a0005424669-1.pdf
DMGD7N45SSD | Diodes Incorporated | SO-8 | 450 | 0.5 | No |  | 10 | 4000 | 6.9 | 3.4 | 1.4 |  |  | 4.1 | 1.68 | 1.2 | https://www.mouser.com/datasheet/3/175/1/DMGD7N45SSD.pdf
ZXMHC3A01N8 | Diodes Incorporated | SO-8 | 30 | 2.72 | No |  | 10 | 125 | 3.9 | 0.9 | 0.6 |  |  | 1.2 | 3.25 | 0.95 | https://www.mouser.com/datasheet/3/175/1/ZXMHC3A01N8.pdf
IRF7309PbF | International Rectifier | SO-8 | 30 | 4 | No |  | 4.5 | 80 | 25 | 7.9 | 2.9 |  |  | 9.35 | 2.673796791 | 1 | https://www.mouser.com/datasheet/3/70/1/Infineon_IRF7309_DataSheet_v01_01_EN.pdf
ZXMHC3F381N8 | Diodes Incorporated | SO-8 | 30 | 4.98 | No |  | 10 | 33 | 9 | 2 | 1.7 |  |  | 2.85 | 3.16 | 1.2 | https://www.mouser.com/datasheet/3/175/1/ZXMHC3F381N8.pdf
DMC3021LSD | Diodes Incorporated | SO-8 | 30 | 8.5 | No |  | 10 | 21 | 16.1 | 2.5 | 1.8 |  |  | 3.4 | 4.735 | 1 | https://www.mouser.com/datasheet/3/175/1/ds32152.pdf
IRF8788PbF | International Rectifier | SO-8 | 30 | 24 | No |  | 4.5 | 3.8 | 44 | 14 |  | 12 | 4.7 | 18.7 | 2.35 | 1 | https://www.mouser.com/datasheet/3/70/1/Infineon_IRF8788_DataSheet_v01_01_EN.pdf
IRF7862PbF | International Rectifier | SO-8 | 30 | 21 | No |  | 10 | 3.3 | 30 | 9.8 |  | 7.5 | 3.1 | 12.9 | 2.325581395 | 1 | https://www.mouser.com/datasheet/3/70/1/Infineon_IRF7862_DataSheet_v01_01_EN.pdf
IRF7907PbF | International Rectifier | SO-8 | 30 | 9.1 | No |  | 10 | 16.4 | 6.7 | 2.5 |  | 1.3 | 0.7 | 3.2 | 2.09 | 1 | https://www.mouser.com/datasheet/3/70/1/Infineon_IRF7907_DataSheet_v01_01_EN.pdf
IRF8734PbF | International Rectifier | SO-8 | 30 | 21 | No |  | 10 | 3.5 | 20 | 6.9 |  | 5.2 | 2.3 | 9.2 | 2.1739 | 1 | https://www.mouser.com/datasheet/3/70/1/Infineon_IRF8734_DataSheet_v01_01_EN.pdf
IRF8736PbF | International Rectifier | SO-8 | 30 | 18 | No |  | 10 | 4.8 | 17 | 5.8 |  | 4.4 | 1.9 | 7.7 | 2.207792208 | 1 | https://www.mouser.com/datasheet/3/70/1/Infineon-IRF8736-DataSheet-v01_01-EN.pdf
IRF7451PbF | International Rectifier | SO-8 | 150 | 3.6 | No |  | 10 | 90 | 28 | 13 | 6.8 |  |  | 16.4 | 1.7073 | 1.3 | https://www.mouser.com/datasheet/3/70/1/Infineon-IRF7451-DataSheet-v01_01-EN.pdf
DMN3024LSS | Diodes Incorporated | SO-8 | 30 | 8.5 | No |  | 10 | 24 | 12.9 | 2.5 | 2.5 |  |  | 3.75 | 3.44 | 1.2 | https://www.mouser.com/datasheet/3/175/1/DMN3024LSS.pdf
ZXMN3B04N8 | Diodes Incorporated | SO-8 | 30 | 8.9 | Yes | 12 | 4.5 | 25 | 23.1 | 6.2 | 4.9 |  |  | 8.65 | 2.67052 | 0.95 | https://www.mouser.com/datasheet/3/175/1/ZXMN3B04N8.pdf
DMHC3025LSD | Diodes Incorporated | SO-8 | 30 | 6 | No |  | 10 | 25 | 11.7 | 2.1 | 1.8 |  |  | 3 | 3.9 | 1.2 | https://www.mouser.com/datasheet/3/175/1/DMHC3025LSD.pdf
IRF9952PbF | International Rectifier | SO-8 | 30 | 3.5 | No |  | 10 | 100 | 6.9 | 1.8 | 1 |  |  | 2.3 | 3 | 1.2 | https://www.mouser.com/datasheet/3/70/1/Infineon_IRF9952_DataSheet_v01_01_EN.pdf
IRF7832PbF | International Rectifier | SO-8 | 30 | 20 | No |  | 10 | 4 | 34 | 12 |  | 8.6 | 2.9 | 14.9 | 2.28 | 1 | https://www.mouser.com/datasheet/3/70/1/Infineon_IRF7832_DataSheet_v01_01_EN.pdf
DMN3018SSS | Diodes Incorporated | SO-8 | 30 | 7.3 | No |  | 10 | 21 | 13.2 | 1.8 | 2.2 |  |  | 2.9 | 4.55 | 1.2 | https://www.mouser.com/datasheet/3/175/1/DMN3018SSS.pdf
DMC3028LSD | Diodes Incorporated | SO-8 | 30 | 7.1 | No |  | 10 | 28 | 10.5 | 2.3 | 1.86 |  |  | 3.23 | 3.25 | 1.2 | https://www.mouser.com/datasheet/3/175/1/DMC3028LSD.pdf
DMN3024LSD | Diodes Incorporated | SO-8 | 30 | 7.2 | No |  | 10 | 24 | 12.9 | 2.5 | 2.5 |  |  | 3.75 | 3.44 | 1.2 | https://www.mouser.com/datasheet/3/175/1/DMN3024LSD.pdf
ZXMN3F31DN8 | Zetex Semiconductors | SO8 | 30 | 7.3 | No |  | 10 | 24 | 12.9 | 2.52 | 2.5 |  |  | 3.77 | 3.42 | 1.2 | https://www.mouser.com/datasheet/3/175/1/ZXMN3F31DN8.pdf
DMN3033LSD | Diodes Incorporated | SO-8 | 30 | 6.9 | No |  | 10 | 20 | 13 | 3.2 | 1.9 |  |  | 4.15 | 3.13 | 1.2 | https://www.mouser.com/datasheet/3/175/1/ds31262.pdf
DMG4466SSS | Diodes Incorporated | SO-8 | 30 | 10 | No |  | 10 | 23 | 10.5 | 1.6 | 1.8 |  |  | 2.5 | 4.2 | 1 | https://www.mouser.com/datasheet/3/175/1/ds32137.pdf
DMN4800LSSL | Diodes Incorporated | SO-8 | 30 | 8 | No |  | 10 | 14 | 8.7 | 2.4 | 1.7 |  |  | 3.25 | 2.676923077 | 0.94 | https://www.mouser.com/datasheet/3/175/1/DMN4800LSSL.pdf
DMG4822SSD | Diodes Incorporated | SO-8 | 30 | 10 | No |  | 10 | 20 | 10.5 | 1.6 | 1.8 |  |  | 2.5 | 4.2 | 1 | https://www.mouser.com/datasheet/3/175/1/DMG4822SSD.pdf
DMN3010LSS | Diodes Incorporated | SOP-8L | 30 | 16 | No |  | 10 | 9 | 43.7 | 12.6 | 5.5 |  |  | 15.35 | 2.846905537 | 1.2 | https://www.mouser.com/datasheet/3/175/1/ds31259.pdf
DMN3025LSS | Diodes Incorporated | SO-8 | 30 | 7.2 | No |  | 10 | 20 | 13.2 | 2.2 | 1.7 |  |  | 3.05 | 4.327868852 | 1 | https://www.mouser.com/datasheet/3/175/1/DMN3025LSS.pdf
DMC3028LSDX | Diodes Incorporated | SO-8 | 30 | 7.2 | No |  | 10 | 27 | 13.2 | 2.2 | 1.7 |  |  | 3.05 | 4.327868852 | 1.2 | https://www.mouser.com/datasheet/3/175/1/DMC3028LSDX.pdf
DMC3032LSD | Diodes Incorporated | SO-8 | 30 | 8.1 | No |  | 10 | 32 | 9.2 | 1.8 | 1.2 |  |  | 2.4 | 3.833333333 | 1 | https://www.mouser.com/datasheet/3/175/1/ds32153.pdf
DMC3021LSD | Diodes Incorporated | SO-8 | 30 | 8.5 | No |  | 10 | 21 | 16.1 | 2.5 | 1.8 |  |  | 3.4 | 4.74 | 1 | https://www.mouser.com/datasheet/3/175/1/ds32152.pdf
ZXMN3G32DN8 | Zetex Semiconductors | SO8 | 30 | 7.1 | No |  | 10 | 28 | 10.5 | 2.3 | 1.86 |  |  | 3.23 | 3.25 | 1.2 | https://www.mouser.com/datasheet/3/175/1/ZXMN3G32DN8.pdf
ZXMN3A04DN8 | Zetex | SO8 | 30 | 8.5 | No |  | 10 | 20 | 36.8 | 7.1 | 5.8 |  |  | 10 | 3.68 | 0.95 | https://www.mouser.com/datasheet/3/175/1/ZXMN3A04DN8.pdf
ZXMN3A06DN8 | Zetex | SO8 | 30 | 6.2 | No |  | 10 | 35 | 17.5 | 3.1 | 2.3 |  |  | 4.25 | 4.117647059 | 0.95 | https://www.mouser.com/datasheet/3/175/1/ZXMN3A06DN8.pdf
DMC3025LSD | Diodes Incorporated | SO-8 | 30 | 8.5 | No |  | 10 | 20 | 9.8 | 2 | 1.6 |  |  | 2.8 | 3.5 | 1.2 | https://www.mouser.com/datasheet/3/175/1/DMC3025LSD.pdf
ZXMC3F31DN8 | Diodes Incorporated | SO-8 | 30 | 7.3 | No |  | 10 | 24 | 12.9 | 2.52 | 2.5 |  |  | 3.77 | 3.42175 | 1.2 | https://www.mouser.com/datasheet/3/175/1/ZXMC3F31DN8.pdf
DMC3026LSD | Diodes Incorporated | SO-8 | 30 | 6.5 | No |  | 10 | 25 | 13.2 | 2.2 | 1.7 |  |  | 3.05 | 4.327868852 | 1.2 | https://www.mouser.com/datasheet/3/175/1/DMC3026LSD.pdf
ZXMC3A17DN8 | Zetex | SO8 | 30 | 5.4 | No |  | 10 | 50 | 12.2 | 2.4 | 1.7 |  |  | 3.25 | 3.75 | 0.95 | https://www.mouser.com/datasheet/3/175/1/ZXMC3A17DN8.pdf
DMN4468LSS | Diodes Incorporated | SO-8 | 30 | 10 | No |  | 10 | 14 | 18.85 | 6.15 | 2.59 |  |  | 7.445 | 2.531900604 | 0.95 | https://www.mouser.com/datasheet/3/175/1/ds31773.pdf
DMN4800LSS | Diodes Incorporated | SO-8 | 30 | 8.6 | No |  | 10 | 14 | 8.7 | 2.4 | 1.7 |  |  | 3.25 | 2.676923077 | 0.94 | https://www.mouser.com/datasheet/3/175/1/ds31736.pdf
DMN4800LSSQ | Diodes Incorporated | SO-8 | 30 | 8.6 | No |  | 10 | 14 | 8.7 | 2.4 | 1.7 |  |  | 3.25 | 2.676923077 | 0.94 | https://www.mouser.com/datasheet/3/175/1/DMN4800LSSQ.pdf
BSO150N03MD G | Infineon | PG-DSO-8 | 30 | 9.3 | No |  | 10 | 15 | 12.6 | 1.4 | 2.8 | 1.5 |  | 2.6 | 4.846153846 | 1.1 | https://www.mouser.com/datasheet/3/70/1/BSO150N03MD_rev1.1.pdf
BSO150N03MD G | Infineon | PG-DSO-8 | 30 | 9.3 | No |  | 10 | 15 | 12.6 | 1.4 | 2.8 | 1.5 |  | 2.6 | 4.846153846 | 1.1 | https://www.mouser.com/datasheet/3/70/1/BSO150N03MD_rev1.1.pdf
DMHC4035LSD | Diodes Incorporated | SO-8 | 40 | 4.5 | No |  | 10 | 45 | 12.5 | 2.2 | 1.7 |  |  | 3.05 | 4.098360656 | 1 | https://www.mouser.com/datasheet/3/175/1/DMHC4035LSD.pdf
DMT3020LSDQ | Diodes Incorporated | SO-8 | 30 | 16 | No |  | 10 | 20 | 7 | 1.5 | 0.9 |  |  | 1.95 | 3.58974359 | 1.2 | https://www.mouser.com/datasheet/3/175/1/DMT3020LSDQ.pdf
DMN3018SSD | Diodes Incorporated | SO-8 | 30 | 6.7 | No |  | 10 | 22 | 13.2 | 1.8 | 2.2 |  |  | 2.9 | 4.5517 | 1.2 | https://www.mouser.com/datasheet/3/175/1/DMN3018SSD.pdf
DMN3016LSS | Diodes Incorporated | SO-8 | 30 | 10.3 | No |  | 10 | 12 | 25.1 | 3.6 | 3.5 |  |  | 5.35 | 4.691588785 | 1 | https://www.mouser.com/datasheet/3/175/1/DMN3016LSS.pdf
DMN3015LSD | Diodes Incorporated | SO-8 | 30 | 8.4 | No |  | 10 | 15 | 25.1 | 3.6 | 3.5 |  |  | 5.35 | 4.691588785 | 1 | https://www.mouser.com/datasheet/3/175/1/DMN3015LSD.pdf
DMN3033LSDQ | Diodes Incorporated | SO-8 | 30 | 6.9 | No |  | 10 | 20 | 13 | 3.2 | 1.9 |  |  | 4.15 | 3.13253012 | 1.2 | https://www.mouser.com/datasheet/3/175/1/DMN3033LSDQ.pdf
DMC3016LSD | Diodes Incorporated | SO-8 | 30 | 8.2 | No |  | 10 | 16 | 25.1 | 3.6 | 3.5 |  |  | 5.35 | 4.69 | 1 | https://www.mouser.com/datasheet/3/175/1/DMC3016LSD.pdf
DMN3011LSS | Diodes Incorporated | SO-8 | 30 | 11 | No |  | 10 | 10 | 19.7 | 1.4 | 3.8 |  |  | 3.3 | 5.96969697 | 1 | https://www.mouser.com/datasheet/3/175/1/DMN3011LSS.pdf
CWDM3011N | Central Semiconductor | SOIC-8 | 30 | 11 | No |  | 10 | 20 | 6.3 | 2.3 | 2 |  |  | 3.3 | 1.909090909 | 1.2 | https://www.mouser.com/datasheet/3/312/1/CWDM3011N.pdf
CWDM305ND | Central Semiconductor | SOIC-8 | 30 | 5.8 | No |  | 10 | 30 | 4.2 | 1.4 | 0.9 |  |  | 1.85 | 2.27 | 1.2 | https://www.mouser.com/datasheet/3/312/1/CWDM305ND.pdf
DMN39M1LSS | Diodes Incorporated | SO-8 | 30 | 15 | No |  | 10 | 5.5 | 42 | 7 | 7 |  |  | 10.5 | 4 | 1.2 | https://www.mouser.com/datasheet/3/175/1/DMN39M1LSS.pdf
CWDM305N | Central Semiconductor | SOIC-8 | 30 | 5.8 | No |  | 10 | 30 | 4.2 | 1.4 | 0.9 |  |  | 1.85 | 2.27 | 1.2 | https://www.mouser.com/datasheet/3/312/1/CWDM305N.pdf
DMN39M1LSSQ | Diodes Incorporated | SO-8 | 30 | 15 | No |  | 10 | 5.5 | 42 | 7 | 7 |  |  | 10.5 | 4 | 1.2 | https://www.mouser.com/datasheet/3/175/1/DMN39M1LSSQ.pdf
BSO110N03MS G | Infineon | PG-DSO-8 | 30 | 12.1 | No |  | 10 | 11 | 15 | 1.6 | 3.4 | 1.8 |  | 3.1 | 4.838709677 | 1.1 | https://www.mouser.com/datasheet/3/70/1/Infineon-BSO110N03MS-DS-v01_01-en.pdf
BSO110N03MS G | Infineon | PG-DSO-8 | 30 | 12.1 | No |  | 10 | 11 | 15 | 1.6 | 3.4 | 1.8 |  | 3.1 | 4.838709677 | 1.1 | https://www.mouser.com/datasheet/3/70/1/Infineon-BSO110N03MS-DS-v01_01-en.pdf
BSO033N03MS G | Infineon | PG-DSO-8 | 30 | 22 | No |  | 10 | 3.3 | 93 | 9.6 | 19 |  |  | 17 | 5.47 | 1 | https://www.mouser.com/datasheet/3/70/1/BSO033N03MS_rev1.1.pdf
BSO220N03MD G | Infineon | PG-DSO-8 | 30 | 7.7 | No |  | 10 | 22 | 7.8 | 0.9 | 1.8 | 1 |  | 1.7 | 4.59 | 1.1 | https://www.mouser.com/datasheet/3/70/1/BSO220N03MD_rev1.1.pdf
BSO040N03MS G | Infineon | PG-DSO-8 | 30 | 20 | No |  | 10 | 4 | 55 | 5.8 | 11.4 |  |  | 10.4 | 5.288461538 | 1.1 | https://www.mouser.com/datasheet/3/70/1/BSO040N03MS_rev1.1.pdf
BSO033N03MS G | Infineon | PG-DSO-8 | 30 | 22 | No |  | 10 | 3.3 | 93 | 9.6 | 19 |  |  | 17 | 5.47 | 1 | https://www.mouser.com/datasheet/3/70/1/BSO033N03MS_rev1.1.pdf
IRF7465PbF | International Rectifier | SO-8 | 150 | 1.9 | No |  | 10 | 280 | 10 | 5 | 2.7 |  |  | 6.35 | 1.57480315 | 1.3 | https://www.mouser.com/datasheet/3/70/1/Infineon_IRF7465_DataSheet_v01_01_EN.pdf
NVMFS5C404NLWFAFT1G |  |  |  |  |  |  |  |  |  |  |  |  |  |  |  |  | https://www.mouser.com/datasheet/3/101/2/5432065D0598F67159BCA064DD2F5ABF266DBFF3BA295032961D3FE40199F025.pdf
DMN4034SSS | Diodes Incorporated | SO-8 | 40 | 7.2 | No |  | 10 | 34 | 10 | 2.4 | 1.8 |  |  | 3.3 | 3.03030303 | 1.1 | https://www.mouser.com/datasheet/3/175/1/DMN4034SSS.pdf
NVMFS5C442NWFAFT1G |  |  |  |  |  |  |  |  |  |  |  |  |  |  |  |  | https://www.mouser.com/datasheet/3/101/1/804E24787EDA45F202D37E77F39393E45261B59C6B3DFCA8C6F5A4CB7C80C54E.pdf
DMN4034SSD | Diodes Incorporated | SO-8 | 40 | 6.3 | No |  | 10 | 34 | 10 | 2.4 | 1.8 |  |  | 3.3 | 3.03 | 1.1 | https://www.mouser.com/datasheet/3/175/1/DMN4034SSD.pdf
DMC4050SSDQ | Diodes Incorporated | SO-8 | 40 | 5.8 | No |  | 10 | 45 | 37.56 | 6.6 | 7.8 |  |  | 10.5 | 3.577142857 | 1 | https://www.mouser.com/datasheet/3/175/1/DMC4050SSDQ.pdf
NVMFS5C450NL | onsemi | DFN5 (SO-8FL) | 40 | 110 | No |  | 10 | 2.8 | 35 | 5 | 7 |  |  | 8.5 | 4.117647059 | 1.2 | https://www.mouser.com/datasheet/3/101/1/NVMFS5C450NL-D.PDF
DMC4015SSD | Diodes Incorporated | SO-8 | 40 | 12.2 | No |  | 10 | 15 | 40 | 6.3 | 5.5 |  |  | 9.05 | 4.419889503 | 1 | https://www.mouser.com/datasheet/3/175/1/DMC4015SSD.pdf
DMN4026SSD | Diodes Incorporated | SO-8 | 40 | 9 | No |  | 10 | 24 | 19.1 | 2.5 | 3 |  |  | 4 | 4.775 | 1 | https://www.mouser.com/datasheet/3/175/1/DMN4026SSD.pdf
DMNH4026SSD | Diodes Incorporated | SO-8 | 40 | 7.5 | No |  | 10 | 24 | 19.1 | 2.5 | 3 |  |  | 4 | 4.775 | 1 | https://www.mouser.com/datasheet/3/175/1/DMNH4026SSD.pdf
DMC4040SSD | Diodes Incorporated | SO-8 | 40 | 7.5 | No |  | 10 | 25 | 37.6 | 6.6 | 7.8 |  |  | 10.5 | 3.580952381 | 1 | https://www.mouser.com/datasheet/3/175/1/DMC4040SSD.pdf
DMN4026SSD | Diodes Incorporated | SO-8 | 40 | 9 | No |  | 10 | 24 | 19.1 | 2.5 | 3 |  |  | 4 | 4.775 | 1 | https://www.mouser.com/datasheet/3/175/1/DMN4026SSD.pdf
DMN4031SSD | Diodes Incorporated | SO-8 | 40 | 7 | No |  | 10 | 31 | 18.6 | 2.2 | 3.3 |  |  | 3.85 | 4.83 | 1 | https://www.mouser.com/datasheet/3/175/1/DMN4031SSD.pdf
DMC4029SSD | Diodes Incorporated | SO-8 | 40 | 9 | No |  | 10 | 24 | 19.1 | 2.5 | 3 |  |  | 4 | 4.775 | 1 | https://www.mouser.com/datasheet/3/175/1/DMC4029SSD.pdf
IRF7842PbF | International Rectifier | SO-8 | 40 | 18 | No |  | 4.5 | 5.9 | 33 | 10 |  | 9.6 | 2.8 | 12.8 | 2.578125 | 1 | https://www.mouser.com/datasheet/3/70/1/Infineon-IRF7842-DataSheet-v01_01-EN.pdf
NVMFS5C442NLWFAFT1G |  |  |  |  |  |  |  |  |  |  |  |  |  |  |  |  | https://www.mouser.com/datasheet/3/101/2/5EBFD9C16595DB7F9526B3B1B20B26091D866298528082EC5906F323E61A19D7.pdf
DMC4029SSD | Diodes Incorporated | SO-8 | 40 | 9 | No |  | 10 | 24 | 19.1 | 2.5 | 3 |  |  | 4 | 4.775 | 1 | https://www.mouser.com/datasheet/3/175/1/DMC4029SSD.pdf
DMC4047LSD | Diodes Incorporated | SO-8 | 40 | 7 | No |  | 10 | 24 | 19.1 | 2.5 | 3 |  |  | 4 | 4.775 | 1 | https://www.mouser.com/datasheet/3/175/1/DMC4047LSD.pdf
DMNH4026SSDQ | Diodes Incorporated | SO-8 | 40 | 7.5 | No |  | 10 | 24 | 19.1 | 2.5 | 3 |  |  | 4 | 4.775 | 1 | https://www.mouser.com/datasheet/3/175/1/DMNH4026SSDQ.pdf
TK1R4S04PB | Toshiba | DPAK+ | 40 | 120 | No |  | 10 | 1.35 | 103 | 24 |  | 30 |  | 39 | 2.64 | 1.2 | https://www.mouser.com/datasheet/3/105/1/4ED7E8508E8DF7939F699D77C94349E33B40F5FCCC0694563DF63EE828BA7124.pdf
TK65S04N1L | Toshiba | DPAK+ | 40 | 65 | No |  | 10 | 4.3 | 39 | 7 |  | 9 |  | 11.5 | 3.39 | 1.2 | https://www.mouser.com/datasheet/3/105/1/F9DF81C56B072210464F76629D735EB43B140D6467D2133DA89D1DAAE6E2C954.pdf
IPD029N04NF2S | Infineon | PG-TO252-3 | 40 | 131 | No |  | 10 | 2.9 | 45 | 8.6 | 14 |  |  | 14 | 3.214285714 | 1.1 | https://www.mouser.com/datasheet/3/70/1/Infineon_IPD029N04NF2S_DataSheet_v02_00_EN.pdf
IPD50N04S3-08 | Infineon | PG-TO252-3-11 | 40 | 50 | No |  | 10 | 7.5 | 27 | 7 | 10 |  |  | 12 | 2.25 | 1.3 | https://www.mouser.com/datasheet/3/70/1/Infineon_IPD50N04S3_08_DS_v01_00_en.pdf
IPD50N04S4-08 | Infineon | PG-TO252-3-313 | 40 | 50 | No |  | 10 | 7.9 | 17.2 | 2.4 | 8 |  |  | 6.4 | 2.6875 | 1.3 | https://www.mouser.com/datasheet/3/70/1/Infineon_IPD50N04S4_08_DS_v01_00_en.pdf
IPD90N04S4L-04 | Infineon | PG-TO252-3-313 | 40 | 90 | No |  | 10 | 3.8 | 46 | 5 | 12 |  |  | 11 | 4.18 | 1.3 | https://www.mouser.com/datasheet/3/70/1/Infineon_IPD90N04S4L_04_DS_v01_00_en.pdf
TK65S04N1L | Toshiba | DPAK+ | 40 | 65 | No |  | 10 | 4.3 | 39 | 7 |  | 9 |  | 11.5 | 3.39 | 1.2 | https://www.mouser.com/datasheet/3/105/1/F9DF81C56B072210464F76629D735EB43B140D6467D2133DA89D1DAAE6E2C954.pdf
IPD90N03S4L-02 | Infineon | PG-TO252-3-11 | 30 | 90 | Yes | 16 | 10 | 2.2 | 110 | 14 | 22 |  |  | 25 | 4.4 | 1.3 | https://www.mouser.com/datasheet/3/70/1/Infineon_IPD90N03S4L_02_DS_v03_00_en.pdf
IPD50N04S4-08 | Infineon | PG-TO252-3-313 | 40 | 50 | No |  | 10 | 7.9 | 17.2 | 2.4 | 8 |  |  | 6.4 | 2.6875 | 1.3 | https://www.mouser.com/datasheet/3/70/1/Infineon_IPD50N04S4_08_DS_v01_00_en.pdf
IPD90N04S4-03 | Infineon | PG-TO252-3-313 | 40 | 90 | No |  | 10 | 3.2 | 51 | 7 | 24 |  |  | 19 | 2.68 | 1.3 | https://www.mouser.com/datasheet/3/70/1/Infineon-IPD90N04S4_03-DS-v01_00-en.pdf
IPD90N04S4-04 | Infineon | PG-TO252-3-313 | 40 | 90 | No |  | 10 | 4.1 | 33 | 5 | 16 |  |  | 13 | 2.54 | 1.3 | https://www.mouser.com/datasheet/3/70/1/Infineon_IPD90N04S4_04_DS_v01_00_en.pdf
TK100S04N1L | Toshiba | DPAK+ | 40 | 100 | No |  | 10 | 2.3 | 76 | 11 |  | 18 |  | 20 | 3.8 | 1.2 | https://www.mouser.com/datasheet/3/105/1/AEF06CA61D88E63BBEF217D36C29B50149EF6D7ED6A6E85EB5365CBBC20D88D6.pdf
IPD100N04S4-02 | Infineon | PG-TO252-3-313 | 40 | 100 | No |  | 10 | 2 | 91 | 12 | 39 |  |  | 31.5 | 2.888888889 | 1.3 | https://www.mouser.com/datasheet/3/70/1/Infineon-IPD100N04S4_02-DS-v01_00-en.pdf
IPD30N03S4L-14 | Infineon | PG-TO252-3-11 | 30 | 30 | Yes | 16 | 10 | 13.6 | 11 | 1.4 | 2.2 |  |  | 2.5 | 4.4 | 1.3 | https://www.mouser.com/datasheet/3/70/1/Infineon_IPD30N03S4L_14_DS_v02_01_en.pdf
IPD50N03S4L-06 | Infineon | PG-TO252-3-11 | 30 | 50 | Yes | 16 | 10 | 5.5 | 24 | 3 | 6 |  |  | 6 | 4 | 1.3 | https://www.mouser.com/datasheet/3/70/1/Infineon_IPD50N03S4L_06_DS_v01_01_en.pdf
IPD90N04S4-02 | Infineon | PG-TO252-3-313 | 40 | 90 | No |  | 10 | 2.4 | 91 | 12 | 39 |  |  | 31.5 | 2.888888889 | 1.3 | https://www.mouser.com/datasheet/3/70/1/Infineon_IPD90N04S4_02_DS_v01_00_en.pdf
IPD90N04S4-05 | Infineon | PG-TO252-3-313 | 40 | 86 | No |  | 10 | 5.2 | 29 | 4 | 14 |  |  | 11 | 2.636363636 | 1.3 | https://www.mouser.com/datasheet/3/70/1/Infineon-IPD90N04S4_05-DS-v01_00-en.pdf
IPD90N03S4L-02 | Infineon | PG-TO252-3-11 | 30 | 90 | Yes | 16 | 10 | 2.2 | 110 | 14 | 22 |  |  | 25 | 4.4 | 1.3 | https://www.mouser.com/datasheet/3/70/1/Infineon_IPD90N03S4L_02_DS_v03_00_en.pdf
TK15S04N1L | Toshiba | DPAK+ | 40 | 15 | No |  | 10 | 17.8 | 10 | 2 |  | 2 |  | 3 | 3.33 | 1.2 | https://www.mouser.com/datasheet/3/105/1/0285F1B20A2A6E5C043DFF1DD56BE878A5BD6AB206BA4715BDB658ED14904609.pdf
TK15S04N1L | Toshiba | DPAK+ | 40 | 15 | No |  | 10 | 17.8 | 10 | 2 |  | 2 |  | 3 | 3.33 | 1.2 | https://www.mouser.com/datasheet/3/105/1/0285F1B20A2A6E5C043DFF1DD56BE878A5BD6AB206BA4715BDB658ED14904609.pdf
IRFR7446PbF | International Rectifier | D-PAK | 40 | 120 | No |  | 10 | 3.9 | 65 | 22 | 18 |  |  | 31 | 2.09677 | 1.3 | https://www.mouser.com/datasheet/3/70/1/Infineon-IRFR7446-DataSheet-v01_01-EN.pdf
IPD023N04NF2S | Infineon | PG-TO252-3 | 40 | 143 | No |  | 10 | 2.3 | 68 | 13 | 21 |  |  | 20 | 3.4 | 1.1 | https://www.mouser.com/datasheet/3/70/1/Infineon_IPD023N04NF2S_DataSheet_v02_01_EN.pdf
NP90N04VLK | Renesas | TO-252 (MP-3ZP) | 40 | 90 | Yes | 20 | 10 | 2.8 | 68 | 11 | 17 |  |  | 19.5 | 3.487179487 | 1.5 | https://www.mouser.com/datasheet/3/1166/1/REN_r07ds1236ej0200_pomosfet_DST_20180524_1_1.pdf
IPD90N04S3-04 | Infineon | PG-TO252-3-11 | 40 | 90 | No |  | 10 | 3.6 | 60 | 15 | 23 |  |  | 26.5 | 2.264150943 | 1.3 | https://www.mouser.com/datasheet/3/70/1/Infineon_IPD90N04S3_04_DS_v01_00_en.pdf
IRFS7440PbF | International Rectifier | D2-Pak | 40 | 208 | No |  | 10 | 2.5 | 90 | 32 | 23 |  |  | 43.5 | 2.07 | 1.3 | https://www.mouser.com/datasheet/3/70/1/Infineon_IRFS7440_DataSheet_v01_01_EN.pdf
IPD100N04S4L-02 | Infineon | PG-TO252-3-313 | 40 | 100 | Yes | 20 | 10 | 1.9 | 126 | 13 | 28 |  |  | 27 | 4.666666667 | 1.3 | https://www.mouser.com/datasheet/3/70/1/Infineon-IPD100N04S4L-02-DS-v01_00-EN.pdf
NP90N04VDK | Renesas | TO-252 (MP-3ZP) | 40 | 90 | Yes | 20 | 10 | 2.8 | 68 | 11 | 17 |  |  | 19.5 | 3.487179487 | 1.5 | https://www.mouser.com/datasheet/3/1166/1/REN_r07ds1017ej0200-pomosfet_DST_20180524.pdf
IPD90N04S4-03 | Infineon | PG-TO252-3-313 | 40 | 90 | No |  | 10 | 3.2 | 51 | 7 | 24 |  |  | 19 | 2.68 | 1.3 | https://www.mouser.com/datasheet/3/70/1/Infineon-IPD90N04S4_03-DS-v01_00-en.pdf
TK100S04N1L | Toshiba | DPAK+ | 40 | 100 | No |  | 10 | 2.3 | 76 | 11 |  | 18 |  | 20 | 3.8 | 1.2 | https://www.mouser.com/datasheet/3/105/1/AEF06CA61D88E63BBEF217D36C29B50149EF6D7ED6A6E85EB5365CBBC20D88D6.pdf
TK3R1P04PL | Toshiba | DPAK | 40 | 58 | No |  | 10 | 3.1 | 60 | 11 |  | 14 |  | 19 | 3.16 | 1.5 | https://www.mouser.com/datasheet/3/105/1/2A5989E50A27FE6F1B9140002B8F7CE92F9B18872DCADAD4CE6D8001C5C9E913.pdf
IPD70N03S4L-04 | Infineon | PG-TO252-3-11 | 30 | 70 | Yes | 16 | 10 | 4.3 | 37 | 5 | 8 |  |  | 9 | 4.11 | 1.3 | https://www.mouser.com/datasheet/3/70/1/Infineon_IPD70N03S4L_04_DS_v02_01_EN.pdf
RJF0408JPD | Renesas | DPAK(S) | 40 | 30 | Yes | 16 | 10 | 30 | 0 | 0 |  |  |  | 0 | 0 | 0.9 | https://www.mouser.com/datasheet/3/1166/1/REN_r07ds1133ej0200_rjf0408jpd_DST_20150728_1.pdf
IRLS3034PbF | International Rectifier | D2Pak | 40 | 343 | Yes | 20 | 4.5 | 2 | 108 | 54 | 29 |  |  | 68.5 | 1.5766 | 1.3 | https://www.mouser.com/datasheet/3/70/1/Infineon-IRLS3034-DataSheet-v01_01-EN.pdf
IRLR3114ZPbF | International Rectifier | D-Pak | 40 | 130 | Yes | 16 | 4.5 | 6.5 | 40 | 18 | 12 |  |  | 24 | 1.67 | 1.3 | https://www.mouser.com/datasheet/3/70/1/Infineon_IRLR3114Z_DataSheet_v01_01_EN.pdf
IPD50N04S4-10 | Infineon | PG-TO252-3-313 | 40 | 50 | No |  | 10 | 9.3 | 14 | 2 | 6.8 |  |  | 5.4 | 2.5926 | 1.3 | https://www.mouser.com/datasheet/3/70/1/Infineon-IPD50N04S4_10-DS-v01_00-en.pdf
IPD30N03S4L-09 | Infineon | PG-TO252-3-11 | 30 | 30 | Yes | 16 | 10 | 9 | 15 | 2 | 4 |  |  | 4 | 3.75 | 1.3 | https://www.mouser.com/datasheet/3/70/1/Infineon_IPD30N03S4L_09_DS_v01_01_en.pdf
IPD90N04S4-05 | Infineon | PG-TO252-3-313 | 40 | 86 | No |  | 10 | 5.2 | 29 | 4 | 14 |  |  | 11 | 2.636363636 | 1.3 | https://www.mouser.com/datasheet/3/70/1/Infineon-IPD90N04S4_05-DS-v01_00-en.pdf
IPD50N04S4L-08 | Infineon | PG-TO252-3-313 | 40 | 50 | No |  | 10 | 7.3 | 23 | 2.6 | 5.8 |  |  | 5.5 | 4.181818182 | 1.3 | https://www.mouser.com/datasheet/3/70/1/Infineon_IPD50N04S4L_08_DataSheet_v01_10_EN.pdf
IPD50N04S4L-08 | Infineon | PG-TO252-3-313 | 40 | 50 | No |  | 10 | 7.3 | 23 | 2.6 | 5.8 |  |  | 5.5 | 4.181818182 | 1.3 | https://www.mouser.com/datasheet/3/70/1/Infineon_IPD50N04S4L_08_DataSheet_v01_10_EN.pdf
IPD75N04S4-06 | Infineon | PG-TO252-3-313 | 40 | 75 | No |  | 10 | 5.9 | 24.5 | 3.5 | 11.7 |  |  | 9.35 | 2.620320856 | 1.3 | https://www.mouser.com/datasheet/3/70/1/Infineon_IPD75N04S4_06_DS_v01_01_en.pdf
IPD036N04L G | Infineon | PG-TO252-3 | 40 | 90 | Yes | 20 | 10 | 3.6 | 59 | 6.1 | 14 | 7.4 |  | 13 | 4.54 | 1.2 | https://www.mouser.com/datasheet/3/70/1/Infineon_IPD036N04L_DS_v01_00_en.pdf
N0601N | Renesas | TO-263 | 60 | 100 | No |  | 10 | 4.2 | 133 | 38 | 38 |  |  | 57 | 2.333333333 | 1.5 | https://www.mouser.com/datasheet/3/1166/1/REN_r07ds0557ej0200_n0601n_DST_20200610_1.pdf
IPD70N03S4L-04 | Infineon | PG-TO252-3-11 | 30 | 70 | Yes | 16 | 10 | 4.3 | 37 | 5 | 8 |  |  | 9 | 4.11 | 1.3 | https://www.mouser.com/datasheet/3/70/1/Infineon_IPD70N03S4L_04_DS_v02_01_EN.pdf
IPD90N04S4L-04 | Infineon | PG-TO252-3-313 | 40 | 90 | No |  | 10 | 3.8 | 46 | 5 | 12 |  |  | 11 | 4.18 | 1.3 | https://www.mouser.com/datasheet/3/70/1/Infineon_IPD90N04S4L_04_DS_v01_00_en.pdf
IPD90N03S4L-03 | Infineon | PG-TO252-3-11 | 30 | 90 | Yes | 16 | 10 | 3.3 | 60 | 8 | 12 |  |  | 14 | 4.2857 | 1.3 | https://www.mouser.com/datasheet/3/70/1/Infineon-IPD90N03S4L_03-DS-v02_01-en.pdf
IRFR4104PbF | International Rectifier | D-Pak | 40 | 42 | No |  | 10 | 5.5 | 59 | 24 | 19 |  |  | 33.5 | 1.76 | 1.3 | https://www.mouser.com/datasheet/3/70/1/Infineon_IRFR4104_DataSheet_v01_01_EN.pdf
IRF40R207 | International Rectifier | D-Pak | 40 | 90 | No |  | 10 | 5.1 | 45 | 15 | 12 |  |  | 21 | 2.142857143 | 1.3 | https://www.mouser.com/datasheet/3/70/1/Infineon_IRF40R207_DataSheet_v01_01_EN.pdf
IPD80N04S3-06 | Infineon | PG-TO252-3-11 | 40 | 90 | No |  | 10 | 5.2 | 36 | 9 | 15 |  |  | 16.5 | 2.181818182 | 1.3 | https://www.mouser.com/datasheet/3/70/1/Infineon_IPD80N04S3_06_DS_v01_00_en.pdf
TK35S04K3L | Toshiba | DPAK+ | 40 | 35 | No |  | 10 | 10.3 | 28 | 10 | 18 |  |  | 19 | 1.473684211 | 1.2 | https://www.mouser.com/datasheet/3/105/1/39745A9E4DBB0ECA28888EF50B3BD7BA197CFE4921D8A68F0CE587FA184EEFA6.pdf
NP60N04VLK | Renesas | TO-252 (MP-3ZP) | 40 | 60 | Yes | 20 | 10 | 3.9 | 42 | 6 | 11 |  |  | 11.5 | 3.65 | 1.5 | https://www.mouser.com/datasheet/3/1166/1/REN_r07ds1246ej0200_pomosfet_DST_20180524_1.pdf
NP75N04VDK | Renesas | TO-252 (MP-3ZP) | 40 | 75 | Yes | 20 | 10 | 5.7 | 27 | 4 | 8 |  |  | 8 | 3.375 | 1.5 | https://www.mouser.com/datasheet/3/1166/1/REN_r07ds1015ej0200_pomosfet_DST_20180524_1.pdf
RJF0411JPD | Renesas | DPAK(S) | 40 | 34 | Yes | 16 | 10 | 37 | 15 | 4 | 3 |  |  | 5.5 | 2.73 | 0.96 | https://www.mouser.com/datasheet/3/1166/1/REN_r07ds1258ej0100_rjf0411jpd_DST_20150623.pdf
N0436N | Renesas | TO-252 | 40 | 56 | No |  | 10 | 4.7 | 62 | 20 | 16 |  |  | 28 | 2.21 | 1.5 | https://www.mouser.com/datasheet/3/1166/1/REN_r07ds1414ej0100_n0436n_DST_20190930_1.pdf
NP90N04VUK | Renesas | TO-252 (MP-3ZP) | 40 | 90 | No |  | 10 | 2.8 | 68 | 18 | 18 |  |  | 27 | 2.5185 | 1.5 | https://www.mouser.com/datasheet/3/1166/1/REN_r07ds0577ej0200_pomosfet_DST_20180524_1.pdf
NP60N04VUK | Renesas | TO-252 (MP-3ZP) | 40 | 60 | No |  | 10 | 3.85 | 42 | 11 | 11 |  |  | 16.5 | 2.54545 | 1.5 | https://www.mouser.com/datasheet/3/1166/1/REN_r07ds0576ej0200-pomosfet_DST_20180524.pdf
NP60N04VDK | Renesas | TO-252 | 40 | 60 | Yes | 20 | 10 | 3.85 | 42 | 6 | 11 |  |  | 11.5 | 3.652 | 1.5 | https://www.mouser.com/datasheet/3/1166/1/REN_r07ds1014ej0200_pomosfet_DST_20180524_1.pdf
IPD90N04S3-H4 | Infineon | PG-TO252-3-11 | 40 | 90 | No |  | 10 | 4.3 | 46 | 12 | 18 |  |  | 21 | 2.19 | 1.3 | https://www.mouser.com/datasheet/3/70/1/Infineon_IPD90N04S3_H4_DS_v01_00_en.pdf
IPD50N04S3-09 | Infineon | PG-TO252-3-11 | 40 | 50 | No |  | 10 | 9 | 20 | 5 | 8 |  |  | 9 | 2.22 | 1.3 | https://www.mouser.com/datasheet/3/70/1/Infineon_IPD50N04S3_09_DS_v01_01_en.pdf
IPD80N04S3-06 | Infineon | PG-TO252-3-11 | 40 | 90 | No |  | 10 | 5.2 | 36 | 9 | 15 |  |  | 16.5 | 2.181818182 | 1.3 | https://www.mouser.com/datasheet/3/70/1/Infineon_IPD80N04S3_06_DS_v01_00_en.pdf
P180FP4SNK | Shindengen | SC-83 similar FP | 40 | 180 | No |  | 10 | 1.15 | 160 | 35 | 50 |  |  | 60 | 2.67 | 1.2 | https://www.mouser.com/datasheet/3/335/1/shindengen_F072_14a.pdf.pdf
AUIRF4104 | Infineon | TO-220 | 40 | 120 | No |  | 10 | 5.5 | 68 | 27 | 21 |  |  | 37.5 | 1.813333333 | 1.3 | https://www.mouser.com/datasheet/3/70/1/auirf4104.pdf
AUIRFR4104 | Infineon | D-Pak | 40 | 119 | No |  | 10 | 5.5 | 59 | 24 | 19 |  |  | 33.5 | 1.76 | 1.3 | https://www.mouser.com/catalog/specsheets/infn-s-a0008053431-1.pdf
AUIRF1404S | Infineon | D2-Pak | 40 | 162 | No |  | 10 | 4 | 160 | 42 | 35 |  |  | 59.5 | 2.69 | 1.3 | https://www.mouser.com/datasheet/3/70/1/auirf1404s.pdf
IRFR4104PbF | International Rectifier | D-Pak | 40 | 42 | No |  | 10 | 5.5 | 59 | 24 | 19 |  |  | 33.5 | 1.76 | 1.3 | https://www.mouser.com/datasheet/3/70/1/Infineon_IRFR4104_DataSheet_v01_01_EN.pdf
IPD50N03S2-07 | Infineon | PG-TO252-3-11 | 30 | 50 | No |  | 10 | 7.3 | 52 | 27 | 11 |  |  | 32.5 | 1.6 | 1.3 | https://www.mouser.com/datasheet/3/70/1/Infineon_IPD50N03S2_07_DS_v01_00_en.pdf
AUIRFR8401 | Infineon | D-Pak | 40 | 100 | No |  | 10 | 4.25 | 42 | 14 | 12 |  |  | 20 | 2.1 | 1.3 | https://www.mouser.com/datasheet/3/70/1/Infineon_AUIRFR8401_DS_v01_01_EN.pdf
IPD50N03S2L-06 | Infineon | PG-TO252-3-11 | 30 | 50 | Yes | 20 | 10 | 6.4 | 50 | 16 | 6 |  |  | 19 | 2.63 | 1.3 | https://www.mouser.com/datasheet/3/70/1/Infineon_IPD50N03S2L_06_DS_v01_00_en.pdf
AUIRFR8403 | Infineon | D-Pak | 40 | 127 | No |  | 10 | 3.1 | 66 | 22 | 18 |  |  | 31 | 2.13 | 1.3 | https://www.mouser.com/datasheet/3/70/1/Infineon-AUIRFR8403-DS-v01_01-EN.pdf
IRF4104SPbF | International Rectifier | D2Pak | 40 | 75 | No |  | 10 | 5.5 | 68 | 27 | 21 |  |  | 37.5 | 1.813333333 | 1.3 | https://www.mouser.com/datasheet/3/70/1/Infineon-IRF4104-DataSheet-v01_01-EN.pdf
AUIRFS8403 | International Rectifier | D2Pak | 40 | 123 | No |  | 10 | 3.3 | 62 | 20 | 16 |  |  | 28 | 2.21 | 1.3 | https://www.mouser.com/datasheet/3/70/1/auirfs8403.pdf
IRFR3504ZPbF | International Rectifier | D-Pak | 40 | 42 | No |  | 10 | 9 | 30 | 12 | 9.6 |  |  | 16.8 | 1.7857 | 1.3 | https://www.mouser.com/datasheet/3/70/1/Infineon_IRFR3504Z_DataSheet_v01_01_EN.pdf
IRL1404SPbF | International Rectifier | D2Pak | 40 | 160 | Yes | 20 | 10 | 4 | 140 | 60 | 48 |  |  | 84 | 1.666666667 | 1.3 | https://www.mouser.com/datasheet/3/70/1/Infineon-IRL1404S-DataSheet-v01_01-EN.pdf
IRLR7821PbF | International Rectifier | D-Pak | 30 | 65 | Yes | 20 | 4.5 | 12.5 | 10 | 2.5 |  | 2 | 1.2 | 3.7 | 2.7 | 1 | https://www.mouser.com/datasheet/3/70/1/Infineon_IRLR7821_DataSheet_v01_01_EN.pdf
PJQ5540V-AU | PANJIT | DFN5060X-8L | 40 | 174 | No |  | 10 | 2.1 | 63 | 11 | 19 |  |  | 20.5 | 3.073170732 | 1.3 | https://www.mouser.com/datasheet/3/3736/1/34C9EC0CE6CAB485AF871EC5193847F90A7F02E1F5D76B195AABD188C34C89CE.pdf
ISCH57N04NM7VSC | Infineon | PG-WSON-8 | 40 | 443 | No |  | 10 | 0.57 | 112 | 20 | 36 |  |  | 35 | 3.2 | 1 | https://www.mouser.com/datasheet/3/70/1/infineon_isch57n04nm7vsc_datasheet_en.pdf
IAUCN04S7N037G | Infineon | PG-THSOG-4-1 | 40 | 91 | No |  | 10 | 3.65 | 16 | 3.5 | 4.9 |  |  | 5.95 | 2.68907563 | 1 | https://www.mouser.com/datasheet/3/70/1/infineon_iaucn04s7n037g_datasheet_en.pdf
IAUCN04S7N019G | Infineon | PG-THSOG-4-1 | 40 | 147 | No |  | 10 | 1.95 | 30 | 6.2 | 8.9 |  |  | 10.65 | 2.816901408 | 1 | https://www.mouser.com/datasheet/3/70/1/infineon_iaucn04s7n019g_datasheet_en.pdf
IAUCN04S7N047G | Infineon | PG-THSOG-4-1 | 40 | 79 | No |  | 10 | 4.7 | 13 | 2.8 | 3.8 |  |  | 4.7 | 2.765957447 | 1 | https://www.mouser.com/datasheet/3/70/1/infineon_iaucn04s7n047g_datasheet_en.pdf
IAUCN04S7N027G | Infineon | PG-THSOG-4-1 | 40 | 117 | No |  | 10 | 2.67 | 23 | 4.8 | 6.8 |  |  | 8.2 | 2.804878049 | 1 | https://www.mouser.com/datasheet/3/70/1/infineon_iaucn04s7n027g_datasheet_en.pdf
IAUCN04S7L042G | Infineon | PG-THSOG-4-1 | 40 | 77 | Yes | 16 | 10 | 4.4 | 15 | 2.7 | 2.8 |  |  | 4.1 | 3.658536585 | 1 | https://www.mouser.com/catalog/specsheets/Infineon_3-23-2026_IAUCN04S7L042G.pdf
IAUCN04S7N015G | Infineon | PG-THSOG-4-1 | 40 | 184 | No |  | 10 | 1.53 | 41 | 8.1 | 11.6 |  |  | 13.9 | 2.949640288 | 1 | https://www.mouser.com/datasheet/3/70/1/infineon_iaucn04s7n015g_datasheet_en.pdf
NP50N04YUK | Renesas | 8-pin HSON | 40 | 50 | No |  | 10 | 4.8 | 38 | 10 | 10 |  |  | 15 | 2.533333333 | 1.5 | https://www.mouser.com/datasheet/3/1166/1/REN_r07ds1003ej0200-pomosfet_DST_20180524.pdf
MRF177 | MACOM | CASE 744A-01 | 65 | 16 | No |  | 10 | 466.67 | 1 | 0.1 | 0.9 |  |  | 0.55 | 1.82 | 1 | https://www.mouser.com/datasheet/3/829/1/MRF177.pdf
PJQ4546VP-AU | PANJIT | DFN3333-8L | 40 | 61 | No |  | 10 | 6.3 | 23 | 6 | 5 |  |  | 8.5 | 2.705882353 | 1.3 | https://www.mouser.com/datasheet/3/3736/1/PJQ4546VP_AU.pdf
ISCH92N04NM7VSC | Infineon | PG-WSON-8 | 40 | 289 | No |  | 10 | 0.92 | 65 | 12 | 22 | 13 |  | 22 | 2.954545455 | 1 | https://www.mouser.com/datasheet/3/70/1/infineon_isch92n04nm7vsc_datasheet_en.pdf
MRF150 | MACOM | CASE 211-11, STYLE 2 | 125 | 16 | No |  | 10 | 500 | 6 | 2 | 3.6 |  |  | 3.8 | 1.58 | 1 | https://www.mouser.com/datasheet/3/829/1/MRF150.pdf
PJQ4548VP-AU | PANJIT | DFN3333-8L | 40 | 40 | No |  | 10 | 10.4 | 9.5 | 2.6 | 4.2 |  |  | 4.7 | 2.021276596 | 1.3 | https://www.mouser.com/datasheet/3/3736/1/PJQ4548VP_AU.pdf
MRF148A | MACOM | CASE 211-07, STYLE 2 | 120 | 6 | No |  | 10 | 2000 | 0.62 | 0.15 | 0.59 |  |  | 0.445 | 1.39 | 1 | https://www.mouser.com/datasheet/3/829/1/MRF148A.pdf
PJQ5948V-AU | PANJIT Semiconductor | DFN5060B-8L | 40 | 35 | No |  | 10 | 13.4 | 9.5 | 2.6 | 4.2 |  |  | 4.7 | 2.021276596 | 1.3 | https://www.mouser.com/datasheet/3/3736/1/PJQ5948V_AU.pdf
IAUCN04S7N006T | Infineon | PG-LHDSO-10-3 | 40 | 425 | No |  | 10 | 0.64 | 112 | 24 | 31 |  |  | 39.5 | 2.835443038 | 0.95 | https://www.mouser.com/catalog/specsheets/Infineon_04-30-2025_IAUCN04S7N006T-Data-Sheet-10-Infineon.pdf
PJQ5544V-AU | PANJIT | DFN5060-8L | 40 | 120 | No |  | 10 | 3.6 | 34 | 4 | 11 |  |  | 9.5 | 3.578947368 | 1.3 | https://www.mouser.com/datasheet/3/3736/1/PJQ5544V_AU.pdf
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
