Hrishikesh-Acharyya/Synchronous_buck_PMIC/Build/stat_notel.txt

 /----------------------------------------------------------------------------\
 |  yosys -- Yosys Open SYnthesis Suite                                       |
 |  Copyright (C) 2012 - 2026  Claire Xenia Wolf <claire@yosyshq.com>         |
 |  Distributed under an ISC-like license, type "license" to see terms        |
 \----------------------------------------------------------------------------/
 Yosys 0.70+240 (git sha1 5cdfd1241, Release, Clang /usr/bin/clang++ 21.1.8)

-- Running command `read_verilog ../Build/pmic_full.v;              chparam -set TELEMETRY_EN 0 pmic_top;              hierarchy -top pmic_top;              synth -top pmic_top -flatten;              tee -o ../Build/stat_notel_summary.txt stat' --

1. Executing Verilog-2005 frontend: ../Build/pmic_full.v
Parsing Verilog input from `../Build/pmic_full.v' to AST representation.
Generating RTLIL representation for module `\reset_sync'.
Generating RTLIL representation for module `\input_sync'.
Generating RTLIL representation for module `\input_debounce'.
Generating RTLIL representation for module `\soft_start'.
Generating RTLIL representation for module `\pwm_mask'.
Generating RTLIL representation for module `\fault_arbiter'.
Generating RTLIL representation for module `\hiccup_timer'.
Generating RTLIL representation for module `\strike_counter'.
Generating RTLIL representation for module `\pgood_gen'.
Generating RTLIL representation for module `\timestamp'.
Generating RTLIL representation for module `\fault_LED'.
Generating RTLIL representation for module `\pwm_stats'.
Generating RTLIL representation for module `\reg_file'.
Generating RTLIL representation for module `\spi_slave'.
Generating RTLIL representation for module `\fault_cause'.
Generating RTLIL representation for module `\supervisor'.
Generating RTLIL representation for module `\pmic_top'.
Successfully finished Verilog frontend.
Parameter \TELEMETRY_EN = 0

2. Executing AST frontend in derive mode using pre-parsed AST for module `\pmic_top'.
Parameter \TELEMETRY_EN = 0
Generating RTLIL representation for module `$paramod\pmic_top\TELEMETRY_EN=s32'00000000000000000000000000000000'.

3. Executing HIERARCHY pass (managing design hierarchy).

3.1. Analyzing design hierarchy..
Top module:  \pmic_top
Used module:     \fault_LED
Used module:     \pgood_gen
Used module:     \pwm_mask
Used module:     \soft_start
Used module:     \strike_counter
Used module:     \hiccup_timer
Used module:     \fault_arbiter
Used module:     \supervisor
Used module:     \input_debounce
Used module:     \input_sync
Used module:     \reset_sync
Parameter \ASSERT_CLKS = 1000000
Parameter \RELEASE_CLKS = 1000000
Parameter \RESET_VALUE = 1'0

3.2. Executing AST frontend in derive mode using pre-parsed AST for module `\input_debounce'.
Parameter \ASSERT_CLKS = 1000000
Parameter \RELEASE_CLKS = 1000000
Parameter \RESET_VALUE = 1'0
Generating RTLIL representation for module `$paramod$51f53c3c7e657987b680eb6df78b01f2c4800581\input_debounce'.
Parameter \RESET_VALUE = 1'1

3.3. Executing AST frontend in derive mode using pre-parsed AST for module `\input_sync'.
Parameter \RESET_VALUE = 1'1
Generating RTLIL representation for module `$paramod\input_sync\RESET_VALUE=1'1'.
Parameter \RESET_VALUE = 1'1
Found cached RTLIL representation for module `$paramod\input_sync\RESET_VALUE=1'1'.
Parameter \RESET_VALUE = 1'1
Found cached RTLIL representation for module `$paramod\input_sync\RESET_VALUE=1'1'.
Parameter \RESET_VALUE = 1'1
Found cached RTLIL representation for module `$paramod\input_sync\RESET_VALUE=1'1'.

3.4. Analyzing design hierarchy..
Top module:  \pmic_top
Used module:     \fault_LED
Used module:     \pgood_gen
Used module:     \pwm_mask
Used module:     \soft_start
Used module:     \strike_counter
Used module:     \hiccup_timer
Used module:     \fault_arbiter
Used module:     \supervisor
Used module:     \input_debounce
Used module:     $paramod$51f53c3c7e657987b680eb6df78b01f2c4800581\input_debounce
Used module:     \input_sync
Used module:     $paramod\input_sync\RESET_VALUE=1'1
Used module:     \reset_sync

3.5. Analyzing design hierarchy..
Top module:  \pmic_top
Used module:     \fault_LED
Used module:     \pgood_gen
Used module:     \pwm_mask
Used module:     \soft_start
Used module:     \strike_counter
Used module:     \hiccup_timer
Used module:     \fault_arbiter
Used module:     \supervisor
Used module:     \input_debounce
Used module:     $paramod$51f53c3c7e657987b680eb6df78b01f2c4800581\input_debounce
Used module:     \input_sync
Used module:     $paramod\input_sync\RESET_VALUE=1'1
Used module:     \reset_sync
Removing unused module `\fault_cause'.
Removing unused module `\spi_slave'.
Removing unused module `\reg_file'.
Removing unused module `\pwm_stats'.
Removing unused module `\timestamp'.
Removed 5 unused modules.

4. Executing SYNTH pass.

4.1. Executing HIERARCHY pass (managing design hierarchy).

4.1.1. Analyzing design hierarchy..
Top module:  \pmic_top
Used module:     \fault_LED
Used module:     \pgood_gen
Used module:     \pwm_mask
Used module:     \soft_start
Used module:     \strike_counter
Used module:     \hiccup_timer
Used module:     \fault_arbiter
Used module:     \supervisor
Used module:     \input_debounce
Used module:     $paramod$51f53c3c7e657987b680eb6df78b01f2c4800581\input_debounce
Used module:     \input_sync
Used module:     $paramod\input_sync\RESET_VALUE=1'1
Used module:     \reset_sync

4.1.2. Analyzing design hierarchy..
Top module:  \pmic_top
Used module:     \fault_LED
Used module:     \pgood_gen
Used module:     \pwm_mask
Used module:     \soft_start
Used module:     \strike_counter
Used module:     \hiccup_timer
Used module:     \fault_arbiter
Used module:     \supervisor
Used module:     \input_debounce
Used module:     $paramod$51f53c3c7e657987b680eb6df78b01f2c4800581\input_debounce
Used module:     \input_sync
Used module:     $paramod\input_sync\RESET_VALUE=1'1
Used module:     \reset_sync
Removed 0 unused modules.

4.2. Executing PROC pass (convert processes to netlists).

4.2.1. Executing PROC_CLEAN pass (remove empty switches from decision trees).
Found and cleaned up 1 empty switch in `$paramod$51f53c3c7e657987b680eb6df78b01f2c4800581\input_debounce.$../Build/pmic_full.v:87$proc$710'.
Found and cleaned up 1 empty switch in `\supervisor.$../Build/pmic_full.v:1789$proc$668'.
Found and cleaned up 1 empty switch in `\supervisor.$../Build/pmic_full.v:1781$proc$664'.
Found and cleaned up 1 empty switch in `\supervisor.$../Build/pmic_full.v:1769$proc$663'.
Found and cleaned up 1 empty switch in `\supervisor.$../Build/pmic_full.v:1732$proc$639'.
Found and cleaned up 1 empty switch in `\supervisor.$../Build/pmic_full.v:1722$proc$635'.
Found and cleaned up 1 empty switch in `\fault_LED.$../Build/pmic_full.v:676$proc$217'.
Found and cleaned up 1 empty switch in `\pgood_gen.$../Build/pmic_full.v:572$proc$195'.
Found and cleaned up 1 empty switch in `\pgood_gen.$../Build/pmic_full.v:556$proc$185'.
Found and cleaned up 1 empty switch in `\strike_counter.$../Build/pmic_full.v:486$proc$163'.
Found and cleaned up 1 empty switch in `\hiccup_timer.$../Build/pmic_full.v:413$proc$150'.
Found and cleaned up 1 empty switch in `\fault_arbiter.$../Build/pmic_full.v:371$proc$146'.
Found and cleaned up 1 empty switch in `\fault_arbiter.$../Build/pmic_full.v:366$proc$145'.
Found and cleaned up 1 empty switch in `\fault_arbiter.$../Build/pmic_full.v:361$proc$142'.
Found and cleaned up 1 empty switch in `\fault_arbiter.$../Build/pmic_full.v:356$proc$137'.
Found and cleaned up 1 empty switch in `\fault_arbiter.$../Build/pmic_full.v:299$proc$64'.
Found and cleaned up 1 empty switch in `\soft_start.$../Build/pmic_full.v:161$proc$30'.
Found and cleaned up 1 empty switch in `\input_debounce.$../Build/pmic_full.v:87$proc$11'.
Cleaned up 18 empty switches.

4.2.2. Executing PROC_RMDEAD pass (remove dead branches from decision trees).
Marked 1 switch rules as full_case in process $../Build/pmic_full.v:101$proc$718 in module $paramod$51f53c3c7e657987b680eb6df78b01f2c4800581\input_debounce.
Marked 2 switch rules as full_case in process $../Build/pmic_full.v:92$proc$712 in module $paramod$51f53c3c7e657987b680eb6df78b01f2c4800581\input_debounce.
Removed 1 dead cases from process $../Build/pmic_full.v:1769$proc$663 in module supervisor.
Removed 1 dead cases from process $../Build/pmic_full.v:1732$proc$639 in module supervisor.
Marked 8 switch rules as full_case in process $../Build/pmic_full.v:1732$proc$639 in module supervisor.
Marked 1 switch rules as full_case in process $../Build/pmic_full.v:1727$proc$637 in module supervisor.
Marked 1 switch rules as full_case in process $../Build/pmic_full.v:705$proc$234 in module fault_LED.
Marked 1 switch rules as full_case in process $../Build/pmic_full.v:700$proc$232 in module fault_LED.
Marked 3 switch rules as full_case in process $../Build/pmic_full.v:691$proc$228 in module fault_LED.
Marked 1 switch rules as full_case in process $../Build/pmic_full.v:686$proc$226 in module fault_LED.
Marked 1 switch rules as full_case in process $../Build/pmic_full.v:681$proc$221 in module fault_LED.
Marked 2 switch rules as full_case in process $../Build/pmic_full.v:665$proc$212 in module fault_LED.
Marked 1 switch rules as full_case in process $../Build/pmic_full.v:38$proc$725 in module $paramod\input_sync\RESET_VALUE=1'1.
Marked 3 switch rules as full_case in process $../Build/pmic_full.v:561$proc$188 in module pgood_gen.
Marked 1 switch rules as full_case in process $../Build/pmic_full.v:551$proc$183 in module pgood_gen.
Marked 3 switch rules as full_case in process $../Build/pmic_full.v:504$proc$174 in module strike_counter.
Marked 2 switch rules as full_case in process $../Build/pmic_full.v:492$proc$168 in module strike_counter.
Marked 1 switch rules as full_case in process $../Build/pmic_full.v:477$proc$161 in module strike_counter.
Marked 3 switch rules as full_case in process $../Build/pmic_full.v:418$proc$154 in module hiccup_timer.
Marked 3 switch rules as full_case in process $../Build/pmic_full.v:331$proc$80 in module fault_arbiter.
Marked 2 switch rules as full_case in process $../Build/pmic_full.v:308$proc$67 in module fault_arbiter.
Marked 1 switch rules as full_case in process $../Build/pmic_full.v:294$proc$62 in module fault_arbiter.
Marked 1 switch rules as full_case in process $../Build/pmic_full.v:244$proc$51 in module pwm_mask.
Marked 3 switch rules as full_case in process $../Build/pmic_full.v:225$proc$47 in module pwm_mask.
Marked 5 switch rules as full_case in process $../Build/pmic_full.v:166$proc$33 in module soft_start.
Marked 1 switch rules as full_case in process $../Build/pmic_full.v:156$proc$28 in module soft_start.
Marked 1 switch rules as full_case in process $../Build/pmic_full.v:101$proc$19 in module input_debounce.
Marked 2 switch rules as full_case in process $../Build/pmic_full.v:92$proc$13 in module input_debounce.
Marked 1 switch rules as full_case in process $../Build/pmic_full.v:38$proc$5 in module input_sync.
Marked 1 switch rules as full_case in process $../Build/pmic_full.v:18$proc$3 in module reset_sync.
Marked 1 switch rules as full_case in process $../Build/pmic_full.v:13$proc$1 in module reset_sync.
Removed a total of 2 dead cases.

4.2.3. Executing PROC_PRUNE pass (remove redundant assignments in processes).
Removed 23 redundant assignments.
Promoted 50 assignments to connections.

4.2.4. Executing PROC_INIT pass (extract init attributes).

4.2.5. Executing PROC_ARST pass (detect async resets in processes).
Found async reset \rst_n in `$paramod$51f53c3c7e657987b680eb6df78b01f2c4800581\input_debounce.$../Build/pmic_full.v:101$proc$718'.
Found async reset \rst_n in `$paramod$51f53c3c7e657987b680eb6df78b01f2c4800581\input_debounce.$../Build/pmic_full.v:92$proc$712'.
Found async reset \rst_n in `\supervisor.$../Build/pmic_full.v:1727$proc$637'.
Found async reset \rst_n in `\fault_LED.$../Build/pmic_full.v:705$proc$234'.
Found async reset \rst_n in `\fault_LED.$../Build/pmic_full.v:700$proc$232'.
Found async reset \rst_n in `\fault_LED.$../Build/pmic_full.v:691$proc$228'.
Found async reset \rst_n in `\fault_LED.$../Build/pmic_full.v:686$proc$226'.
Found async reset \rst_n in `\fault_LED.$../Build/pmic_full.v:681$proc$221'.
Found async reset \rst_n in `\fault_LED.$../Build/pmic_full.v:665$proc$212'.
Found async reset \rst_n in `$paramod\input_sync\RESET_VALUE=1'1.$../Build/pmic_full.v:38$proc$725'.
Found async reset \rst_n in `\pgood_gen.$../Build/pmic_full.v:561$proc$188'.
Found async reset \rst_n in `\pgood_gen.$../Build/pmic_full.v:551$proc$183'.
Found async reset \rst_n in `\strike_counter.$../Build/pmic_full.v:504$proc$174'.
Found async reset \rst_n in `\strike_counter.$../Build/pmic_full.v:492$proc$168'.
Found async reset \rst_n in `\strike_counter.$../Build/pmic_full.v:477$proc$161'.
Found async reset \rst_n in `\hiccup_timer.$../Build/pmic_full.v:418$proc$154'.
Found async reset \rst_n in `\fault_arbiter.$../Build/pmic_full.v:331$proc$80'.
Found async reset \rst_n in `\fault_arbiter.$../Build/pmic_full.v:308$proc$67'.
Found async reset \rst_n in `\fault_arbiter.$../Build/pmic_full.v:294$proc$62'.
Found async reset \rst_n in `\pwm_mask.$../Build/pmic_full.v:244$proc$51'.
Found async reset \rst_n in `\pwm_mask.$../Build/pmic_full.v:225$proc$47'.
Found async reset \rst_n in `\soft_start.$../Build/pmic_full.v:166$proc$33'.
Found async reset \rst_n in `\soft_start.$../Build/pmic_full.v:156$proc$28'.
Found async reset \rst_n in `\input_debounce.$../Build/pmic_full.v:101$proc$19'.
Found async reset \rst_n in `\input_debounce.$../Build/pmic_full.v:92$proc$13'.
Found async reset \rst_n in `\input_sync.$../Build/pmic_full.v:38$proc$5'.
Found async reset \rst_n_enter in `\reset_sync.$../Build/pmic_full.v:18$proc$3'.
Found async reset \rst_n_enter in `\reset_sync.$../Build/pmic_full.v:13$proc$1'.

4.2.6. Executing PROC_ROM pass (convert switches to ROMs).
Converted 0 switches.
<suppressed ~43 debug messages>

4.2.7. Executing PROC_MUX pass (convert decision trees to multiplexers).
Creating decoders for process `$paramod$51f53c3c7e657987b680eb6df78b01f2c4800581\input_debounce.$../Build/pmic_full.v:106$proc$724'.
Creating decoders for process `$paramod$51f53c3c7e657987b680eb6df78b01f2c4800581\input_debounce.$../Build/pmic_full.v:101$proc$718'.
     1/1: $0\flag_out[0:0]
Creating decoders for process `$paramod$51f53c3c7e657987b680eb6df78b01f2c4800581\input_debounce.$../Build/pmic_full.v:92$proc$712'.
     1/1: $0\disagree_counter[19:0]
Creating decoders for process `$paramod$51f53c3c7e657987b680eb6df78b01f2c4800581\input_debounce.$../Build/pmic_full.v:87$proc$710'.
Creating decoders for process `\pmic_top.$../Build/pmic_full.v:2311$proc$705'.
Creating decoders for process `\supervisor.$../Build/pmic_full.v:1794$proc$678'.
Creating decoders for process `\supervisor.$../Build/pmic_full.v:1789$proc$668'.
Creating decoders for process `\supervisor.$../Build/pmic_full.v:1781$proc$664'.
Creating decoders for process `\supervisor.$../Build/pmic_full.v:1769$proc$663'.
     1/1: $1\en_from_state[0:0]
Creating decoders for process `\supervisor.$../Build/pmic_full.v:1732$proc$639'.
     1/9: $9\next_state[1:0]
     2/9: $8\next_state[1:0]
     3/9: $7\next_state[1:0]
     4/9: $6\next_state[1:0]
     5/9: $5\next_state[1:0]
     6/9: $4\next_state[1:0]
     7/9: $3\next_state[1:0]
     8/9: $2\next_state[1:0]
     9/9: $1\next_state[1:0]
Creating decoders for process `\supervisor.$../Build/pmic_full.v:1727$proc$637'.
     1/1: $0\state[1:0]
Creating decoders for process `\supervisor.$../Build/pmic_full.v:1722$proc$635'.
Creating decoders for process `\fault_LED.$../Build/pmic_full.v:710$proc$236'.
Creating decoders for process `\fault_LED.$../Build/pmic_full.v:705$proc$234'.
     1/1: $0\Red_LED3[0:0]
Creating decoders for process `\fault_LED.$../Build/pmic_full.v:700$proc$232'.
     1/1: $0\Red_LED2[0:0]
Creating decoders for process `\fault_LED.$../Build/pmic_full.v:691$proc$228'.
     1/1: $0\Red_LED1[0:0]
Creating decoders for process `\fault_LED.$../Build/pmic_full.v:686$proc$226'.
     1/1: $0\pgood_LED[0:0]
Creating decoders for process `\fault_LED.$../Build/pmic_full.v:681$proc$221'.
     1/1: $0\Green_LED[0:0]
Creating decoders for process `\fault_LED.$../Build/pmic_full.v:676$proc$217'.
Creating decoders for process `\fault_LED.$../Build/pmic_full.v:665$proc$212'.
     1/2: $0\blink_counter[22:0]
     2/2: $0\blink[0:0]
Creating decoders for process `$paramod\input_sync\RESET_VALUE=1'1.$../Build/pmic_full.v:38$proc$725'.
     1/2: $0\sync_out[0:0]
     2/2: $0\meta_ff[0:0]
Creating decoders for process `\pgood_gen.$../Build/pmic_full.v:577$proc$199'.
Creating decoders for process `\pgood_gen.$../Build/pmic_full.v:572$proc$195'.
Creating decoders for process `\pgood_gen.$../Build/pmic_full.v:561$proc$188'.
     1/1: $0\qualify_counter[11:0]
Creating decoders for process `\pgood_gen.$../Build/pmic_full.v:556$proc$185'.
Creating decoders for process `\pgood_gen.$../Build/pmic_full.v:551$proc$183'.
     1/1: $0\pwm_sync_d[0:0]
Creating decoders for process `\strike_counter.$../Build/pmic_full.v:515$proc$180'.
Creating decoders for process `\strike_counter.$../Build/pmic_full.v:504$proc$174'.
     1/1: $0\clean_counter[18:0]
Creating decoders for process `\strike_counter.$../Build/pmic_full.v:492$proc$168'.
     1/2: $0\latch_assert[0:0]
     2/2: $0\strike_level[1:0]
Creating decoders for process `\strike_counter.$../Build/pmic_full.v:486$proc$163'.
Creating decoders for process `\strike_counter.$../Build/pmic_full.v:477$proc$161'.
     1/2: $0\pwm_sync_d[0:0]
     2/2: $0\hiccup_active_d[0:0]
Creating decoders for process `\hiccup_timer.$../Build/pmic_full.v:433$proc$159'.
Creating decoders for process `\hiccup_timer.$../Build/pmic_full.v:418$proc$154'.
     1/2: $0\cool_counter[21:0]
     2/2: $0\hiccup_done[0:0]
Creating decoders for process `\hiccup_timer.$../Build/pmic_full.v:413$proc$150'.
Creating decoders for process `\fault_arbiter.$../Build/pmic_full.v:376$proc$147'.
Creating decoders for process `\fault_arbiter.$../Build/pmic_full.v:371$proc$146'.
Creating decoders for process `\fault_arbiter.$../Build/pmic_full.v:366$proc$145'.
Creating decoders for process `\fault_arbiter.$../Build/pmic_full.v:361$proc$142'.
Creating decoders for process `\fault_arbiter.$../Build/pmic_full.v:356$proc$137'.
Creating decoders for process `\fault_arbiter.$../Build/pmic_full.v:331$proc$80'.
     1/34: $3\sv2v_cast_5BB5F$func$../Build/pmic_full.v:344$60.$result[31:0]$128
     2/34: $3\sv2v_cast_5BB5F$func$../Build/pmic_full.v:344$60.inp[31:0]$129
     3/34: $3\sv2v_cast_40C54$func$../Build/pmic_full.v:343$59.$result[5:0]$126
     4/34: $3\sv2v_cast_40C54$func$../Build/pmic_full.v:343$59.inp[5:0]$127
     5/34: $3\sv2v_cast_40C54$func$../Build/pmic_full.v:343$58.$result[5:0]$124
     6/34: $3\sv2v_cast_40C54$func$../Build/pmic_full.v:343$58.inp[5:0]$125
     7/34: $2\sv2v_cast_CCA05$func$../Build/pmic_full.v:340$57.$result[15:0]$111
     8/34: $2\sv2v_cast_CCA05$func$../Build/pmic_full.v:340$57.inp[15:0]$112
     9/34: $2\sv2v_cast_7CA3E$func$../Build/pmic_full.v:339$56.$result[4:0]$109
    10/34: $2\sv2v_cast_7CA3E$func$../Build/pmic_full.v:339$56.inp[4:0]$110
    11/34: $2\sv2v_cast_7CA3E$func$../Build/pmic_full.v:339$55.$result[4:0]$107
    12/34: $2\sv2v_cast_7CA3E$func$../Build/pmic_full.v:339$55.inp[4:0]$108
    13/34: $2\sv2v_cast_5BB5F$func$../Build/pmic_full.v:344$60.inp[31:0]$118
    14/34: $2\sv2v_cast_5BB5F$func$../Build/pmic_full.v:344$60.$result[31:0]$117
    15/34: $2\sv2v_cast_40C54$func$../Build/pmic_full.v:343$59.inp[5:0]$116
    16/34: $2\sv2v_cast_40C54$func$../Build/pmic_full.v:343$59.$result[5:0]$115
    17/34: $2\sv2v_cast_40C54$func$../Build/pmic_full.v:343$58.inp[5:0]$114
    18/34: $2\sv2v_cast_40C54$func$../Build/pmic_full.v:343$58.$result[5:0]$113
    19/34: $1\sv2v_cast_5BB5F$func$../Build/pmic_full.v:344$60.inp[31:0]$105
    20/34: $1\sv2v_cast_5BB5F$func$../Build/pmic_full.v:344$60.$result[31:0]$104
    21/34: $1\sv2v_cast_40C54$func$../Build/pmic_full.v:343$59.inp[5:0]$103
    22/34: $1\sv2v_cast_40C54$func$../Build/pmic_full.v:343$59.$result[5:0]$102
    23/34: $1\sv2v_cast_40C54$func$../Build/pmic_full.v:343$58.inp[5:0]$101
    24/34: $1\sv2v_cast_40C54$func$../Build/pmic_full.v:343$58.$result[5:0]$100
    25/34: $1\sv2v_cast_CCA05$func$../Build/pmic_full.v:340$57.inp[15:0]$99
    26/34: $1\sv2v_cast_CCA05$func$../Build/pmic_full.v:340$57.$result[15:0]$98
    27/34: $1\sv2v_cast_7CA3E$func$../Build/pmic_full.v:339$56.inp[4:0]$97
    28/34: $1\sv2v_cast_7CA3E$func$../Build/pmic_full.v:339$56.$result[4:0]$96
    29/34: $1\sv2v_cast_7CA3E$func$../Build/pmic_full.v:339$55.inp[4:0]$95
    30/34: $1\sv2v_cast_7CA3E$func$../Build/pmic_full.v:339$55.$result[4:0]$94
    31/34: $0\fault_count_ss[5:0]
    32/34: $0\fault_count_run[4:0]
    33/34: $0\fault_shifter_RUN[15:0]
    34/34: $0\fault_shifter_SS[31:0]
Creating decoders for process `\fault_arbiter.$../Build/pmic_full.v:308$proc$67'.
     1/5: $0\cp_delay[4:0]
     2/5: $2\sv2v_cast_A4FBD$func$../Build/pmic_full.v:314$54.inp[4:0]$77
     3/5: $2\sv2v_cast_A4FBD$func$../Build/pmic_full.v:314$54.$result[4:0]$76
     4/5: $1\sv2v_cast_A4FBD$func$../Build/pmic_full.v:314$54.inp[4:0]$72
     5/5: $1\sv2v_cast_A4FBD$func$../Build/pmic_full.v:314$54.$result[4:0]$71
Creating decoders for process `\fault_arbiter.$../Build/pmic_full.v:299$proc$64'.
Creating decoders for process `\fault_arbiter.$../Build/pmic_full.v:294$proc$62'.
     1/1: $0\pwm_sync_d[0:0]
Creating decoders for process `\pwm_mask.$../Build/pmic_full.v:244$proc$51'.
     1/1: $0\pwm_out[0:0]
Creating decoders for process `\pwm_mask.$../Build/pmic_full.v:225$proc$47'.
     1/2: $0\pulse_allowed[0:0]
     2/2: $0\run_counter[6:0]
Creating decoders for process `\soft_start.$../Build/pmic_full.v:196$proc$45'.
Creating decoders for process `\soft_start.$../Build/pmic_full.v:166$proc$33'.
     1/3: $0\cycle_counter[6:0]
     2/3: $0\SS_done[0:0]
     3/3: $0\max_on_counts[6:0]
Creating decoders for process `\soft_start.$../Build/pmic_full.v:161$proc$30'.
Creating decoders for process `\soft_start.$../Build/pmic_full.v:156$proc$28'.
     1/1: $0\pwm_sync_d[0:0]
Creating decoders for process `\input_debounce.$../Build/pmic_full.v:106$proc$25'.
Creating decoders for process `\input_debounce.$../Build/pmic_full.v:101$proc$19'.
     1/1: $0\flag_out[0:0]
Creating decoders for process `\input_debounce.$../Build/pmic_full.v:92$proc$13'.
     1/1: $0\disagree_counter[15:0]
Creating decoders for process `\input_debounce.$../Build/pmic_full.v:87$proc$11'.
Creating decoders for process `\input_sync.$../Build/pmic_full.v:38$proc$5'.
     1/2: $0\sync_out[0:0]
     2/2: $0\meta_ff[0:0]
Creating decoders for process `\reset_sync.$../Build/pmic_full.v:18$proc$3'.
     1/1: $0\rst_n_exit[0:0]
Creating decoders for process `\reset_sync.$../Build/pmic_full.v:13$proc$1'.
     1/1: $0\meta_ff[0:0]

4.2.8. Executing PROC_DLATCH pass (convert process syncs to latches).
No latch inferred for signal `$paramod$51f53c3c7e657987b680eb6df78b01f2c4800581\input_debounce.\_sv2v_0' from process `$paramod$51f53c3c7e657987b680eb6df78b01f2c4800581\input_debounce.$../Build/pmic_full.v:106$proc$724'.
No latch inferred for signal `$paramod$51f53c3c7e657987b680eb6df78b01f2c4800581\input_debounce.\target_clks' from process `$paramod$51f53c3c7e657987b680eb6df78b01f2c4800581\input_debounce.$../Build/pmic_full.v:87$proc$710'.
No latch inferred for signal `\pmic_top.\_sv2v_0' from process `\pmic_top.$../Build/pmic_full.v:2311$proc$705'.
No latch inferred for signal `\supervisor.\_sv2v_0' from process `\supervisor.$../Build/pmic_full.v:1794$proc$678'.
No latch inferred for signal `\supervisor.\en' from process `\supervisor.$../Build/pmic_full.v:1789$proc$668'.
No latch inferred for signal `\supervisor.\ss_active' from process `\supervisor.$../Build/pmic_full.v:1781$proc$664'.
No latch inferred for signal `\supervisor.\run_active' from process `\supervisor.$../Build/pmic_full.v:1781$proc$664'.
No latch inferred for signal `\supervisor.\hiccup_active' from process `\supervisor.$../Build/pmic_full.v:1781$proc$664'.
No latch inferred for signal `\supervisor.\state_out' from process `\supervisor.$../Build/pmic_full.v:1781$proc$664'.
No latch inferred for signal `\supervisor.\en_from_state' from process `\supervisor.$../Build/pmic_full.v:1769$proc$663'.
No latch inferred for signal `\supervisor.\next_state' from process `\supervisor.$../Build/pmic_full.v:1732$proc$639'.
No latch inferred for signal `\supervisor.\g_en' from process `\supervisor.$../Build/pmic_full.v:1722$proc$635'.
No latch inferred for signal `\fault_LED.\_sv2v_0' from process `\fault_LED.$../Build/pmic_full.v:710$proc$236'.
No latch inferred for signal `\fault_LED.\currently_faulted' from process `\fault_LED.$../Build/pmic_full.v:676$proc$217'.
No latch inferred for signal `\pgood_gen.\_sv2v_0' from process `\pgood_gen.$../Build/pmic_full.v:577$proc$199'.
No latch inferred for signal `\pgood_gen.\PGOOD' from process `\pgood_gen.$../Build/pmic_full.v:572$proc$195'.
No latch inferred for signal `\pgood_gen.\pwm_fall' from process `\pgood_gen.$../Build/pmic_full.v:556$proc$185'.
No latch inferred for signal `\strike_counter.\_sv2v_0' from process `\strike_counter.$../Build/pmic_full.v:515$proc$180'.
No latch inferred for signal `\strike_counter.\pwm_fall' from process `\strike_counter.$../Build/pmic_full.v:486$proc$163'.
No latch inferred for signal `\strike_counter.\hiccup_entry' from process `\strike_counter.$../Build/pmic_full.v:486$proc$163'.
No latch inferred for signal `\hiccup_timer.\_sv2v_0' from process `\hiccup_timer.$../Build/pmic_full.v:433$proc$159'.
No latch inferred for signal `\hiccup_timer.\cool_down_target' from process `\hiccup_timer.$../Build/pmic_full.v:413$proc$150'.
No latch inferred for signal `\fault_arbiter.\_sv2v_0' from process `\fault_arbiter.$../Build/pmic_full.v:376$proc$147'.
No latch inferred for signal `\fault_arbiter.\fault_count_ss_out' from process `\fault_arbiter.$../Build/pmic_full.v:371$proc$146'.
No latch inferred for signal `\fault_arbiter.\fault_count_run_out' from process `\fault_arbiter.$../Build/pmic_full.v:366$proc$145'.
No latch inferred for signal `\fault_arbiter.\window_trip_SS' from process `\fault_arbiter.$../Build/pmic_full.v:361$proc$142'.
No latch inferred for signal `\fault_arbiter.\window_trip' from process `\fault_arbiter.$../Build/pmic_full.v:356$proc$137'.
No latch inferred for signal `\fault_arbiter.\pwm_rise' from process `\fault_arbiter.$../Build/pmic_full.v:299$proc$64'.
No latch inferred for signal `\soft_start.\_sv2v_0' from process `\soft_start.$../Build/pmic_full.v:196$proc$45'.
No latch inferred for signal `\soft_start.\pwm_fall' from process `\soft_start.$../Build/pmic_full.v:161$proc$30'.
No latch inferred for signal `\input_debounce.\_sv2v_0' from process `\input_debounce.$../Build/pmic_full.v:106$proc$25'.
No latch inferred for signal `\input_debounce.\target_clks' from process `\input_debounce.$../Build/pmic_full.v:87$proc$11'.

4.2.9. Executing PROC_DFF pass (convert process syncs to FFs).
Creating register for signal `$paramod$51f53c3c7e657987b680eb6df78b01f2c4800581\input_debounce.\flag_out' using process `$paramod$51f53c3c7e657987b680eb6df78b01f2c4800581\input_debounce.$../Build/pmic_full.v:101$proc$718'.
  created $adff cell `$procdff$1031' with positive edge clock and positive level reset.
Creating register for signal `$paramod$51f53c3c7e657987b680eb6df78b01f2c4800581\input_debounce.\disagree_counter' using process `$paramod$51f53c3c7e657987b680eb6df78b01f2c4800581\input_debounce.$../Build/pmic_full.v:92$proc$712'.
  created $adff cell `$procdff$1036' with positive edge clock and positive level reset.
Creating register for signal `\supervisor.\state' using process `\supervisor.$../Build/pmic_full.v:1727$proc$637'.
  created $adff cell `$procdff$1041' with positive edge clock and positive level reset.
Creating register for signal `\fault_LED.\Red_LED3' using process `\fault_LED.$../Build/pmic_full.v:705$proc$234'.
  created $adff cell `$procdff$1046' with positive edge clock and positive level reset.
Creating register for signal `\fault_LED.\Red_LED2' using process `\fault_LED.$../Build/pmic_full.v:700$proc$232'.
  created $adff cell `$procdff$1051' with positive edge clock and positive level reset.
Creating register for signal `\fault_LED.\Red_LED1' using process `\fault_LED.$../Build/pmic_full.v:691$proc$228'.
  created $adff cell `$procdff$1056' with positive edge clock and positive level reset.
Creating register for signal `\fault_LED.\pgood_LED' using process `\fault_LED.$../Build/pmic_full.v:686$proc$226'.
  created $adff cell `$procdff$1061' with positive edge clock and positive level reset.
Creating register for signal `\fault_LED.\Green_LED' using process `\fault_LED.$../Build/pmic_full.v:681$proc$221'.
  created $adff cell `$procdff$1066' with positive edge clock and positive level reset.
Creating register for signal `\fault_LED.\blink_counter' using process `\fault_LED.$../Build/pmic_full.v:665$proc$212'.
  created $adff cell `$procdff$1071' with positive edge clock and positive level reset.
Creating register for signal `\fault_LED.\blink' using process `\fault_LED.$../Build/pmic_full.v:665$proc$212'.
  created $adff cell `$procdff$1076' with positive edge clock and positive level reset.
Creating register for signal `$paramod\input_sync\RESET_VALUE=1'1.\meta_ff' using process `$paramod\input_sync\RESET_VALUE=1'1.$../Build/pmic_full.v:38$proc$725'.
  created $adff cell `$procdff$1081' with positive edge clock and positive level reset.
Creating register for signal `$paramod\input_sync\RESET_VALUE=1'1.\sync_out' using process `$paramod\input_sync\RESET_VALUE=1'1.$../Build/pmic_full.v:38$proc$725'.
  created $adff cell `$procdff$1086' with positive edge clock and positive level reset.
Creating register for signal `\pgood_gen.\qualify_counter' using process `\pgood_gen.$../Build/pmic_full.v:561$proc$188'.
  created $adff cell `$procdff$1091' with positive edge clock and positive level reset.
Creating register for signal `\pgood_gen.\pwm_sync_d' using process `\pgood_gen.$../Build/pmic_full.v:551$proc$183'.
  created $adff cell `$procdff$1096' with positive edge clock and positive level reset.
Creating register for signal `\strike_counter.\clean_counter' using process `\strike_counter.$../Build/pmic_full.v:504$proc$174'.
  created $adff cell `$procdff$1101' with positive edge clock and positive level reset.
Creating register for signal `\strike_counter.\strike_level' using process `\strike_counter.$../Build/pmic_full.v:492$proc$168'.
  created $adff cell `$procdff$1106' with positive edge clock and positive level reset.
Creating register for signal `\strike_counter.\latch_assert' using process `\strike_counter.$../Build/pmic_full.v:492$proc$168'.
  created $adff cell `$procdff$1111' with positive edge clock and positive level reset.
Creating register for signal `\strike_counter.\pwm_sync_d' using process `\strike_counter.$../Build/pmic_full.v:477$proc$161'.
  created $adff cell `$procdff$1116' with positive edge clock and positive level reset.
Creating register for signal `\strike_counter.\hiccup_active_d' using process `\strike_counter.$../Build/pmic_full.v:477$proc$161'.
  created $adff cell `$procdff$1121' with positive edge clock and positive level reset.
Creating register for signal `\hiccup_timer.\hiccup_done' using process `\hiccup_timer.$../Build/pmic_full.v:418$proc$154'.
  created $adff cell `$procdff$1126' with positive edge clock and positive level reset.
Creating register for signal `\hiccup_timer.\cool_counter' using process `\hiccup_timer.$../Build/pmic_full.v:418$proc$154'.
  created $adff cell `$procdff$1131' with positive edge clock and positive level reset.
Creating register for signal `\fault_arbiter.\fault_shifter_SS' using process `\fault_arbiter.$../Build/pmic_full.v:331$proc$80'.
  created $adff cell `$procdff$1136' with positive edge clock and positive level reset.
Creating register for signal `\fault_arbiter.\fault_shifter_RUN' using process `\fault_arbiter.$../Build/pmic_full.v:331$proc$80'.
  created $adff cell `$procdff$1141' with positive edge clock and positive level reset.
Creating register for signal `\fault_arbiter.\fault_count_run' using process `\fault_arbiter.$../Build/pmic_full.v:331$proc$80'.
  created $adff cell `$procdff$1146' with positive edge clock and positive level reset.
Creating register for signal `\fault_arbiter.\fault_count_ss' using process `\fault_arbiter.$../Build/pmic_full.v:331$proc$80'.
  created $adff cell `$procdff$1151' with positive edge clock and positive level reset.
Creating register for signal `\fault_arbiter.\sv2v_cast_7CA3E$func$../Build/pmic_full.v:339$55.$result' using process `\fault_arbiter.$../Build/pmic_full.v:331$proc$80'.
  created $adff cell `$procdff$1156' with positive edge clock and positive level reset.
Creating register for signal `\fault_arbiter.\sv2v_cast_7CA3E$func$../Build/pmic_full.v:339$55.inp' using process `\fault_arbiter.$../Build/pmic_full.v:331$proc$80'.
  created $adff cell `$procdff$1161' with positive edge clock and positive level reset.
Creating register for signal `\fault_arbiter.\sv2v_cast_7CA3E$func$../Build/pmic_full.v:339$56.$result' using process `\fault_arbiter.$../Build/pmic_full.v:331$proc$80'.
  created $adff cell `$procdff$1166' with positive edge clock and positive level reset.
Creating register for signal `\fault_arbiter.\sv2v_cast_7CA3E$func$../Build/pmic_full.v:339$56.inp' using process `\fault_arbiter.$../Build/pmic_full.v:331$proc$80'.
  created $adff cell `$procdff$1171' with positive edge clock and positive level reset.
Creating register for signal `\fault_arbiter.\sv2v_cast_CCA05$func$../Build/pmic_full.v:340$57.$result' using process `\fault_arbiter.$../Build/pmic_full.v:331$proc$80'.
  created $adff cell `$procdff$1176' with positive edge clock and positive level reset.
Creating register for signal `\fault_arbiter.\sv2v_cast_CCA05$func$../Build/pmic_full.v:340$57.inp' using process `\fault_arbiter.$../Build/pmic_full.v:331$proc$80'.
  created $adff cell `$procdff$1181' with positive edge clock and positive level reset.
Creating register for signal `\fault_arbiter.\sv2v_cast_40C54$func$../Build/pmic_full.v:343$58.$result' using process `\fault_arbiter.$../Build/pmic_full.v:331$proc$80'.
  created $adff cell `$procdff$1186' with positive edge clock and positive level reset.
Creating register for signal `\fault_arbiter.\sv2v_cast_40C54$func$../Build/pmic_full.v:343$58.inp' using process `\fault_arbiter.$../Build/pmic_full.v:331$proc$80'.
  created $adff cell `$procdff$1191' with positive edge clock and positive level reset.
Creating register for signal `\fault_arbiter.\sv2v_cast_40C54$func$../Build/pmic_full.v:343$59.$result' using process `\fault_arbiter.$../Build/pmic_full.v:331$proc$80'.
  created $adff cell `$procdff$1196' with positive edge clock and positive level reset.
Creating register for signal `\fault_arbiter.\sv2v_cast_40C54$func$../Build/pmic_full.v:343$59.inp' using process `\fault_arbiter.$../Build/pmic_full.v:331$proc$80'.
  created $adff cell `$procdff$1201' with positive edge clock and positive level reset.
Creating register for signal `\fault_arbiter.\sv2v_cast_5BB5F$func$../Build/pmic_full.v:344$60.$result' using process `\fault_arbiter.$../Build/pmic_full.v:331$proc$80'.
  created $adff cell `$procdff$1206' with positive edge clock and positive level reset.
Creating register for signal `\fault_arbiter.\sv2v_cast_5BB5F$func$../Build/pmic_full.v:344$60.inp' using process `\fault_arbiter.$../Build/pmic_full.v:331$proc$80'.
  created $adff cell `$procdff$1211' with positive edge clock and positive level reset.
Creating register for signal `\fault_arbiter.\cp_delay' using process `\fault_arbiter.$../Build/pmic_full.v:308$proc$67'.
  created $adff cell `$procdff$1216' with positive edge clock and positive level reset.
Creating register for signal `\fault_arbiter.\sv2v_cast_A4FBD$func$../Build/pmic_full.v:314$54.$result' using process `\fault_arbiter.$../Build/pmic_full.v:308$proc$67'.
  created $adff cell `$procdff$1221' with positive edge clock and positive level reset.
Creating register for signal `\fault_arbiter.\sv2v_cast_A4FBD$func$../Build/pmic_full.v:314$54.inp' using process `\fault_arbiter.$../Build/pmic_full.v:308$proc$67'.
  created $adff cell `$procdff$1226' with positive edge clock and positive level reset.
Creating register for signal `\fault_arbiter.\pwm_sync_d' using process `\fault_arbiter.$../Build/pmic_full.v:294$proc$62'.
  created $adff cell `$procdff$1231' with positive edge clock and positive level reset.
Creating register for signal `\pwm_mask.\pwm_out' using process `\pwm_mask.$../Build/pmic_full.v:244$proc$51'.
  created $adff cell `$procdff$1236' with positive edge clock and positive level reset.
Creating register for signal `\pwm_mask.\run_counter' using process `\pwm_mask.$../Build/pmic_full.v:225$proc$47'.
  created $adff cell `$procdff$1241' with positive edge clock and positive level reset.
Creating register for signal `\pwm_mask.\pulse_allowed' using process `\pwm_mask.$../Build/pmic_full.v:225$proc$47'.
  created $adff cell `$procdff$1246' with positive edge clock and positive level reset.
Creating register for signal `\soft_start.\max_on_counts' using process `\soft_start.$../Build/pmic_full.v:166$proc$33'.
  created $adff cell `$procdff$1251' with positive edge clock and positive level reset.
Creating register for signal `\soft_start.\SS_done' using process `\soft_start.$../Build/pmic_full.v:166$proc$33'.
  created $adff cell `$procdff$1256' with positive edge clock and positive level reset.
Creating register for signal `\soft_start.\cycle_counter' using process `\soft_start.$../Build/pmic_full.v:166$proc$33'.
  created $adff cell `$procdff$1261' with positive edge clock and positive level reset.
Creating register for signal `\soft_start.\pwm_sync_d' using process `\soft_start.$../Build/pmic_full.v:156$proc$28'.
  created $adff cell `$procdff$1266' with positive edge clock and positive level reset.
Creating register for signal `\input_debounce.\flag_out' using process `\input_debounce.$../Build/pmic_full.v:101$proc$19'.
  created $adff cell `$procdff$1271' with positive edge clock and positive level reset.
Creating register for signal `\input_debounce.\disagree_counter' using process `\input_debounce.$../Build/pmic_full.v:92$proc$13'.
  created $adff cell `$procdff$1276' with positive edge clock and positive level reset.
Creating register for signal `\input_sync.\meta_ff' using process `\input_sync.$../Build/pmic_full.v:38$proc$5'.
  created $adff cell `$procdff$1281' with positive edge clock and positive level reset.
Creating register for signal `\input_sync.\sync_out' using process `\input_sync.$../Build/pmic_full.v:38$proc$5'.
  created $adff cell `$procdff$1286' with positive edge clock and positive level reset.
Creating register for signal `\reset_sync.\rst_n_exit' using process `\reset_sync.$../Build/pmic_full.v:18$proc$3'.
  created $adff cell `$procdff$1291' with positive edge clock and positive level reset.
Creating register for signal `\reset_sync.\meta_ff' using process `\reset_sync.$../Build/pmic_full.v:13$proc$1'.
  created $adff cell `$procdff$1296' with positive edge clock and positive level reset.

4.2.10. Executing PROC_MEMWR pass (convert process memory writes to cells).

4.2.11. Executing PROC_CLEAN pass (remove empty switches from decision trees).
Removing empty process `$paramod$51f53c3c7e657987b680eb6df78b01f2c4800581\input_debounce.$../Build/pmic_full.v:106$proc$724'.
Found and cleaned up 1 empty switch in `$paramod$51f53c3c7e657987b680eb6df78b01f2c4800581\input_debounce.$../Build/pmic_full.v:101$proc$718'.
Removing empty process `$paramod$51f53c3c7e657987b680eb6df78b01f2c4800581\input_debounce.$../Build/pmic_full.v:101$proc$718'.
Found and cleaned up 2 empty switches in `$paramod$51f53c3c7e657987b680eb6df78b01f2c4800581\input_debounce.$../Build/pmic_full.v:92$proc$712'.
Removing empty process `$paramod$51f53c3c7e657987b680eb6df78b01f2c4800581\input_debounce.$../Build/pmic_full.v:92$proc$712'.
Removing empty process `$paramod$51f53c3c7e657987b680eb6df78b01f2c4800581\input_debounce.$../Build/pmic_full.v:87$proc$710'.
Removing empty process `pmic_top.$../Build/pmic_full.v:2311$proc$705'.
Removing empty process `supervisor.$../Build/pmic_full.v:1794$proc$678'.
Removing empty process `supervisor.$../Build/pmic_full.v:1789$proc$668'.
Removing empty process `supervisor.$../Build/pmic_full.v:1781$proc$664'.
Found and cleaned up 1 empty switch in `\supervisor.$../Build/pmic_full.v:1769$proc$663'.
Removing empty process `supervisor.$../Build/pmic_full.v:1769$proc$663'.
Found and cleaned up 9 empty switches in `\supervisor.$../Build/pmic_full.v:1732$proc$639'.
Removing empty process `supervisor.$../Build/pmic_full.v:1732$proc$639'.
Removing empty process `supervisor.$../Build/pmic_full.v:1727$proc$637'.
Removing empty process `supervisor.$../Build/pmic_full.v:1722$proc$635'.
Removing empty process `fault_LED.$../Build/pmic_full.v:710$proc$236'.
Removing empty process `fault_LED.$../Build/pmic_full.v:705$proc$234'.
Removing empty process `fault_LED.$../Build/pmic_full.v:700$proc$232'.
Found and cleaned up 2 empty switches in `\fault_LED.$../Build/pmic_full.v:691$proc$228'.
Removing empty process `fault_LED.$../Build/pmic_full.v:691$proc$228'.
Removing empty process `fault_LED.$../Build/pmic_full.v:686$proc$226'.
Removing empty process `fault_LED.$../Build/pmic_full.v:681$proc$221'.
Removing empty process `fault_LED.$../Build/pmic_full.v:676$proc$217'.
Found and cleaned up 1 empty switch in `\fault_LED.$../Build/pmic_full.v:665$proc$212'.
Removing empty process `fault_LED.$../Build/pmic_full.v:665$proc$212'.
Removing empty process `$paramod\input_sync\RESET_VALUE=1'1.$../Build/pmic_full.v:38$proc$725'.
Removing empty process `pgood_gen.$../Build/pmic_full.v:577$proc$199'.
Removing empty process `pgood_gen.$../Build/pmic_full.v:572$proc$195'.
Found and cleaned up 3 empty switches in `\pgood_gen.$../Build/pmic_full.v:561$proc$188'.
Removing empty process `pgood_gen.$../Build/pmic_full.v:561$proc$188'.
Removing empty process `pgood_gen.$../Build/pmic_full.v:556$proc$185'.
Removing empty process `pgood_gen.$../Build/pmic_full.v:551$proc$183'.
Removing empty process `strike_counter.$../Build/pmic_full.v:515$proc$180'.
Found and cleaned up 3 empty switches in `\strike_counter.$../Build/pmic_full.v:504$proc$174'.
Removing empty process `strike_counter.$../Build/pmic_full.v:504$proc$174'.
Found and cleaned up 3 empty switches in `\strike_counter.$../Build/pmic_full.v:492$proc$168'.
Removing empty process `strike_counter.$../Build/pmic_full.v:492$proc$168'.
Removing empty process `strike_counter.$../Build/pmic_full.v:486$proc$163'.
Removing empty process `strike_counter.$../Build/pmic_full.v:477$proc$161'.
Removing empty process `hiccup_timer.$../Build/pmic_full.v:433$proc$159'.
Found and cleaned up 2 empty switches in `\hiccup_timer.$../Build/pmic_full.v:418$proc$154'.
Removing empty process `hiccup_timer.$../Build/pmic_full.v:418$proc$154'.
Removing empty process `hiccup_timer.$../Build/pmic_full.v:413$proc$150'.
Removing empty process `fault_arbiter.$../Build/pmic_full.v:376$proc$147'.
Removing empty process `fault_arbiter.$../Build/pmic_full.v:371$proc$146'.
Removing empty process `fault_arbiter.$../Build/pmic_full.v:366$proc$145'.
Removing empty process `fault_arbiter.$../Build/pmic_full.v:361$proc$142'.
Removing empty process `fault_arbiter.$../Build/pmic_full.v:356$proc$137'.
Found and cleaned up 3 empty switches in `\fault_arbiter.$../Build/pmic_full.v:331$proc$80'.
Removing empty process `fault_arbiter.$../Build/pmic_full.v:331$proc$80'.
Found and cleaned up 1 empty switch in `\fault_arbiter.$../Build/pmic_full.v:308$proc$67'.
Removing empty process `fault_arbiter.$../Build/pmic_full.v:308$proc$67'.
Removing empty process `fault_arbiter.$../Build/pmic_full.v:299$proc$64'.
Removing empty process `fault_arbiter.$../Build/pmic_full.v:294$proc$62'.
Removing empty process `pwm_mask.$../Build/pmic_full.v:244$proc$51'.
Found and cleaned up 2 empty switches in `\pwm_mask.$../Build/pmic_full.v:225$proc$47'.
Removing empty process `pwm_mask.$../Build/pmic_full.v:225$proc$47'.
Removing empty process `soft_start.$../Build/pmic_full.v:196$proc$45'.
Found and cleaned up 7 empty switches in `\soft_start.$../Build/pmic_full.v:166$proc$33'.
Removing empty process `soft_start.$../Build/pmic_full.v:166$proc$33'.
Removing empty process `soft_start.$../Build/pmic_full.v:161$proc$30'.
Removing empty process `soft_start.$../Build/pmic_full.v:156$proc$28'.
Removing empty process `input_debounce.$../Build/pmic_full.v:106$proc$25'.
Found and cleaned up 1 empty switch in `\input_debounce.$../Build/pmic_full.v:101$proc$19'.
Removing empty process `input_debounce.$../Build/pmic_full.v:101$proc$19'.
Found and cleaned up 2 empty switches in `\input_debounce.$../Build/pmic_full.v:92$proc$13'.
Removing empty process `input_debounce.$../Build/pmic_full.v:92$proc$13'.
Removing empty process `input_debounce.$../Build/pmic_full.v:87$proc$11'.
Removing empty process `input_sync.$../Build/pmic_full.v:38$proc$5'.
Removing empty process `reset_sync.$../Build/pmic_full.v:18$proc$3'.
Removing empty process `reset_sync.$../Build/pmic_full.v:13$proc$1'.
Cleaned up 43 empty switches.

4.2.12. Executing OPT_EXPR pass (perform const folding).
Optimizing module $paramod$51f53c3c7e657987b680eb6df78b01f2c4800581\input_debounce.
<suppressed ~7 debug messages>
Optimizing module pmic_top.
Optimizing module supervisor.
<suppressed ~5 debug messages>
Optimizing module fault_LED.
<suppressed ~15 debug messages>
Optimizing module $paramod\input_sync\RESET_VALUE=1'1.
<suppressed ~4 debug messages>
Optimizing module pgood_gen.
<suppressed ~4 debug messages>
Optimizing module strike_counter.
<suppressed ~10 debug messages>
Optimizing module hiccup_timer.
<suppressed ~6 debug messages>
Optimizing module fault_arbiter.
<suppressed ~43 debug messages>
Optimizing module pwm_mask.
<suppressed ~6 debug messages>
Optimizing module soft_start.
<suppressed ~8 debug messages>
Optimizing module input_debounce.
<suppressed ~4 debug messages>
Optimizing module input_sync.
<suppressed ~4 debug messages>
Optimizing module reset_sync.
<suppressed ~4 debug messages>

4.3. Executing CHECK pass (checking for obvious problems).
Checking module $paramod$51f53c3c7e657987b680eb6df78b01f2c4800581\input_debounce...
Checking module pmic_top...
Checking module supervisor...
Checking module fault_LED...
Checking module $paramod\input_sync\RESET_VALUE=1'1...
Checking module pgood_gen...
Checking module strike_counter...
Checking module hiccup_timer...
Checking module fault_arbiter...
Checking module pwm_mask...
Checking module soft_start...
Checking module input_debounce...
Checking module input_sync...
Checking module reset_sync...
Found and reported 0 problems.

4.4. Executing FLATTEN pass (flatten design).
Deleting now unused module $paramod$51f53c3c7e657987b680eb6df78b01f2c4800581\input_debounce.
Deleting now unused module supervisor.
Deleting now unused module fault_LED.
Deleting now unused module $paramod\input_sync\RESET_VALUE=1'1.
Deleting now unused module pgood_gen.
Deleting now unused module strike_counter.
Deleting now unused module hiccup_timer.
Deleting now unused module fault_arbiter.
Deleting now unused module pwm_mask.
Deleting now unused module soft_start.
Deleting now unused module input_debounce.
Deleting now unused module input_sync.
Deleting now unused module reset_sync.
<suppressed ~20 debug messages>

4.5. Executing OPT_EXPR pass (perform const folding).
Optimizing module pmic_top.
<suppressed ~4 debug messages>

4.6. Executing CHECK pass (checking for obvious problems).
Checking module pmic_top...
Found and reported 0 problems.

4.7. Executing OPT_CLEAN pass (remove unused cells and wires).
Finding unused cells or wires in module \pmic_top..
Removed 146 unused cells and 520 unused wires.
<suppressed ~178 debug messages>

4.8. Executing OPT pass (performing simple optimizations).

4.8.1. Executing OPT_EXPR pass (perform const folding).
Optimizing module pmic_top.

4.8.2. Executing OPT_MERGE pass (detect identical cells).
Finding identical cells in module `\pmic_top'.
Computing hashes of 310 cells of `\pmic_top'.
Finding duplicate cells in `\pmic_top'.
Computing hashes of 269 cells of `\pmic_top'.
Finding duplicate cells in `\pmic_top'.
Computing hashes of 265 cells of `\pmic_top'.
Finding duplicate cells in `\pmic_top'.
Computing hashes of 264 cells of `\pmic_top'.
Finding duplicate cells in `\pmic_top'.
<suppressed ~138 debug messages>
Removed a total of 46 cells.

4.8.3. Executing OPT_MUXTREE pass (detect dead branches in mux trees).
Running muxtree optimizer on module \pmic_top..
  Creating internal representation of mux trees.
  Evaluating internal representation of mux trees.
  Analyzing evaluation results.
    dead port 1/2 on $mux $flatten\u_supervisor.$procmux$743.
    dead port 2/2 on $mux $flatten\u_supervisor.$procmux$745.
    dead port 2/2 on $mux $flatten\u_supervisor.$procmux$750.
    dead port 1/2 on $mux $flatten\u_supervisor.$procmux$757.
    dead port 2/2 on $mux $flatten\u_supervisor.$procmux$759.
    dead port 2/2 on $mux $flatten\u_supervisor.$procmux$765.
    dead port 1/2 on $mux $flatten\u_supervisor.$procmux$773.
    dead port 1/2 on $mux $flatten\u_supervisor.$procmux$776.
    dead port 2/2 on $mux $flatten\u_supervisor.$procmux$778.
    dead port 1/2 on $mux $flatten\u_supervisor.$procmux$786.
    dead port 2/2 on $mux $flatten\u_supervisor.$procmux$788.
    dead port 2/2 on $mux $flatten\u_supervisor.$procmux$795.
    dead port 2/2 on $mux $flatten\u_supervisor.$procmux$803.
Removed 13 multiplexer ports.
<suppressed ~118 debug messages>

4.8.4. Executing OPT_REDUCE pass (consolidate $*mux and $reduce_* inputs).
  Optimizing cells in module \pmic_top.
    New ctrl vector for $pmux cell $flatten\u_supervisor.$procmux$734: { $auto$opt_reduce.cc:137:opt_pmux$1320 $auto$opt_reduce.cc:137:opt_pmux$1318 }
  Optimizing cells in module \pmic_top.
Performed a total of 1 changes.

4.8.5. Executing OPT_MERGE pass (detect identical cells).
Finding identical cells in module `\pmic_top'.
Computing hashes of 253 cells of `\pmic_top'.
Finding duplicate cells in `\pmic_top'.
Removed a total of 0 cells.

4.8.6. Executing OPT_DFF pass (perform DFF optimizations).

4.8.7. Executing OPT_CLEAN pass (remove unused cells and wires).
Finding unused cells or wires in module \pmic_top..
Removed 0 unused cells and 54 unused wires.
<suppressed ~1 debug messages>

4.8.8. Executing OPT_EXPR pass (perform const folding).
Optimizing module pmic_top.

4.8.9. Rerunning OPT passes. (Maybe there is more to do..)

4.8.10. Executing OPT_MUXTREE pass (detect dead branches in mux trees).
Running muxtree optimizer on module \pmic_top..
  Creating internal representation of mux trees.
  Evaluating internal representation of mux trees.
  Analyzing evaluation results.
Removed 0 multiplexer ports.
<suppressed ~105 debug messages>

4.8.11. Executing OPT_REDUCE pass (consolidate $*mux and $reduce_* inputs).
  Optimizing cells in module \pmic_top.
Performed a total of 0 changes.

4.8.12. Executing OPT_MERGE pass (detect identical cells).
Finding identical cells in module `\pmic_top'.
Computing hashes of 253 cells of `\pmic_top'.
Finding duplicate cells in `\pmic_top'.
Removed a total of 0 cells.

4.8.13. Executing OPT_DFF pass (perform DFF optimizations).

4.8.14. Executing OPT_CLEAN pass (remove unused cells and wires).
Finding unused cells or wires in module \pmic_top..

4.8.15. Executing OPT_EXPR pass (perform const folding).
Optimizing module pmic_top.

4.8.16. Finished fast OPT passes. (There is nothing left to do.)

4.9. Executing FSM pass (extract and optimize FSM).

4.9.1. Executing FSM_DETECT pass (finding FSMs in design).
Found FSM state register pmic_top.u_supervisor.state.

4.9.2. Executing FSM_EXTRACT pass (extracting FSM from design).
Extracting FSM `\u_supervisor.state' from module `\pmic_top'.
  found $adff cell for state register: $flatten\u_supervisor.$procdff$1041
  root of input selection tree: \u_supervisor.next_state
  found reset state: 2'00 (from async reset)
  found ctrl input: \u_hiccup_timer.hiccup_active
  found ctrl input: \u_fault_LED.run_active
  found ctrl input: \u_fault_LED.ss_active
  found ctrl input: $flatten\u_supervisor.$procmux$738_CMP
  found ctrl input: $flatten\u_supervisor.$../Build/pmic_full.v:1760$or$662_Y
  found ctrl input: \u_hiccup_timer.hiccup_done
  found state code: 2'11
  found state code: 2'01
  found ctrl input: $flatten\u_supervisor.$../Build/pmic_full.v:1753$or$657_Y
  found ctrl input: \u_strike_counter.window_trip
  found state code: 2'10
  found ctrl input: $flatten\u_supervisor.$../Build/pmic_full.v:1744$or$652_Y
  found ctrl input: \u_fault_arbiter.window_trip_SS
  found ctrl input: \u_soft_start.SS_done
  found ctrl input: $flatten\u_supervisor.$../Build/pmic_full.v:1739$and$647_Y
  found ctrl output: \u_hiccup_timer.hiccup_active
  found ctrl output: \u_fault_LED.run_active
  found ctrl output: \u_fault_LED.ss_active
  found ctrl output: $flatten\u_supervisor.$procmux$738_CMP
  ctrl inputs: { \u_soft_start.SS_done \u_strike_counter.window_trip \u_hiccup_timer.hiccup_done \u_fault_arbiter.window_trip_SS $flatten\u_supervisor.$../Build/pmic_full.v:1739$and$647_Y $flatten\u_supervisor.$../Build/pmic_full.v:1744$or$652_Y $flatten\u_supervisor.$../Build/pmic_full.v:1753$or$657_Y $flatten\u_supervisor.$../Build/pmic_full.v:1760$or$662_Y }
  ctrl outputs: { \u_fault_LED.ss_active \u_fault_LED.run_active \u_hiccup_timer.hiccup_active \u_supervisor.next_state $flatten\u_supervisor.$procmux$738_CMP }
  transition:       2'00 8'----0--- ->       2'00 6'000001
  transition:       2'00 8'----1--- ->       2'01 6'000011
  transition:       2'10 8'-0----0- ->       2'10 6'010100
  transition:       2'10 8'-1----0- ->       2'11 6'010110
  transition:       2'10 8'------1- ->       2'00 6'010000
  transition:       2'01 8'0--0-0-- ->       2'01 6'100010
  transition:       2'01 8'1--0-0-- ->       2'10 6'100100
  transition:       2'01 8'---1-0-- ->       2'11 6'100110
  transition:       2'01 8'-----1-- ->       2'00 6'100000
  transition:       2'11 8'--0----0 ->       2'11 6'001110
  transition:       2'11 8'--1----0 ->       2'01 6'001010
  transition:       2'11 8'-------1 ->       2'00 6'001000

4.9.3. Executing FSM_OPT pass (simple optimizations of FSMs).
Optimizing FSM `$fsm$\u_supervisor.state$1321' from module `\pmic_top'.

4.9.4. Executing OPT_CLEAN pass (remove unused cells and wires).
Finding unused cells or wires in module \pmic_top..
Removed 14 unused cells and 16 unused wires.
<suppressed ~17 debug messages>

4.9.5. Executing FSM_OPT pass (simple optimizations of FSMs).
Optimizing FSM `$fsm$\u_supervisor.state$1321' from module `\pmic_top'.
  Removing unused output signal \u_supervisor.next_state [0].
  Removing unused output signal \u_supervisor.next_state [1].

4.9.6. Executing FSM_RECODE pass (re-assigning FSM state encoding).
Recoding FSM `$fsm$\u_supervisor.state$1321' from module `\pmic_top' using `auto' encoding:
  mapping auto encoding to `one-hot` for this FSM.
  00 -> ---1
  10 -> --1-
  01 -> -1--
  11 -> 1---

4.9.7. Executing FSM_INFO pass (dumping all available information on FSM cells).

FSM `$fsm$\u_supervisor.state$1321' from module `pmic_top':
-------------------------------------

  Information on FSM $fsm$\u_supervisor.state$1321 (\u_supervisor.state):

  Number of input signals:    8
  Number of output signals:   4
  Number of state bits:       4

  Input signals:
    0: $flatten\u_supervisor.$../Build/pmic_full.v:1760$or$662_Y
    1: $flatten\u_supervisor.$../Build/pmic_full.v:1753$or$657_Y
    2: $flatten\u_supervisor.$../Build/pmic_full.v:1744$or$652_Y
    3: $flatten\u_supervisor.$../Build/pmic_full.v:1739$and$647_Y
    4: \u_fault_arbiter.window_trip_SS
    5: \u_hiccup_timer.hiccup_done
    6: \u_strike_counter.window_trip
    7: \u_soft_start.SS_done

  Output signals:
    0: $flatten\u_supervisor.$procmux$738_CMP
    1: \u_hiccup_timer.hiccup_active
    2: \u_fault_LED.run_active
    3: \u_fault_LED.ss_active

  State encoding:
    0:     4'---1  <RESET STATE>
    1:     4'--1-
    2:     4'-1--
    3:     4'1---

  Transition Table (state_in, ctrl_in, state_out, ctrl_out):
      0:     0 8'----0---   ->     0 4'0001
      1:     0 8'----1---   ->     2 4'0001
      2:     1 8'------1-   ->     0 4'0100
      3:     1 8'-0----0-   ->     1 4'0100
      4:     1 8'-1----0-   ->     3 4'0100
      5:     2 8'-----1--   ->     0 4'1000
      6:     2 8'1--0-0--   ->     1 4'1000
      7:     2 8'0--0-0--   ->     2 4'1000
      8:     2 8'---1-0--   ->     3 4'1000
      9:     3 8'-------1   ->     0 4'0010
     10:     3 8'--1----0   ->     2 4'0010
     11:     3 8'--0----0   ->     3 4'0010

-------------------------------------

4.9.8. Executing FSM_MAP pass (mapping FSMs to basic logic).
Mapping FSM `$fsm$\u_supervisor.state$1321' from module `\pmic_top'.

4.10. Executing OPT pass (performing simple optimizations).

4.10.1. Executing OPT_EXPR pass (perform const folding).
Optimizing module pmic_top.
<suppressed ~8 debug messages>

4.10.2. Executing OPT_MERGE pass (detect identical cells).
Finding identical cells in module `\pmic_top'.
Computing hashes of 264 cells of `\pmic_top'.
Finding duplicate cells in `\pmic_top'.
Removed a total of 0 cells.

4.10.3. Executing OPT_MUXTREE pass (detect dead branches in mux trees).
Running muxtree optimizer on module \pmic_top..
  Creating internal representation of mux trees.
  Evaluating internal representation of mux trees.
  Analyzing evaluation results.
Removed 0 multiplexer ports.
<suppressed ~95 debug messages>

4.10.4. Executing OPT_REDUCE pass (consolidate $*mux and $reduce_* inputs).
  Optimizing cells in module \pmic_top.
Performed a total of 0 changes.

4.10.5. Executing OPT_MERGE pass (detect identical cells).
Finding identical cells in module `\pmic_top'.
Computing hashes of 264 cells of `\pmic_top'.
Finding duplicate cells in `\pmic_top'.
Removed a total of 0 cells.

4.10.6. Executing OPT_DFF pass (perform DFF optimizations).
Adding EN signal on $flatten\u_en_from_switch_db.$procdff$1036 ($adff) from module pmic_top (D = $flatten\u_en_from_switch_db.$0\disagree_counter[19:0], Q = \u_en_from_switch_db.disagree_counter).
Adding EN signal on $flatten\u_strike_counter.$procdff$1111 ($adff) from module pmic_top (D = 1'1, Q = \u_strike_counter.latch_assert).
Adding EN signal on $flatten\u_fault_LED.$procdff$1076 ($adff) from module pmic_top (D = $flatten\u_fault_LED.$../Build/pmic_full.v:672$not$215_Y, Q = \u_fault_LED.blink).
Adding EN signal on $flatten\u_hiccup_timer.$procdff$1126 ($adff) from module pmic_top (D = $flatten\u_hiccup_timer.$0\hiccup_done[0:0], Q = \u_hiccup_timer.hiccup_done).
Adding EN signal on $flatten\u_hiccup_timer.$procdff$1131 ($adff) from module pmic_top (D = $flatten\u_hiccup_timer.$0\cool_counter[21:0], Q = \u_hiccup_timer.cool_counter).
Adding EN signal on $flatten\u_en_from_switch_db.$procdff$1031 ($adff) from module pmic_top (D = \u_en_from_switch_sync.sync_out, Q = \u_en_from_switch_db.flag_out).
Adding EN signal on $flatten\u_OTP_sync_db.$procdff$1271 ($adff) from module pmic_top (D = \u_otp_sync.sync_out, Q = \u_OTP_sync_db.flag_out).
Adding EN signal on $flatten\u_OTP_sync_db.$procdff$1276 ($adff) from module pmic_top (D = $flatten\u_OTP_sync_db.$0\disagree_counter[15:0], Q = \u_OTP_sync_db.disagree_counter).
Adding EN signal on $flatten\u_soft_start.$procdff$1251 ($adff) from module pmic_top (D = $flatten\u_soft_start.$0\max_on_counts[6:0], Q = \u_soft_start.max_on_counts).
Adding EN signal on $flatten\u_UVLO_sync_db.$procdff$1271 ($adff) from module pmic_top (D = \u_uvlo_sync.sync_out, Q = \u_UVLO_sync_db.flag_out).
Adding EN signal on $flatten\u_UVLO_sync_db.$procdff$1276 ($adff) from module pmic_top (D = $flatten\u_UVLO_sync_db.$0\disagree_counter[15:0], Q = \u_UVLO_sync_db.disagree_counter).
Adding EN signal on $flatten\u_soft_start.$procdff$1261 ($adff) from module pmic_top (D = $flatten\u_soft_start.$0\cycle_counter[6:0], Q = \u_soft_start.cycle_counter).
Adding EN signal on $flatten\u_latch_stat_sync_db.$procdff$1271 ($adff) from module pmic_top (D = \u_latch_stat_sync.sync_out, Q = \u_latch_stat_sync_db.flag_out).
Adding EN signal on $flatten\u_latch_stat_sync_db.$procdff$1276 ($adff) from module pmic_top (D = $flatten\u_latch_stat_sync_db.$0\disagree_counter[15:0], Q = \u_latch_stat_sync_db.disagree_counter).
Adding EN signal on $flatten\u_soft_start.$procdff$1256 ($adff) from module pmic_top (D = $flatten\u_soft_start.$0\SS_done[0:0], Q = \u_soft_start.SS_done).
Adding EN signal on $flatten\u_fault_arbiter.$procdff$1136 ($adff) from module pmic_top (D = $flatten\u_fault_arbiter.$procmux$959_Y, Q = \u_fault_arbiter.fault_shifter_SS).
Adding EN signal on $flatten\u_pgood_gen.$procdff$1091 ($adff) from module pmic_top (D = $flatten\u_pgood_gen.$0\qualify_counter[11:0], Q = \u_pgood_gen.qualify_counter).
Adding EN signal on $flatten\u_strike_counter.$procdff$1101 ($adff) from module pmic_top (D = $flatten\u_strike_counter.$0\clean_counter[18:0], Q = \u_strike_counter.clean_counter).
Adding EN signal on $flatten\u_strike_counter.$procdff$1106 ($adff) from module pmic_top (D = $flatten\u_strike_counter.$0\strike_level[1:0], Q = \u_strike_counter.strike_level).
Adding EN signal on $flatten\u_pwm_mask.$procdff$1241 ($adff) from module pmic_top (D = $flatten\u_pwm_mask.$0\run_counter[6:0], Q = \u_pwm_mask.run_counter).
Adding EN signal on $flatten\u_fault_arbiter.$procdff$1151 ($adff) from module pmic_top (D = $flatten\u_fault_arbiter.$procmux$935_Y, Q = \u_fault_arbiter.fault_count_ss).
Adding EN signal on $flatten\u_fault_arbiter.$procdff$1146 ($adff) from module pmic_top (D = $flatten\u_fault_arbiter.$0\fault_count_run[4:0], Q = \u_fault_arbiter.fault_count_run).
Adding EN signal on $flatten\u_fault_arbiter.$procdff$1141 ($adff) from module pmic_top (D = $flatten\u_fault_arbiter.$0\fault_shifter_RUN[15:0], Q = \u_fault_arbiter.fault_shifter_RUN).

4.10.7. Executing OPT_CLEAN pass (remove unused cells and wires).
Finding unused cells or wires in module \pmic_top..
Removed 9 unused cells and 17 unused wires.
<suppressed ~11 debug messages>

4.10.8. Executing OPT_EXPR pass (perform const folding).
Optimizing module pmic_top.
<suppressed ~7 debug messages>

4.10.9. Rerunning OPT passes. (Maybe there is more to do..)

4.10.10. Executing OPT_MUXTREE pass (detect dead branches in mux trees).
Running muxtree optimizer on module \pmic_top..
  Creating internal representation of mux trees.
  Evaluating internal representation of mux trees.
  Analyzing evaluation results.
Removed 0 multiplexer ports.
<suppressed ~80 debug messages>

4.10.11. Executing OPT_REDUCE pass (consolidate $*mux and $reduce_* inputs).
  Optimizing cells in module \pmic_top.
Performed a total of 0 changes.

4.10.12. Executing OPT_MERGE pass (detect identical cells).
Finding identical cells in module `\pmic_top'.
Computing hashes of 290 cells of `\pmic_top'.
Finding duplicate cells in `\pmic_top'.
Computing hashes of 283 cells of `\pmic_top'.
Finding duplicate cells in `\pmic_top'.
Computing hashes of 281 cells of `\pmic_top'.
Finding duplicate cells in `\pmic_top'.
<suppressed ~27 debug messages>
Removed a total of 9 cells.

4.10.13. Executing OPT_DFF pass (perform DFF optimizations).

4.10.14. Executing OPT_CLEAN pass (remove unused cells and wires).
Finding unused cells or wires in module \pmic_top..
Removed 0 unused cells and 9 unused wires.
<suppressed ~1 debug messages>

4.10.15. Executing OPT_EXPR pass (perform const folding).
Optimizing module pmic_top.

4.10.16. Rerunning OPT passes. (Maybe there is more to do..)

4.10.17. Executing OPT_MUXTREE pass (detect dead branches in mux trees).
Running muxtree optimizer on module \pmic_top..
  Creating internal representation of mux trees.
  Evaluating internal representation of mux trees.
  Analyzing evaluation results.
Removed 0 multiplexer ports.
<suppressed ~80 debug messages>

4.10.18. Executing OPT_REDUCE pass (consolidate $*mux and $reduce_* inputs).
  Optimizing cells in module \pmic_top.
Performed a total of 0 changes.

4.10.19. Executing OPT_MERGE pass (detect identical cells).
Finding identical cells in module `\pmic_top'.
Computing hashes of 281 cells of `\pmic_top'.
Finding duplicate cells in `\pmic_top'.
Removed a total of 0 cells.

4.10.20. Executing OPT_DFF pass (perform DFF optimizations).

4.10.21. Executing OPT_CLEAN pass (remove unused cells and wires).
Finding unused cells or wires in module \pmic_top..

4.10.22. Executing OPT_EXPR pass (perform const folding).
Optimizing module pmic_top.

4.10.23. Finished fast OPT passes. (There is nothing left to do.)

4.11. Executing WREDUCE pass (reducing word size of cells).
Removed top 1 bits (of 2) from port B of cell pmic_top.$auto$simple.cc:200:make_patterns_logic$1385 ($ne).
Removed top 1 bits (of 2) from port B of cell pmic_top.$auto$simple.cc:200:make_patterns_logic$1392 ($ne).
Removed top 1 bits (of 2) from port B of cell pmic_top.$auto$simple.cc:200:make_patterns_logic$1400 ($ne).
Removed top 1 bits (of 2) from port B of cell pmic_top.$auto$simple.cc:200:make_patterns_logic$1411 ($ne).
Removed top 1 bits (of 2) from port B of cell pmic_top.$auto$simple.cc:200:make_patterns_logic$1416 ($ne).
Removed top 1 bits (of 2) from port B of cell pmic_top.$auto$simple.cc:200:make_patterns_logic$1422 ($ne).
Removed top 1 bits (of 2) from port B of cell pmic_top.$auto$simple.cc:200:make_patterns_logic$1425 ($ne).
Removed top 2 bits (of 3) from port B of cell pmic_top.$auto$simple.cc:200:make_patterns_logic$1427 ($ne).
Removed top 2 bits (of 3) from port B of cell pmic_top.$auto$simple.cc:200:make_patterns_logic$1429 ($ne).
Removed top 1 bits (of 2) from port B of cell pmic_top.$auto$simple.cc:200:make_patterns_logic$1454 ($ne).
Removed top 1 bits (of 2) from port B of cell pmic_top.$auto$simple.cc:200:make_patterns_logic$1464 ($ne).
Removed top 31 bits (of 32) from port B of cell pmic_top.$flatten\u_en_from_switch_db.$../Build/pmic_full.v:97$add$717 ($add).
Removed top 12 bits (of 32) from port Y of cell pmic_top.$flatten\u_en_from_switch_db.$../Build/pmic_full.v:97$add$717 ($add).
Removed top 31 bits (of 32) from port B of cell pmic_top.$flatten\u_OTP_sync_db.$../Build/pmic_full.v:97$add$18 ($add).
Removed top 16 bits (of 32) from port Y of cell pmic_top.$flatten\u_OTP_sync_db.$../Build/pmic_full.v:97$add$18 ($add).
Removed top 31 bits (of 32) from port B of cell pmic_top.$flatten\u_UVLO_sync_db.$../Build/pmic_full.v:97$add$18 ($add).
Removed top 16 bits (of 32) from port Y of cell pmic_top.$flatten\u_UVLO_sync_db.$../Build/pmic_full.v:97$add$18 ($add).
Removed top 31 bits (of 32) from port B of cell pmic_top.$flatten\u_latch_stat_sync_db.$../Build/pmic_full.v:97$add$18 ($add).
Removed top 16 bits (of 32) from port Y of cell pmic_top.$flatten\u_latch_stat_sync_db.$../Build/pmic_full.v:97$add$18 ($add).
Removed top 1 bits (of 6) from port B of cell pmic_top.$flatten\u_fault_arbiter.$../Build/pmic_full.v:364$ge$143 ($ge).
Removed top 1 bits (of 6) from port A of cell pmic_top.$flatten\u_fault_arbiter.$../Build/pmic_full.v:359$ge$140 ($ge).
Removed top 2 bits (of 6) from port B of cell pmic_top.$flatten\u_fault_arbiter.$../Build/pmic_full.v:359$ge$140 ($ge).
Removed top 31 bits (of 32) from port B of cell pmic_top.$flatten\u_fault_arbiter.$../Build/pmic_full.v:344$or$133 ($or).
Removed top 5 bits (of 6) from port B of cell pmic_top.$flatten\u_fault_arbiter.$../Build/pmic_full.v:343$sub$131 ($sub).
Removed top 5 bits (of 6) from port B of cell pmic_top.$flatten\u_fault_arbiter.$../Build/pmic_full.v:343$add$130 ($add).
Removed top 15 bits (of 16) from port B of cell pmic_top.$flatten\u_fault_arbiter.$../Build/pmic_full.v:340$or$122 ($or).
Removed top 4 bits (of 5) from port B of cell pmic_top.$flatten\u_fault_arbiter.$../Build/pmic_full.v:339$sub$120 ($sub).
Removed top 4 bits (of 5) from port B of cell pmic_top.$flatten\u_fault_arbiter.$../Build/pmic_full.v:339$add$119 ($add).
Removed top 4 bits (of 5) from port B of cell pmic_top.$flatten\u_fault_arbiter.$../Build/pmic_full.v:314$or$79 ($or).
Removed top 31 bits (of 32) from port B of cell pmic_top.$flatten\u_hiccup_timer.$../Build/pmic_full.v:432$add$158 ($add).
Removed top 10 bits (of 32) from port Y of cell pmic_top.$flatten\u_hiccup_timer.$../Build/pmic_full.v:432$add$158 ($add).
Removed top 4 bits (of 22) from port A of cell pmic_top.$flatten\u_hiccup_timer.$../Build/pmic_full.v:416$shl$153 ($shl).
Removed top 31 bits (of 32) from port B of cell pmic_top.$flatten\u_strike_counter.$../Build/pmic_full.v:513$add$179 ($add).
Removed top 13 bits (of 32) from port Y of cell pmic_top.$flatten\u_strike_counter.$../Build/pmic_full.v:513$add$179 ($add).
Removed top 31 bits (of 32) from port B of cell pmic_top.$flatten\u_strike_counter.$../Build/pmic_full.v:498$add$170 ($add).
Removed top 30 bits (of 32) from port Y of cell pmic_top.$flatten\u_strike_counter.$../Build/pmic_full.v:498$add$170 ($add).
Removed top 31 bits (of 32) from port B of cell pmic_top.$flatten\u_soft_start.$../Build/pmic_full.v:185$add$43 ($add).
Removed top 24 bits (of 32) from port Y of cell pmic_top.$flatten\u_soft_start.$../Build/pmic_full.v:185$add$43 ($add).
Removed top 3 bits (of 7) from port B of cell pmic_top.$flatten\u_soft_start.$../Build/pmic_full.v:183$eq$40 ($eq).
Removed top 31 bits (of 32) from port B of cell pmic_top.$flatten\u_soft_start.$../Build/pmic_full.v:177$add$37 ($add).
Removed top 25 bits (of 32) from port Y of cell pmic_top.$flatten\u_soft_start.$../Build/pmic_full.v:177$add$37 ($add).
Removed top 31 bits (of 32) from port B of cell pmic_top.$flatten\u_pwm_mask.$../Build/pmic_full.v:232$add$50 ($add).
Removed top 25 bits (of 32) from port Y of cell pmic_top.$flatten\u_pwm_mask.$../Build/pmic_full.v:232$add$50 ($add).
Removed top 31 bits (of 32) from port B of cell pmic_top.$flatten\u_pgood_gen.$../Build/pmic_full.v:570$add$194 ($add).
Removed top 20 bits (of 32) from port Y of cell pmic_top.$flatten\u_pgood_gen.$../Build/pmic_full.v:570$add$194 ($add).
Removed top 24 bits (of 32) from wire pmic_top.$flatten\u_soft_start.$../Build/pmic_full.v:184$add$42_Y.
Removed top 25 bits (of 32) from wire pmic_top.$flatten\u_soft_start.$../Build/pmic_full.v:177$add$37_Y.
Removed top 10 bits (of 32) from wire pmic_top.$flatten\u_hiccup_timer.$../Build/pmic_full.v:432$add$158_Y.
Removed top 16 bits (of 32) from wire pmic_top.$flatten\u_latch_stat_sync_db.$../Build/pmic_full.v:97$add$18_Y.
Removed top 16 bits (of 32) from wire pmic_top.$flatten\u_UVLO_sync_db.$../Build/pmic_full.v:97$add$18_Y.
Removed top 25 bits (of 32) from wire pmic_top.$flatten\u_pwm_mask.$../Build/pmic_full.v:232$add$50_Y.
Removed top 16 bits (of 32) from wire pmic_top.$flatten\u_OTP_sync_db.$../Build/pmic_full.v:97$add$18_Y.
Removed top 12 bits (of 32) from wire pmic_top.$flatten\u_en_from_switch_db.$../Build/pmic_full.v:97$add$717_Y.
Removed top 20 bits (of 32) from wire pmic_top.$flatten\u_pgood_gen.$../Build/pmic_full.v:570$add$194_Y.
Removed top 13 bits (of 32) from wire pmic_top.$flatten\u_strike_counter.$../Build/pmic_full.v:513$add$179_Y.
Removed top 30 bits (of 32) from wire pmic_top.$flatten\u_strike_counter.$../Build/pmic_full.v:498$add$170_Y.

4.12. Executing PEEPOPT pass (run peephole optimizers).

4.13. Executing OPT_CLEAN pass (remove unused cells and wires).
Finding unused cells or wires in module \pmic_top..
Removed 0 unused cells and 11 unused wires.
<suppressed ~1 debug messages>

4.14. Executing ALUMACC pass (create $alu and $macc cells).
Extracting $alu and $macc cells in module pmic_top:
  creating $macc model for $flatten\u_soft_start.$../Build/pmic_full.v:177$add$37 ($add).
  creating $macc model for $flatten\u_fault_LED.$../Build/pmic_full.v:675$add$216 ($add).
  creating $macc model for $flatten\u_pwm_mask.$../Build/pmic_full.v:232$add$50 ($add).
  creating $macc model for $flatten\u_fault_arbiter.$../Build/pmic_full.v:339$add$119 ($add).
  creating $macc model for $flatten\u_fault_arbiter.$../Build/pmic_full.v:339$sub$120 ($sub).
  creating $macc model for $flatten\u_fault_arbiter.$../Build/pmic_full.v:343$add$130 ($add).
  creating $macc model for $flatten\u_fault_arbiter.$../Build/pmic_full.v:343$sub$131 ($sub).
  creating $macc model for $flatten\u_soft_start.$../Build/pmic_full.v:185$add$43 ($add).
  creating $macc model for $flatten\u_latch_stat_sync_db.$../Build/pmic_full.v:96$sub$16 ($sub).
  creating $macc model for $flatten\u_latch_stat_sync_db.$../Build/pmic_full.v:97$add$18 ($add).
  creating $macc model for $flatten\u_pgood_gen.$../Build/pmic_full.v:570$add$194 ($add).
  creating $macc model for $flatten\u_strike_counter.$../Build/pmic_full.v:513$add$179 ($add).
  creating $macc model for $flatten\u_UVLO_sync_db.$../Build/pmic_full.v:96$sub$16 ($sub).
  creating $macc model for $flatten\u_UVLO_sync_db.$../Build/pmic_full.v:97$add$18 ($add).
  creating $macc model for $flatten\u_OTP_sync_db.$../Build/pmic_full.v:96$sub$16 ($sub).
  creating $macc model for $flatten\u_OTP_sync_db.$../Build/pmic_full.v:97$add$18 ($add).
  creating $macc model for $flatten\u_en_from_switch_db.$../Build/pmic_full.v:97$add$717 ($add).
  creating $macc model for $flatten\u_strike_counter.$../Build/pmic_full.v:498$add$170 ($add).
  creating $macc model for $flatten\u_hiccup_timer.$../Build/pmic_full.v:432$add$158 ($add).
  merging $macc model for $flatten\u_fault_arbiter.$../Build/pmic_full.v:343$add$130 into $flatten\u_fault_arbiter.$../Build/pmic_full.v:343$sub$131.
  merging $macc model for $flatten\u_fault_arbiter.$../Build/pmic_full.v:339$add$119 into $flatten\u_fault_arbiter.$../Build/pmic_full.v:339$sub$120.
  creating $alu model for $macc $flatten\u_en_from_switch_db.$../Build/pmic_full.v:97$add$717.
  creating $alu model for $macc $flatten\u_OTP_sync_db.$../Build/pmic_full.v:97$add$18.
  creating $alu model for $macc $flatten\u_OTP_sync_db.$../Build/pmic_full.v:96$sub$16.
  creating $alu model for $macc $flatten\u_UVLO_sync_db.$../Build/pmic_full.v:97$add$18.
  creating $alu model for $macc $flatten\u_UVLO_sync_db.$../Build/pmic_full.v:96$sub$16.
  creating $alu model for $macc $flatten\u_strike_counter.$../Build/pmic_full.v:513$add$179.
  creating $alu model for $macc $flatten\u_pgood_gen.$../Build/pmic_full.v:570$add$194.
  creating $alu model for $macc $flatten\u_latch_stat_sync_db.$../Build/pmic_full.v:97$add$18.
  creating $alu model for $macc $flatten\u_latch_stat_sync_db.$../Build/pmic_full.v:96$sub$16.
  creating $alu model for $macc $flatten\u_soft_start.$../Build/pmic_full.v:185$add$43.
  creating $alu model for $macc $flatten\u_strike_counter.$../Build/pmic_full.v:498$add$170.
  creating $alu model for $macc $flatten\u_hiccup_timer.$../Build/pmic_full.v:432$add$158.
  creating $alu model for $macc $flatten\u_pwm_mask.$../Build/pmic_full.v:232$add$50.
  creating $alu model for $macc $flatten\u_fault_LED.$../Build/pmic_full.v:675$add$216.
  creating $alu model for $macc $flatten\u_soft_start.$../Build/pmic_full.v:177$add$37.
  creating $macc cell for $flatten\u_fault_arbiter.$../Build/pmic_full.v:343$sub$131: $auto$alumacc.cc:427:replace_macc$1487
  creating $macc cell for $flatten\u_fault_arbiter.$../Build/pmic_full.v:339$sub$120: $auto$alumacc.cc:427:replace_macc$1488
  creating $alu model for $flatten\u_soft_start.$../Build/pmic_full.v:179$ge$38 ($ge): new $alu
  creating $alu model for $flatten\u_pwm_mask.$../Build/pmic_full.v:231$lt$49 ($lt): new $alu
  creating $alu model for $flatten\u_fault_arbiter.$../Build/pmic_full.v:359$ge$140 ($ge): new $alu
  creating $alu model for $flatten\u_fault_arbiter.$../Build/pmic_full.v:364$ge$143 ($ge): new $alu
  creating $alu model for $flatten\u_latch_stat_sync_db.$../Build/pmic_full.v:96$lt$17 ($lt): new $alu
  creating $alu model for $flatten\u_latch_stat_sync_db.$../Build/pmic_full.v:104$ge$23 ($ge): merged with $flatten\u_latch_stat_sync_db.$../Build/pmic_full.v:96$lt$17.
  creating $alu model for $flatten\u_UVLO_sync_db.$../Build/pmic_full.v:96$lt$17 ($lt): new $alu
  creating $alu model for $flatten\u_UVLO_sync_db.$../Build/pmic_full.v:104$ge$23 ($ge): merged with $flatten\u_UVLO_sync_db.$../Build/pmic_full.v:96$lt$17.
  creating $alu model for $flatten\u_OTP_sync_db.$../Build/pmic_full.v:96$lt$17 ($lt): new $alu
  creating $alu model for $flatten\u_OTP_sync_db.$../Build/pmic_full.v:104$ge$23 ($ge): merged with $flatten\u_OTP_sync_db.$../Build/pmic_full.v:96$lt$17.
  creating $alu model for $flatten\u_en_from_switch_db.$../Build/pmic_full.v:96$lt$716 ($lt): new $alu
  creating $alu model for $flatten\u_en_from_switch_db.$../Build/pmic_full.v:104$ge$722 ($ge): merged with $flatten\u_en_from_switch_db.$../Build/pmic_full.v:96$lt$716.
  creating $alu model for $flatten\u_strike_counter.$../Build/pmic_full.v:499$ge$172 ($ge): new $alu
  creating $alu cell for $flatten\u_strike_counter.$../Build/pmic_full.v:499$ge$172: $auto$alumacc.cc:578:replace_alu$1498
  creating $alu cell for $flatten\u_en_from_switch_db.$../Build/pmic_full.v:96$lt$716, $flatten\u_en_from_switch_db.$../Build/pmic_full.v:104$ge$722: $auto$alumacc.cc:578:replace_alu$1511
  creating $alu cell for $flatten\u_OTP_sync_db.$../Build/pmic_full.v:96$lt$17, $flatten\u_OTP_sync_db.$../Build/pmic_full.v:104$ge$23: $auto$alumacc.cc:578:replace_alu$1524
  creating $alu cell for $flatten\u_UVLO_sync_db.$../Build/pmic_full.v:96$lt$17, $flatten\u_UVLO_sync_db.$../Build/pmic_full.v:104$ge$23: $auto$alumacc.cc:578:replace_alu$1537
  creating $alu cell for $flatten\u_latch_stat_sync_db.$../Build/pmic_full.v:96$lt$17, $flatten\u_latch_stat_sync_db.$../Build/pmic_full.v:104$ge$23: $auto$alumacc.cc:578:replace_alu$1550
  creating $alu cell for $flatten\u_fault_arbiter.$../Build/pmic_full.v:364$ge$143: $auto$alumacc.cc:578:replace_alu$1563
  creating $alu cell for $flatten\u_fault_arbiter.$../Build/pmic_full.v:359$ge$140: $auto$alumacc.cc:578:replace_alu$1576
  creating $alu cell for $flatten\u_pwm_mask.$../Build/pmic_full.v:231$lt$49: $auto$alumacc.cc:578:replace_alu$1589
  creating $alu cell for $flatten\u_soft_start.$../Build/pmic_full.v:179$ge$38: $auto$alumacc.cc:578:replace_alu$1594
  creating $alu cell for $flatten\u_soft_start.$../Build/pmic_full.v:177$add$37: $auto$alumacc.cc:578:replace_alu$1607
  creating $alu cell for $flatten\u_fault_LED.$../Build/pmic_full.v:675$add$216: $auto$alumacc.cc:578:replace_alu$1610
  creating $alu cell for $flatten\u_pwm_mask.$../Build/pmic_full.v:232$add$50: $auto$alumacc.cc:578:replace_alu$1613
  creating $alu cell for $flatten\u_hiccup_timer.$../Build/pmic_full.v:432$add$158: $auto$alumacc.cc:578:replace_alu$1616
  creating $alu cell for $flatten\u_strike_counter.$../Build/pmic_full.v:498$add$170: $auto$alumacc.cc:578:replace_alu$1619
  creating $alu cell for $flatten\u_soft_start.$../Build/pmic_full.v:185$add$43: $auto$alumacc.cc:578:replace_alu$1622
  creating $alu cell for $flatten\u_latch_stat_sync_db.$../Build/pmic_full.v:96$sub$16: $auto$alumacc.cc:578:replace_alu$1625
  creating $alu cell for $flatten\u_latch_stat_sync_db.$../Build/pmic_full.v:97$add$18: $auto$alumacc.cc:578:replace_alu$1628
  creating $alu cell for $flatten\u_pgood_gen.$../Build/pmic_full.v:570$add$194: $auto$alumacc.cc:578:replace_alu$1631
  creating $alu cell for $flatten\u_strike_counter.$../Build/pmic_full.v:513$add$179: $auto$alumacc.cc:578:replace_alu$1634
  creating $alu cell for $flatten\u_UVLO_sync_db.$../Build/pmic_full.v:96$sub$16: $auto$alumacc.cc:578:replace_alu$1637
  creating $alu cell for $flatten\u_UVLO_sync_db.$../Build/pmic_full.v:97$add$18: $auto$alumacc.cc:578:replace_alu$1640
  creating $alu cell for $flatten\u_OTP_sync_db.$../Build/pmic_full.v:96$sub$16: $auto$alumacc.cc:578:replace_alu$1643
  creating $alu cell for $flatten\u_OTP_sync_db.$../Build/pmic_full.v:97$add$18: $auto$alumacc.cc:578:replace_alu$1646
  creating $alu cell for $flatten\u_en_from_switch_db.$../Build/pmic_full.v:97$add$717: $auto$alumacc.cc:578:replace_alu$1649
  created 24 $alu and 2 $macc cells.

4.15. Executing SHARE pass (SAT-based resource sharing).

4.16. Executing OPT pass (performing simple optimizations).

4.16.1. Executing OPT_EXPR pass (perform const folding).
Optimizing module pmic_top.
<suppressed ~6 debug messages>

4.16.2. Executing OPT_MERGE pass (detect identical cells).
Finding identical cells in module `\pmic_top'.
Computing hashes of 318 cells of `\pmic_top'.
Finding duplicate cells in `\pmic_top'.
Removed a total of 0 cells.

4.16.3. Executing OPT_MUXTREE pass (detect dead branches in mux trees).
Running muxtree optimizer on module \pmic_top..
  Creating internal representation of mux trees.
  Evaluating internal representation of mux trees.
  Analyzing evaluation results.
Removed 0 multiplexer ports.
<suppressed ~80 debug messages>

4.16.4. Executing OPT_REDUCE pass (consolidate $*mux and $reduce_* inputs).
  Optimizing cells in module \pmic_top.
Performed a total of 0 changes.

4.16.5. Executing OPT_MERGE pass (detect identical cells).
Finding identical cells in module `\pmic_top'.
Computing hashes of 318 cells of `\pmic_top'.
Finding duplicate cells in `\pmic_top'.
Removed a total of 0 cells.

4.16.6. Executing OPT_DFF pass (perform DFF optimizations).

4.16.7. Executing OPT_CLEAN pass (remove unused cells and wires).
Finding unused cells or wires in module \pmic_top..
Removed 2 unused cells and 15 unused wires.
<suppressed ~3 debug messages>

4.16.8. Executing OPT_EXPR pass (perform const folding).
Optimizing module pmic_top.

4.16.9. Rerunning OPT passes. (Maybe there is more to do..)

4.16.10. Executing OPT_MUXTREE pass (detect dead branches in mux trees).
Running muxtree optimizer on module \pmic_top..
  Creating internal representation of mux trees.
  Evaluating internal representation of mux trees.
  Analyzing evaluation results.
Removed 0 multiplexer ports.
<suppressed ~80 debug messages>

4.16.11. Executing OPT_REDUCE pass (consolidate $*mux and $reduce_* inputs).
  Optimizing cells in module \pmic_top.
Performed a total of 0 changes.

4.16.12. Executing OPT_MERGE pass (detect identical cells).
Finding identical cells in module `\pmic_top'.
Computing hashes of 316 cells of `\pmic_top'.
Finding duplicate cells in `\pmic_top'.
Removed a total of 0 cells.

4.16.13. Executing OPT_DFF pass (perform DFF optimizations).

4.16.14. Executing OPT_CLEAN pass (remove unused cells and wires).
Finding unused cells or wires in module \pmic_top..

4.16.15. Executing OPT_EXPR pass (perform const folding).
Optimizing module pmic_top.

4.16.16. Finished fast OPT passes. (There is nothing left to do.)

4.17. Executing MEMORY pass.

4.17.1. Executing OPT_MEM pass (optimize memories).
Performed a total of 0 transformations.

4.17.2. Executing OPT_MEM_PRIORITY pass (removing unnecessary memory write priority relations).
Performed a total of 0 transformations.

4.17.3. Executing OPT_MEM_FEEDBACK pass (finding memory read-to-write feedback paths).

4.17.4. Executing MEMORY_BMUX2ROM pass (converting muxes to ROMs).

4.17.5. Executing MEMORY_DFF pass (merging $dff cells to $memrd).

4.17.6. Executing OPT_CLEAN pass (remove unused cells and wires).
Finding unused cells or wires in module \pmic_top..

4.17.7. Executing MEMORY_SHARE pass (consolidating $memrd/$memwr cells).

4.17.8. Executing OPT_MEM_WIDEN pass (optimize memories where all ports are wide).
Performed a total of 0 transformations.

4.17.9. Executing OPT_CLEAN pass (remove unused cells and wires).
Finding unused cells or wires in module \pmic_top..

4.17.10. Executing MEMORY_COLLECT pass (generating $mem cells).

4.18. Executing OPT_CLEAN pass (remove unused cells and wires).
Finding unused cells or wires in module \pmic_top..

4.19. Executing OPT pass (performing simple optimizations).

4.19.1. Executing OPT_EXPR pass (perform const folding).
Optimizing module pmic_top.
<suppressed ~34 debug messages>

4.19.2. Executing OPT_MERGE pass (detect identical cells).
Finding identical cells in module `\pmic_top'.
Computing hashes of 294 cells of `\pmic_top'.
Finding duplicate cells in `\pmic_top'.
Computing hashes of 293 cells of `\pmic_top'.
Finding duplicate cells in `\pmic_top'.
<suppressed ~3 debug messages>
Removed a total of 1 cells.

4.19.3. Executing OPT_DFF pass (perform DFF optimizations).

4.19.4. Executing OPT_CLEAN pass (remove unused cells and wires).
Finding unused cells or wires in module \pmic_top..
Removed 1 unused cells and 34 unused wires.
<suppressed ~2 debug messages>

4.19.5. Finished fast OPT passes.

4.20. Executing MEMORY_MAP pass (converting memories to logic and flip-flops).

4.21. Executing OPT pass (performing simple optimizations).

4.21.1. Executing OPT_EXPR pass (perform const folding).
Optimizing module pmic_top.
<suppressed ~1 debug messages>

4.21.2. Executing OPT_MERGE pass (detect identical cells).
Finding identical cells in module `\pmic_top'.
Computing hashes of 291 cells of `\pmic_top'.
Finding duplicate cells in `\pmic_top'.
Removed a total of 0 cells.

4.21.3. Executing OPT_MUXTREE pass (detect dead branches in mux trees).
Running muxtree optimizer on module \pmic_top..
  Creating internal representation of mux trees.
  Evaluating internal representation of mux trees.
  Analyzing evaluation results.
Removed 0 multiplexer ports.
<suppressed ~45 debug messages>

4.21.4. Executing OPT_REDUCE pass (consolidate $*mux and $reduce_* inputs).
  Optimizing cells in module \pmic_top.
    Consolidated identical input bits for $mux cell $flatten\u_latch_stat_sync_db.$../Build/pmic_full.v:90$ternary$12:
      Old ports: A=16'0010011100010000, B=16'1100001101010000, Y=\u_latch_stat_sync_db.target_clks
      New ports: A=2'10, B=2'01, Y={ \u_latch_stat_sync_db.target_clks [10] \u_latch_stat_sync_db.target_clks [6] }
      New connections: { \u_latch_stat_sync_db.target_clks [15:11] \u_latch_stat_sync_db.target_clks [9:7] \u_latch_stat_sync_db.target_clks [5:0] } = { \u_latch_stat_sync_db.target_clks [6] \u_latch_stat_sync_db.target_clks [6] \u_latch_stat_sync_db.target_clks [10] 11'00110010000 }
    Consolidated identical input bits for $mux cell $flatten\u_UVLO_sync_db.$../Build/pmic_full.v:90$ternary$12:
      Old ports: A=16'0010011100010000, B=16'1100001101010000, Y=\u_UVLO_sync_db.target_clks
      New ports: A=2'10, B=2'01, Y={ \u_UVLO_sync_db.target_clks [10] \u_UVLO_sync_db.target_clks [6] }
      New connections: { \u_UVLO_sync_db.target_clks [15:11] \u_UVLO_sync_db.target_clks [9:7] \u_UVLO_sync_db.target_clks [5:0] } = { \u_UVLO_sync_db.target_clks [6] \u_UVLO_sync_db.target_clks [6] \u_UVLO_sync_db.target_clks [10] 11'00110010000 }
    Consolidated identical input bits for $mux cell $flatten\u_OTP_sync_db.$../Build/pmic_full.v:90$ternary$12:
      Old ports: A=16'0010011100010000, B=16'1100001101010000, Y=\u_OTP_sync_db.target_clks
      New ports: A=2'10, B=2'01, Y={ \u_OTP_sync_db.target_clks [10] \u_OTP_sync_db.target_clks [6] }
      New connections: { \u_OTP_sync_db.target_clks [15:11] \u_OTP_sync_db.target_clks [9:7] \u_OTP_sync_db.target_clks [5:0] } = { \u_OTP_sync_db.target_clks [6] \u_OTP_sync_db.target_clks [6] \u_OTP_sync_db.target_clks [10] 11'00110010000 }
  Optimizing cells in module \pmic_top.
Performed a total of 3 changes.

4.21.5. Executing OPT_MERGE pass (detect identical cells).
Finding identical cells in module `\pmic_top'.
Computing hashes of 291 cells of `\pmic_top'.
Finding duplicate cells in `\pmic_top'.
Removed a total of 0 cells.

4.21.6. Executing OPT_SHARE pass.

4.21.7. Executing OPT_DFF pass (perform DFF optimizations).

4.21.8. Executing OPT_CLEAN pass (remove unused cells and wires).
Finding unused cells or wires in module \pmic_top..
Removed 0 unused cells and 1 unused wires.
<suppressed ~1 debug messages>

4.21.9. Executing OPT_EXPR pass (perform const folding).
Optimizing module pmic_top.
<suppressed ~87 debug messages>

4.21.10. Rerunning OPT passes. (Maybe there is more to do..)

4.21.11. Executing OPT_MUXTREE pass (detect dead branches in mux trees).
Running muxtree optimizer on module \pmic_top..
  Creating internal representation of mux trees.
  Evaluating internal representation of mux trees.
  Analyzing evaluation results.
Removed 0 multiplexer ports.
<suppressed ~45 debug messages>

4.21.12. Executing OPT_REDUCE pass (consolidate $*mux and $reduce_* inputs).
  Optimizing cells in module \pmic_top.
Performed a total of 0 changes.

4.21.13. Executing OPT_MERGE pass (detect identical cells).
Finding identical cells in module `\pmic_top'.
Computing hashes of 309 cells of `\pmic_top'.
Finding duplicate cells in `\pmic_top'.
Computing hashes of 296 cells of `\pmic_top'.
Finding duplicate cells in `\pmic_top'.
<suppressed ~47 debug messages>
Removed a total of 13 cells.

4.21.14. Executing OPT_SHARE pass.

4.21.15. Executing OPT_DFF pass (perform DFF optimizations).

4.21.16. Executing OPT_CLEAN pass (remove unused cells and wires).
Finding unused cells or wires in module \pmic_top..
Removed 6 unused cells and 77 unused wires.
<suppressed ~7 debug messages>

4.21.17. Executing OPT_EXPR pass (perform const folding).
Optimizing module pmic_top.

4.21.18. Rerunning OPT passes. (Maybe there is more to do..)

4.21.19. Executing OPT_MUXTREE pass (detect dead branches in mux trees).
Running muxtree optimizer on module \pmic_top..
  Creating internal representation of mux trees.
  Evaluating internal representation of mux trees.
  Analyzing evaluation results.
Removed 0 multiplexer ports.
<suppressed ~45 debug messages>

4.21.20. Executing OPT_REDUCE pass (consolidate $*mux and $reduce_* inputs).
  Optimizing cells in module \pmic_top.
Performed a total of 0 changes.

4.21.21. Executing OPT_MERGE pass (detect identical cells).
Finding identical cells in module `\pmic_top'.
Computing hashes of 290 cells of `\pmic_top'.
Finding duplicate cells in `\pmic_top'.
Removed a total of 0 cells.

4.21.22. Executing OPT_SHARE pass.

4.21.23. Executing OPT_DFF pass (perform DFF optimizations).

4.21.24. Executing OPT_CLEAN pass (remove unused cells and wires).
Finding unused cells or wires in module \pmic_top..

4.21.25. Executing OPT_EXPR pass (perform const folding).
Optimizing module pmic_top.

4.21.26. Finished fast OPT passes. (There is nothing left to do.)

4.22. Executing TECHMAP pass (map to technology primitives).

4.22.1. Executing Verilog-2005 frontend: /home/hrishikesh/oss-cad-suite/lib/../share/yosys/techmap.v
Parsing Verilog input from `/home/hrishikesh/oss-cad-suite/lib/../share/yosys/techmap.v' to AST representation.
Generating RTLIL representation for module `\_90_simplemap_bool_ops'.
Generating RTLIL representation for module `\_90_simplemap_reduce_ops'.
Generating RTLIL representation for module `\_90_simplemap_logic_ops'.
Generating RTLIL representation for module `\_90_simplemap_compare_ops'.
Generating RTLIL representation for module `\_90_simplemap_various'.
Generating RTLIL representation for module `\_90_simplemap_registers'.
Generating RTLIL representation for module `\_90_shift_ops_shr_shl_sshl_sshr'.
Generating RTLIL representation for module `\_90_shift_shiftx'.
Generating RTLIL representation for module `\_90_fa'.
Generating RTLIL representation for module `\_90_lcu_brent_kung'.
Generating RTLIL representation for module `\_90_alu'.
Generating RTLIL representation for module `\_90_macc'.
Generating RTLIL representation for module `\_90_alumacc'.
Generating RTLIL representation for module `$__div_mod_u'.
Generating RTLIL representation for module `$__div_mod_trunc'.
Generating RTLIL representation for module `\_90_div'.
Generating RTLIL representation for module `\_90_mod'.
Generating RTLIL representation for module `$__div_mod_floor'.
Generating RTLIL representation for module `\_90_divfloor'.
Generating RTLIL representation for module `\_90_modfloor'.
Generating RTLIL representation for module `\_90_pow'.
Generating RTLIL representation for module `\_90_demux'.
Generating RTLIL representation for module `\_90_lut'.
Generating RTLIL representation for module `$connect'.
Generating RTLIL representation for module `$input_port'.
Successfully finished Verilog frontend.

4.22.2. Continuing TECHMAP pass.
Using extmapper simplemap for cells of type $reduce_or.
Using extmapper simplemap for cells of type $adffe.
Using extmapper simplemap for cells of type $ne.
Using extmapper simplemap for cells of type $adff.
Using extmapper simplemap for cells of type $and.
Using extmapper simplemap for cells of type $not.
Using extmapper simplemap for cells of type $logic_not.
Using extmapper simplemap for cells of type $eq.
Using extmapper simplemap for cells of type $reduce_and.
Using extmapper simplemap for cells of type $reduce_bool.
Using extmapper maccmap for cells of type $macc_v2.
  add \u_fault_arbiter.fault_count_ss (6 bits, unsigned)
  add \u_fault_arbiter.cp_delay [4] (1 bits, unsigned)
  sub \u_fault_arbiter.fault_shifter_SS [31] (1 bits, unsigned)
  packed 1 (1) bits / 1 words into adder tree
  add \u_fault_arbiter.fault_count_run (5 bits, unsigned)
  add \u_fault_arbiter.cp_delay [4] (1 bits, unsigned)
  sub \u_fault_arbiter.fault_shifter_RUN [15] (1 bits, unsigned)
  packed 1 (1) bits / 1 words into adder tree
Using template $paramod$fc972a7a46956c1788f3cb5257b53c8f1df2d0cc\_90_alu for cells of type $alu.
Using extmapper simplemap for cells of type $or.
Using template $paramod$6fc37af1c109ae54e8aed83fcd995c12d378ce93\_90_alu for cells of type $alu.
Using template $paramod$6df0329addda9228fcc2546de2aaf14ad26c98e1\_90_alu for cells of type $alu.
Using template $paramod$f956edc9fe4df758d9fdb10bfc518a364c99e75e\_90_alu for cells of type $alu.
Using template $paramod$2116a631f856d4d4902c2618dca73dafa3b8c9c0\_90_alu for cells of type $alu.
Using template $paramod$dbcdc7e8aa1a4080cea2deda6fdc8772064f4d90\_90_alu for cells of type $alu.
Using template $paramod$103b4016182df467cceab67bcf3e18e6361ec0fd\_90_alu for cells of type $alu.
Using template $paramod$36fdbc18fab0758c8553dda57bd33e3f8f3e8765\_90_alu for cells of type $alu.
Using template $paramod$080e6a70eb8bfa1ccf22d9718e795074645029a4\_90_alu for cells of type $alu.
Using template $paramod$175e67c02b86e96b1288b9dc100122520d7240d8\_90_alu for cells of type $alu.
Using template $paramod$0a77e3c00010cb33e399decd813a7380c6e25cba\_90_alu for cells of type $alu.
Using template $paramod$2af30114e9bd4ccb04dad757b3f0a8f6bf0615b0\_90_alu for cells of type $alu.
Using template $paramod$8f780356cb6cdb52f6a744190131b65634639c4e\_90_alu for cells of type $alu.
Using template $paramod$20b1d0597707d55efcb9664e40f63985956d7680\_90_alu for cells of type $alu.
Using template $paramod$ce0ec84be7047712840b0952f343ee9e63ef75d1\_90_alu for cells of type $alu.
Using extmapper simplemap for cells of type $logic_and.
Using extmapper simplemap for cells of type $mux.
Using template $paramod$constmap:cbe3268444efa971696ca59d671a43e058d331e6$paramod$3100862b887c423498f1ddb2b383c739dd39080f\_90_shift_ops_shr_shl_sshl_sshr for cells of type $shl.
Using extmapper simplemap for cells of type $logic_or.
Using template $paramod\_90_fa\WIDTH=32'00000000000000000000000000000110 for cells of type $fa.
Using template $paramod$00298f3f8094950cb9a5ff2fda48d0d8bde8806c\_90_alu for cells of type $alu.
Using template $paramod\_90_fa\WIDTH=32'00000000000000000000000000000101 for cells of type $fa.
Using template $paramod$b18e16801adf491a64caa0542270798e5d4ac6b6\_90_alu for cells of type $alu.
Using extmapper simplemap for cells of type $xor.
Using template $paramod\_90_fa\WIDTH=32'00000000000000000000000000000001 for cells of type $fa.
Using template $paramod\_90_lcu_brent_kung\WIDTH=32'00000000000000000000000000000001 for cells of type $lcu.
Using extmapper simplemap for cells of type $pos.
Using template $paramod\_90_fa\WIDTH=32'00000000000000000000000000010100 for cells of type $fa.
Using template $paramod\_90_lcu_brent_kung\WIDTH=32'00000000000000000000000000010100 for cells of type $lcu.
Using template $paramod\_90_fa\WIDTH=32'00000000000000000000000000010000 for cells of type $fa.
Using template $paramod\_90_lcu_brent_kung\WIDTH=32'00000000000000000000000000010000 for cells of type $lcu.
Using template $paramod\_90_fa\WIDTH=32'00000000000000000000000000000100 for cells of type $fa.
Using template $paramod\_90_lcu_brent_kung\WIDTH=32'00000000000000000000000000000100 for cells of type $lcu.
Using template $paramod\_90_fa\WIDTH=32'00000000000000000000000000000011 for cells of type $fa.
Using template $paramod\_90_lcu_brent_kung\WIDTH=32'00000000000000000000000000000011 for cells of type $lcu.
Using template $paramod\_90_fa\WIDTH=32'00000000000000000000000000000111 for cells of type $fa.
Using template $paramod\_90_lcu_brent_kung\WIDTH=32'00000000000000000000000000000111 for cells of type $lcu.
Using template $paramod\_90_fa\WIDTH=32'00000000000000000000000000010111 for cells of type $fa.
Using template $paramod\_90_lcu_brent_kung\WIDTH=32'00000000000000000000000000010111 for cells of type $lcu.
Using template $paramod\_90_fa\WIDTH=32'00000000000000000000000000010110 for cells of type $fa.
Using template $paramod\_90_lcu_brent_kung\WIDTH=32'00000000000000000000000000010110 for cells of type $lcu.
Using template $paramod\_90_fa\WIDTH=32'00000000000000000000000000000010 for cells of type $fa.
Using template $paramod\_90_lcu_brent_kung\WIDTH=32'00000000000000000000000000000010 for cells of type $lcu.
Using template $paramod\_90_fa\WIDTH=32'00000000000000000000000000001000 for cells of type $fa.
Using template $paramod\_90_lcu_brent_kung\WIDTH=32'00000000000000000000000000001000 for cells of type $lcu.
Using template $paramod\_90_fa\WIDTH=32'00000000000000000000000000001100 for cells of type $fa.
Using template $paramod\_90_lcu_brent_kung\WIDTH=32'00000000000000000000000000001100 for cells of type $lcu.
Using template $paramod\_90_fa\WIDTH=32'00000000000000000000000000010011 for cells of type $fa.
Using template $paramod\_90_lcu_brent_kung\WIDTH=32'00000000000000000000000000010011 for cells of type $lcu.
Using template $paramod\_90_lcu_brent_kung\WIDTH=32'00000000000000000000000000000110 for cells of type $lcu.
Using template $paramod\_90_lcu_brent_kung\WIDTH=32'00000000000000000000000000000101 for cells of type $lcu.
No more expansions possible.
<suppressed ~3635 debug messages>

4.23. Executing OPT pass (performing simple optimizations).

4.23.1. Executing OPT_EXPR pass (perform const folding).
Optimizing module pmic_top.
<suppressed ~2446 debug messages>

4.23.2. Executing OPT_MERGE pass (detect identical cells).
Finding identical cells in module `\pmic_top'.
Computing hashes of 2085 cells of `\pmic_top'.
Finding duplicate cells in `\pmic_top'.
Computing hashes of 1893 cells of `\pmic_top'.
Finding duplicate cells in `\pmic_top'.
Computing hashes of 1859 cells of `\pmic_top'.
Finding duplicate cells in `\pmic_top'.
Computing hashes of 1844 cells of `\pmic_top'.
Finding duplicate cells in `\pmic_top'.
Computing hashes of 1843 cells of `\pmic_top'.
Finding duplicate cells in `\pmic_top'.
<suppressed ~726 debug messages>
Removed a total of 242 cells.

4.23.3. Executing OPT_DFF pass (perform DFF optimizations).

4.23.4. Executing OPT_CLEAN pass (remove unused cells and wires).
Finding unused cells or wires in module \pmic_top..
Removed 269 unused cells and 1747 unused wires.
<suppressed ~270 debug messages>

4.23.5. Finished fast OPT passes.

4.24. Executing ABC pass (technology mapping using ABC).

4.24.1. Summary of detected clock domains:
  20 cells in clk={ }, en={ }, arst={ }, srst={ }
  11 cells in clk=\clk, en=$auto$simple.cc:216:make_patterns_logic$1387, arst=!\rst_sync.rst_n_exit, srst={ }
  2 cells in clk=\clk, en={ }, arst=!\rst_n_pin, srst={ }
  4 cells in clk=\clk, en=$flatten\u_fault_LED.$../Build/pmic_full.v:670$eq$214_Y, arst=!\rst_sync.rst_n_exit, srst={ }
  5 cells in clk=\clk, en=$auto$simple.cc:199:make_patterns_logic$1391, arst=!\rst_sync.rst_n_exit, srst={ }
  19 cells in clk=\clk, en=$flatten\u_en_from_switch_db.$../Build/pmic_full.v:104$logic_and$723_Y, arst=!\rst_sync.rst_n_exit, srst={ }
  20 cells in clk=\clk, en=$flatten\u_OTP_sync_db.$../Build/pmic_full.v:104$logic_and$24_Y, arst=!\rst_sync.rst_n_exit, srst={ }
  20 cells in clk=\clk, en=$flatten\u_UVLO_sync_db.$../Build/pmic_full.v:104$logic_and$24_Y, arst=!\rst_sync.rst_n_exit, srst={ }
  21 cells in clk=\clk, en=$flatten\u_latch_stat_sync_db.$../Build/pmic_full.v:104$logic_and$24_Y, arst=!\rst_sync.rst_n_exit, srst={ }
  16 cells in clk=\clk, en=$auto$simple.cc:216:make_patterns_logic$1430, arst=!\rst_sync.rst_n_exit, srst={ }
  120 cells in clk=\clk, en=$auto$simple.cc:199:make_patterns_logic$1384, arst=!\rst_sync.rst_n_exit, srst={ }
  116 cells in clk=\clk, en=$auto$simple.cc:199:make_patterns_logic$1394, arst=!\rst_sync.rst_n_exit, srst={ }
  103 cells in clk=\clk, en=$auto$simple.cc:199:make_patterns_logic$1399, arst=!\rst_sync.rst_n_exit, srst={ }
  52 cells in clk=\clk, en=$auto$simple.cc:216:make_patterns_logic$1406, arst=!\rst_sync.rst_n_exit, srst={ }
  103 cells in clk=\clk, en=$auto$simple.cc:199:make_patterns_logic$1410, arst=!\rst_sync.rst_n_exit, srst={ }
  34 cells in clk=\clk, en=$auto$simple.cc:216:make_patterns_logic$1417, arst=!\rst_sync.rst_n_exit, srst={ }
  103 cells in clk=\clk, en=$auto$simple.cc:199:make_patterns_logic$1421, arst=!\rst_sync.rst_n_exit, srst={ }
  76 cells in clk=\clk, en=$auto$simple.cc:199:make_patterns_logic$1440, arst=!\rst_sync.rst_n_exit, srst={ }
  119 cells in clk=\clk, en=$auto$simple.cc:216:make_patterns_logic$1447, arst=!\rst_sync.rst_n_exit, srst={ }
  21 cells in clk=\clk, en=$auto$simple.cc:199:make_patterns_logic$1450, arst=!\rst_sync.rst_n_exit, srst={ }
  52 cells in clk=\clk, en=$auto$simple.cc:199:make_patterns_logic$1453, arst=!\rst_sync.rst_n_exit, srst={ }
  117 cells in clk=\clk, en=$auto$simple.cc:216:make_patterns_logic$1437, arst=!\rst_sync.rst_n_exit, srst={ }
  77 cells in clk=\clk, en=$auto$simple.cc:216:make_patterns_logic$1467, arst=!\rst_sync.rst_n_exit, srst={ }
  343 cells in clk=\clk, en={ }, arst=!\rst_sync.rst_n_exit, srst={ }

4.24.2. Extracting gate netlist of module `\pmic_top' to `<abc-temp-dir>/input.blif'..
No matching clock domain found. Not extracting any FF cells.

4.24.3. Extracting gate netlist of module `\pmic_top' to `<abc-temp-dir>/input.blif'..
Found matching posedge clock domain: \clk, enabled by $auto$simple.cc:216:make_patterns_logic$1387, asynchronously reset by !\rst_sync.rst_n_exit

4.24.3.1. Executed ABC.
Extracted 0 gates and 0 wires to a netlist network with 0 inputs and 0 outputs.
Don't call ABC as there is nothing to map.
Removing temp directory.

4.24.4. Extracting gate netlist of module `\pmic_top' to `<abc-temp-dir>/input.blif'..
Found matching posedge clock domain: \clk, asynchronously reset by !\rst_n_pin

4.24.5. Extracting gate netlist of module `\pmic_top' to `<abc-temp-dir>/input.blif'..
Found matching posedge clock domain: \clk, enabled by $flatten\u_fault_LED.$../Build/pmic_full.v:670$eq$214_Y, asynchronously reset by !\rst_sync.rst_n_exit

4.24.6. Extracting gate netlist of module `\pmic_top' to `<abc-temp-dir>/input.blif'..
Found matching posedge clock domain: \clk, enabled by $auto$simple.cc:199:make_patterns_logic$1391, asynchronously reset by !\rst_sync.rst_n_exit

4.24.7. Extracting gate netlist of module `\pmic_top' to `<abc-temp-dir>/input.blif'..
Found matching posedge clock domain: \clk, enabled by $flatten\u_en_from_switch_db.$../Build/pmic_full.v:104$logic_and$723_Y, asynchronously reset by !\rst_sync.rst_n_exit

4.24.8. Extracting gate netlist of module `\pmic_top' to `<abc-temp-dir>/input.blif'..
Found matching posedge clock domain: \clk, enabled by $flatten\u_OTP_sync_db.$../Build/pmic_full.v:104$logic_and$24_Y, asynchronously reset by !\rst_sync.rst_n_exit

4.24.9. Extracting gate netlist of module `\pmic_top' to `<abc-temp-dir>/input.blif'..
Found matching posedge clock domain: \clk, enabled by $flatten\u_UVLO_sync_db.$../Build/pmic_full.v:104$logic_and$24_Y, asynchronously reset by !\rst_sync.rst_n_exit

4.24.10. Extracting gate netlist of module `\pmic_top' to `<abc-temp-dir>/input.blif'..
Found matching posedge clock domain: \clk, enabled by $flatten\u_latch_stat_sync_db.$../Build/pmic_full.v:104$logic_and$24_Y, asynchronously reset by !\rst_sync.rst_n_exit

4.24.11. Extracting gate netlist of module `\pmic_top' to `<abc-temp-dir>/input.blif'..
Found matching posedge clock domain: \clk, enabled by $auto$simple.cc:216:make_patterns_logic$1430, asynchronously reset by !\rst_sync.rst_n_exit

4.24.12. Extracting gate netlist of module `\pmic_top' to `<abc-temp-dir>/input.blif'..
Found matching posedge clock domain: \clk, enabled by $auto$simple.cc:199:make_patterns_logic$1384, asynchronously reset by !\rst_sync.rst_n_exit

4.24.13. Extracting gate netlist of module `\pmic_top' to `<abc-temp-dir>/input.blif'..
Found matching posedge clock domain: \clk, enabled by $auto$simple.cc:199:make_patterns_logic$1394, asynchronously reset by !\rst_sync.rst_n_exit

4.24.14. Extracting gate netlist of module `\pmic_top' to `<abc-temp-dir>/input.blif'..
Found matching posedge clock domain: \clk, enabled by $auto$simple.cc:199:make_patterns_logic$1399, asynchronously reset by !\rst_sync.rst_n_exit

4.24.15. Extracting gate netlist of module `\pmic_top' to `<abc-temp-dir>/input.blif'..
Found matching posedge clock domain: \clk, enabled by $auto$simple.cc:216:make_patterns_logic$1406, asynchronously reset by !\rst_sync.rst_n_exit

4.24.16. Extracting gate netlist of module `\pmic_top' to `<abc-temp-dir>/input.blif'..
Found matching posedge clock domain: \clk, enabled by $auto$simple.cc:199:make_patterns_logic$1410, asynchronously reset by !\rst_sync.rst_n_exit

4.24.17. Extracting gate netlist of module `\pmic_top' to `<abc-temp-dir>/input.blif'..
Found matching posedge clock domain: \clk, enabled by $auto$simple.cc:216:make_patterns_logic$1417, asynchronously reset by !\rst_sync.rst_n_exit

4.24.18. Extracting gate netlist of module `\pmic_top' to `<abc-temp-dir>/input.blif'..
Found matching posedge clock domain: \clk, enabled by $auto$simple.cc:199:make_patterns_logic$1421, asynchronously reset by !\rst_sync.rst_n_exit

4.24.18.1. Executed ABC.
Extracted 10 gates and 19 wires to a netlist network with 9 inputs and 7 outputs.
Running ABC script: <abc-temp-dir>/abc.script
ABC: UC Berkeley, ABC 1.01 (compiled Oct 27 2026 14:44:30)
ABC: abc 01> empty
ABC: abc 01> source <abc-temp-dir>/abc.script
ABC: + read_blif <abc-temp-dir>/input.blif 
ABC: + read_library <abc-temp-dir>/stdcells.genlib 
ABC: + strash 
ABC: + &get -n 
ABC: + &fraig -x 
ABC: + &put 
ABC: + scorr 
ABC: Warning: The network is combinational (run "fraig" or "fraig_sweep").
ABC: + dc2 
ABC: + dretime 
ABC: + strash 
ABC: + &get -n 
ABC: + &dch -f 
ABC: + &nf 
ABC: + &put 
ABC: + write_blif <abc-temp-dir>/output.blif 
ABC: 
ABC: YOSYS_ABC_DONE 

4.24.18.2. Re-integrating ABC results.
ABC RESULTS:               AND cells:        1
ABC RESULTS:               NOT cells:        1
ABC RESULTS:                OR cells:        5
ABC RESULTS:             ORNOT cells:        1
ABC RESULTS:        internal signals:        3
ABC RESULTS:           input signals:        9
ABC RESULTS:          output signals:        7
Removing temp directory.

4.24.18.1. Executed ABC.
Extracted 0 gates and 0 wires to a netlist network with 0 inputs and 0 outputs.
Don't call ABC as there is nothing to map.
Removing temp directory.

4.24.19. Extracting gate netlist of module `\pmic_top' to `<abc-temp-dir>/input.blif'..
Found matching posedge clock domain: \clk, enabled by $auto$simple.cc:199:make_patterns_logic$1440, asynchronously reset by !\rst_sync.rst_n_exit

4.24.19.1. Executed ABC.
Extracted 3 gates and 6 wires to a netlist network with 3 inputs and 3 outputs.
Running ABC script: <abc-temp-dir>/abc.script
ABC: UC Berkeley, ABC 1.01 (compiled Oct 27 2026 14:44:30)
ABC: abc 01> empty
ABC: abc 01> source <abc-temp-dir>/abc.script
ABC: + read_blif <abc-temp-dir>/input.blif 
ABC: + read_library <abc-temp-dir>/stdcells.genlib 
ABC: + strash 
ABC: + &get -n 
ABC: + &fraig -x 
ABC: + &put 
ABC: + scorr 
ABC: Warning: The network is combinational (run "fraig" or "fraig_sweep").
ABC: + dc2 
ABC: + dretime 
ABC: + strash 
ABC: + &get -n 
ABC: + &dch -f 
ABC: + &nf 
ABC: + &put 
ABC: + write_blif <abc-temp-dir>/output.blif 
ABC: 
ABC: YOSYS_ABC_DONE 

4.24.19.2. Re-integrating ABC results.
ABC RESULTS:               AND cells:        1
ABC RESULTS:               NOT cells:        2
ABC RESULTS:        internal signals:        0
ABC RESULTS:           input signals:        3
ABC RESULTS:          output signals:        3
Removing temp directory.

4.24.19.1. Executed ABC.
Extracted 4 gates and 8 wires to a netlist network with 4 inputs and 3 outputs.
Running ABC script: <abc-temp-dir>/abc.script
ABC: UC Berkeley, ABC 1.01 (compiled Oct 27 2026 14:44:30)
ABC: abc 01> empty
ABC: abc 01> source <abc-temp-dir>/abc.script
ABC: + read_blif <abc-temp-dir>/input.blif 
ABC: + read_library <abc-temp-dir>/stdcells.genlib 
ABC: + strash 
ABC: + &get -n 
ABC: + &fraig -x 
ABC: + &put 
ABC: + scorr 
ABC: Warning: The network is combinational (run "fraig" or "fraig_sweep").
ABC: + dc2 
ABC: + dretime 
ABC: + strash 
ABC: + &get -n 
ABC: + &dch -f 
ABC: + &nf 
ABC: + &put 
ABC: + write_blif <abc-temp-dir>/output.blif 
ABC: 
ABC: YOSYS_ABC_DONE 

4.24.19.2. Re-integrating ABC results.
ABC RESULTS:               NOT cells:        1
ABC RESULTS:                OR cells:        1
ABC RESULTS:             ORNOT cells:        1
ABC RESULTS:        internal signals:        1
ABC RESULTS:           input signals:        4
ABC RESULTS:          output signals:        3
Removing temp directory.

4.24.20. Extracting gate netlist of module `\pmic_top' to `<abc-temp-dir>/input.blif'..
Found matching posedge clock domain: \clk, enabled by $auto$simple.cc:216:make_patterns_logic$1447, asynchronously reset by !\rst_sync.rst_n_exit

4.24.20.1. Executed ABC.
Extracted 18 gates and 35 wires to a netlist network with 17 inputs and 9 outputs.
Running ABC script: <abc-temp-dir>/abc.script
ABC: UC Berkeley, ABC 1.01 (compiled Oct 27 2026 14:44:30)
ABC: abc 01> empty
ABC: abc 01> source <abc-temp-dir>/abc.script
ABC: + read_blif <abc-temp-dir>/input.blif 
ABC: + read_library <abc-temp-dir>/stdcells.genlib 
ABC: + strash 
ABC: + &get -n 
ABC: + &fraig -x 
ABC: + &put 
ABC: + scorr 
ABC: Warning: The network is combinational (run "fraig" or "fraig_sweep").
ABC: + dc2 
ABC: + dretime 
ABC: + strash 
ABC: + &get -n 
ABC: + &dch -f 
ABC: + &nf 
ABC: + &put 
ABC: + write_blif <abc-temp-dir>/output.blif 
ABC: 
ABC: YOSYS_ABC_DONE 

4.24.20.2. Re-integrating ABC results.
ABC RESULTS:               AND cells:       13
ABC RESULTS:              NAND cells:        2
ABC RESULTS:               NOT cells:        1
ABC RESULTS:        internal signals:        9
ABC RESULTS:           input signals:       17
ABC RESULTS:          output signals:        9
Removing temp directory.

4.24.20.1. Executed ABC.
Extracted 19 gates and 37 wires to a netlist network with 18 inputs and 10 outputs.
Running ABC script: <abc-temp-dir>/abc.script
ABC: UC Berkeley, ABC 1.01 (compiled Oct 27 2026 14:44:30)
ABC: abc 01> empty
ABC: abc 01> source <abc-temp-dir>/abc.script
ABC: + read_blif <abc-temp-dir>/input.blif 
ABC: + read_library <abc-temp-dir>/stdcells.genlib 
ABC: + strash 
ABC: + &get -n 
ABC: + &fraig -x 
ABC: + &put 
ABC: + scorr 
ABC: Warning: The network is combinational (run "fraig" or "fraig_sweep").
ABC: + dc2 
ABC: + dretime 
ABC: + strash 
ABC: + &get -n 
ABC: + &dch -f 
ABC: + &nf 
ABC: + &put 
ABC: + write_blif <abc-temp-dir>/output.blif 
ABC: 
ABC: YOSYS_ABC_DONE 

4.24.20.2. Re-integrating ABC results.
ABC RESULTS:               AND cells:       11
ABC RESULTS:              NAND cells:        2
ABC RESULTS:               NOT cells:        1
ABC RESULTS:                OR cells:        3
ABC RESULTS:        internal signals:        9
ABC RESULTS:           input signals:       18
ABC RESULTS:          output signals:       10
Removing temp directory.

4.24.21. Extracting gate netlist of module `\pmic_top' to `<abc-temp-dir>/input.blif'..
Found matching posedge clock domain: \clk, enabled by $auto$simple.cc:199:make_patterns_logic$1450, asynchronously reset by !\rst_sync.rst_n_exit

4.24.21.1. Executed ABC.
Extracted 19 gates and 37 wires to a netlist network with 18 inputs and 10 outputs.
Running ABC script: <abc-temp-dir>/abc.script
ABC: UC Berkeley, ABC 1.01 (compiled Oct 27 2026 14:44:30)
ABC: abc 01> empty
ABC: abc 01> source <abc-temp-dir>/abc.script
ABC: + read_blif <abc-temp-dir>/input.blif 
ABC: + read_library <abc-temp-dir>/stdcells.genlib 
ABC: + strash 
ABC: + &get -n 
ABC: + &fraig -x 
ABC: + &put 
ABC: + scorr 
ABC: Warning: The network is combinational (run "fraig" or "fraig_sweep").
ABC: + dc2 
ABC: + dretime 
ABC: + strash 
ABC: + &get -n 
ABC: + &dch -f 
ABC: + &nf 
ABC: + &put 
ABC: + write_blif <abc-temp-dir>/output.blif 
ABC: 
ABC: YOSYS_ABC_DONE 

4.24.21.2. Re-integrating ABC results.
ABC RESULTS:               AND cells:       11
ABC RESULTS:              NAND cells:        2
ABC RESULTS:               NOT cells:        1
ABC RESULTS:                OR cells:        3
ABC RESULTS:        internal signals:        9
ABC RESULTS:           input signals:       18
ABC RESULTS:          output signals:       10
Removing temp directory.

4.24.21.1. Executed ABC.
Extracted 20 gates and 39 wires to a netlist network with 19 inputs and 11 outputs.
Running ABC script: <abc-temp-dir>/abc.script
ABC: UC Berkeley, ABC 1.01 (compiled Oct 27 2026 14:44:30)
ABC: abc 01> empty
ABC: abc 01> source <abc-temp-dir>/abc.script
ABC: + read_blif <abc-temp-dir>/input.blif 
ABC: + read_library <abc-temp-dir>/stdcells.genlib 
ABC: + strash 
ABC: + &get -n 
ABC: + &fraig -x 
ABC: + &put 
ABC: + scorr 
ABC: Warning: The network is combinational (run "fraig" or "fraig_sweep").
ABC: + dc2 
ABC: + dretime 
ABC: + strash 
ABC: + &get -n 
ABC: + &dch -f 
ABC: + &nf 
ABC: + &put 
ABC: + write_blif <abc-temp-dir>/output.blif 
ABC: 
ABC: YOSYS_ABC_DONE 

4.24.21.2. Re-integrating ABC results.
ABC RESULTS:               AND cells:       11
ABC RESULTS:            ANDNOT cells:        1
ABC RESULTS:              NAND cells:        2
ABC RESULTS:               NOT cells:        1
ABC RESULTS:                OR cells:        3
ABC RESULTS:        internal signals:        9
ABC RESULTS:           input signals:       19
ABC RESULTS:          output signals:       11
Removing temp directory.

4.24.21.1. Executed ABC.
Extracted 15 gates and 28 wires to a netlist network with 13 inputs and 4 outputs.
Running ABC script: <abc-temp-dir>/abc.script
ABC: empty
ABC: abc 07> source <abc-temp-dir>/abc.script
ABC: + read_blif <abc-temp-dir>/input.blif 
ABC: + read_library <abc-temp-dir>/stdcells.genlib 
ABC: + strash 
ABC: + &get -n 
ABC: + &fraig -x 
ABC: + &put 
ABC: + scorr 
ABC: Warning: The network is combinational (run "fraig" or "fraig_sweep").
ABC: + dc2 
ABC: + dretime 
ABC: + strash 
ABC: + &get -n 
ABC: + &dch -f 
ABC: + &nf 
ABC: + &put 
ABC: + write_blif <abc-temp-dir>/output.blif 
ABC: 
ABC: YOSYS_ABC_DONE 

4.24.21.2. Re-integrating ABC results.
ABC RESULTS:               AND cells:        3
ABC RESULTS:            ANDNOT cells:        1
ABC RESULTS:              NAND cells:        2
ABC RESULTS:               NOR cells:        3
ABC RESULTS:               NOT cells:        1
ABC RESULTS:                OR cells:        2
ABC RESULTS:        internal signals:       11
ABC RESULTS:           input signals:       13
ABC RESULTS:          output signals:        4
Removing temp directory.

4.24.21.1. Executed ABC.
Extracted 100 gates and 127 wires to a netlist network with 26 inputs and 34 outputs.
Running ABC script: <abc-temp-dir>/abc.script
ABC: empty
ABC: abc 07> source <abc-temp-dir>/abc.script
ABC: + read_blif <abc-temp-dir>/input.blif 
ABC: + read_library <abc-temp-dir>/stdcells.genlib 
ABC: + strash 
ABC: + &get -n 
ABC: + &fraig -x 
ABC: + &put 
ABC: + scorr 
ABC: Warning: The network is combinational (run "fraig" or "fraig_sweep").
ABC: + dc2 
ABC: + dretime 
ABC: + strash 
ABC: + &get -n 
ABC: + &dch -f 
ABC: + &nf 
ABC: + &put 
ABC: + write_blif <abc-temp-dir>/output.blif 
ABC: 
ABC: YOSYS_ABC_DONE 

4.24.21.2. Re-integrating ABC results.
ABC RESULTS:               AND cells:       44
ABC RESULTS:            ANDNOT cells:       19
ABC RESULTS:              NAND cells:        9
ABC RESULTS:               NOR cells:        2
ABC RESULTS:               NOT cells:        7
ABC RESULTS:                OR cells:       21
ABC RESULTS:             ORNOT cells:        2
ABC RESULTS:        internal signals:       67
ABC RESULTS:           input signals:       26
ABC RESULTS:          output signals:       34
Removing temp directory.

4.24.22. Extracting gate netlist of module `\pmic_top' to `<abc-temp-dir>/input.blif'..
Found matching posedge clock domain: \clk, enabled by $auto$simple.cc:199:make_patterns_logic$1453, asynchronously reset by !\rst_sync.rst_n_exit

4.24.22.1. Executed ABC.
Extracted 94 gates and 129 wires to a netlist network with 34 inputs and 24 outputs.
Running ABC script: <abc-temp-dir>/abc.script
ABC: empty
ABC: abc 07> source <abc-temp-dir>/abc.script
ABC: + read_blif <abc-temp-dir>/input.blif 
ABC: + read_library <abc-temp-dir>/stdcells.genlib 
ABC: + strash 
ABC: + &get -n 
ABC: + &fraig -x 
ABC: + &put 
ABC: + scorr 
ABC: Warning: The network is combinational (run "fraig" or "fraig_sweep").
ABC: + dc2 
ABC: + dretime 
ABC: + strash 
ABC: + &get -n 
ABC: + &dch -f 
ABC: + &nf 
ABC: + &put 
ABC: + write_blif <abc-temp-dir>/output.blif 
ABC: 
ABC: YOSYS_ABC_DONE 

4.24.22.2. Re-integrating ABC results.
ABC RESULTS:               AND cells:       44
ABC RESULTS:            ANDNOT cells:        1
ABC RESULTS:               MUX cells:        1
ABC RESULTS:              NAND cells:        4
ABC RESULTS:               NOR cells:        5
ABC RESULTS:               NOT cells:        1
ABC RESULTS:                OR cells:        3
ABC RESULTS:             ORNOT cells:       15
ABC RESULTS:              XNOR cells:        3
ABC RESULTS:               XOR cells:       19
ABC RESULTS:        internal signals:       71
ABC RESULTS:           input signals:       34
ABC RESULTS:          output signals:       24
Removing temp directory.

4.24.22.1. Executed ABC.
Extracted 87 gates and 114 wires to a netlist network with 26 inputs and 28 outputs.
Running ABC script: <abc-temp-dir>/abc.script
ABC: empty
ABC: abc 13> source <abc-temp-dir>/abc.script
ABC: + read_blif <abc-temp-dir>/input.blif 
ABC: + read_library <abc-temp-dir>/stdcells.genlib 
ABC: + strash 
ABC: + &get -n 
ABC: + &fraig -x 
ABC: + &put 
ABC: + scorr 
ABC: Warning: The network is combinational (run "fraig" or "fraig_sweep").
ABC: + dc2 
ABC: + dretime 
ABC: + strash 
ABC: + &get -n 
ABC: + &dch -f 
ABC: + &nf 
ABC: + &put 
ABC: + write_blif <abc-temp-dir>/output.blif 
ABC: 
ABC: YOSYS_ABC_DONE 

4.24.22.2. Re-integrating ABC results.
ABC RESULTS:               AND cells:       36
ABC RESULTS:            ANDNOT cells:       13
ABC RESULTS:              NAND cells:       10
ABC RESULTS:               NOR cells:        1
ABC RESULTS:               NOT cells:        5
ABC RESULTS:                OR cells:       16
ABC RESULTS:             ORNOT cells:        2
ABC RESULTS:              XNOR cells:        1
ABC RESULTS:               XOR cells:        3
ABC RESULTS:        internal signals:       60
ABC RESULTS:           input signals:       26
ABC RESULTS:          output signals:       28
Removing temp directory.

4.24.22.1. Executed ABC.
Extracted 45 gates and 59 wires to a netlist network with 12 inputs and 18 outputs.
Running ABC script: <abc-temp-dir>/abc.script
ABC: empty
ABC: abc 07> source <abc-temp-dir>/abc.script
ABC: + read_blif <abc-temp-dir>/input.blif 
ABC: + read_library <abc-temp-dir>/stdcells.genlib 
ABC: + strash 
ABC: + &get -n 
ABC: + &fraig -x 
ABC: + &put 
ABC: + scorr 
ABC: Warning: The network is combinational (run "fraig" or "fraig_sweep").
ABC: + dc2 
ABC: + dretime 
ABC: + strash 
ABC: + &get -n 
ABC: + &dch -f 
ABC: + &nf 
ABC: + &put 
ABC: + write_blif <abc-temp-dir>/output.blif 
ABC: 
ABC: YOSYS_ABC_DONE 

4.24.22.2. Re-integrating ABC results.
ABC RESULTS:               AND cells:        9
ABC RESULTS:            ANDNOT cells:        3
ABC RESULTS:              NAND cells:        2
ABC RESULTS:               NOT cells:        7
ABC RESULTS:                OR cells:        5
ABC RESULTS:             ORNOT cells:        1
ABC RESULTS:              XNOR cells:        3
ABC RESULTS:               XOR cells:        1
ABC RESULTS:        internal signals:       29
ABC RESULTS:           input signals:       12
ABC RESULTS:          output signals:       18
Removing temp directory.

4.24.22.1. Executed ABC.
Extracted 87 gates and 114 wires to a netlist network with 26 inputs and 28 outputs.
Running ABC script: <abc-temp-dir>/abc.script
ABC: empty
ABC: abc 07> source <abc-temp-dir>/abc.script
ABC: + read_blif <abc-temp-dir>/input.blif 
ABC: + read_library <abc-temp-dir>/stdcells.genlib 
ABC: + strash 
ABC: + &get -n 
ABC: + &fraig -x 
ABC: + &put 
ABC: + scorr 
ABC: Warning: The network is combinational (run "fraig" or "fraig_sweep").
ABC: + dc2 
ABC: + dretime 
ABC: + strash 
ABC: + &get -n 
ABC: + &dch -f 
ABC: + &nf 
ABC: + &put 
ABC: + write_blif <abc-temp-dir>/output.blif 
ABC: 
ABC: YOSYS_ABC_DONE 

4.24.22.2. Re-integrating ABC results.
ABC RESULTS:               AND cells:       36
ABC RESULTS:            ANDNOT cells:       13
ABC RESULTS:              NAND cells:       10
ABC RESULTS:               NOR cells:        1
ABC RESULTS:               NOT cells:        5
ABC RESULTS:                OR cells:       16
ABC RESULTS:             ORNOT cells:        2
ABC RESULTS:              XNOR cells:        1
ABC RESULTS:               XOR cells:        3
ABC RESULTS:        internal signals:       60
ABC RESULTS:           input signals:       26
ABC RESULTS:          output signals:       28
Removing temp directory.

4.24.22.1. Executed ABC.
Extracted 27 gates and 39 wires to a netlist network with 11 inputs and 9 outputs.
Running ABC script: <abc-temp-dir>/abc.script
ABC: empty
ABC: abc 07> source <abc-temp-dir>/abc.script
ABC: + read_blif <abc-temp-dir>/input.blif 
ABC: + read_library <abc-temp-dir>/stdcells.genlib 
ABC: + strash 
ABC: + &get -n 
ABC: + &fraig -x 
ABC: + &put 
ABC: + scorr 
ABC: Warning: The network is combinational (run "fraig" or "fraig_sweep").
ABC: + dc2 
ABC: + dretime 
ABC: + strash 
ABC: + &get -n 
ABC: + &dch -f 
ABC: + &nf 
ABC: + &put 
ABC: + write_blif <abc-temp-dir>/output.blif 
ABC: 
ABC: YOSYS_ABC_DONE 

4.24.22.2. Re-integrating ABC results.
ABC RESULTS:               AND cells:        6
ABC RESULTS:            ANDNOT cells:        1
ABC RESULTS:              NAND cells:        2
ABC RESULTS:               NOR cells:        1
ABC RESULTS:               NOT cells:        1
ABC RESULTS:                OR cells:        1
ABC RESULTS:              XNOR cells:        1
ABC RESULTS:               XOR cells:        5
ABC RESULTS:        internal signals:       19
ABC RESULTS:           input signals:       11
ABC RESULTS:          output signals:        9
Removing temp directory.

4.24.23. Extracting gate netlist of module `\pmic_top' to `<abc-temp-dir>/input.blif'..
Found matching posedge clock domain: \clk, enabled by $auto$simple.cc:216:make_patterns_logic$1437, asynchronously reset by !\rst_sync.rst_n_exit

4.24.23.1. Executed ABC.
Extracted 87 gates and 114 wires to a netlist network with 26 inputs and 28 outputs.
Running ABC script: <abc-temp-dir>/abc.script
ABC: empty
ABC: abc 07> source <abc-temp-dir>/abc.script
ABC: + read_blif <abc-temp-dir>/input.blif 
ABC: + read_library <abc-temp-dir>/stdcells.genlib 
ABC: + strash 
ABC: + &get -n 
ABC: + &fraig -x 
ABC: + &put 
ABC: + scorr 
ABC: Warning: The network is combinational (run "fraig" or "fraig_sweep").
ABC: + dc2 
ABC: + dretime 
ABC: + strash 
ABC: + &get -n 
ABC: + &dch -f 
ABC: + &nf 
ABC: + &put 
ABC: + write_blif <abc-temp-dir>/output.blif 
ABC: 
ABC: YOSYS_ABC_DONE 

4.24.23.2. Re-integrating ABC results.
ABC RESULTS:               AND cells:       36
ABC RESULTS:            ANDNOT cells:       13
ABC RESULTS:              NAND cells:       10
ABC RESULTS:               NOR cells:        1
ABC RESULTS:               NOT cells:        5
ABC RESULTS:                OR cells:       16
ABC RESULTS:             ORNOT cells:        2
ABC RESULTS:              XNOR cells:        1
ABC RESULTS:               XOR cells:        3
ABC RESULTS:        internal signals:       60
ABC RESULTS:           input signals:       26
ABC RESULTS:          output signals:       28
Removing temp directory.

4.24.23.1. Executed ABC.
Extracted 64 gates and 82 wires to a netlist network with 16 inputs and 22 outputs.
Running ABC script: <abc-temp-dir>/abc.script
ABC: empty
ABC: abc 19> source <abc-temp-dir>/abc.script
ABC: + read_blif <abc-temp-dir>/input.blif 
ABC: + read_library <abc-temp-dir>/stdcells.genlib 
ABC: + strash 
ABC: + &get -n 
ABC: + &fraig -x 
ABC: + &put 
ABC: + scorr 
ABC: Warning: The network is combinational (run "fraig" or "fraig_sweep").
ABC: + dc2 
ABC: + dretime 
ABC: + strash 
ABC: + &get -n 
ABC: + &dch -f 
ABC: + &nf 
ABC: + &put 
ABC: + write_blif <abc-temp-dir>/output.blif 
ABC: 
ABC: YOSYS_ABC_DONE 

4.24.23.2. Re-integrating ABC results.
ABC RESULTS:               AND cells:       23
ABC RESULTS:            ANDNOT cells:        4
ABC RESULTS:              NAND cells:       10
ABC RESULTS:               NOR cells:        1
ABC RESULTS:               NOT cells:        6
ABC RESULTS:                OR cells:        5
ABC RESULTS:             ORNOT cells:        4
ABC RESULTS:              XNOR cells:        6
ABC RESULTS:        internal signals:       44
ABC RESULTS:           input signals:       16
ABC RESULTS:          output signals:       22
Removing temp directory.

4.24.23.1. Executed ABC.
Extracted 100 gates and 123 wires to a netlist network with 22 inputs and 21 outputs.
Running ABC script: <abc-temp-dir>/abc.script
ABC: empty
ABC: abc 13> source <abc-temp-dir>/abc.script
ABC: + read_blif <abc-temp-dir>/input.blif 
ABC: + read_library <abc-temp-dir>/stdcells.genlib 
ABC: + strash 
ABC: + &get -n 
ABC: + &fraig -x 
ABC: + &put 
ABC: + scorr 
ABC: Warning: The network is combinational (run "fraig" or "fraig_sweep").
ABC: + dc2 
ABC: + dretime 
ABC: + strash 
ABC: + &get -n 
ABC: + &dch -f 
ABC: + &nf 
ABC: + &put 
ABC: + write_blif <abc-temp-dir>/output.blif 
ABC: 
ABC: YOSYS_ABC_DONE 

4.24.23.2. Re-integrating ABC results.
ABC RESULTS:               AND cells:       45
ABC RESULTS:            ANDNOT cells:       22
ABC RESULTS:              NAND cells:        4
ABC RESULTS:               NOR cells:        3
ABC RESULTS:                OR cells:       16
ABC RESULTS:              XNOR cells:        1
ABC RESULTS:        internal signals:       80
ABC RESULTS:           input signals:       22
ABC RESULTS:          output signals:       21
Removing temp directory.

4.24.23.1. Executed ABC.
Extracted 19 gates and 26 wires to a netlist network with 5 inputs and 16 outputs.
Running ABC script: <abc-temp-dir>/abc.script
ABC: empty
ABC: abc 25> source <abc-temp-dir>/abc.script
ABC: + read_blif <abc-temp-dir>/input.blif 
ABC: + read_library <abc-temp-dir>/stdcells.genlib 
ABC: + strash 
ABC: + &get -n 
ABC: + &fraig -x 
ABC: + &put 
ABC: + scorr 
ABC: Warning: The network is combinational (run "fraig" or "fraig_sweep").
ABC: + dc2 
ABC: + dretime 
ABC: + strash 
ABC: + &get -n 
ABC: + &dch -f 
ABC: + &nf 
ABC: + &put 
ABC: + write_blif <abc-temp-dir>/output.blif 
ABC: 
ABC: YOSYS_ABC_DONE 

4.24.23.2. Re-integrating ABC results.
ABC RESULTS:               AND cells:        1
ABC RESULTS:            ANDNOT cells:        3
ABC RESULTS:               NOR cells:        1
ABC RESULTS:               NOT cells:        7
ABC RESULTS:             ORNOT cells:        2
ABC RESULTS:              XNOR cells:        1
ABC RESULTS:               XOR cells:        1
ABC RESULTS:        internal signals:        5
ABC RESULTS:           input signals:        5
ABC RESULTS:          output signals:       16
Removing temp directory.

4.24.23.1. Executed ABC.
Extracted 45 gates and 60 wires to a netlist network with 15 inputs and 9 outputs.
Running ABC script: <abc-temp-dir>/abc.script
ABC: empty
ABC: abc 13> source <abc-temp-dir>/abc.script
ABC: + read_blif <abc-temp-dir>/input.blif 
ABC: + read_library <abc-temp-dir>/stdcells.genlib 
ABC: + strash 
ABC: + &get -n 
ABC: + &fraig -x 
ABC: + &put 
ABC: + scorr 
ABC: Warning: The network is combinational (run "fraig" or "fraig_sweep").
ABC: + dc2 
ABC: + dretime 
ABC: + strash 
ABC: + &get -n 
ABC: + &dch -f 
ABC: + &nf 
ABC: + &put 
ABC: + write_blif <abc-temp-dir>/output.blif 
ABC: 
ABC: YOSYS_ABC_DONE 

4.24.23.2. Re-integrating ABC results.
ABC RESULTS:               AND cells:        9
ABC RESULTS:              NAND cells:       14
ABC RESULTS:               NOT cells:        1
ABC RESULTS:                OR cells:        8
ABC RESULTS:              XNOR cells:        1
ABC RESULTS:               XOR cells:        5
ABC RESULTS:        internal signals:       36
ABC RESULTS:           input signals:       15
ABC RESULTS:          output signals:        9
Removing temp directory.

4.24.24. Extracting gate netlist of module `\pmic_top' to `<abc-temp-dir>/input.blif'..
Found matching posedge clock domain: \clk, enabled by $auto$simple.cc:216:make_patterns_logic$1467, asynchronously reset by !\rst_sync.rst_n_exit

4.24.24.1. Executed ABC.
Extracted 79 gates and 123 wires to a netlist network with 43 inputs and 44 outputs.
Running ABC script: <abc-temp-dir>/abc.script
ABC: empty
ABC: abc 13> source <abc-temp-dir>/abc.script
ABC: + read_blif <abc-temp-dir>/input.blif 
ABC: + read_library <abc-temp-dir>/stdcells.genlib 
ABC: + strash 
ABC: + &get -n 
ABC: + &fraig -x 
ABC: + &put 
ABC: + scorr 
ABC: Warning: The network is combinational (run "fraig" or "fraig_sweep").
ABC: + dc2 
ABC: + dretime 
ABC: + strash 
ABC: + &get -n 
ABC: + &dch -f 
ABC: + &nf 
ABC: + &put 
ABC: + write_blif <abc-temp-dir>/output.blif 
ABC: 
ABC: YOSYS_ABC_DONE 

4.24.24.2. Re-integrating ABC results.
ABC RESULTS:               AND cells:       45
ABC RESULTS:            ANDNOT cells:        2
ABC RESULTS:               MUX cells:        1
ABC RESULTS:              NAND cells:        7
ABC RESULTS:               NOR cells:        3
ABC RESULTS:               NOT cells:        2
ABC RESULTS:                OR cells:        8
ABC RESULTS:             ORNOT cells:        2
ABC RESULTS:              XNOR cells:        4
ABC RESULTS:               XOR cells:        1
ABC RESULTS:        internal signals:       36
ABC RESULTS:           input signals:       43
ABC RESULTS:          output signals:       44
Removing temp directory.

4.24.25. Extracting gate netlist of module `\pmic_top' to `<abc-temp-dir>/input.blif'..
Found matching posedge clock domain: \clk, asynchronously reset by !\rst_sync.rst_n_exit

4.24.25.1. Executed ABC.
Extracted 56 gates and 83 wires to a netlist network with 26 inputs and 27 outputs.
Running ABC script: <abc-temp-dir>/abc.script
ABC: empty
ABC: abc 19> source <abc-temp-dir>/abc.script
ABC: + read_blif <abc-temp-dir>/input.blif 
ABC: + read_library <abc-temp-dir>/stdcells.genlib 
ABC: + strash 
ABC: + &get -n 
ABC: + &fraig -x 
ABC: + &put 
ABC: + scorr 
ABC: Warning: The network is combinational (run "fraig" or "fraig_sweep").
ABC: + dc2 
ABC: + dretime 
ABC: + strash 
ABC: + &get -n 
ABC: + &dch -f 
ABC: + &nf 
ABC: + &put 
ABC: + write_blif <abc-temp-dir>/output.blif 
ABC: 
ABC: YOSYS_ABC_DONE 

4.24.25.2. Re-integrating ABC results.
ABC RESULTS:               AND cells:       26
ABC RESULTS:            ANDNOT cells:        2
ABC RESULTS:              NAND cells:        6
ABC RESULTS:               NOR cells:        1
ABC RESULTS:               NOT cells:        3
ABC RESULTS:                OR cells:        8
ABC RESULTS:             ORNOT cells:        2
ABC RESULTS:              XNOR cells:        3
ABC RESULTS:               XOR cells:        2
ABC RESULTS:        internal signals:       30
ABC RESULTS:           input signals:       26
ABC RESULTS:          output signals:       27
Removing temp directory.

4.24.25.1. Executed ABC.
Extracted 288 gates and 423 wires to a netlist network with 133 inputs and 120 outputs.
Running ABC script: <abc-temp-dir>/abc.script
ABC: empty
ABC: abc 19> source <abc-temp-dir>/abc.script
ABC: + read_blif <abc-temp-dir>/input.blif 
ABC: + read_library <abc-temp-dir>/stdcells.genlib 
ABC: + strash 
ABC: + &get -n 
ABC: + &fraig -x 
ABC: + &put 
ABC: + scorr 
ABC: Warning: The network is combinational (run "fraig" or "fraig_sweep").
ABC: + dc2 
ABC: + dretime 
ABC: + strash 
ABC: + &get -n 
ABC: + &dch -f 
ABC: + &nf 
ABC: + &put 
ABC: + write_blif <abc-temp-dir>/output.blif 
ABC: 
ABC: YOSYS_ABC_DONE 

4.24.25.2. Re-integrating ABC results.
ABC RESULTS:               AND cells:      116
ABC RESULTS:            ANDNOT cells:       19
ABC RESULTS:              NAND cells:       20
ABC RESULTS:               NOR cells:        8
ABC RESULTS:               NOT cells:       11
ABC RESULTS:                OR cells:       19
ABC RESULTS:             ORNOT cells:       11
ABC RESULTS:              XNOR cells:        3
ABC RESULTS:               XOR cells:       21
ABC RESULTS:        internal signals:      170
ABC RESULTS:           input signals:      133
ABC RESULTS:          output signals:      120
Removing temp directory.
Removing global temp directory.

4.25. Executing OPT pass (performing simple optimizations).

4.25.1. Executing OPT_EXPR pass (perform const folding).
Optimizing module pmic_top.

4.25.2. Executing OPT_MERGE pass (detect identical cells).
Finding identical cells in module `\pmic_top'.
Computing hashes of 1452 cells of `\pmic_top'.
Finding duplicate cells in `\pmic_top'.
Computing hashes of 1449 cells of `\pmic_top'.
Finding duplicate cells in `\pmic_top'.
<suppressed ~9 debug messages>
Removed a total of 3 cells.

4.25.3. Executing OPT_DFF pass (perform DFF optimizations).

4.25.4. Executing OPT_CLEAN pass (remove unused cells and wires).
Finding unused cells or wires in module \pmic_top..
Removed 0 unused cells and 1146 unused wires.
<suppressed ~2 debug messages>

4.25.5. Finished fast OPT passes.

4.26. Executing HIERARCHY pass (managing design hierarchy).
Attribute `top' found on module `pmic_top'. Setting top module to pmic_top.

4.26.1. Analyzing design hierarchy..
Top module:  \pmic_top

4.26.2. Analyzing design hierarchy..
Top module:  \pmic_top
Removed 0 unused modules.

4.27. Printing statistics.

=== pmic_top ===

        +----------Local Count, excluding submodules.
        | 
     1301 wires
     2086 wire bits
      237 public wires
      718 public wire bits
       23 ports
       23 port bits
     1449 cells
      117   $_ANDNOT_
      526   $_AND_
      206   $_DFFE_PN0P_
        5   $_DFFE_PN1P_
       47   $_DFF_PN0_
       10   $_DFF_PN1_
        2   $_MUX_
      118   $_NAND_
       31   $_NOR_
       68   $_NOT_
       47   $_ORNOT_
      159   $_OR_
       29   $_XNOR_
       64   $_XOR_
       20   $scopeinfo

4.28. Executing CHECK pass (checking for obvious problems).
Checking module pmic_top...
Found and reported 0 problems.

5. Printing statistics.

=== pmic_top ===

        +----------Local Count, excluding submodules.
        | 
     1301 wires
     2086 wire bits
      237 public wires
      718 public wire bits
       23 ports
       23 port bits
     1449 cells
      117   $_ANDNOT_
      526   $_AND_
      206   $_DFFE_PN0P_
        5   $_DFFE_PN1P_
       47   $_DFF_PN0_
       10   $_DFF_PN1_
        2   $_MUX_
      118   $_NAND_
       31   $_NOR_
       68   $_NOT_
       47   $_ORNOT_
      159   $_OR_
       29   $_XNOR_
       64   $_XOR_
       20   $scopeinfo

End of script. Logfile hash: f8668ae463, time: 1.48s, user: 0.82s, system: 0.20s, MEM: 38.98 MB peak
Yosys 0.70+240 (git sha1 5cdfd1241, Release, Clang /usr/bin/clang++ 21.1.8)
Time spent: 61% 1x abc (1 sec), 8% 1x techmap (0 sec), ...
