Hrishikesh-Acharyya/Synchronous_buck_PMIC/tb/top/pmic_top/soak/results.txt

soak: 64 runs x 200 events, 8 at a time, checkers: all - started Tue Nov 10 17:56:20 IST 2026
run 1: PASS SEED=1794313581
run 2: PASS SEED=1794313582
run 3: PASS SEED=1794313583
run 4: PASS SEED=1794313584
run 5: PASS SEED=1794313585
run 6: PASS SEED=1794313586
run 7: PASS SEED=1794313587
run 8: PASS SEED=1794313588
run 9: PASS SEED=1794313589
run 10: PASS SEED=1794313590
run 11: PASS SEED=1794313591
run 12: PASS SEED=1794313592
run 13: PASS SEED=1794313593
run 14: PASS SEED=1794313594
run 15: PASS SEED=1794313595
run 16: PASS SEED=1794313596
run 17: PASS SEED=1794313597
run 18: PASS SEED=1794313598
run 19: PASS SEED=1794313599
run 20: PASS SEED=1794313600
run 21: PASS SEED=1794313601
run 22: PASS SEED=1794313602
run 23: PASS SEED=1794313603
run 24: PASS SEED=1794313604
run 25: PASS SEED=1794313605
run 26: PASS SEED=1794313606
run 27: PASS SEED=1794313607
run 28: PASS SEED=1794313608
run 29: PASS SEED=1794313609
run 30: PASS SEED=1794313610
run 31: PASS SEED=1794313611
run 32: PASS SEED=1794313612
run 33: PASS SEED=1794313613
run 34: PASS SEED=1794313614
run 35: PASS SEED=1794313615
run 36: PASS SEED=1794313616
run 37: PASS SEED=1794313617
run 38: PASS SEED=1794313618
run 39: PASS SEED=1794313619
run 40: PASS SEED=1794313620
run 41: FAIL SEED=1794313621
run 42: PASS SEED=1794313622
run 43: PASS SEED=1794313623
run 44: PASS SEED=1794313624
run 45: PASS SEED=1794313625
run 46: PASS SEED=1794313626
run 47: PASS SEED=1794313627
run 48: PASS SEED=1794313628
run 49: PASS SEED=1794313629
run 50: PASS SEED=1794313630
run 51: PASS SEED=1794313631
run 52: PASS SEED=1794313632
run 53: PASS SEED=1794313633
run 54: PASS SEED=1794313634
run 55: PASS SEED=1794313635
run 56: PASS SEED=1794313636
run 57: PASS SEED=1794313637
run 58: FAIL SEED=1794313638
run 59: PASS SEED=1794313639
run 60: PASS SEED=1794313640
run 61: PASS SEED=1794313641
run 62: PASS SEED=1794313642
run 63: PASS SEED=1794313643
run 64: PASS SEED=1794313644
soak: finished Wed Nov 11 03:30:37 IST 2026
