Hrishikesh-Acharyya/Synchronous_buck_PMIC/tb/telemetry/host_if/soak/results.txt

soak: 200 runs x 200 events - started Tue Nov 10 01:06:37 IST 2026
run 1: PASS SEED=1794253021
run 2: PASS SEED=1794253315
run 3: PASS SEED=1794253559
run 4: PASS SEED=1794253795
run 5: PASS SEED=1794254033
run 6: PASS SEED=1794254255
run 7: PASS SEED=1794254503
run 8: PASS SEED=1794254750
run 9: PASS SEED=1794254987
run 10: PASS SEED=1794255253
run 11: PASS SEED=1794255497
run 12: PASS SEED=1794255749
run 13: PASS SEED=1794256009
run 14: PASS SEED=1794256254
run 15: PASS SEED=1794256527
run 16: PASS SEED=1794256777
run 17: PASS SEED=1794257027
run 18: PASS SEED=1794257287
run 19: PASS SEED=1794257552
run 20: PASS SEED=1794257827
run 21: PASS SEED=1794258087
run 22: PASS SEED=1794258364
run 23: PASS SEED=1794258648
run 24: PASS SEED=1794258917
run 25: PASS SEED=1794259196
run 26: PASS SEED=1794259471
run 27: PASS SEED=1794259727
run 28: PASS SEED=1794259971
run 29: PASS SEED=1794260225
run 30: PASS SEED=1794260516
run 31: PASS SEED=1794260822
run 32: PASS SEED=1794261104
run 33: PASS SEED=1794261387
run 34: PASS SEED=1794261668
run 35: PASS SEED=1794261955
run 36: PASS SEED=1794262256
run 37: PASS SEED=1794262509
run 38: PASS SEED=1794262779
run 39: PASS SEED=1794263048
run 40: PASS SEED=1794263329
run 41: PASS SEED=1794263634
run 42: PASS SEED=1794263927
run 43: PASS SEED=1794264228
run 44: PASS SEED=1794264520
run 45: PASS SEED=1794264806
run 46: PASS SEED=1794265071
run 47: PASS SEED=1794265351
run 48: PASS SEED=1794265618
run 49: PASS SEED=1794265889
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
run 192: PASS SEED=1794302642
run 193: PASS SEED=1794302881
run 194: PASS SEED=1794303094
run 195: PASS SEED=1794303305
run 196: PASS SEED=1794303524
run 197: PASS SEED=1794303734
run 198: PASS SEED=1794303959
run 199: PASS SEED=1794304190
run 200: PASS SEED=1794304436
soak: finished Tue Nov 10 15:27:41 IST 2026
