Hrishikesh-Acharyya/Synchronous_buck_PMIC/simulations/graphs_or_pdfs/Figure1_Power_Stage_Plant.pdf

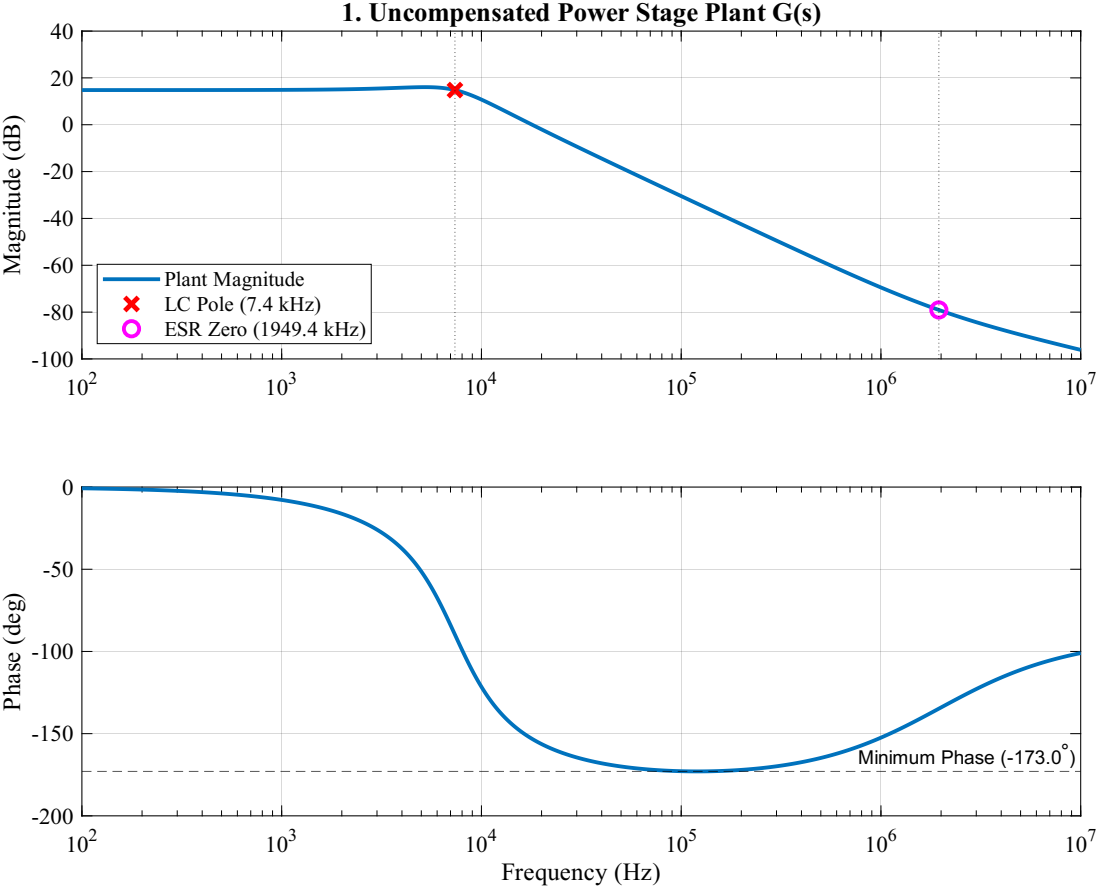
[picture p35: page 1]
nitu; Frequency (Hz); ase (d; Minimum Phase (-173.0

1. Uncompensated Power Stage Plant G(s)

Plant Magnitude
LC Pole (7.4 kHz)
ESR Zero (1949.4 kHz)
