Hrishikesh-Acharyya/Synchronous_buck_PMIC/simulations/graphs_or_pdfs/heavy_load_5A/Figure1_Power_Stage_Plant_5A_Heavy_Load.pdf

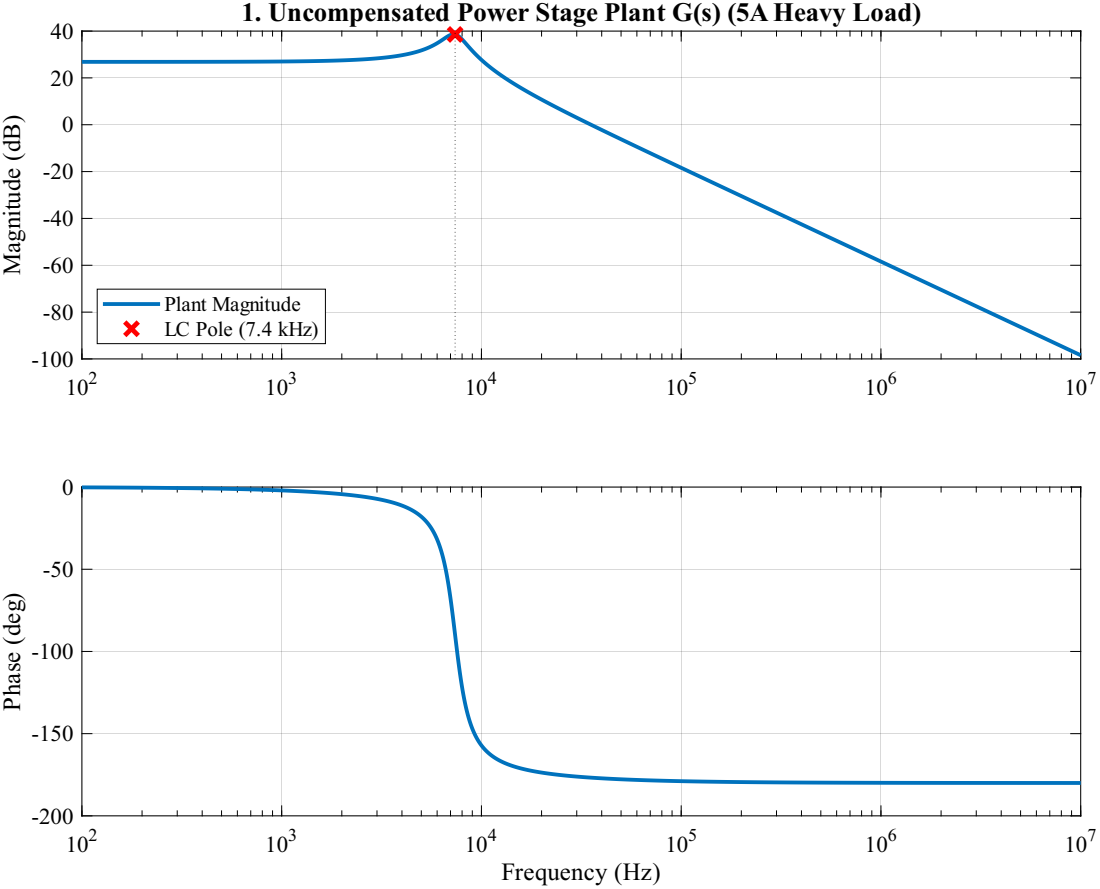
[picture p36: page 1]
nitu; Frequency (Hz); ase (d

1. Uncompensated Power Stage Plant G(s) (5A Heavy Load)

Plant Magnitude
LC Pole (7.4 kHz)
