Hrishikesh-Acharyya/Synchronous_buck_PMIC/simulations/graphs_or_pdfs/light_load_100mA/Figure1_Power_Stage_Plant_100mA_Light_Load.pdf

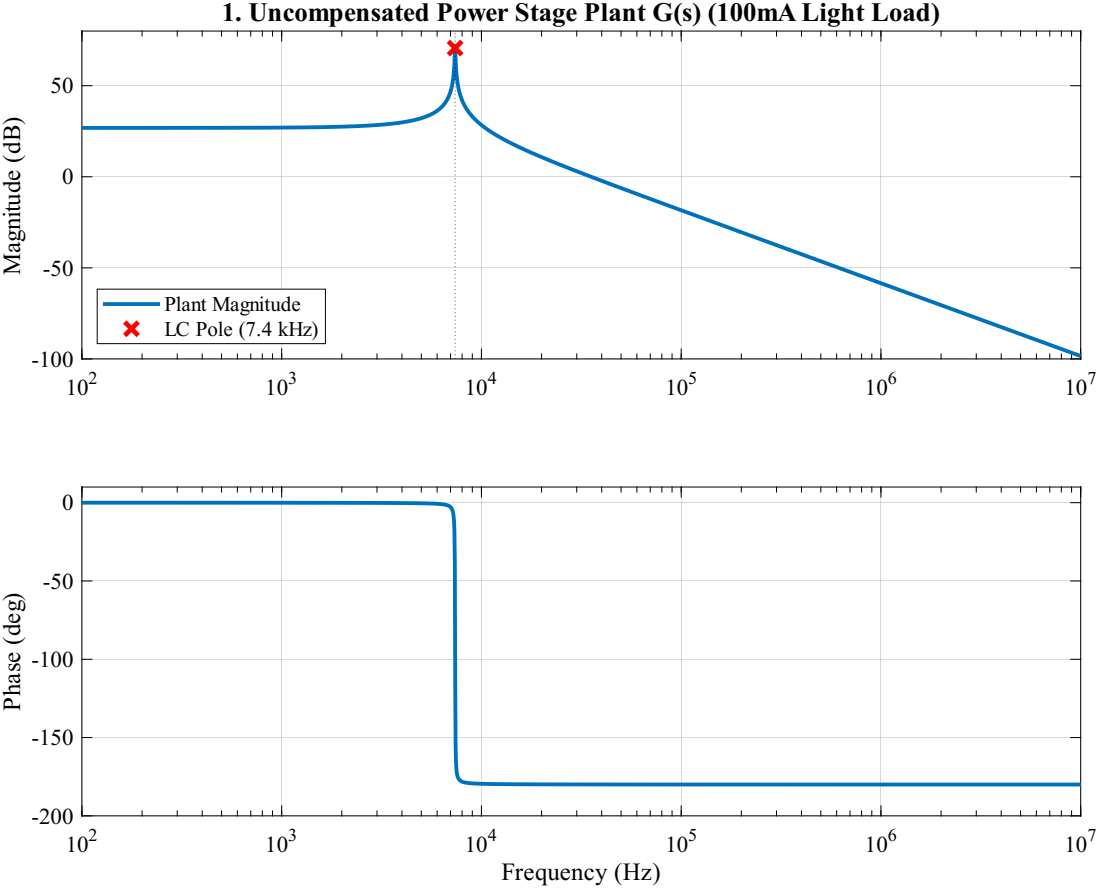
[picture p37: page 1]
gnitu; Frequency (Hz); ase (d

1. Uncompensated Power Stage Plant G(s) (100mA Light Load)

Plant Magnitude
LC Pole (7.4 kHz)
