Hrishikesh-Acharyya/Synchronous_buck_PMIC/simulations/graphs_or_pdfs/light_load_100mA/Figure2_Type_III_Compensator_100mA_Light_Load.pdf

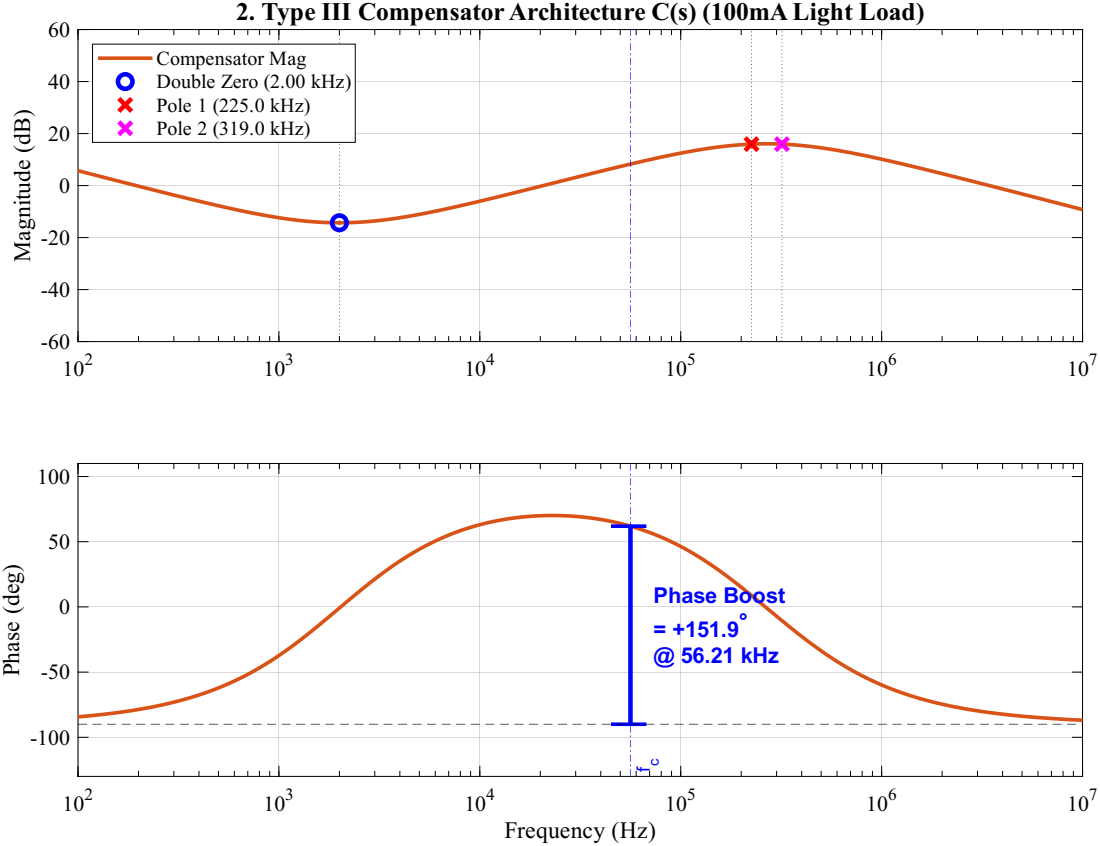
[picture p38: page 1]
nitu; Frequency (Hz); ase (d; Phase Boost = +151.9; ° @ 56.21 kHz

2. Type III Compensator Architecture C(s) (100mA Light Load)

Compensator Mag
Double Zero (2.00 kHz)
Pole 1 (225.0 kHz)
Pole 2 (319.0 kHz)
