Hrishikesh-Acharyya/Synchronous_buck_PMIC/simulations/graphs_or_pdfs/light_load_100mA/Figure3_Loop_Gain_Margins_100mA_Light_Load.pdf

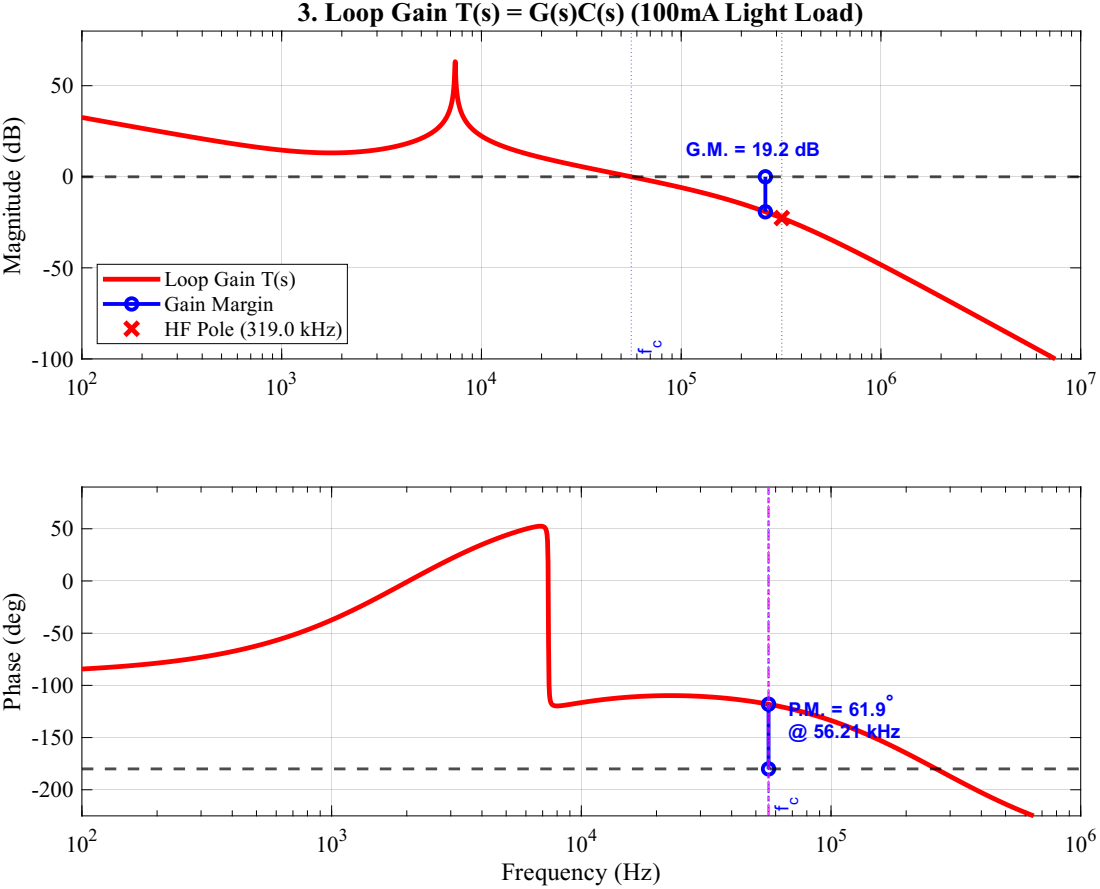
[picture p39: page 1]
gnitu; Frequency (Hz); ase (d; ° @ 56.21 kHz

3. Loop Gain T(s) = G(s)C(s) (100mA Light Load)

Loop Gain T(s)
Gain Margin
HF Pole (319.0 kHz)
