Hrishikesh-Acharyya/Synchronous_buck_PMIC/simulations/graphs_or_pdfs/light_load_100mA/Figure4_System_Overlay_100mA_Light_Load.pdf

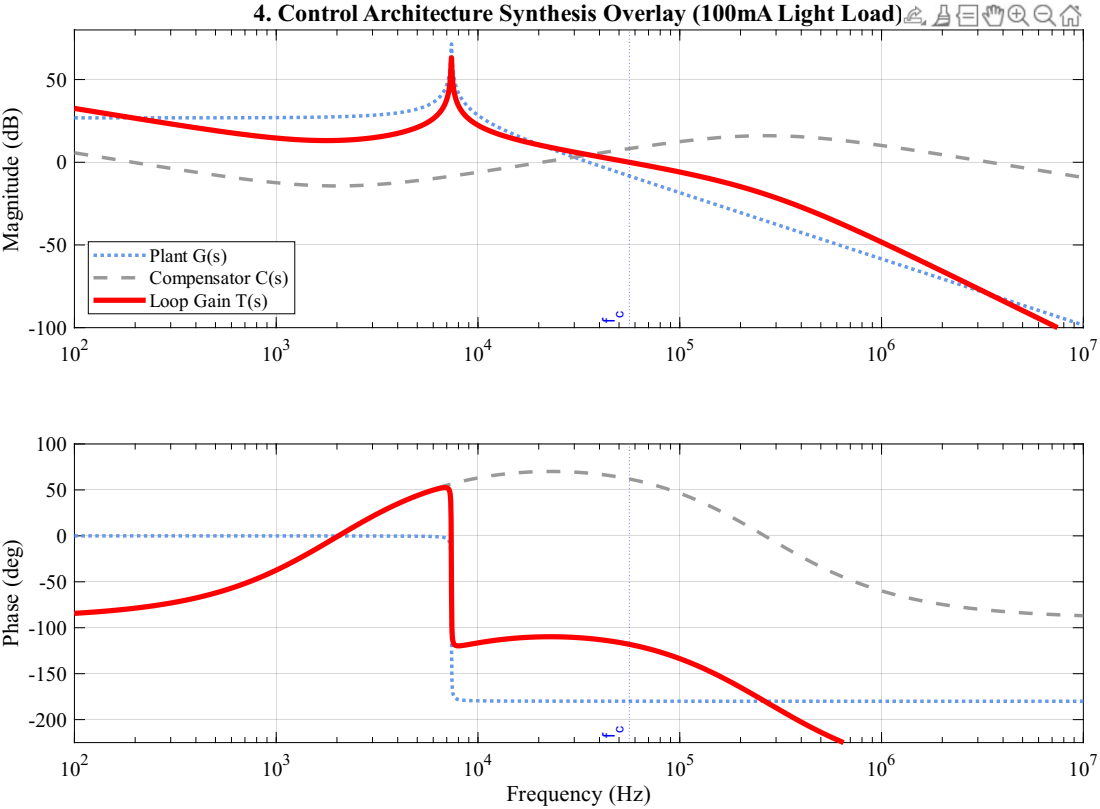
[picture p40: page 1]
gnitu; Plant G(s) Compensator C(s) Loop Gain T(s); Frequency (Hz); ase (d

4. Control Architecture Synthesis Overlay (100mA Light Load)
