Hrishikesh-Acharyya/Synchronous_buck_PMIC/simulations/graphs_or_pdfs/light_load_100mA/Figure5_System_Transients_100mA_Light_Load.pdf

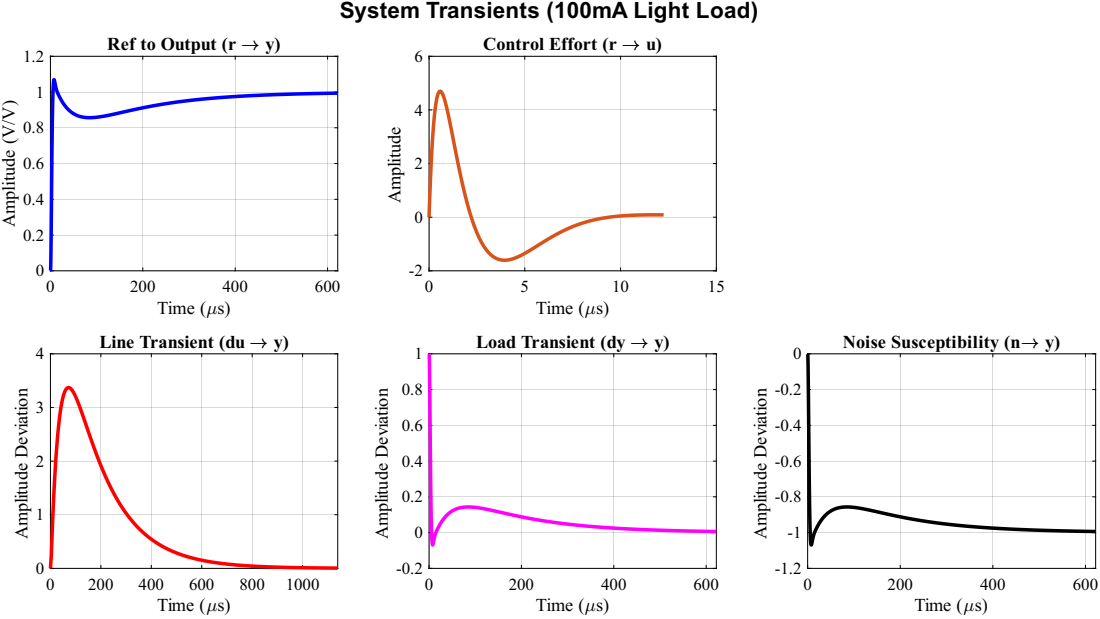
[picture p41: page 1]
mplitu; Amplitu; Control Effort (r ! u); Time (7s); viatio; Noise Susceptibility (n! y)

System Transients (100mA Light Load)

Ref to Output (r ! y)

Time (7s)
Line Transient (du ! y)

Load Transient (dy ! y)
