Hrishikesh-Acharyya/Synchronous_buck_PMIC/simulations/graphs_or_pdfs/very_light_load_uA/Figure1_Power_Stage_Plant_uA_very_Light_Load.pdf

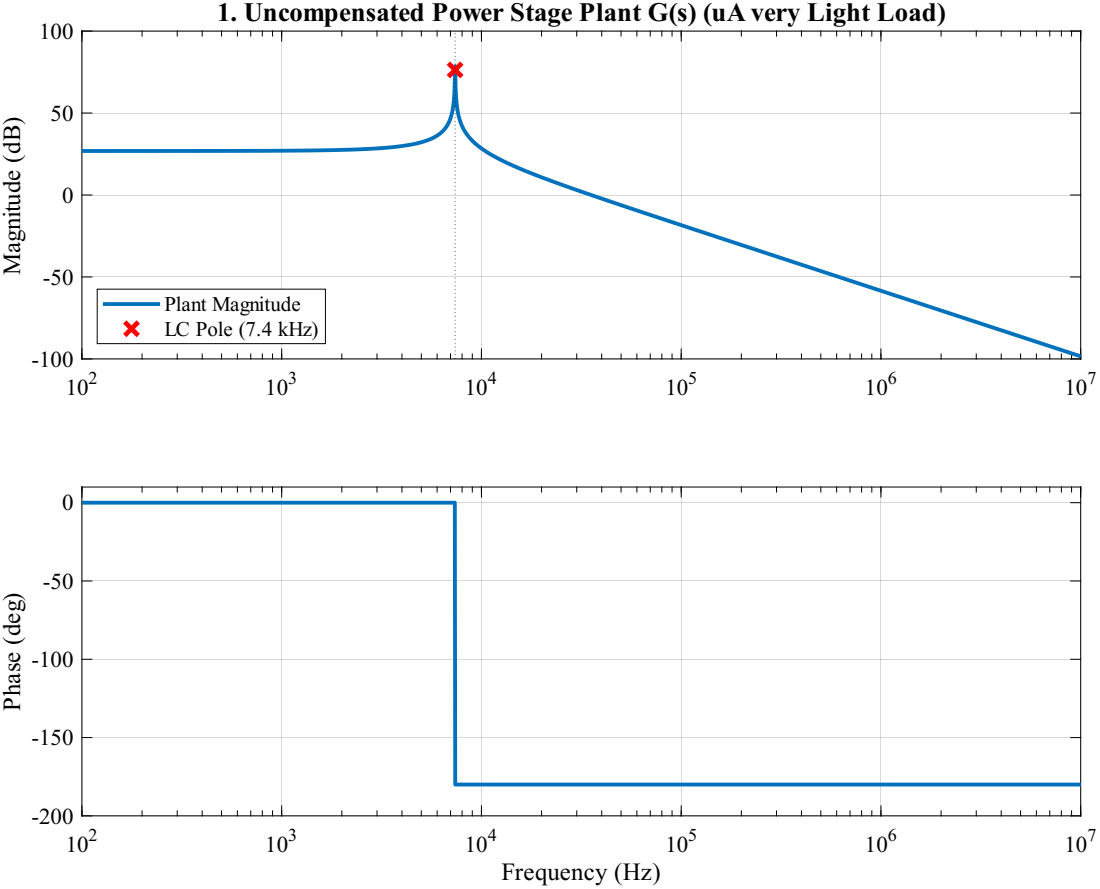
[picture p42: page 1]
gnitu; Frequency (Hz); ase (d

1. Uncompensated Power Stage Plant G(s) (uA very Light Load)

Plant Magnitude
LC Pole (7.4 kHz)
