Hrishikesh-Acharyya/Synchronous_buck_PMIC/simulations/graphs_or_pdfs/Compensator_Bode_LTSPICE.pdf

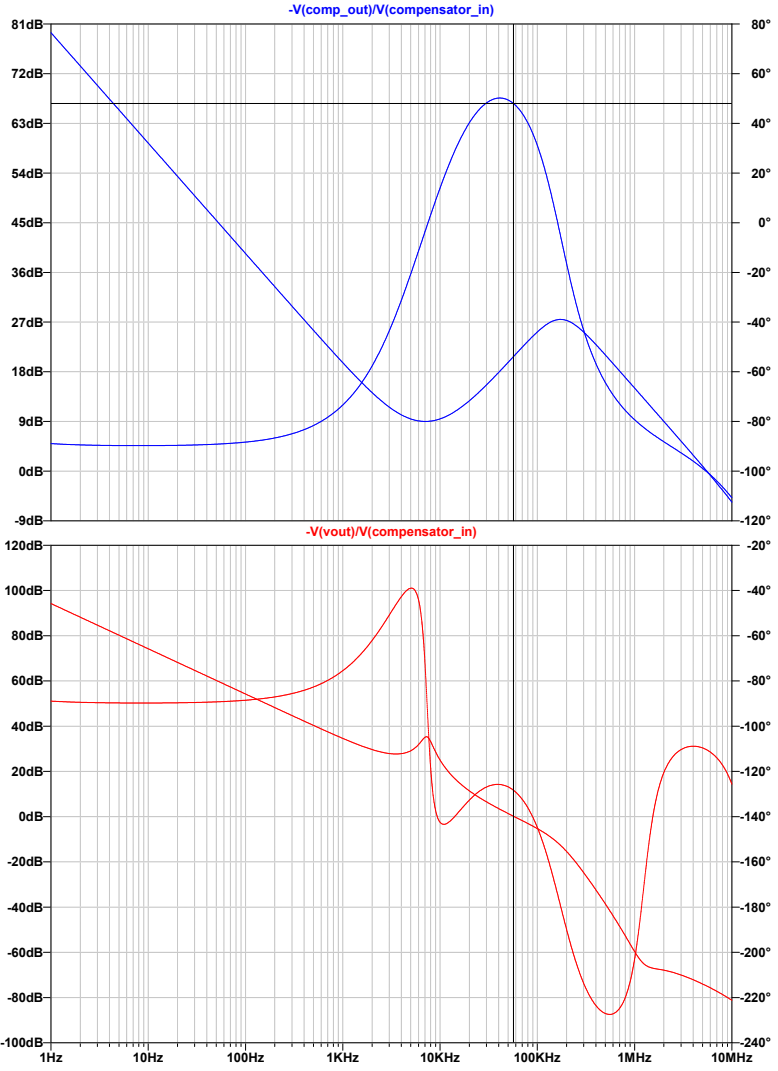
[picture p43: page 1]
1KHz; 10KHz; 100KHz; 1MHz; 10MHz; -V(vout)/V(compensator_in); -V(comp_out)/V(compensator_in); -V(comp_out)/V(compensator_in): (56.754461KHz,47.997576°)

--- E:\Sync_Buck_convertor\simulations\compensator.raw ---
