Hrishikesh-Acharyya/Synchronous_buck_PMIC/simulations/graphs_or_pdfs/Power_stage_bode_LTSPICE.pdf

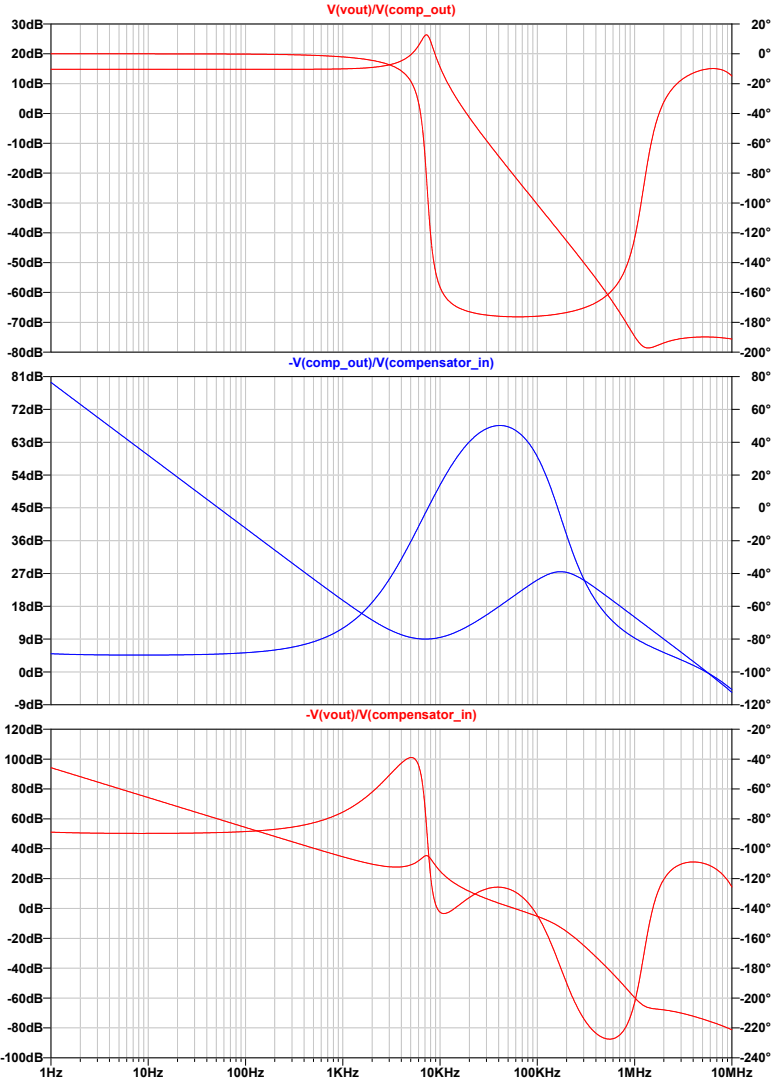
[picture p44: page 1]
1KHz; 10KHz; 100KHz; 1MHz; 10MHz; -V(vout)/V(compensator_in); -V(comp_out)/V(compensator_in); V(vout)/V(comp_out)

--- E:\Sync_Buck_convertor\simulations\compensator.raw ---
