Hrishikesh-Acharyya/Synchronous_buck_PMIC/simulations/graphs_or_pdfs/TOTAL_loop_LTSPICE.pdf

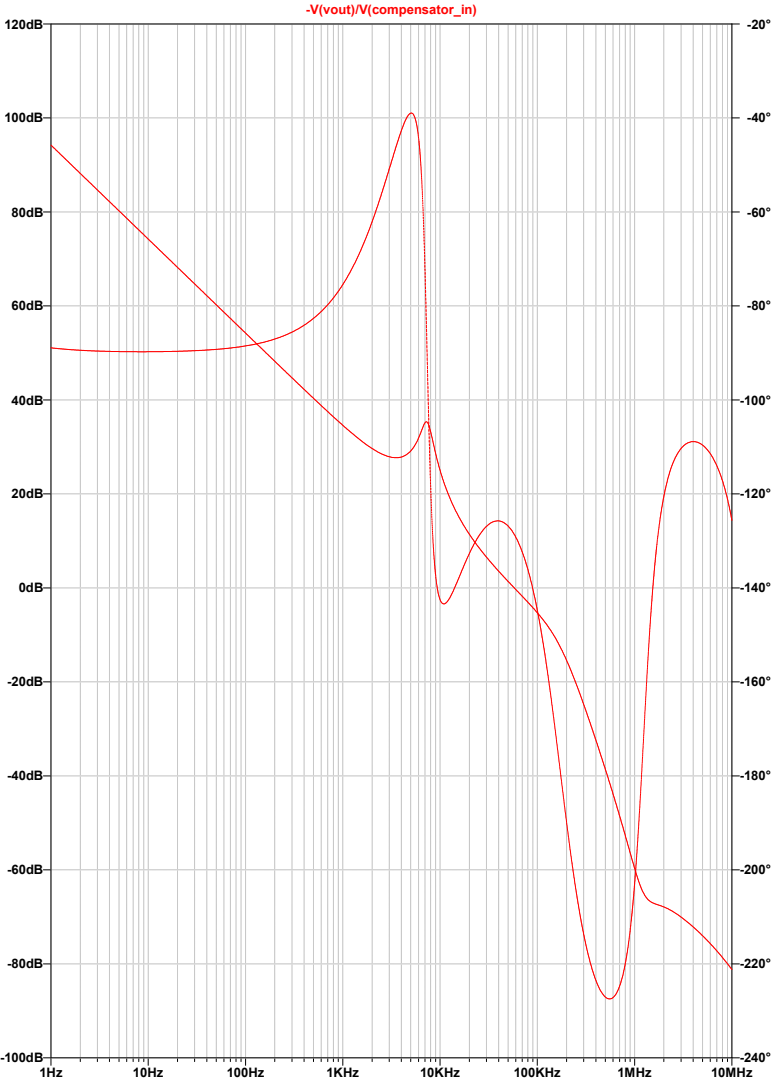
[picture p45: page 1]
1KHz; 10KHz; 100KHz; 1MHz; 10MHz; -V(vout)/V(compensator_in)

--- E:\Sync_Buck_convertor\simulations\compensator.raw ---
