Hrishikesh-Acharyya/Synchronous_buck_PMIC/simulations/graphs_or_pdfs/Figure2_Type_III_Compensator.pdf

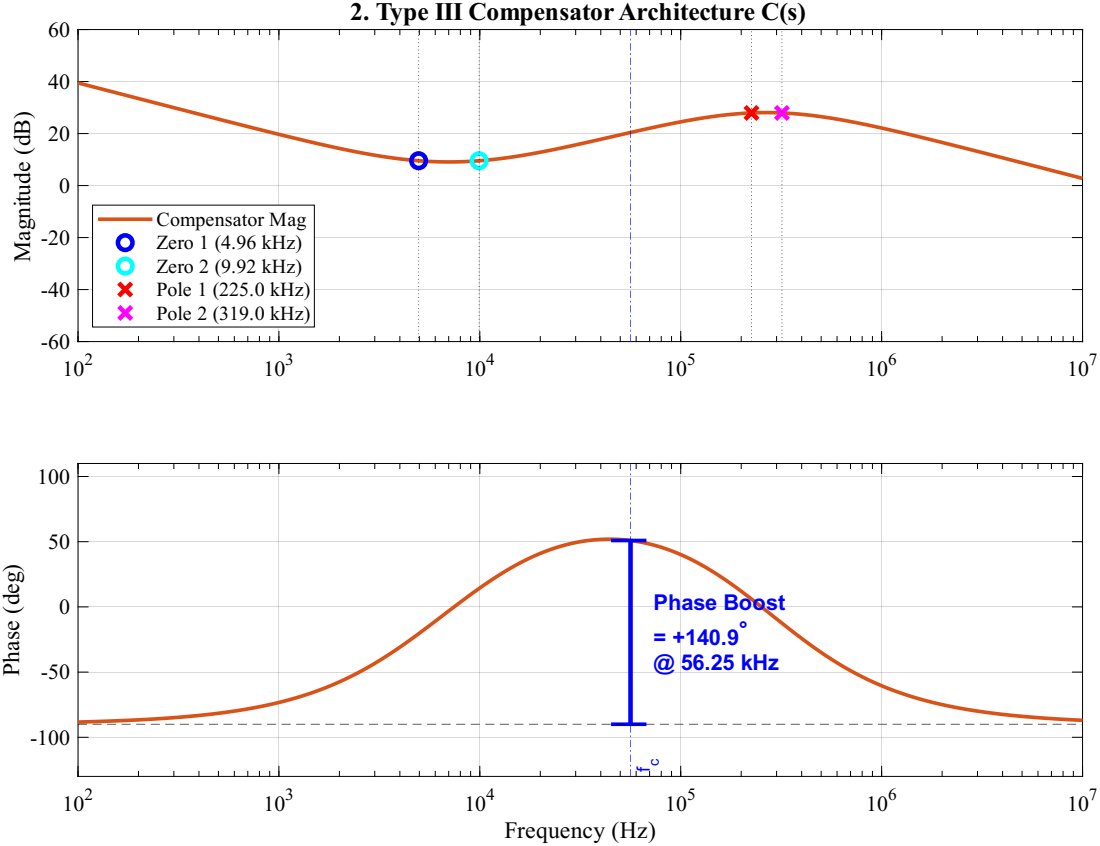
[picture p46: page 1]
gnitu; Compensator Mag Zero 1 (4.96 kHz) Zero 2 (9.92 kHz) Pole 1 (225.0 kHz) Pole 2 (319.0 kHz); Frequency (Hz); ase (d; Phase Boost = +140.9; ° @ 56.25 kHz

2. Type III Compensator Architecture C(s)
