Hrishikesh-Acharyya/Synchronous_buck_PMIC/simulations/graphs_or_pdfs/Figure3_Loop_Gain_Margins.pdf

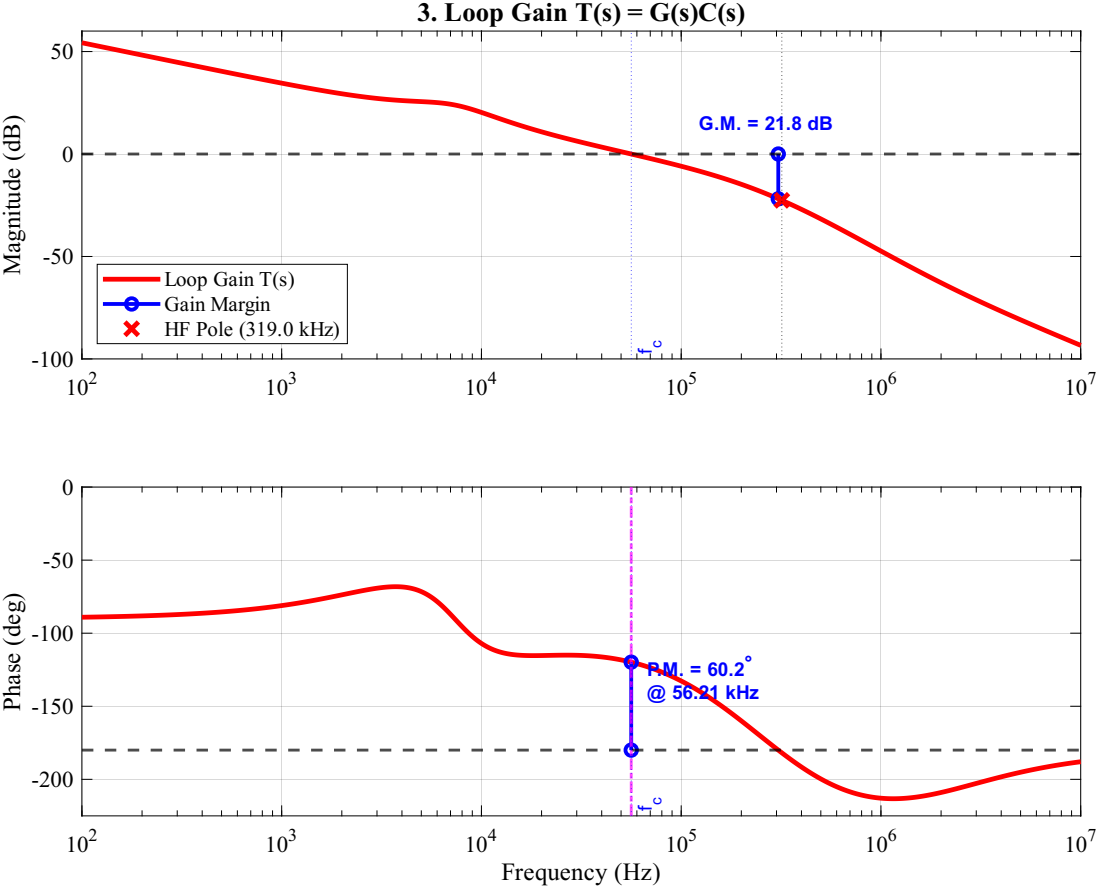
[picture p47: page 1]
nitu; 3. Loop Gain T(s) = G(s)C(s); Frequency (Hz); ase (d; ° @ 56.21 kHz

Loop Gain T(s)
Gain Margin
HF Pole (319.0 kHz)
