Hrishikesh-Acharyya/Synchronous_buck_PMIC/simulations/graphs_or_pdfs/Figure4_System_Overlay.pdf

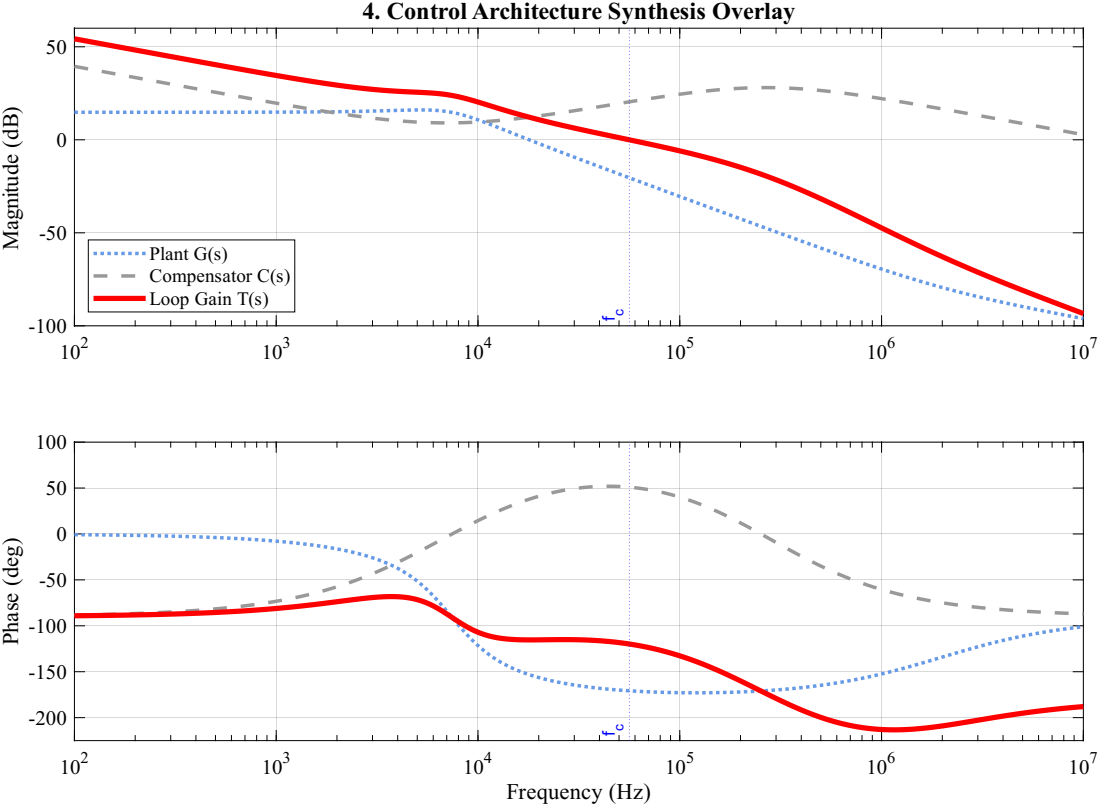
[picture p48: page 1]
Magnitude (dB); Phase (deg)
