Hrishikesh-Acharyya/Synchronous_buck_PMIC/simulations/graphs_or_pdfs/Figure5_System_Transients.pdf

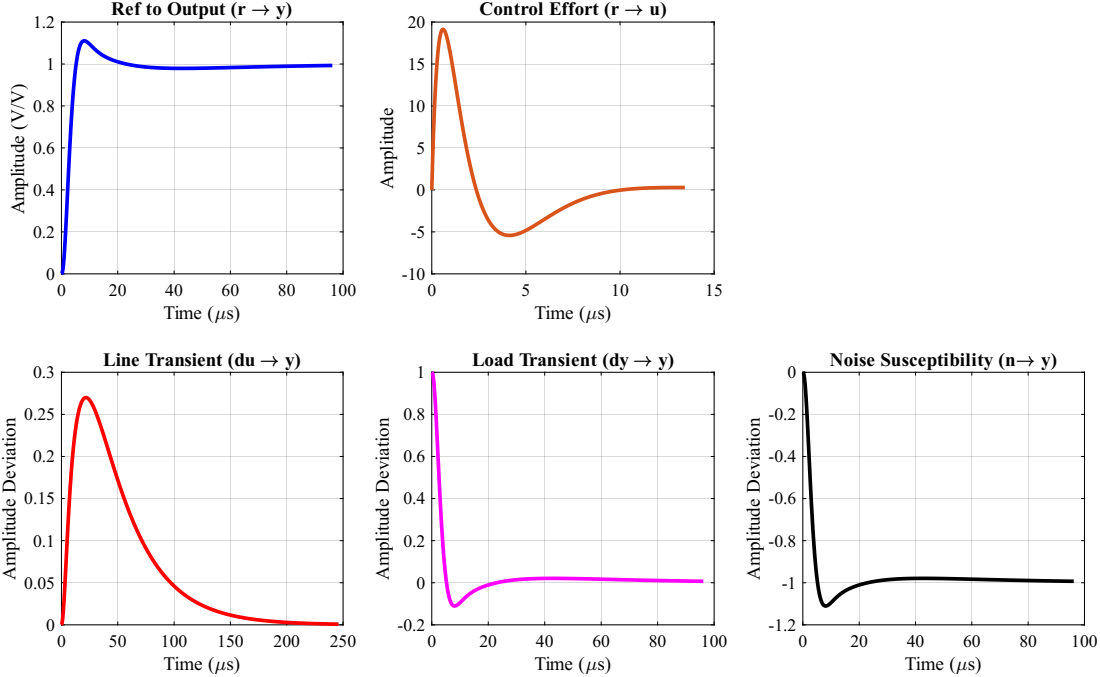
[picture p49: page 1]
Time (7s); Amplitu; mplitu; Control Effort (r ! u); viatio; Noise Susceptibility (n! y)

Ref to Output (r ! y)

Line Transient (du ! y)

Load Transient (dy ! y)
