Hrishikesh-Acharyya/Synchronous_buck_PMIC/simulations/graphs_or_pdfs/heavy_load_5A/Figure2_Type_III_Compensator_5A_Heavy_Load.pdf

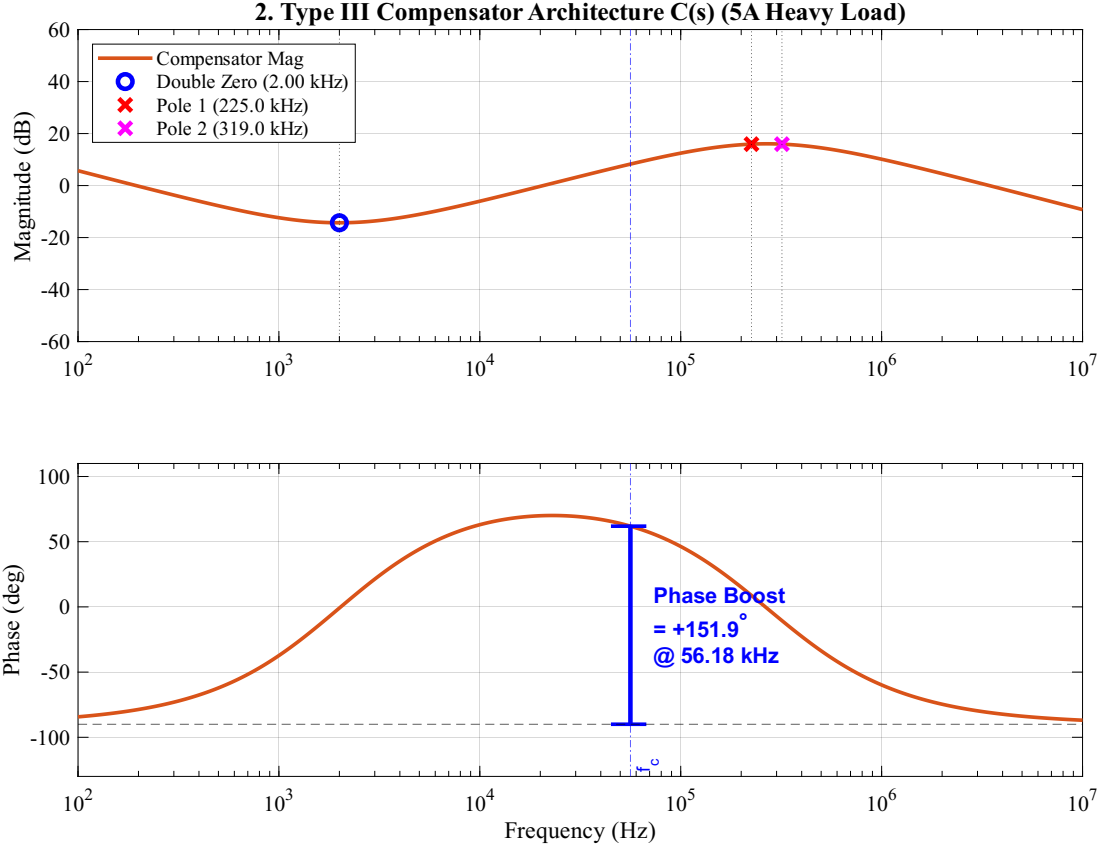
[picture p50: page 1]
gnitu; Frequency (Hz); ase (d; Phase Boost = +151.9; ° @ 56.18 kHz

2. Type III Compensator Architecture C(s) (5A Heavy Load)

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
