Hrishikesh-Acharyya/Synchronous_buck_PMIC/simulations/graphs_or_pdfs/heavy_load_5A/Figure3_Loop_Gain_Margins_5A_Heavy_Load.pdf

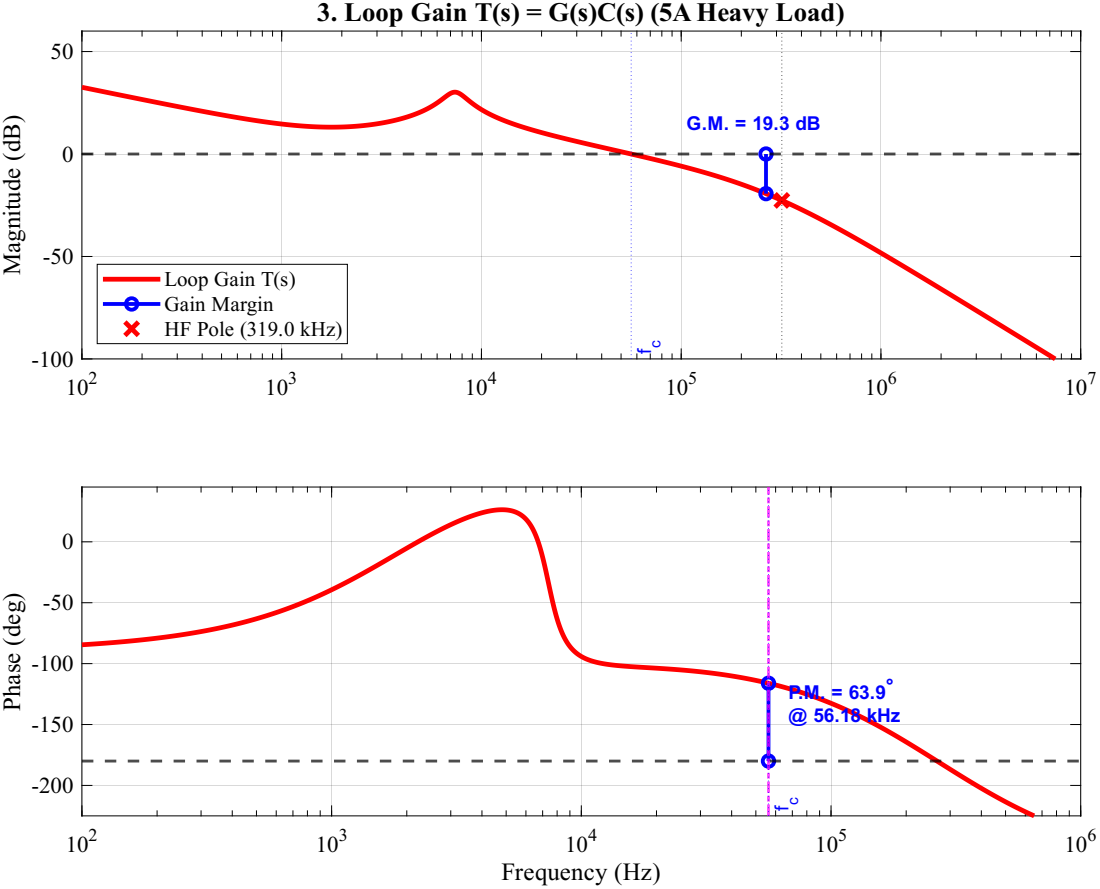
[picture p51: page 1]
nitu; Frequency (Hz); ase (d; ° @ 56.18 kHz

3. Loop Gain T(s) = G(s)C(s) (5A Heavy Load)

Loop Gain T(s)
Gain Margin
HF Pole (319.0 kHz)
