Hrishikesh-Acharyya/Synchronous_buck_PMIC/simulations/graphs_or_pdfs/heavy_load_5A/Figure5_System_Transients_5A_Heavy_Load.pdf

## System Transients (5A Heavy Load)

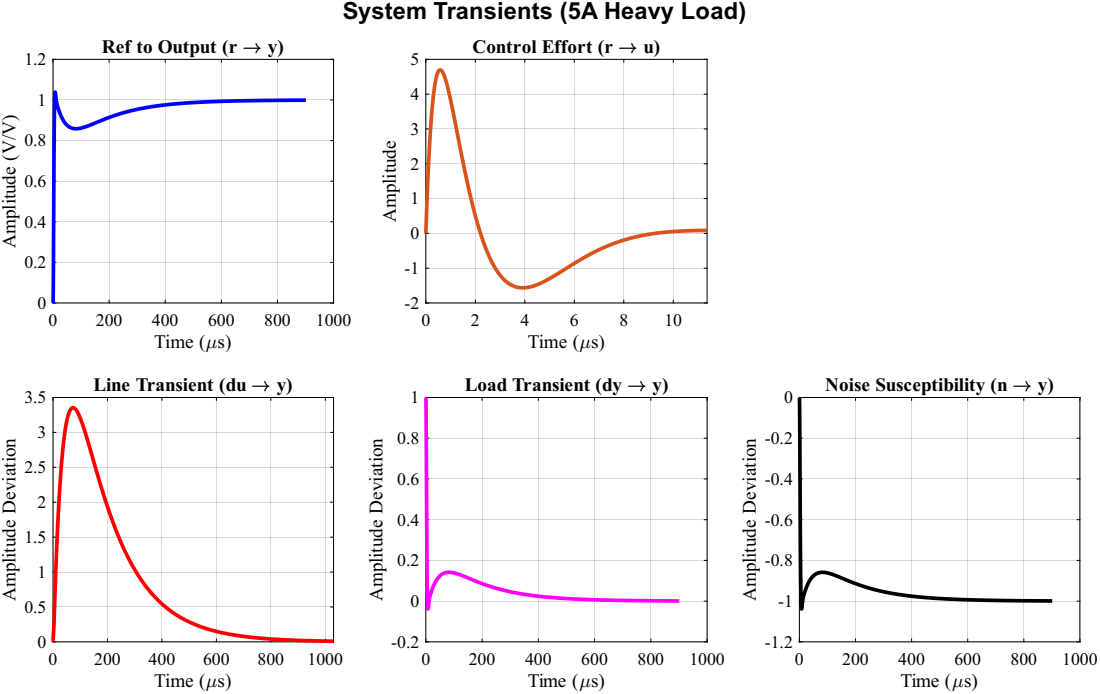
[picture p52: page 1]
Time (7s); mplitu; Control Effort (r ! u); viatio; Noise Susceptibility (n ! y)

Ref to Output (r ! y)

Line Transient (du ! y)

Load Transient (dy ! y)
