Hrishikesh-Acharyya/Synchronous_buck_PMIC/simulations/graphs_or_pdfs/very_light_load_uA/Figure3_Loop_Gain_Margins_uA_very_Light_Load.pdf

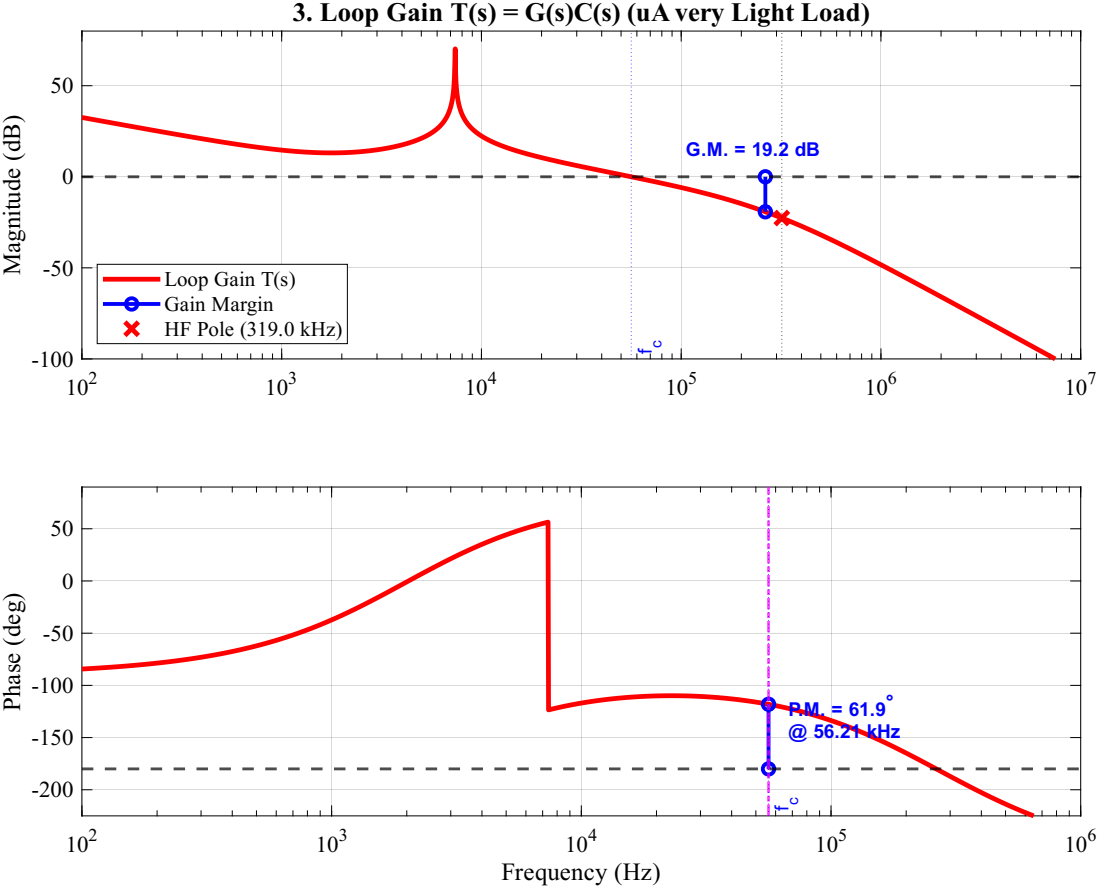
[picture p53: page 1]
nitu; Frequency (Hz); ase (d; ° @ 56.21 kHz

3. Loop Gain T(s) = G(s)C(s) (uA very Light Load)

Loop Gain T(s)
Gain Margin
HF Pole (319.0 kHz)
