Hrishikesh-Acharyya/Synchronous_buck_PMIC/simulations/graphs_or_pdfs/very_light_load_uA/Figure5_System_Transients_uA_very_Light_Load.pdf

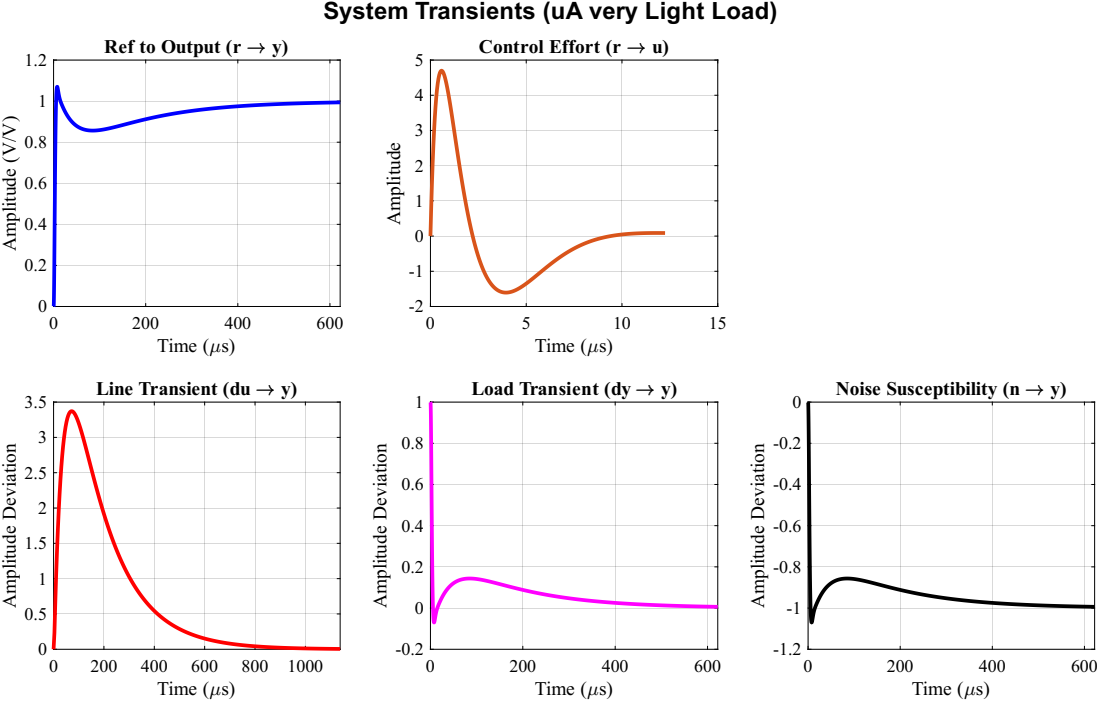
[picture p54: page 1]
Time (7s); mplitu; Control Effort (r ! u); viatio; Noise Susceptibility (n ! y)

System Transients (uA very Light Load)

Ref to Output (r ! y)

Line Transient (du ! y)

Load Transient (dy ! y)
