Hrishikesh-Acharyya/Synchronous_buck_PMIC/simulations/digital_architecture.asc

B1: bv; V=min(V(vin)-0.5, 4.4)
B2: bv; V=min(V(v_node)-0.5, 3.3)
B3: bv; V=min(V(vin)-0.5, 4.4)
B4: bv; V=min(V(v_node)-0.5, 3.3)
C1: cap; 27.77µ; V=25 Rser=2.94m Lser=0.6n
C2: cap; 27.77µ; V=25 Rser=2.94m Lser=0.6n
C3: cap; 27.77µ; V=25 Rser=2.94m Lser=0.6n
C4: cap; 100p
C5: cap; 100µ
C6: cap; 100µ
C8: cap; 1n
C9: cap; 10n
C10: cap; 100n; Rser=0.1
C11: cap; 47µ; Rser=0.05
C12: cap; 6.8n
Cc1: cap; 237p
Cc2: cap; 26.6n
Cf1: cap; 10n
Coss1: cap; 1.68n
coss_HS1: cap; 450p
D1: diode; 1N750
D2: diode; BAT54
D3: diode
D4: diode; 1N750
D5: diode; BAT54
D6: diode; BZX84C12L
D7: diode; BAT54
D8: diode; 1N5819
D9: diode; SMAJ5_0A
D10: diode
D11: diode; 1N5819
D12: diode; 1N5819
L1: ind; 5.6µ; Rser=1m
M1: pmos; PFET
M2: pmos; HEAVY_PMOS
M3: pmos; HEAVY_PMOS
M4: pmos; PFET
Q1: npn; 2N3904
Q2: pnp; 2N3906
Q3: npn; 2N3904
Q4: npn; 2N2222
Q5: npn; 2N2222
R1: res; 8k
R2: res; 10k
R3: res; 6.944k
R4: res; 10k
R5: res; 10k
R6: res; 5m
R7: res; 10k
R8: res; 5.41k
R9: res; 165k
R10: res; 10k
R11: res; 100k
R12: res; R=10k * exp(3950 * (1/(V(T_node)+273.15) - 1/298.15))
R13: res; 10k
R14: res; 10k
R15: res; 136.1k
R16: res; 186.8k
R17: res; 4.7k
R18: res; 4.7k
R19: res; 4.7k
R20: res; 10k
R21: res; 12K
R22: res; 10K
R23: res; 10k
R24: res; 10k
R25: res; 100k
R26: res; 1k
R27: res; 1k
R28: res; 1k
R29: res; 5m
R30: res; 10k
R31: res; 3.086k
R32: res; 83.3k
R33: res; 10k
R34: res; 50
R35: res; 1k
R36: res; 2.2
R37: res; 1
R38: res; 1
Rc1: res; 2.99k
Rf1: res; 7.91k
Rf2: res; 50
Rf3: res; 7.91k
S1: sw; HS_MOS
S2: sw; LS_MOS
U1: opamp2; tlv3501
U2: opamp2; OPA365
U3: opamp2; tlv3501
U4: opamp2; OPA365
U5: opamp2; tlv3501
U6: opamp2; tlv3501
U7: opamp2; tlv3501
U8: opamp2; tlv3501
U9: opamp2; tlv3501
V1: voltage; 2.5
V2: voltage; 5
V3: voltage; 5
V4: voltage; 22
V5: voltage; 5
V6: voltage; 5
V7: voltage; 5
V8: voltage; 1.65
V9: voltage; 3.3
V12: voltage; 5
V13: voltage; 5
V15: voltage; PWL(0 0 1m 5 6m 5 6.001m 0 7m 0)
V16: voltage; 2.5
V18: voltage; 5
V19: voltage; 2.5
V_bat1: voltage; PWL(0 0 1m 22)
V_bat2: voltage; PWL(0 0 1m 22)
V_buck1: voltage; PWL(0 0 3m 0 5.7m 5)
V_buck2: voltage; PWL(0 0 3m 0 5.7m 5)
V_pgood1: voltage; PWL(0 0 13.999m 0 14m 3.3)
V_pgood2: voltage; PWL(0 0 13.999m 0 14m 3.3)
Vref_comp1: voltage; 2.5
Vref_int1: voltage; 2.5
X1: CPLD_super
Named nets: 0, comp_out, Vout, V_trig, V_comp, V_sense, Master_PWM, V_temp_sense, PMOS_gate, PMOS_source, V_v+, npn_base, Battery_in, switch_node, latch_stat, OVP_out, To_External_MCU, External_crystal_osc, To_gate_driver_PWM_in, Fault_Leds, to_gate_driver_enable, Digital_trigger, PGOOD_comp, vin, v_node, v_out
.model FAULT_SW SW(Ron=10m Roff=1Meg Vt=2.5)
.model SMAJ5_0A D(Is=1n Rs=0.064 Bv=6.4 Ibv=10m Cjo=2000p)
Add button to drain the latch to break the loop and reset the latch without removing the battery
Get a integrated UVLO comparator for this, to prevent random triggering due to brownout situations
Or put a zener with a 3.3V
.model HEAVY_PMOS VDMOS(pchan Rg=2 Rd=5m Rs=2m Vto=-3.0 Kp=60 Cgdmax=3n Cgdmin=1n Cgs=5n Cjo=2n Is=20p mtriode=1 BV=55)
Maybe, give more time delay to this
.model LS_MOS SW(Ron=1.45m Roff=1Meg Vt=2.5 )
.model HS_MOS SW(Ron=9.2m Roff=1Meg Vt=2.5 )
SCP/OCP trigger
Type III COmpensator
Oscillator
PWM Generator
Over temperature Protection
OVP Protection
UVLO trigger
Plant
Final, masked PWM that
will be the gate driver input
INA181 current sense amp
Various gpios required to turn leds 
for visual debugging
INPUT_UVLO
Latch may be triggered by OVP event
or by the digital logic to handle prolonged
SCP events
checks if user used the button to drain latch
PGOOD (For secondary supply switching)
switch to buck output for IC supply
On pgood_en from supervisor, 
switch housekeeping supply from HV LDO to buck itself.
ORing topology to ensure continuation of supply and no
dip that may cause erratic bechaviour
POWER SUPPLY SWITCHING
.model PFET PMOS(Vto=-1.5 Kp=50 W=0.1 L=1u Rd=0.05 Rs=0.01)
POWER SUPPLY SWITCHING
.model PFET PMOS(Vto=-1.5 Kp=50 W=0.1 L=1u Rd=0.05 Rs=0.01)
