Hrishikesh-Acharyya/Synchronous_buck_PMIC/simulations/OVP_test.asc

C1: cap; 1n
C2: cap; 10n
C4: cap; 100n
D1: diode
D2: diode
D3: diode; SMAJ5_0A
D4: diode
Q1: npn
Q2: pnp
Q4: npn
R1: res; 12K
R2: res; 10K
R3: res; 100k
R4: res; 4.7k
R5: res; 4.7k
R6: res; 4.7k
R7: res; 10k
R8: res; 10k
R9: res; 10k
R11: res; 200k
U1: opamp2; tlv3501
V1: voltage; PWL(0 0 1m 5 5m 5 5.001m 0 7m 0)
V2: voltage; 2.5
V3: voltage; PWL(0 0 1m 5 1.0001m 15 1.0050m 5 3m 5 3.005m 6.5 7m 6.5); Rser=0.5
V4: voltage; PWL(0 0 1m 22)
Named nets: 0, V_in, V_v+, v_comp, v_gate, npn_base
.model SMAJ5_0A D(Is=1n Rs=0.064 Bv=6.4 Ibv=10m Cjo=2000p)
.tran 0 7m 0 startup
.include tlv3501.lib
Add button to drain the latch to break the loop to reset the latch without removing the battery
Get a integrated UVLO comparator for this, to prevent random triggering due to brownout situations
Or put a zener with a 3.3V
