Hrishikesh-Acharyya/Synchronous_buck_PMIC/simulations/behavioural_model_complete.asc

0.3: res; 0.5
A1: buf; Vhigh=5 Vlow=0 Ref=2.5 Td=50n
A2: dflop; DFLOP; Vhigh=5 Vlow=0 Ref=2.5 Trise=5n Tfall=5n Td=0n
A3: and; AND; Vhigh=5 Vlow=0 Ref=2.5 Trise=5n Tfall=5n
A4: buf; BUF; Vhigh=5 Vlow=0 Ref=2.5 Td=0n Trise=5n Tfall=5n
A5: and; Vhigh=5 Vlow=0 Ref=2.5 Trise=5n Tfall=5n
A6: or; Vhigh=5 Vlow=0 Vt=2.5 Trise=5n Tfall=5n
B3: bv; V=min(V(vin)-0.5, 4.4)
B4: bv; V=min(V(v_node)-0.5, 3.3)
C1: cap; 27.77µ; V=25 Rser=2.94m Lser=0.6n
C2: cap; 27.77µ; V=25 Rser=2.94m Lser=0.6n
C3: cap; 27.77µ; V=25 Rser=2.94m Lser=0.6n
C4: cap; 100p
C5: cap; 50n
C6: cap; 100p
C7: cap; 10n
C8: cap; 47µ; Rser=0.05
C9: cap; 1n
C10: cap; 10n
C11: cap; 100n; Rser=0.1
C12: cap; 6.8n
C13: cap; 100µ
Cc1: cap; 26.6n
Cc2: cap; 237p
Cf3: cap; 10n
Coss: cap; 1.68n
coss_HS: cap; 450p
D1: diode; BAT54
D2: diode; 1N5817
D3: diode
D4: diode; BAT54
D5: diode
D6: diode; BZX84C12L
D8: diode; 1N5819
D10: diode; BAT54
D11: diode; 1N5819
D12: diode; SMAJ5_0A
D13: diode
L1: ind; 5.6µ; Rser=1m
M1: nmos; FAULT_NMOS
M2: pmos; HEAVY_PMOS
M3: pmos; HEAVY_PMOS
M5: pmos; PFET
Q2: npn; 2N2222
Q3: npn; 2N3904
Q4: pnp; 2N3906
Q5: npn; 2N3904
R1: res; 8k
R2: res; 10k
R3: res; 6.944k
R4: res; 10k
R5: res; 4000
R6: res; 10m
R7: res; 100k
R8: res; 1k
R9: res; 100k
R10: res; 10k
R11: res; 100k
R12: res; R=10k * exp(3950 * (1/(V(T_node)+273.15) - 1/298.15))
R13: res; 10k
R14: res; 10k
R15: res; 136.1k
R16: res; 186.8k
R17: res; 1k
R18: res; 1G
R19: res; 1k
R20: res; 1k
R21: res; 3.5k
R22: res; 5m
R23: res; 10k
R24: res; 4.7k
R25: res; 4.7k
R26: res; 4.7k
R27: res; 10k
R28: res; 12K
R29: res; 10K
R30: res; 3.086k
R31: res; 10k
R32: res; 10k
R33: res; 100k
R34: res; 83.3k
R35: res; 1R
R36: res; 1
R38: res; 2.2
R39: res; 10k
R41: res; 10k
R42: res; 1k
R43: res; 1
R44: res; 10k
R45: res; 5.41k
R46: res; 165k
Rc1: res; 2.99k
Rf1: res; 7.91k
Rf2: res; 7.91k
Rf3: res; 50
S1: sw; HS_MOS
S2: sw; LS_MOS
S3: sw; FAULT_SW
S4: sw; FAULT_SW
U1: opamp2; tlv3501
U2: opamp2; OPA365
U3: opamp2; tlv3501
U4: opamp2; OPA365
U5: opamp2; tlv3501
U6: opamp2; tlv3501
U7: opamp2; tlv3501
U8: opamp2; tlv3501
U9: opamp2; tlv3501
U11: INA181A1
U12: opamp2; tlv3501
V1: voltage; 2.5
V2: voltage; 5
V3: voltage; 5
V4: voltage; 22
V5: voltage; 5
V6: voltage; 5
V7: voltage; 5
V8: voltage; 5
V9: voltage; PULSE(0 5 2.5m 1u 1u 0.5m 10m)
V10: voltage; 5
V11: voltage; 2.5
V12: voltage; 5
V13: voltage; 5
V14: voltage; PWL(0 25 3.5m 25 4m 125 4.5m 25 7m 25)
V15: voltage; PULSE(0 5 5.5m 1u 1u 1m 10m)
V16: voltage; 5
V17: voltage; 2.5
V18: voltage; PWL(0 0 1m 5 6m 5 6.001m 0 7m 0)
V19: voltage; 2.5
V20: voltage; 2.5
V22: voltage; 1.65
V23: voltage; 3.3
V_bat1: voltage; PWL(0 0 1m 22)
V_buck1: voltage; PWL(0 0 3m 0 5.7m 5)
V_pgood1: voltage; PWL(0 0 13.999m 0 14m 3.3)
Vref_comp1: voltage; 2.5
Vref_int1: voltage; 2.5
Named nets: 0, comp_out, Vout, V_trig, V_comp, AND_IN, V_sense, Master_PWM, PWM_signal, V_temp_sense, T_node, PMOS_gate, PMOS_source, V_v+, V_OVP_comp, npn_base, Battery_in, OTP_out, UVLO_out, switch_node, PGOOD_comp, vin, v_node, v_out
.model MYSW SW(Ron=0.01 Roff=1Meg Vt=2.5)
.options trtol=7 reltol=0.01 method=gear
.include OPA365.lib
.include tlv3501.lib
.options gmin=1e-10
.options ptrantau=0
To overcome the SHDN pin commands in the .lib file we have to include the .options param
.model FAULT_SW SW(Ron=10m Roff=1Meg Vt=2.5)
.model FAULT_NMOS VDMOS(Vto=2.5 Rd=10m)
.model SMAJ5_0A D(Is=1n Rs=0.064 Bv=6.4 Ibv=10m Cjo=2000p)
Add button to drain the latch to break the loop to reset the latch without removing the battery
Get a integrated UVLO comparator for this, to prevent random triggering due to brownout situations
Or put a zener with a 3.3V
.model HEAVY_PMOS VDMOS(pchan Rg=2 Rd=5m Rs=2m Vto=-3.0 Kp=60 Cgdmax=3n Cgdmin=1n Cgs=5n Cjo=2n Is=20p mtriode=1 BV=55)
Maybe, give more time delay to this
.tran 0 5ms 0 10n startup
.model LS_MOS SW(Ron=1.45m Roff=1Meg Vt=2.5 )
.model HS_MOS SW(Ron=9.2m Roff=1Meg Vt=2.5 )
Soft start circuit
Hiccuping circuit
SCP/OCP trigger
Type III COmpensator
Oscillator
PWM Generator
Over temperature Protection
OVP Protection
Old SCP/OCP
UVLO trigger
Faulty load
PWM masking 
and splitting
Plant
Over voltage fault switch
Directives
.include ina181a1.LIB
PGOOD (For secondary supply switching)
POWER SUPPLY SWITCHING
.model PFET PMOS(Vto=-1.5 Kp=50 W=0.1 L=1u Rd=0.05 Rs=0.01)
