Hrishikesh-Acharyya/Synchronous_buck_PMIC/simulations/behavioural_model_bare.asc

C1: cap; 27.77µ; V=25 Rser=2.94m Lser=0.6n
C2: cap; 27.77µ; V=25 Rser=2.94m Lser=0.6n
C3: cap; 27.77µ; V=25 Rser=2.94m Lser=0.6n
C4: cap; 0.1µ
C5: cap; 100p
Cc1: cap; 26.6n
Cc2: cap; 237p
cf3: cap; 10n
D1: diode; MBRS340
D2: diode; 1N5817
I1: load2; PULSE(0.5 5 4m 1u 1u 1m 2m)
L1: ind; 5.6µ; Rser=1m
R1: res; 10k
R4: res; 8k
R5: res; 10k
R6: res; 6.944k
Rc1: res; 2.99k
Rf1: res; 7.91k
Rf2: res; 7.91k
Rf3: res; 50
S1: sw; MYSW
U1: opamp2; OPA365
U4: opamp2; tlv3501
U5: opamp2; OPA365
U6: opamp2; tlv3501
V1: voltage; 2.5
V2: voltage; 5
V3: voltage; 5
V6: voltage; 22
V7: voltage; 5
V8: voltage; 5
Vref_comp2: voltage; 2.5
Vref_int2: voltage; 2.5
Named nets: 0, comp_out, Vout, V_trig, V_comp
.model MYSW SW(Ron=0.01 Roff=1Meg Vt=2.5)
.include OPA365.lib
.include tlv3501.lib
.tran 0 8m 0 startup
.options gmin=1e-10
To overcome the SHDN pin commands in the .lib file we have to include the .options param
Spice directives and comments
oscillator
Compensator and error amplifier
PWM generator
Power plant
Soft start circuit with hot restart diode
