Hrishikesh-Acharyya/Synchronous_buck_PMIC/simulations/compensator_and_plant.asc

C1: cap; 27.77µ; V=25 Rser=2.94m Lser=0.6n
C2: cap; 27.77µ; V=25 Rser=2.94m Lser=0.6n
C3: cap; 27.77µ; V=25 Rser=2.94m Lser=0.6n
Cc1: cap; 26.6n
Cc2: cap; 237p
Cf3: cap; 10n
E1: e; 5.5
L1: ind; 5.6µ; Rser=1m
Rc1: res; 2.99k
Rf1: res; 7.91k
Rf2: res; 7.91k
Rf3: res; 50
Rload: res; 1
U1: UniversalOpAmp
V1: voltage; 2.5
V2: voltage; 5
V3: voltage; ""; AC 1
Named nets: 0, Compensator_in, comp_out, Vout
.op
.ac dec 1000 1 10meg
COMPENSATOR
MODULATOR
PLANT
SIMULATIONS
.tran 5m
