Hrishikesh-Acharyya/Synchronous_buck_PMIC/simulations/oscillator.asc

C1: cap; 100p
R5: res; 8k
R6: res; 10k
R7: res; 6.944k
U1: opamp2; OPA365
U2: opamp2; tlv3501
V1: voltage; 5
V2: voltage; 5
Vref_comp: voltage; 2.5
Vref_int: voltage; 2.5
Named nets: 0, V_trig, V_comp
.include OPA365.lib
.include tlv3501.lib
.tran 0 100u 50u startup
.options gmin=1e-10
To overcome the SHDN pin commands in the .lib file we have to include the .options param
