Hrishikesh-Acharyya/Synchronous_buck_PMIC/(list of files, drawings)

Other design files:
Sync_buck_convertor/Sync_buck_convertor.PrjPcb
