Hrishikesh-Acharyya/Synchronous_buck_PMIC/rtl-systemverilog/protect/fault_arbiter.sv

/*

# Filename:         fault_arbiter.sv

# File Description:  Rolling-window overcurrent detector. Samples the
#                    current-protection flag at the valley, one sample per
#                    switching cycle taken at the rising edge of pwm_sync,
#                    and asserts window_trip / window_trip_SS when the
#                    number of faulted cycles within the trailing window
#                    reaches the threshold for the present state. Two
#                    thresholds are used because elevated current during
#                    soft start is expected as the output capacitor charges,
#                    whereas sustained overcurrent in S_RUN is a real load
#                    fault.
#
#                    Each trip is asserted only while its own state is
#                    active: window_trip only in S_RUN, window_trip_SS only
#                    in S_SS. The soft-start count is not cleared on the
#                    S_SS -> S_RUN transition - it holds through S_RUN for
#                    telemetry - so without the gate a count that reached
#                    trip_ss on the very edge the FSM left S_SS (or a TRIP_SS
#                    lowered during S_RUN) would hold window_trip_SS high
#                    through the whole run, and fault_cause would log an
#                    overcurrent that never happened.

# Global variables: None

*/
`timescale 1ns/1ps
`default_nettype none

module fault_arbiter #(
    
    // WINDOW_RUN: trailing switching cycles examined while in S_RUN
    parameter int WINDOW_RUN = pmic_types_pkg::WINDOW_RUN,
    // WINDOW_SS: trailing switching cycles examined while in S_SS
    parameter int WINDOW_SS  = pmic_types_pkg::WINDOW_SS,
    // BLANK_CLKS: clocks of lookback applied to cp_sync, so the sample
    //             taken at pwm_rise reads the comparator as it was before
    //             high-side turn-on rather than during the switch-node slew.
    //             Must be >= 2; the shift concatenation below is malformed
    //             at 1.
    parameter int BLANK_CLKS = 5
    
) (
    input  wire logic clk,
    input  wire logic rst_n,
    input  wire logic pwm_sync,        // synchronised raw PWM, for the cycle boundary
    input  wire logic cp_sync,         // synchronised current-protection flag (CP_trig)
    input  wire logic ss_active,       // high only while the supervisor is in S_SS
    input  wire logic run_active,      // high only while the supervisor is in S_RUN
    input  wire logic [pmic_types_pkg::TRIP_W-1:0] trip_run, // TRIP_RUN: faulted cycles within WINDOW_RUN that assert window_trip
    input  wire logic [pmic_types_pkg::TRIP_W-1:0] trip_ss,  // TRIP_SS: faulted cycles within WINDOW_SS that assert window_trip_SS
    output logic window_trip,     // fault window exceeded while running
    output logic window_trip_SS,   // fault window exceeded during soft start
    output logic [$clog2(WINDOW_RUN+1)-1:0] fault_count_run_out,   // telemetry output
    output logic [$clog2(WINDOW_SS+1)-1:0]  fault_count_ss_out    // telemetry output
);

    localparam int FCNT_RUN_W = $clog2(WINDOW_RUN+1);
    localparam int FCNT_SS_W  = $clog2(WINDOW_SS+1);
    // pwm_sync_d: pwm_sync delayed one clk, used to detect the cycle start
    logic pwm_sync_d;
    // pwm_rise: one-clk pulse marking high-side turn-on, i.e. the end of
    //           the low-side conduction period
    logic pwm_rise;
    // fault_shifter_SS: 32 bit register, each bit is the CP_trig value for one switching cycle,
    // sampled at the valley, with the most recent cycle in bit 0. Shifted
    // left each cycle to make room for the new sample
    logic [WINDOW_SS-1:0] fault_shifter_SS;
    //fault_shifter_RUN: 16 bit register for RUN state fault handling
    logic[WINDOW_RUN-1:0] fault_shifter_RUN;
    // fault_count_run: faulted cycles within the trailing WINDOW_RUN bits
    logic [FCNT_RUN_W-1:0] fault_count_run;
    // fault_count_ss: faulted cycles within the trailing WINDOW_SS bits
    logic [FCNT_SS_W-1:0] fault_count_ss;
    // cp_delay: shift register of cp_sync; bit [BLANK_CLKS-1] holds the
    //           comparator state from BLANK_CLKS clocks ago
    logic [BLANK_CLKS-1:0] cp_delay;


    always_ff @(posedge clk or negedge rst_n) begin
    /*
    Purpose:
    ---
    Create a one-clock delayed copy of the synchronised PWM so that the 
    start of a switching cycle can be detected combinationally below.
    */
    
    if(!rst_n) begin

        pwm_sync_d <= 0;

    end

    else

      pwm_sync_d <= pwm_sync;


    end

    always_comb begin
    /*
    Purpose:
    ---
    Detect the rising edge of the switching cycle and produce a one-clk
    enable pulse. The sample is taken here
    because the end of low-side conduction is where inductor current is at
    its valley: valley sits one half-ripple below the average load current,
    and ripple amplitude varies strongly across the 10.8-22 V input range,
    so a fixed threshold on the valley tracks load current far more closely
    than one on the peak would. Peak sampling would make the effective trip
    current fall as Vin rises.

    The peak itself is not measurable here. It occurs at commutation, and
    the low-side FET only carries it during the reverse-recovery and
    ringing that follows its turn-on - the current has already fallen
    appreciably by the time the switch node settles enough to measure.
    */
      pwm_rise = ~pwm_sync_d & pwm_sync;

    end


    always_ff @(posedge clk or negedge rst_n) begin
    /*
    Purpose:
    ---
    Hold a short history of cp_sync so that the sample latched at pwm_rise
    is the comparator state from BLANK_CLKS clocks earlier. Sampling at the
    edge itself would read the comparator during high-side turn-on, where
    the switch node slews tens of volts in nanoseconds and the sense signal
    is unusable. Looking backward rather than delaying the enable keeps the
    sample inside the low-side conduction period at every duty cycle.
    */

      if (!rst_n) begin

        cp_delay <= '0;

      end

      else if (!run_active && !ss_active) begin

        cp_delay <= '0;

      end

      else begin

        cp_delay <= (cp_delay << 1) | BLANK_CLKS'(cp_sync);

      end

    end


    always_ff @(posedge clk or negedge rst_n) begin
    /*
    Purpose:
    ---
    Maintain a rolling window of the current-protection flag, one bit per
    switching cycle, and a running count of the faulted cycles within it.

    The flag is sampled as a level rather than as an edge: the comparator has
    hysteresis and holds high for as long as the overcurrent persists, and
    what matters thermally is the fraction of recent cycles spent in
    overcurrent, not how many separate excursions occurred. A single
    sustained fault must trip the window, and edge counting would never see
    it.

    The counts are maintained incrementally - plus the bit entering, minus
    the bit leaving the window - rather than by summing the register every
    clock, which would synthesise to a wide adder tree. Both reads use the
    pre-edge register value, so the indexed bit is the one about to be
    displaced.

    Both windows are cleared whenever neither state is active, so a hiccup
    retry starts on a clean window rather than re-tripping immediately on
    the history that caused the trip. cp_delay is cleared on the same
    condition, so the retry also starts without the
    comparator history from before the converter was switching - the CP
    synchroniser resets high, so that history would otherwise enter the
    fresh window as spurious faulted cycles.
    */

    if(!rst_n) begin

      fault_shifter_RUN <= 0;
      fault_shifter_SS <=0;
      fault_count_run <= 0;
      fault_count_ss <=0;

    end

    else if (pwm_rise && run_active) begin

      fault_count_run <= fault_count_run + FCNT_RUN_W'(cp_delay[BLANK_CLKS-1])
                                         - FCNT_RUN_W'(fault_shifter_RUN[WINDOW_RUN-1]);
      fault_shifter_RUN <= (fault_shifter_RUN << 1) | WINDOW_RUN'(cp_delay[BLANK_CLKS-1]);

    end


    else if (pwm_rise && ss_active) begin

      fault_count_ss <= fault_count_ss + FCNT_SS_W'(cp_delay[BLANK_CLKS-1])
                                       - FCNT_SS_W'(fault_shifter_SS[WINDOW_SS-1]);
      fault_shifter_SS <= (fault_shifter_SS << 1) | WINDOW_SS'(cp_delay[BLANK_CLKS-1]);
      
    end 

    else if (!run_active && !ss_active) begin

      fault_shifter_RUN <= 0;
      fault_shifter_SS <= 0;
      fault_count_run <=0;
      fault_count_ss <= 0;

    end


    end

    // Thresholds differ because elevated current during soft start is
    // expected as the output capacitor charges from zero in FCCM, whereas
    // sustained overcurrent in S_RUN is a genuine load fault.
    // Each trip is gated by its own state, so neither can be high outside
    // it: the soft-start count stays frozen through S_RUN and may sit at or
    // above trip_ss there, and the run count takes one edge to clear after
    // S_RUN is left.
    always_comb window_trip    = run_active && (pmic_types_pkg::TRIP_W'(fault_count_run) >= trip_run);
    always_comb window_trip_SS = ss_active  && (fault_count_ss >= trip_ss);
    always_comb fault_count_run_out = fault_count_run;
    always_comb fault_count_ss_out = fault_count_ss;

endmodule

`default_nettype wire
