Hrishikesh-Acharyya/Synchronous_buck_PMIC/(commit log)

2026-06-18 Initial commit: Scraper setup and folder architecture
    [Sync_buck_convertor.PrjPcb]
2026-06-18 Added code to scrape mosfets from digikey website. Generated the parts and pdf urls in an excel file
    [mosfet_urls.xlsx]
2026-06-19 Added Mouser scraper. Mouser scraper performed better compared to digikey, with significantly lesser broken links
    [mosfet_urls.xlsx]
2026-06-20 Wrote gemini api pdf data extractor and wrote upto 50 components. Made changes to the code to rotate between 10 api keys to delay rate hit limit. Update excel sheet after every hit and rotate api aft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
    [mosfet_urls.xlsx]
2026-06-20 Scoured 300 models
    [mosfet_urls.xlsx]
2026-06-20 added about 600 mosfets. Created ltspice simulation schematic
    [mosfet_urls.xlsx]
2026-06-20 Added more mosfets
    [mosfet_urls.xlsx]
2026-06-21 Added 1084 mosfets, api read all datasheets and extracted the required data
    [mosfet_urls.xlsx]
2026-06-21 Added code to clean up excel file and reject unsuitable ones (vgs<18V and ids<7.5A and through hole or non handsolderable/hot air reflow workable packages. Cleaned excel file is the new cleaned_mosfe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
    [cleaned_mosfets.xlsx]
2026-06-21 Rank High side J/K optimization algorithm on a frequency sweep of 25khz spacing from 100khz to 800khz and extracted top 5 mosfets in each bracket
    [High_side_frequency_optimization_matrix.xlsx, mosfet_urls.xlsx]
2026-06-21 Wrote low side JK optimiser code and generated top 5 mosfets for frequency range 100k-800k in brackets of 25k for the low side.
    [High_side_frequency_optimization_matrix.xlsx]
2026-06-24 Added output ceramic and bulk capacitor selections
2026-06-26 Generated Matlab control system app to design the compensator stage. Tuned the poles and zeros to achieve a very good 60 degree phase margin at crossover and a 140.9 degree phase boost from the compe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
2026-06-27 Updated code to handle UCC27282 assymetric sink/source drive and generate new list of mosfets suitable for this gate driver
    [High_side_frequency_optimization_matrix.xlsx]
2026-06-27 Changed folder structure. Made separate folder for all excel files. Removed .xlsx files and .csv files from gitignore. Made mosfet selection for new UC22728 gate driver IC, updated excel file locatio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
    [High_side_frequency_optimization_matrix_UCC27282.xlsx, High_side_frequency_optimization_matrix__LM5106.xlsx, cleaned_mosfets.xlsx, low_side_frequency_matrix_UCC27282.xlsx, low_side_frequency_matrix__LM106.xlsx, mosfet_urls.xlsx]
2026-06-27 Created LTspice model of the pwm generator using schmidt trigger based relaxation oscillator using OPA365 and TLV3501 opamp and comparator
2026-06-27 Simulated a behavioural model of the circuit, combining the plant, compensator and error amp, and the oscillator. Instead of the gate driver, a LTspice switch was used on HS, and a diode was used on 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
2026-06-28 Changed to LM5106 gate driver. Updated code for assymetric drive. Update LS math to account for dead time losses to through body diode instead of assuming transition losses as they don't exist in thi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
    [High_side_frequency_optimization_matrix__LM5106.xlsx, low_side_frequency_matrix_LM5106.xlsx, low_side_frequency_matrix__LM106.xlsx]
2026-06-28 Changed dead timing and ran optimization again. Generated new excel list
    [low_side_frequency_matrix_LM5106.xlsx]
2026-06-30 Half implementd short circuit and over current protection on output side using LS sensing combined with valley current limiting, soft start capacitor draining to prevent transient spikes, hysteresis 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
2026-07-02 Successfully added SCP/OCP protection using valley current limiter circuit and soft start capacitor shorting using a RC delay to make the capacitor ready to provide soft start again to prevent transi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
2026-07-04 Completed OVP protection circuit. Integrated with main circuit and added a OVP PMOS. Works well. MAybe have to tune the trigger timing to handle handoff from TVS to OVP lockout. Add button to clear l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
2026-07-05 Added UVLO protection. hysteresis from 10.3 - 10.9V. Buck now handles 3s,4s and 5s. Stress tested all the faults, starting from UVLO to thermal shutdown, to Short circuit and at last HS MOSFET short 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
2026-07-05 Simulation at light loads revealed the control loop did not create enough phase boost at LC double pool. Hence when Q factor increased with a lighter load (More resistance), Vout oscillated and curre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
2026-07-05 Added ZCD to pull circuit to enable DEM when circuit goes to DCM mode at light loads. Circuit works but outputs random values between two legitimate signals. Switch node spikes to 250V
2026-07-09 Changed OCP/SCP circuit. Added a current sense ic to sense the ls mos low side. Increased Rsense form 5m to 10m.
2026-07-11 Tried to add ZCD analog circuit. Added PGOOD circuitry
2026-07-12 Corrected PGood circuit. Vth = 4.8, Vtl = 4.5V. Changed ZCD circuit but couldnt makle it work yet.
2026-07-25 Update README: clarify architecture, reference existing figures, move hiccup to digital, emphasise JK optimiser MOSFET selection, note fast-sim and clean Vout, mark thermal modelling pending
2026-07-25 Add circuit diagram and simulation waveform images
2026-07-25 Revise README for recruiter-friendly professional presentation with integrated circuit diagrams and waveforms
2026-07-25 Restructure sections: merge Control Loop Design with Bode/transient analysis; separate Converter Waveforms as top-level heading; keep all circuit images embedded; remove unnecessary links
2026-08-23 Add CPLD supervisor RTL with self-checking testbench and CI (#1)
    Brings the supervisory control layer into the repository as RTL, with
    verification and continuous integration, and corrects several factual
    errors in the README.
    RTL
    - rtl/supervisor.v: four-state sequencing and fault-arbitration FSM
    (S_OFF, S_SS, S_RUN, S_HICCUP). Two functional bugs fixed relative to
    the bring-up version: soft-start advanced after a single clock instead
    of holding for SS_done, and latch_assert was evaluated only in
    S_HICCUP, leaving state and output in disagreement during S_RUN and
    re-enabling at full duty on release.
    Verification
    - tb/supervisor_tb.sv: 20 counted checks across 8 groups, ending in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
    [High_side_frequency_optimization_matrix_LM5106.xlsx]
2026-09-14 add pmic_types_pkg with FSM state enum and timing parameters
    Single definition of state_t shared by RTL and testbench, so a re-encoding
    updates the design and every check against it together. Also declares
    HICCUP_OFF_CYCLES and MAX_STRIKES ahead of the hiccup timer work.
2026-09-14 tb: rewrite supervisor testbench in SystemVerilog
    Replaces the Verilog-2001 testbench. Clocking block removes the #1 settling
    workaround and the races it papered over; check() is an automatic void
    function reporting state and en independently so one mismatch cannot mask
    the other; enum .name() gives symbolic failure messages.
    New coverage over the previous version: S_HICCUP -> S_OFF, asynchronous
    reset asserted mid-operation, and simultaneous-fault priority. 32 checks.
    [supervisor_tb.sv]
2026-09-18 Added soft_start.sv which generated the SS_Done flag and creates the dynamic pulse envelope, and pwm_mask which masks the synhronised pwm with the generated pulse envelope to create a soft start ramp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
2026-09-26 Added fault_arbiter.sv. Identifies if the short circuit/overcurrent event has persisted for long enough through rolling window shift registering. Ourputs window_trip and window_trip SS that move the 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
    [fault_arbiter.sv, hiccup_timer.sv, strike_counter.sv]
2026-09-26 Created strike_counter.sv that counts the number of time hiccup state was enetered. Increments the strikes per hiccup,and finally when max strikes reached, it triggers the physical latch in the board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
    [strike_counter.sv]
2026-09-27 PGOOD went to MCU as an output pin in digital architecture. Wring behaviour. Corrected to take input from the analog PGOOD comparator. Net name changed to PGOOD_comp. On behavioural model complete, c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
2026-09-27 Changed CPLD structure to provide for secondary switching signal when it processes PGOOD.
2026-09-27 Added pgood.sv. Tells the fpga to fire the switching output to derive power from the buck output itself rather than the input source. Waits 12 cycles after analog comparator trip to assert PGOOD out.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
2026-09-27 Dropped icarus from makefile as it doesnt support clocking blocks. The CI now runs lint only which is fine as testbenching is human job. Updates tb portlist and minute struvctural changes that came w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
2026-09-27 lint changes
    [Sync_buck_convertor.PrjPcb]
2026-09-28 Moved constants to pmic_type_packages to prevent drift between different files at a later time when the constants are changed as per the user requires.
    [fault_arbiter.sv, hiccup_timer.sv, pgood_gen.sv, pmic_types_pkg.sv, pwm_mask.sv, soft_start.sv, strike_counter.sv]
2026-09-28 syntax error in pgood module
    [pgood_gen.sv]
2026-09-28 edited strike_counter comments and pgood comments and missing semicolon on pgood module
    [pgood_gen.sv, strike_counter.sv]
2026-09-28 Only changes made to strike counter and PGOOD. Lint errors are corrected. Ignore rest.
    [pmic_types_pkg.sv, strike_counter.sv]
2026-09-28 g_en was defined as an input port from mcu. That was wrong. MCU only gets to communicate via I2C. G_en port converted to a physical enable switch on the board for human intervention. External MCU can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
    [pmic_top.sv, supervisor.sv]
2026-09-29 Add PYNQ harness and clean signal declarations
    This change adds a PYNQ-Z2 hardware test harness that wraps the existing PMIC RTL with a generated 50 MHz clock, analog-side PWM emulation, fault inputs, and status LEDs/PMOD outputs for hands-on validation. It also standardizes the RTL input declarations to `wire logic` across the design for cleaner signal semantics and compatibility. The Vivado project/cache files for the new PYNQ target are included with the harness.
2026-09-29 Add PYNQ-Z2 testbench and board constraints
    Add a new self-checking SystemVerilog testbench (`fpga/pynq_test_tb.sv`) for `pynq_test_top` that exercises startup, soft-start, PGOOD behavior, OTP/UVLO shutdown, overcurrent hiccup/latch-off, and reset/latch-clear recovery. Add PYNQ-Z2 Vivado constraints (`fpga/pynq_z2.xdc`) with clock, switch/button/LED/PMOD pin mappings plus async false-path and synchronizer `ASYNC_REG` directives. Update `.gitignore` to exclude local `vivado/` project outputs.
    [pynq_test_tb.sv, pynq_z2.xdc]
2026-09-29 PYNQ-Z2 harness: constraints and self-checking testbench, verified on board
2026-09-30 Added behavioural ORing model to switch housekeeping supply from input battery HV LDO to 5v rail itself. ORing topology used to prevent any dips in the supply to the comparators or the supervisor its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
2026-10-01 Correct behaviour enforced for power supply switch
2026-10-02 Corrected fault_arbiter.sv, logic. Used to sample at falling edge which is the start of LS conduction. Wrong logic fro valley cuurent sensing. Moved to pwm rise edge detection with read delay in CP t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
    [fault_arbiter.sv]
2026-10-02 Added fault debouncing for UVLO, OTP, physical switch enable and latch stat. Appended into pmic_top and package. Changed name of pin from clk_external to clk in digital_superviso.asc
2026-10-02 Added new files to makefile. Corrected naming errors and casting warnings
    [input_debounce.sv, pmic_top.sv]
2026-10-02 Added pwm_stats in telemetry/. Gives duty cycle of the incoming pwm, sized according to the current oscillator period, and not the standard value of period derived from ideal values, hence duty value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
    [pwm_stats.sv]
2026-10-02 Corrected pwm_stats.sv. code. No longer outputs duty which requires a hardware divider but rather outputs duty count and period count which may eb divided together to get duty cycle. Also period coun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
    [pwm_stats.sv]
2026-10-04 Changed code structure to allow for SPI based MCU to override certain parameters
2026-10-04 Created reg_file which acts as a bridge between the SPI module and the rest of the modules, acting as the dictionary holding all the telemetry, control signals and policy
2026-10-04 Added files to makefile. Caught lint errors and corrected them
    [reg_file.sv]
2026-10-04 spi_enable could go high even when bad transactio(crc check failed), because crc was being checked after sending spi_enable signal. Changed that behaviour to pull spi_enable only after CRC check pass
    [reg_file.sv]
2026-10-04 Wrote SPI module for the supervisor and added file to Makefile
2026-10-04 Edited PMIC_TOP to now include spi
2026-10-05 Glitch free operaton of spi lines using input_debounce only, no new module needed to be written.
    [pmic_top.sv, spi_slave.sv]
2026-10-10 Corrected hicuping behaivour. Only 2 retries, latch on 3rd, not 3 retries. Also cooldown loves exponentially. Beautification of code done sporadically
    [hiccup_timer.sv, pmic_types_pkg.sv, reg_file.sv, strike_counter.sv]
2026-10-11 Added 5 fault LEDs
2026-10-15 Added timescale direcive to all rtl modules to satiate verilator errors. Wrote rst pin testbench
2026-10-22 Created input_sync testbench, and its sva file. Currently sva file holds one property, its assertion and ots cover. wrote bind_sva to hold all bindings of sva into rtl. sva_pkg holds the sva failure 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
2026-10-28 Ran sv2v on current design and converted system verilog code into verilog-2005 to make it compliant with opensource ASIC flow tools. Build folder contains the equivalent verilog code, ~2200 lines. Ra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
2026-10-28 sva file written for pwm_mask.sv
2026-10-28 Made pwm_mask testbench. Testbench revealed a flaw in the sva that was corrected.
2026-10-28 Created sva file for pgood_gen.sv. Corrected the rtl to correctly reflect the 9ms pgood activation timer. Hence pmic_full and stats.txt had to be rebuilt consequently. Makefile has been edited to add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
2026-10-29 Wrote pwm_stats testbench. The testbench revealed an oversight in the rtl. The counter never saturates because the possibility of pwm reaching 255 clks when nominal is 111 was never considered, but i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
2026-11-01 docs: start the Silicluster v3 changelog and area log
    The changelog records every change on this branch with a timestamp and an
    undo recipe. The area log is the append-only record the project rules section 7
    asks for, seeded with a measured sky130 baseline of main at 50 MHz:
    730 flops, 2,281 mapped combinational cells, 32,369 um^2 cell area.
    That baseline is materially below the reference in the project rules (~43,000 um^2,
    3,039 cells). 3,039 matches the generic gate count in Build/stat.txt, so the
    reference most likely came from the unmapped netlist. Recorded as a finding.
2026-11-01 sim: write synthesis statistics with tee -o, add area summary script
    The YoWASP build of yosys truncates a redirected stdout, so syn_area's grep
    over area.txt found nothing and the target failed after a successful run.
    Yosys now writes the stat table to its own file with tee -o, which is exact
    with every build. syn_area ends with a one-line summary - flops, mapped
    comb cells, cell area, die area at 57%, ratio to the 180x115 um slot - from
    scripts/area_counts.py. Synthesis commands are unchanged, so are the numbers.
2026-11-01 sim: have yosys write its full log with -l instead of a stdout redirect
    Follow-up to the tee -o change: the YoWASP build's stdout truncation also
    cut the redirected full log, so the Build/stat.txt committed with the clock
    change ended mid-run. yosys -q -l writes the log file itself, complete with
    every build. Build/stat.txt regenerated. Summary numbers unchanged.
2026-11-01 pkg: round minimum-time conversion up so MIN_ON_COUNTS holds at 10 MHz
    ns_to_clks floored. Its only caller asks for a minimum: MIN_ON_COUNTS =
    ns_to_clks(128 ns LM5106 shrinkage + 112 ns wanted at the gate) = 240 ns.
    At 10 MHz that is 2.4 clocks; the floor commanded 200 ns and left 72 ns at
    the gate, below the 112 ns the package documents. The ceiling commands 3
    clocks = 300 ns, 172 ns at the gate.
    No-op at 50 MHz: elaborated both ways, MIN_ON_COUNTS = 12 before and after.
    At 10 MHz 2 -> 3, ON_TIME_W unchanged. Soft start becomes 13 steps.
    Gate as for the clock change: lint and sv2v clean, 6/8 in-tree per flow, the
    two watchdog-limited testbenches pass with a scaled scratch watchdog.
    flop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
2026-11-01 top: add TELEMETRY_EN to select the host interface in or out
    One parameter on pmic_top, default 1. The SPI line synchronisers and
    filters, the enable-switch edge detector, the SPI slave, register file, PWM
    statistics, fault log and timestamp are each wrapped in place in an
    if (TELEMETRY_EN) generate, so the file keeps its section layout; git diff -w
    is +47/-1. With 0, SDIO is released, spi_enable is tied high and every
    reg_file control value is tied to the package constant it resets to, so the
    disabled build behaves like an enabled one the host never writes. Ports,
    FSM and every other module are untouched.
    sv2v keeps the parameter and the generates as Verilog, so one converted
    file carries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
2026-11-01 fix(spi_slave): drive SDIO for the whole read data phase
    Every SPI read returned 0x00. sdio_oe was set at the last falling SCK edge
    of the turnaround byte, cleared one clock later by the release-outside-S_READ
    rule because the state is still S_TURN until the eighth rising edge, and
    never set again in S_READ. Present at 50 MHz as well; spi_slave has no unit
    testbench, so it was never exercised.
    sdio_oe is now decided from the state alone, sdio_oe <= (spi_state ==
    S_READ), and the S_TURN load no longer touches it; the load of tx_shift and
    sdio_out stays, so the first data bit is already on sdio_out when the line
    is taken. The master keeps SDIO for the whole turnaround byte.
    Integration testb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
2026-11-01 fix(spi_slave): increment the write address after the strobe, not with it
    Every SPI write landed one address high. The write delay line raised wr_en
    and stepped addr on the same edge, so reg_file sampled each strobe with the
    next address: SCRATCH writes vanished, a keyed threshold write wrote the key
    value into the first threshold and left the bank locked.
    The increment moves out of the release branch to the clock after the strobe,
    if (wr_en) addr <= addr + 7'd1, so reg_file sees wr_en with the address the
    byte belongs to. A cmd-1 preload that would have kept the old increment was
    rejected: it parks a wrong address in addr for the whole write data phase.
    Integration testbench, 10 and 50 MH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
2026-11-01 tb: scale the pgood_gen and pwm_stats watchdogs with the clock period
    Both watchdogs were a fixed 10 us, which was 500 clocks at 50 MHz. At the
    10 MHz Silicluster clock the same stimulus takes five times as long, so both
    testbenches tripped the watchdog with zero assertion failures - a testbench
    bug exposed by the clock change, not an RTL issue.
    WATCHDOG_NS is now 500.0 * CLK_PERIOD_NS, derived from the testbench's own
    clock period: 10 us at 50 MHz as before, 50 us at 10 MHz. Only those two
    lines change.
    equiv_all 6/8 -> 8/8 in both tables; both also pass against the package at
    50 MHz. No RTL or area change.
2026-11-01 fix(spi_slave): register sdio_oe from the next state so it tracks S_READ exactly
    sdio_oe was registered from the current state, so it trailed spi_state by
    one clock on both edges. On every exit from S_READ - CS deasserted or SCK
    timeout - the slave drove SDIO for one clock after it had itself seen the
    transaction end, onto a bus it already treated as deselected.
    sdio_oe <= (spi_state_next == S_READ) changes on the same edge as the state:
    the slave takes SDIO on the edge it enters S_READ and lets go on the edge it
    leaves. Still a flop, so the tri-state enable stays glitch-free. The first
    data bit is already on sdio_out at the take-over edge, loaded on the last
    falling edge of the turnaround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
2026-11-01 tb: add the Silicluster integration testbench pmic_top_tb.v
    One plain Verilog-2005 module that drives pmic_top through its pins, with
    board models around it: an asynchronous 450 kHz modulator, the SCR latch,
    comparator levels, the enable switch and an SPI master with CRC-8. All
    configuration goes over SPI into the register map; no RTL timer is shortened.
    Every check prints a verdict and is counted; run-long monitors, a supervisor
    FSM reference model and a register-map shadow are compared every clock; 51
    coverage bins, each set only when the DUT is seen reaching the condition,
    fail the run if any is missed. fork/join with disable bounds every wait, and
    the 100 ms clean-run window runs concur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
2026-11-01 sim: run the integration testbench from make, in all three flows
    tb_top, equiv_top and iv_top run tb/pmic_top_tb.v on Verilator against the
    SV source, on Verilator against the converted Verilog, and on Icarus against
    the converted Verilog. tb_all, equiv and equiv_all include it, listed as
    pmic_top_tb with its coverage bins in the covers column.
    scripts/run_top_tb.sh takes the verdict from the testbench's last line and
    writes the record report.sh reads; that is what gives Icarus a non-zero exit
    on FAIL, since vvp exits 0 from $stop. Waivers cover testbench lint only, and
    ENUMVALUE / TIMESCALEMOD for the one flow each applies to.
    equiv_all 9/9 PASS in both tables; iv_top PASS, 51/51 bins.
2026-11-01 top: split the bidirectional SDIO pin into MOSI and MISO
    The Silicluster call offers digital inputs and outputs only, and pmic_top is
    not the chip top, so its 1'bz would become an internal tri-state. Synthesis
    already warned about limited tri-state support, and the old netlist shows the
    cost: yosys kept no tri-state buffer and deleted the sdio_oe enable flop, so
    the chip would have driven SDIO permanently against the host.
    SDIO becomes input MOSI and output MISO. MOSI feeds the same synchroniser and
    filter; MISO = sdio_oe & sdio_out, read data while spi_slave is in S_READ and
    low otherwise, tied low without telemetry. spi_slave keeps its ports and its
    logic; only its comments change. Framin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
2026-11-01 package: regenerate the submission for MOSI/MISO
    The split tree is regenerated from the MOSI/MISO RTL and re-annotated, with
    the pmic_top comments describing MISO and MOSI instead of a shared SDIO line.
    The README's pin table becomes 10 inputs and 11 outputs with no bidirectional
    pin, the SPI description becomes 4-wire with the same framing, and the area
    figures are updated. One package comment that still named SDIO is corrected;
    the converted Verilog is unchanged by it.
    package_check: 17 of 17 files code-identical to sv2v. All testbenches pass
    against the annotated files, and the rebuilt zip passes on Icarus and
    Verilator from an empty directory, warning-free.
2026-11-01 tb: count a PGOOD drop only when PGOOD falls from 1
    Icarus counted the x -> 0 transition at power-on reset as a PGOOD drop,
    Verilator (two-state) never sees it, so the bin counts differed (4 vs 3).
    The monitor now tracks PGOOD's previous level and counts 1 -> 0 only.
    Check lines are unchanged in both simulators; the coverage tables are
    now identical between them, hit counts included. Changelog entry 22.
2026-11-01 tb: TELEMETRY_EN parameter and a pins-only sequence for the reduced build
    The testbench takes the same TELEMETRY_EN parameter as pmic_top and
    passes it down, so one setting selects the build and the test that fits
    it. Probes into the telemetry blocks are built in a generate branch and
    tied to their at-rest values without them. The SPI sequence moved
    unchanged into g_seq_tel; a new g_seq_notel runs a pins-only sequence on
    the default timers and proves the host interface is absent: a valid
    keyed configuration frame leaves the hiccup at 10 ms and the clean-run
    window at 1 s, keyed disables never drop En, MISO never leaves 0.
    Bins for hardware the reduced build lacks are reported n/a.
    Also remo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
2026-11-01 sim: integration testbench targets for TELEMETRY_EN=0; the gate runs both builds
    TOP_TEL (default 1) is passed to the integration testbench as
    -GTELEMETRY_EN / -Ppmic_top_tb.TELEMETRY_EN. New targets tb_top_notel,
    equiv_top_notel, iv_top_notel, top_notel and top_both record under their
    own flow names. equiv_all also runs the reduced build in both Verilator
    flows. make -j4 equiv_all: 9/9 in both tables, pmic_top_tb 31/31 in
    sv_notel and equiv_notel; make iv_top_notel 31/31. Changelog entry 24.
2026-11-01 package: README for both TELEMETRY_EN builds, the fallback and the area method
    Configuration section with both builds, the default thresholds and how
    to use the reduced build if the additional area is not granted; run
    commands and results for TELEMETRY_EN=0; the area section states that
    57% utilisation is an assumption, not from the call or a P&R run, and
    what follows from it. Corrects two leftover 3-wire mentions. The zip is
    rebuilt (package_check 17/17). Changelog entry 25.
2026-11-01 docs: area-log notes on utilisation and the fallback; commit table for entries 20-25
    The area log records that the full build's cell area alone is 1.48x the
    slot (no utilisation makes it fit one slot) and that the reduced build
    needs at least 51% utilisation, and that the reduced build is a verified
    fallback. The changelog commit table lists entries 20-25. Changelog
    entry 26.
2026-11-01 pnr: place and route of both builds, scripts and results
    OpenROAD with sky130_fd_sc_hd checks the fit with a real layout instead
    of an assumed utilisation. The reduced build routes with no DRC
    violations in the 180 x 115 um slot (66%, and 84% with 10 um reserved all
    round) and down to 180 x 90 um; the full build fails at 2x the slot,
    routes at 2.5x (180 x 288 um) and comfortably at 3x (180 x 345 um).
    Timing closes with 94-97 ns of setup slack at 10 MHz.
    Scripts to fetch the platform, synthesise, place and route, report and
    tabulate; per-run results with routed DEFs, reports and pictures. The
    area log and the submission README carry the results. Changelog
    entry 28.
2026-11-01 tb: second pass of the integration testbench; package and testbench move to submissions_full/
    Phases 14-20, run by both sequences: reset while running and mid-SPI
    frame; every fault from every state it can arrive in; the overcurrent
    window's exact threshold; a second strike inside the clean-run window
    (escalation, window restart); UVLO and latch glitches, switch chatter,
    overlapping faults, strikes kept across a fault-off; programmed
    thresholds reaching the protection; SPI corners. Five new run-long
    monitors; coverage 51 -> 86 bins with every fault cause crossed with
    every state. Phases 1-13 unchanged. The testbench now lives in the
    package folder, submission/ becomes submissions_full/. 277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
2026-11-01 package: a trimmed package beside the full one; make trimmed, zip, signoff
    submissions_trimmed/ is submissions_full/ with the TELEMETRY_EN default
    set to 0 in rtl/pmic_top.v and tb/pmic_top_tb.v, two lines and nothing
    else, so the reduced build that fits the standard 180x115 um slot can be
    sent in the same email as the full one. It is generated by `make
    trimmed`; `make package_check` proves both trees code-identical to fresh
    sv2v output and the trimmed tree equal to the full one but for those two
    lines.
    `make zip` writes one zip per package. `make signoff` runs
    package_check, every testbench against the annotated files (equiv
    SPLIT=1), then each package exactly as its README tells a reviewe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
2026-11-01 “rtl: drop the workflow-test line from the trimmed copy”. 7. Check before publishing
2026-11-01 sim: Makefile for main - rtl-systemverilog/rtl-verilog, 50 MHz, full build only
    The Silicluster packaging is gone: no trimmed package, zip or signoff, and
    no TELEMETRY_EN=0 integration runs. TELEMETRY_EN stays a parameter, still
    linted (lint_notel) and synthesised (syn_notel, syn_area_notel).
    Sources move to ../rtl-systemverilog, and the Verilog split lives in
    ../rtl-verilog: split runs sv2v -w adjacent into Build/split_raw,
    verilog_check proves rtl-verilog code-identical to it, and verilog
    regenerates rtl-verilog with its comments kept (transplant_comments.py).
    SPLIT=1 runs the equiv flows on rtl-verilog.
    The integration testbench is ../tb/pmic_top_tb.v, run with CLK_HZ passed
    as TOP_CLK_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
2026-11-01 rtl: move the SystemVerilog source to rtl-systemverilog/
    rtl-systemverilog/ holds the source that is edited and rtl-verilog/ its
    Verilog-2005 split, side by side. Paths that named rtl/ follow: the
    Quartus project's 18 source lines, the synthesis workflow's path filter,
    and the "converted from" line in each rtl-verilog header (comment only).
2026-11-01 sim: split the Makefile into mk/ includes; SPI-less targets; helpers; colour
    sim/Makefile keeps the TESTBENCHES list and includes the rest from mk/:
    config (tools, paths, run modes, colours), sources (file lists, flags),
    tb (module testbenches, suites), top (integration testbench), lint, syn,
    verilog (rtl-verilog and its SPI-less variants) and util. Every target
    main's Makefile had is still here.
    SPI-less build (TELEMETRY_EN=0), all on demand, nothing committed:
    tb_top_notel / equiv_top_notel / iv_top_notel / top_notel / top_both,
    lint_notel, syn_notel, syn_area_notel, convert_notel
    (Build/pmic_full_notel.v), split_notel and verilog_notel (commented
    Verilog in Build/rtl-verilog-notel, prove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
2026-11-01 ci: both-build lint, script check, rtl-verilog sync, SPI-less job, full run
    rtl.yml: the lint job lints both builds (lint_all) and checks the repo's
    scripts (check_scripts; shellcheck is on the runners); the regression job
    runs verilog_check right after the conversion, so a source change pushed
    without `make verilog` fails before any simulation; a new notel job runs
    the SPI-less integration testbench on the source and the converted
    Verilog (make ci_notel).
    full.yml (new): on demand from the Actions tab and weekly on main - make
    ci, top_both with Icarus, synthesis of both builds, and the two Verilog
    bundles uploaded as an artifact.
    setup-hdl gains an iverilog input; synth.yml's path filter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
2026-11-01 docs: COMMANDS.md - every make target, with examples, options and the CI map
    One page at the repository root: the everyday loop, each target family
    with what it does, the SPI-less commands, the rtl-verilog workflow after
    an RTL edit, every option variable with its default, the three CI
    workflows, and where things live.
2026-11-01 docs: README digital section brought up to date, marked work in progress
    The section described the early CPLD supervisor (one Verilog-2001 FSM,
    I2C, 20 checks, synchronisers "not yet implemented"). It now describes
    what exists: the 17 modules by group, the current pins (SPI instead of
    I2C, OVP inferred from the latch read-back), the state machine as built,
    and verification so far - 8 unit testbenches with SVA, the integration
    testbench, the converted-Verilog runs, a pre-P&R area estimate. A status
    note and the "Still open" list say plainly it is not finished: unit
    testbenches for 8 modules, the known issues, board-level checks, place
    and route, hardware bring-up.
    The repository map, tools l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
2026-11-01 sim: parallel Verilator compiles; announce the long integration run
    Verilator's internal make was started from a script inside make's
    recipe, could not reach the jobserver ("jobserver unavailable: using
    -j1") and compiled every C++ file serially - over a minute for
    pmic_top_tb alone, during which `make -j8 tb_all` printed nothing and
    looked hung. The run scripts now start Verilator without the parent's
    MAKEFLAGS and pass --build-jobs $(VJOBS) (default: all cores). With
    ccache disabled pmic_top_tb builds and runs in 75 s on 4 cores, against
    about 100 s before.
    run_top_tb.sh also prints a [RUNNING] line straight to the terminal when
    the integration testbench starts in QUIET mode, bypassing --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
2026-11-01 rtl: comments that still described the 10 MHz Silicluster build
    rtl-verilog/ was annotated for the 10 MHz build and `make verilog` keeps
    comments as they are, so the code was 50 MHz while 15 comment lines
    still gave 10 MHz figures. Now: the package notes copied into each
    module (CLKS_PER_SW, SPI_FILTER_CLKS, CYCLES_PER_STEP_DEFAULT,
    MIN_ON_COUNTS) match the package text exactly, and the clk pin, the SPI
    filter paragraph and ARM_TIMEOUT_W use the SystemVerilog source's
    50 MHz wording. In the package itself the MIN_ON_COUNTS note said
    "3 clocks (300 ns) at 10 MHz"; at 50 MHz it is 12 clocks (240 ns),
    about 10.8% duty. Comments only: make verilog_check 17/17 and
    Build/pmic_full.v unchanged. The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
2026-11-01 sim: make verilog flags only clocks that differ from the package's
    transplant_comments.py listed every comment naming any frequency, so
    correct 50 MHz lines, 450 kHz and a 4 Hz blink drowned the stale ones.
    With --clk-mhz N it lists only comments naming an MHz value other than
    N; make verilog passes the package's CLK_HZ. Without the option the
    script behaves as before.
2026-11-01 Added hiccup timer testbench
2026-11-01 The latch test is now >= instead of ==. If the host lowers MAX_STRIKES below the current count, the very next hiccup now trips the latch. Before, the 2-bit count wrapped and the latch came up to four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
2026-11-01 sim: clearer testbench output - cover table, summary card, suite table
    Single runs now hide Verilator's build output unless the build fails,
    colour the simulation output as it streams and fold repeats of one
    failing assertion, print every cover with its full condition, hit count
    and a log-scale activity bar, and end with a summary card: verdict and
    why, assertions armed and failed, procedural checks, covers hit,
    simulated time and log paths. Suites print badge-style status lines and
    a per-flow table with coverage bars and a pass/fail banner.
    Shared helpers in scripts/ui.sh; cover parsing in scripts/covers.sh
    (multi-line properties joined, CRLF checkers handled, mawk compatible).
    cov_<m> pri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
2026-11-03 fault_arbiter: gate each window trip by its own state
    window_trip_SS was a bare comparison of the soft-start count, and that
    count is not cleared on the S_SS -> S_RUN transition. A faulted sample on
    the very edge the FSM left S_SS (or TRIP_SS lowered during S_RUN) held
    window_trip_SS high for the whole run; the supervisor ignores it there,
    but fault_cause logged an overcurrent that never happened. Found by
    fault_arbiter_tb group 6 (a_trip_ss_confined).
    RTL: window_trip = run_active && ..., window_trip_SS = ss_active && ...
    Counts unchanged - the soft-start count still holds through S_RUN for
    telemetry. Header restored (a line was cut) and states the gate.
    rtl-verilog/protect/fault_arbiter.v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
2026-11-03 tb: template prints the machine-readable tally line
    New testbenches copied from the template print the same tally line as
    fault_arbiter_tb, so run_tb.sh's summary card reads their checks however
    the human-readable banner is worded. Existing testbenches keep the
    classic banner, which run_tb.sh still reads as the fallback.
2026-11-03 tb: every testbench prints the machine-readable tally line
    All module testbenches and pmic_top_tb.v now end with the same
    "tally: checks_run=... checks_failed=... sva_failures=... exit=..." line
    as fault_arbiter_tb and the template, so the summary card reads their
    results from it and no longer depends on the wording of the banner.
2026-11-04 spi_slave: a truncated command byte is always a write error
    rw was written only when a command byte completed, and cs_fall did not
    clear it. A transaction whose command byte was cut short was therefore
    classified by the PREVIOUS transaction: txn_abort (and the bus-error
    count) fired only if that one had been a write. rw is now cleared on
    cs_fall, so every truncated command - a CS blip through the filter, lost
    SCK edges - is a short write and pulses txn_abort, whatever came before.
    Nothing can commit either way; only the counting changes.
    Comments: S_DEAD is entered only on an SCK timeout (an illegal length
    is judged at cs_rise and never reaches it); BLOCK 9 states that a
    timed-out read, lik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
2026-11-04 spi_slave checker: assert that a truncated command always aborts
    Group 9 covered CS rising before the command byte completes but asserted
    nothing, because the outcome depended on the previous transaction. With
    spi_slave now clearing rw on cs_fall the claim is decided:
    a_truncated_command_aborts requires txn_abort on the clock after such a
    CS rise. chk_last_was_read records the direction of the last completed
    command, so two new covers show the case after a read (the regression
    scenario: the old RTL dropped it) and after a write.
    Checked with a scratch driver (read, then 3 command bits and CS high):
    the pre-fix RTL fails exactly this assertion; the fixed RTL passes with
    no failures anywhere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
2026-11-06 reg_file: carry the SCRATCH staging fix into rtl-verilog and Build
    The previous commit staged SCRATCH writes in scratch_temp / scratch_pending
    and committed them on integrity_OK, so a bad-CRC write no longer changes
    the register (found by cocotb test_host_if). make verilog refuses
    structural changes, so rtl-verilog/telemetry/reg_file.v is merged by hand
    with the source's comments carried over; Build/pmic_full.v reconverted.
    No RTL change in this commit.
    Checks: verilog_check 17/17; make ci 15/15 on source and converted
    Verilog; equiv SPLIT=1 15/15; ci_notel pass; cocotb test_host_if 5/5 on
    the SystemVerilog and on Build/pmic_full.v.
2026-11-08 host_if: rename MAKEFILE to Makefile
    make looks for Makefile, makefile or GNUmakefile. The file was tracked as
    MAKEFILE and only worked while the checkout was case-insensitive; in a
    case-sensitive folder (a WSL-created one) plain 'make' found nothing.
2026-11-08 host_if: professional comments and headers, cov_all evidence, readable coverage reports; spi_slave checker fix
    Checker (sva/telemetry/spi_slave_sva.sv): the suite as pushed failed in
    broken_frames_through_model - 'SCK stall in a read's command' tripped
    a_read_never_resolved. The slave timed out before the command byte
    completed, so it never learned the frame was a read and correctly
    aborted (V9 rule; the model predicts the same), but the checker rebuilt
    the command from the pins, which show a whole read once the host resumes.
    New aux chk_dead_before_cmd / chk_cmd_accepted: a command counts only if
    it completed while the slave was alive. a_read_never_resolved and
    a_truncated_command_aborts us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
2026-11-08 host_if: fix two functional-coverage bugs; soak keeps each run's covergroups
    - apply_frame returned 'truncated cmd' but the bin is 'truncated_cmd', so
    host_if.frame.ending could never cover it.
    - random_write sampled clamp regions BEFORE apply_write, i.e. the previous
    write's; now sampled after. apply_frame clears committed_regions first,
    so a broken frame that commits nothing cannot re-sample stale regions,
    and a broken write that does commit is sampled too.
    - make soak passes FCOV_XML, so every run's covergroups are exported to
    soak/raw/fcov_runN.xml for merging.
    Checked: make quick passes.
2026-11-08 sim: run the cocotb host-interface suite from the outer Makefile, both flows
    make tb_host_if / equiv_host_if run tb/telemetry/host_if's whole suite
    (directed tests + random_walk at HOSTIF_EVENTS=400) on the SystemVerilog
    source and on the sv2v output (SPLIT=1: rtl-verilog). It is listed as
    host_if_tb in tb_all, equiv and equiv_all, so CI runs it, and reports like
    the module testbenches: verdict from cocotb's results, SVA failures, the
    bound checkers' covers, a cover table and summary card. Its covergroups
    get a magenta 'covergroups' line under each result table.
    - scripts/run_cocotb.sh: runs the suite's Makefile with -f from a
    per-flow build directory, so flows never share sim_build or re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
2026-11-08 pmic_top: cocotb whole-supervisor testbench and top-level checker
    Top-level verification in the same structure as host_if:
    - sva/top/pmic_top_sva.sv, bound to pmic_top: the wiring claims only the
    top can make (all I): reset safe; En only in S_SS/S_RUN and only with
    switch + host enable and no OTP/UVLO/latch read-back/latch_out; gate PWM
    only when the modulator asked; PGOOD only in S_RUN; switch_supply ==
    PGOOD; MISO silent without telemetry. 14 covers. Every assertion proven
    able to fail (each inverted, each reported under its own label).
    - tb/top/pmic_top: pmic_top_harness.sv (DUT + board model in SV: 50 MHz
    clock, 450 kHz modulator, valley comparator, SCR latch, reset button,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
2026-11-09 pgood_gen_sva: hold the saturation check to the edge the RTL acts on
    a_qualify_counter_saturates guarded its consequent with pgood_comp and
    run_active, read one clock after the edge whose sampled inputs clear the
    counter. A rail drop-out of exactly one clock - cleared on edge N, rail
    good again by N+1 - was reported as a wrap. The condition moves into the
    antecedent. pgood_gen_tb gains the one-clock drop-out (group 9); the old
    property fires on it, the new one fires when inverted. Found by the
    whole-supervisor suite.
2026-11-09 pmic_top: design-intent edge cases, random walk and covergroups
    Harness: the valley comparator reports while the low-side FET conducts
    (En high, PWM_out low); oc_per16 faults the first N of every 16 cycles.
    Model: keeps simulation time - each enabling input is effective after its
    own debounce, the ramp follows the last - so PGOOD and the clean-run clear
    are predicted, with a 0.5 ms band left unchecked; live MAX_STRIKES.
    Eleven edge-case tests: window thresholds to the cycle in S_RUN and S_SS,
    an overcurrent seen inside pwm_mask's cut, hiccup back-off timing, strikes
    that survive stops, MAX_STRIKES lowered live, faults during a cool-down,
    sub-debounce glitches, a stalled modulator, reset mi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
2026-11-09 MAX_ON: document that a value written in S_RUN reaches the gate at the next soft start
    reg_file commits MAX_ON at once, but soft_start copies the limit into the
    gate ceiling only while ramping, so a value written in S_RUN takes effect
    at the next soft start. This is deliberate - the ceiling only moves
    through a ramp - and safe, since the held ceiling passed the same
    downward-only clamp. Comments only in reg_file and soft_start, carried
    into rtl-verilog. max_on_lowered_while_running now pins both halves
    instead of being marked expected-fail.
2026-11-09 reg_file: refuse only a CHANGE to an S_OFF-only register outside S_OFF
    The write key lasts one transaction and addresses only count up, so
    firmware reaches a threshold by writing the bank back from 0x4F, as read.
    A running converter refused any such frame that passed through
    hiccup_base, cycles_per_step or clean_run_target, even with their own
    values, leaving only the four live thresholds writable.
    off_change compares each written S_OFF-only register's raw (pre-clamp)
    staged value with the live one; only a difference is refused outside
    S_OFF. Readback is post-clamp, so a value read back always passes; a raw
    value that would merely clamp to the live one still counts as a change.
    The partial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
2026-11-10 pmic_top: model two documented behaviours the first soak exposed; soaks judge runs by results.xml
    The first pmic_top soak (30 x 150) recorded 21 failing runs as PASS:
    cocotb 1.x exits 0 when a test fails, and the soak, random_seeds and
    cov_all targets of both suites trusted make's exit status. A run now
    passes only if a fresh results.xml holds a test and no failure.
    All 21 failures were the supervisor model, not the RTL:
    - a glitch during an input's own debounce (typically the switch's 20 ms
    after a reset) restarts the count; the model now moves the transition
    to a full debounce after the glitch;
    - a debounced switch turn-on re-enables the host enable, cancelling a
    host disable (reg_f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
2026-11-10 pmic_top soak: one seed per core, pmic_top_sva-only build
    Measured on one test: with every block checker bound the simulation runs
    1.4 ms per second, with pmic_top_sva alone 13 ms per second - the 19 block
    checkers are ~90 % of the cost. The soak now builds with pmic_top_sva only
    by default (SOAK_CHECKERS=all keeps every checker) and runs SOAK_JOBS seeds
    at once, default every core, each in its own folder through soak_run.sh
    with seed = start time + run number. Every other target, the CI flow and
    make replay keep the full checker set.
2026-11-10 host_if: record the 40,000-event soak on the current RTL, with an independent audit
    200 runs x 200 events, every run complete; covergroups 83/83, including
    889 write-backs through the S_OFF-only registers while running (all
    accepted) and 735 refused for changing one. SVA: spi_slave_sva 28/28,
    reg_file_sva 26/28 - the two directed-only covers, hit by cov_all, which
    is regenerated on the current RTL (28/28 and 28/28).
    audit_soak.py (make audit_soak) checks every transition of the log
    against the register-map rules without the model: thresholds recomputed
    from each frame's bytes, the enable path, the watchdog, bus errors, and
    what may move on which event. No anomalies in 39,800 transitions; sh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
2026-11-10 host_if: closed - all 200 soak runs passed their final checks
    The run logs confirm what the transaction log could not: every run ends
    FAIL=0 and none printed an SVA failure.
2026-11-11 pmic_top: say which event is being applied, and the model's timing on a mismatch
    random_walk logs each event before applying it, so a failing event is
    named in the log; a board mismatch now carries the model's timing state
    (input ready times, pending switch rise, RUN entry, knobs). For the two
    soak failures (runs 41 and 58), which a fresh 40-seed hunt does not
    reproduce.
2026-11-11 pmic_top: record the 64-run soak; fix the two model timing gaps it found; audit_soak
    64 runs x 200 events with every checker: 62 passed, covergroups 112/112,
    pmic_top_sva 13/14 (c_pwm_truncated is directed-only). The two failures,
    replayed with the model's timing printed, were the model's:
    - run 41: a check ending 20 us after the switch's debounced edge. The DUT's
    STATUS byte is sampled during the SPI read, before the edge; the model
    judged it at the end of the check. The switch bit and the host enable
    are now unchecked within 0.5 ms of that edge.
    - run 58: a switch blip starting before the switch's debounced rise. The
    DUT restarted the debounce, so the rise and its host re-enable n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
